e1aco/ELACO_StepMotorTMC5160/README.md

电机型号：[57CME13步进电机*闭环步进电机*雷赛商城](https://www.leisaishop.com/product/productinfo_id=44.html)
驱动器参数：[CL1-507闭环步进驱动器_闭环步进驱动器_雷赛商城](https://www.leisaishop.com/product/productinfo_id=18.html)
# 当前状态：
## 目前存在的一些问题
1. freemodbus没有测试
2. 这版的PCB设计散热没做好
3. 增加NTC，避免mos管和芯片过热
4. 添加电机一直卡死在运行阶段的超时机制（时间可以根据速度计算一下或者怎么样的，这样更好）
5. 电机发热问题，不确定是正常的还是驱动有问题导致的
6. 驱动芯片发烫
7. 相对位置微步运动发现不转动。30微步。
## 已解决的问题
1. 修改BOM，修改采样电阻为0.05R / 1W电阻(✅bom已修改)
2. CE3电容的PCB封装有点问题，正负极反了(✅封装已修改)
3. Q2和Q4在不接芯片和门极电路的情况下自己导通然后烧掉了，大概率是我把mos的栅极悬空的原因。(✅焊接栅极电阻)
## 实时状态
### 2026.07.18
- [ ] 测试电机闭环旋转
- [ ] CAN接收到并且电机旋转，但没有CAN发送
### 2026.07.17
- [x] 尝试调小电机驱动电流测试电机和芯片是否发烫--电机电流已调小，待测试
### 2026.07.16
- [x] 根据协议测试相关内容
### 2026.07.15
- [x] 手写一个CAN协议，确定控制方法
### 2026.07.13
- [x] 测试芯片接收编码器信号是否正常
- [x] 测试电机使用位置模式转动多圈后保持的位置偏差是否在可接受范围内
- [x] 测试驱动器IC在其BM引脚到地没有出现低于-5V的峰值，避免烧芯片。（电机正反转下测试）如果超过了要添加对地的TVS二极管保护 -- 未发现有特别低或高的电压峰值
### 2026.07.10
- [x] 测试编码器数据是否正常
### 2026.07.09
- [x] 修改采样电阻为0.05R / 1W电阻，然后开启速度模式，测试电机转动 -- 上班时间最后一刻上电发现电机转动了。
### 2026.07.08
- [x] 修改CE3电容的PCB封装
- [x] 查看example内的文件内容(关于tmc5160的)
- [x] 对TMC5160的SPI进行配置和通讯 -- 实现SPI的读写
- [x] 测试TMC_CLK脚的PWM输出是否是14Mhz的（芯片手册要求是10-16Mhz的方波）-- 84Mhz,psc=0,arr=5 14Mhz刚好
### 2026.07.07
- [x] 移植freemodbus
  配置一个串口（开启串口中断），配置一个定时器（开启定时器中断）
  移植freemodbus的文件入项目
  分别修改port.c，portserial.c和porttimer.c文件内容
- [x] 增加freemodbus移植内容以及测试函数。（测试函数也可以作为一个example来看）
- [x] 做了移植，但还未测试
- [x] 对CAN进行了测试
### 2026.07.06
- [x] 焊接硬件
## 设置CAN协议

### 1. 接收命令协议 (CAN ID: `0x1AA55F42`)

| 字节索引 | 含义 | 说明 |
|:---|:-----|:-----|
| [0-3] | 值 (int32) | 4字节小端（低字节在前），含义由命令码决定 |
| [4] | 命令码 | 见下方命令码表 |
| [5] | 电机选择 | 0x01=U1, 0x02=U2, 0x06=所有电机 |
| [6] | 参数/分组 | 0x01~0x04=运动参数组（命令0x01~0x05），0x01~0x06=PID参数类型（命令0x06） |
| [7] | 校验和 | 前7字节累加取低8位 |

#### 命令码定义

| 命令码 | 名称 | [0-3] 含义 | [6] 含义 |
|:---:|:-----|:---|:---|
| 0x01 | 绝对位置移动 | 目标位置（微步） | 运动参数组 (0x01~0x04) |
| 0x02 | 相对位置正转 | 移动步数 | 运动参数组 (0x01~0x04) |
| 0x03 | 相对位置反转 | 移动步数 | 运动参数组 (0x01~0x04) |
| 0x04 | 速度模式 | 目标速度（微步/秒） | 运动参数组 (0x01~0x04) |
| 0x05 | 停止/刹车 | 0（忽略） | 运动参数组 (0x01~0x04) |
| 0x06 | PID调参 | 参数值（Q16或整数） | PID参数类型 (0x01~0x06) |

#### 运动参数组定义 (命令 0x01~0x05 使用)

| 参数组 | 说明 | VMAX | AMAX | 典型场景 |
|:---:|:-----|-----:|-----:|:---|
| 0x01 | 低速精准 | 5,000 | 1,000 | 精准定位 |
| 0x02 | 中速普通 | 20,000 | 5,000 | 日常运动 |
| 0x03 | 快速 | 50,000 | 10,000 | 快速移动 |
| 0x04 | 高速 | 100,000 | 20,000 | 长距离搬运 |

#### PID参数类型定义 (命令 0x06 使用)

| 参数类型 | 含义 | 值格式 | 默认值 |
|:---:|:-----|:---|---:|
| 0x01 | Kp（比例系数） | Q16定点数 | 8192 (0.5) |
| 0x02 | Ki（积分系数） | Q16定点数 | 2048 (0.125) |
| 0x03 | Kd（微分系数） | Q16定点数 | 4096 (0.25) |
| 0x04 | out_max（最大输出速度） | 直接整数 | 50000 |
| 0x05 | out_min（最小输出速度） | 直接整数 | -50000 |
| 0x06 | integral_max（积分限幅） | 直接整数 | 32768 |

> **Q16定点数**：实际值 = Q16值 / 65536。例如 Kp=0.5 → Q16值 = 0.5 × 65536 = 8192。

### 2. 反馈响应协议 (CAN ID: `0x1AA55F43`)

| 字节索引 | 含义 | 说明 |
|:---|:-----|:-----|
| [0-3] | 值 (int32) | 4字节小端，含义由 byte[6] 决定 |
| [4] | 标志/参数类型 | 运动反馈=状态标志位，调参反馈=参数类型 |
| [5] | 电机选择 | 0x01=U1, 0x02=U2 |
| [6] | 反馈类型 | 0x01~0x05=运动反馈，0x06=调参反馈 |
| [7] | 校验和 | 前7字节累加取低8位 |

#### 运动反馈 (byte[6] = 0x01~0x05)

| 字节索引 | 含义 | 说明 |
|:---|:-----|:-----|
| [0-3] | 位置值 (int32) | 当前电机 XACTUAL 绝对位置 |
| [4] | 状态标志位 | bit0=到位, bit1=堵转, bit2=过温, bit3=驱动错误, bit4=SPI异常 |
| [5] | 电机选择 | |
| [6] | 运动阶段 | bit0=加速, bit1=匀速, bit2=减速, bit3=归零等待, bit4=静止锁轴 |
| [7] | 校验和 | |

**状态标志位 (byte[4]) 详解：**
```
bit0 → 0=运动中，1=已到位
bit1 → 0=正常，1=堵转/失步
bit2 → 0=正常，1=过温告警
bit3 → 0=正常，1=驱动错误
bit4 → 0=SPI正常，1=SPI通讯异常
bit5-7 → 保留
```

#### 调参反馈 (byte[6] = 0x06)

| 字节索引 | 含义 | 说明 |
|:---|:-----|:-----|
| [0-3] | 参数值 (int32) | 刚设置的参数值 |
| [4] | 参数类型 | 0x01=Kp, 0x02=Ki, 0x03=Kd, 0x04=out_max, 0x05=out_min, 0x06=integral_max |
| [5] | 电机选择 | |
| [6] | 固定 0x06 | 标识为调参反馈 |
| [7] | 校验和 | |

#### 反馈发送规则

| 命令码 | 发送时机 |
|:---:|:---|
| 0x01/0x02/0x03 | 立即发送启动反馈 + 到位后发送到位反馈 |
| 0x04/0x05 | 仅立即发送一次 |
| 0x06 | 立即发送调参确认反馈 |
| 异常 | 堵转/过温/驱动错误/SPI异常状态变化时，5ms定时器触发发送 |
## 软件流程图

# 理论部分
## 1.关于原理图设计
1. **一般我们会设计VSA与VS电源由一路供电,这样是最安全的**，但是如果VS的电源超过了24V就不建议一路供电了，这时VSA应该使用单独的开关电源转换过来的电压进行供电，并且要保证在电机运行期间VSA不会跌落，正常如果要断VSA的电前应该先关断电机驱动(DRV_ENN脚拉高)。
2. 如果电机的输入电压允许12V的话，或者电机运行电压非常大的话，建议**使用DCDC转换为12V给VSA和12VOUT供电**（这时12VOUT内部的LDO可以直接不工作，进而会减少功率的损耗以及发热问题）
3. MOS管的选型上
	1. 将MOSFET调整到所需的电机电压(在峰值电源电压上增加5-10V的余量)和所需的最大电流，使得电阻功耗对于所选MOSFET封装的热容量仍然很低。
	2. 管子Vth选择10V内的（主要因为芯片驱动电压在10V左右）
	3. 对于选型好mos以后栅极电阻的选择，根据米勒电荷对阻值进行选择（同时还要考虑软件上的驱动电流设置DRVSTRENGTH）
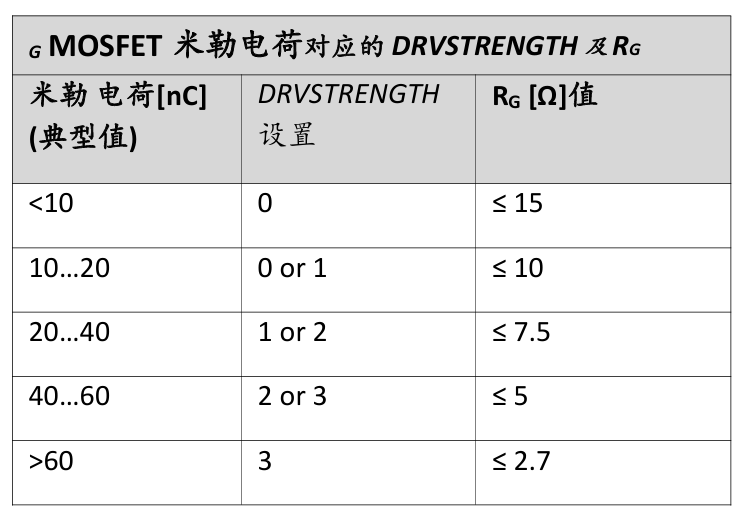
[picture p1: Picture/mos1.png]
MOS管选型参考
	
	
	MOS管驱动电路
	4. 对于驱动电阻，如果驱动电阻的电阻超过表中给出的值时可以增加一个反向二极管（负极对驱动芯片）以增加开关速度。
	那么根据以上条件，我的mos选择AOD4126的米勒电荷是10nC(VGS=10V, VDS=50V, ID=20A),那么我的栅极电阻选择就是10R左右，驱动电流设置就是0/1。（此外我还加入了4148，以求更快的开关速度）
4. 为避免驱动器IC在其BM引脚到地会出现低于-5V的峰值，建议添加一个TVS二极管保护。
## 2.关于PCB布线
1. 将采样电阻和所有滤波电容尽可能靠近功率MOSFET。TMC5160靠近MOSFET放置，短线互连，以最小化寄生电感。
2. 将所有的GND、GNDA、GNDD及采样电阻GND连成一个公共地。
3. 5VOUT滤波电容直接连到5VOUT和GNDA引脚。
4. 需要做好对于芯片TMC5160的散热处理，特别是在MOSFET栅极电荷高、斩波器频率高或系统时钟频率大于12MHz的情况下，内部的LDO功耗较大。
5. 做好芯片的散热，使用内部LDO，损耗功率蛮高的。
6. 调整电桥布局，使环路电感最小。布局最好紧凑。
7. MOSFET 栅极连接短而直，走线较宽。
8. 输出电容采用470PF至几个NF。（103 102）
## 3.软硬件已定配置
- 驱动芯片TMC5160
- 采样电阻使用0.05R
- 驱动芯片CLK脚配置14Mhz的方波
- Mos管使用AOD4126
- 步进电机型号57CME13
## 4.寄存器相关
除了有说明的寄存器外，其他的上电后都会重置为0

### SPI通信协议
- **数据帧**: 40位(5字节)，由CS片选信号定界
- **写命令**: Byte0 bit7=1 + 7位地址 + Byte1-4为32位数据
- **读命令**: Byte0 bit7=0 + 7位地址，需要两报通信
  - 第一报: 发送读命令，接收上一次通信数据(丢弃)
  - 第二报: 再次发送读命令，接收本次请求的寄存器数据
- **SPI模式**: CPOL=1, CPHA=1 (模式3)

### TMC5160芯片模式选择
| 模式  | SD_MODE | SPI_MODE | 运行状态 |
| :-- | :--- | :--- | :--- |
| 1 | 0 | 1 | 位置式步进(SPI完全控制) |
| 2 | 1 | 1 | S斜坡运动步进+方向控制 |
| 3 | 1 | 0 | 简单步进+方向控制 |

### 通用配置寄存器 (0x00-0x0C)

#### GCONF (0x00) - 全局配置寄存器
| 位 | 名称 | 说明 |
| :-- | :--- | :--- |
| 0 | recalibrate | 非需要(SPI模式不用,禁用驱动器时过零重新校准) |
| 1 | faststandstill | 非需要(SPI模式不用,静止检测超时设置) |
| 2 | en_pwm_mode | 0= StealthChop禁用, 1= StealthChop自动模式(需满足TPWMTHRS条件) **在静音，静步应用场景下使用** |
| 3 | multistep_filt | 非需要(SPI模式不用,STEP输入滤波器) |
| 4 | shaft | 0= 正向, 1= 反向(影响位置/速度方向) **电机运行方向（包括位置模式和速度模式）** |
| 5 | diag0_error | 0= DIAG0无动作, 1= DIAG0输出驱动错误信号(SD_MODE=1) |
| 6 | diag0_otpw | 非需要 0= DIAG0无动作, 1= DIAG0输出过温预警信号(SD_MODE=1) |
| 7 | diag0_stall/diag0_step | 0= DIAG0无动作, 1= DIAG0输出堵转信号(SD_MODE=1) |
| 8 | diag1_stall/diag1_dir  | 0= DIAG1无动作, 1= DIAG1输出堵转信号(SD_MODE=1) |
| 9 | diag1_index | 非需要(SPI模式不用,SD_MODE=1时索引位置输出) |
| 10  | diag1_onstate | 非需要(SPI模式不用,SD_MODE=1时斩波器导通指示) |
| 11  | diag1_steps_skipped | 非需要(SPI模式不用,SD_MODE=1时DcStep失步指示) |
| 12  | diag0_int_pushpull | 0= SWN_DIAG0集电极开路输出(低电平有效), 1= 推挽输出(高电平有效) |
| 13  | diag1_poscomp_pushpull | 0= SWP_DIAG1集电极开路输出(低电平有效), 1= 推挽输出(高电平有效) |
| 14  | small_hysteresis | 0= 步进频率比较磁滞是1/16, 1= 步进频率比较磁滞是1/32 |
| 15  | stop_enable | 非需要(SPI模式不用,紧急停止功能) |
| 16  | direct_mode | 0= 常规模式, 1= 直接模式(MOSFET可独立控制) |
| 17  | test_mode | 非需要(测试模式,正常操作设为0) |

#### GSTAT (0x01) - 全局状态寄存器
| 位 | 名称 | 说明 |
| :-- | :--- | :--- |
| 0 | reset | 0= 无复位, 1= 复位发生(写1清除) |
| 1 | drv_err | 0= 无驱动错误, 1= 驱动错误(写1清除)  |
| 2 | uv_cp | 0= 电荷泵正常, 1= 电荷泵欠压(写1清除) |

#### IFCNT (0x02) - SPI接口计数器
| 位 | 名称 | 说明 |
|:---|:-----|:-----|
| 7:0 | ifcnt | SPI通信次数计数器(8位), 每次成功SPI传输后递增 |

#### SLAVECONF (0x03) - 从机配置寄存器
| 位 | 名称 | 说明 |
|:---|:-----|:-----|
| 0 | slaveaddr | 从机地址位0(非需要,单机SPI不用) |
| 1 | slaveaddr | 从机地址位1(非需要,单机SPI不用) |
| 4:2 | reserved | 保留 |
| 7:5 | reserved | 保留 |

#### IOIN (0x04) - IO输入寄存器 (只读)
| 位 | 名称 | 说明 |
|:---|:-----|:-----|
| 0 | REFL_STEP | 读取REFL/STEP引脚输入状态 |
| 1 | REFR_DIR | 读取REFR/DIR引脚输入状态 |
| 2 | ENCB_DCEN_CFG4 | 读取ENCB_DCEN_CFG4引脚输入状态 |
| 3 | ENCA_DCIN_CFG5 | 读取ENCA_DCIN_CFG5引脚输入状态 |
| 4 | DRV_ENN | 读取DRV_ENN引脚输入状态 |
| 5 | ENC_N_DCO_CFG6 | 读取ENC_N_DCO_CFG6引脚输入状态 |
| 6 | SD_MODE | 读取SD_MODE引脚状态(1=外部STEP/DIR输入源) |
| 7 | SWCOMP_IN | 读取SWN和SWP的电压差(用于测试比较器) |
| 31:24 | VERSION | 芯片版本号(0x30=第一版IC,相同数字表示全数字兼容) |

#### X_COMPARE (0x05) - 位置比较寄存器
| 位 | 名称 | 说明 |
|:---|:-----|:-----|
| 31:0 | x_compare | 位置比较值(32位有符号), 当XACTUAL=X_COMPARE时触发脉冲 |

#### OTP_PROG (0x06) - OTP编程寄存器
| 位 | 名称 | 说明 |
| :-- | :--- | :--- |
| 1:0 | otpbit | 非需要(OTP编程专用,慎用) |
| 5:2 | otpbyte | 非需要(OTP编程专用,慎用) |
| 7:6 | optpgmcmd | 非需要(OTP编程专用,慎用) |

#### OTP_READ (0x07) - OTP读取寄存器 (只读)
| 位 | 名称 | 说明 |
|:---|:-----|:-----|
| 0 | otp_config_bit0 | 非需要(OTP配置位) |
| 1 | otp_config_bit1 | 非需要(OTP配置位) |
| 2 | otp_config_bit2 | 非需要(OTP配置位) |
| 3 | otp_config_bit3 | 非需要(OTP配置位) |
| 4 | otp_config_bit4 | 非需要(OTP配置位) |
| 5 | otp_config_bit5 | 非需要(OTP配置位) |
| 6 | otp_config_bit6 | 非需要(OTP配置位) |
| 7 | otp_config_bit7 | 非需要(OTP配置位) |

#### FACTORY_CONF (0x08) - 工厂配置寄存器
| 位 | 名称 | 说明 |
|:---|:-----|:-----|
| 2:0 | offset_rcomp | 非需要(工厂校准用) |
| 7:3 | reserved | 保留 |

#### SHORT_CONF (0x09) - 短路保护配置寄存器
| 位 | 名称 | 说明 |
| :---- | :--- | :--- |
| 3:0 | S2VS_LEVEL  | 低端MOSFET对VS的短路电平(4=最高灵敏度, 15=最低灵敏度, 复位缺省值=OTP 6或12)  |
| 7:4 | S2G_LEVEL | 高端MOSFET对GND的短路电平(2=最高灵敏度, 15=最低灵敏度, 复位缺省值=OTP 6或12) |
| 9:8 | SHORTFILTER | 短路检测尖峰滤波带宽(0=100ns, 1=1µs, 2=2µs, 3=3µs, 复位缺省值=%01)  |
| 10 | reserved | 保留 |
| 11 | shortdelay  | 短路检测延迟(0=750ns正常, 1=1500ns高, 复位缺省值=0) |
| 17:12 | reserved | 保留 |
| 23 | s2vs | 0= 短路到VS检测使能, 1= 短路到VS检测禁用 |
| 24 | s2gw | 非需要(硬件保护使能,一般不用修改) |
| 25 | s2vsw | 非需要(硬件保护使能,一般不用修改) |

#### DRV_CONF (0x0A) - 驱动配置寄存器
| 位 | 名称 | 说明 |
| :---- | :--- | :--- |
| 4:0 | BBMTIME | 导通前的关断延时(0=最短100ns, 16=200ns, 24=最长375ns, 复位缺省值=0) |
| 7:5 | reserved | 保留 |
| 11:8  | BBMCLKS | 数字BBM时间(以时钟周期为单位, 典型值83ns), 设定更长时间(BBMTIME vs BBMCLKS, 复位缺省值=OTP 4或2) |
| 13:12 | reserved | 保留 |
| 15:14 | OTSELECT | 过温级别选择(00=150°C, 01=143°C, 10=136°C, 11=120°C, 复位缺省值=%00) |
| 17:16 | reserved | 保留 |
| 19:18 | DRVSTRENGTH | 栅极驱动器电流选择(00=弱, 01=弱+TC, 10=中等, 11=强, 复位缺省值=%10) |
| 21:20 | FILT_ISENSE | 采样运放滤波时间常数(00=100ns, 01=200ns, 10=300ns, 11=400ns, 复位缺省值=%00) |

#### GLOBAL_SCALER (0x0B) - 全局缩放器寄存器
| 位 | 名称 | 说明 |
| :--- | :--- | :--- |
| 7:0  | global_scaler | 非需要(用于高级电流调节,一般不用) |
| 31:8 | reserved | 保留 |

#### OFFSET_READ (0x0C) - 偏移读取寄存器 (只读)
| 位 | 名称 | 说明 |
|:---|:-----|:-----|
| 31:0 | offset_read | 非需要(工厂校准用) |

### 速度控制寄存器 (0x10-0x15)

#### IHOLD_IRUN (0x10) - 保持电流/运行电流寄存器
| 位 | 名称 | 说明 |
| :---- | :--- | :--- |
| 4:0 | ihold | 保持电流(0-31), ihold/irun为保持电流比例 |
| 7:5 | reserved | 保留 |
| 12:8  | irun | 运行电流(0-31), 决定电机满载电流 |
| 15:13 | reserved | 保留 |
| 19:16 | iholddelay | 保持电流延迟(0-15), 停止后降为保持电流的延迟时间  |
| 31:20 | reserved | 保留 |

**说明**: 保持电流 = ihold × 电流比例, 运行电流 = irun × 电流比例
-  I_full = 0.325V / (32 × 0.05Ω) ≈ 203mA （本次项目反馈电阻值是0.05R）
- 保持电流 = 6/31 × 203mA ≈ 35mA
- 运行电流 = 16/31 × 203mA ≈ 104.7mA
#### TPOWERDOWN (0x11) - 功率下降时间寄存器
| 位 | 名称 | 说明 |
| :--- | :--- | :--- |
| 7:0  | tpowerdown | 功率下降延迟时间(0-255), 单位: 256个tclk周期 |
| 31:8 | reserved | 保留 |

**说明**: 电机停止后，经过tpowerdown时间后自动降低电流到保持电流

#### TSTEP (0x12) - 步进时间寄存器 (只读)
| 位 | 名称 | 说明 |
|:---|:-----|:-----|
| 19:0 | tstep | 当前步进时间(20位), 单位: tclk周期 |
| 31:20 | reserved | 保留 |

**说明**: 反映当前实际步进间隔时间，可用于速度计算

#### TPWMTHRS (0x13) - PWM阈值寄存器
| 位 | 名称 | 说明 |
|:---|:-----|:-----|
| 19:0 | tpwmthrs | 非需要(SPI模式下StealthChop自动切换不用此值) |
| 31:20 | reserved | 保留 |

#### TCOOLTHRS (0x14) - 散热阈值寄存器
| 位 | 名称 | 说明 |
| :---- | :--- | :--- |
| 19:0  | tcoolthrs | 非需要(StallGuard2专用,回零时需设置) |
| 31:20 | reserved  | 保留 |

#### THIGH (0x15) - 高速阈值寄存器
| 位 | 名称 | 说明 |
|:---|:-----|:-----|
| 19:0 | thigh | 非需要(SPI模式下不使用高速模式切换) |
| 31:20 | reserved | 保留 |

### 运动控制核心寄存器 (0x20-0x2D)

#### RAMPMODE (0x20) - 斜坡模式寄存器
| 位 | 名称 | 说明 |
| :--- | :--- | :--- |
| 1:0  | rampmode | 斜坡模式选择 |
| | | 0= 定位模式(使用XTARGET作为目标位置) |
| | | 1= 速度正转模式(VMAX为目标速度, 正向旋转) |
| | | 2= 速度反转模式(VMAX为目标速度, 反向旋转) |
| 31:2 | reserved | 保留 |

#### XACTUAL (0x21) - 实际位置寄存器
| 位 | 名称 | 说明 |
|:---|:-----|:-----|
| 31:0 | xactual | 当前实际位置(32位有符号), 单位: 微步 |

#### VACTUAL (0x22) - 实际速度寄存器 (只读)
| 位 | 名称 | 说明 |
|:---|:-----|:-----|
| 22:0 | vactual | 当前实际速度(23位), 单位: 微步/秒 |
| 31:23 | reserved | 保留 |

#### VSTART (0x23) - 启动速度寄存器
| 位 | 名称 | 说明 |
|:---|:-----|:-----|
| 17:0 | vstart | 启动速度(18位), 单位: 微步/秒, 建议设置为0或较小值 |
| 31:18 | reserved | 保留 |

#### A1 (0x24) - 第一段加速度寄存器
| 位 | 名称 | 说明 |
|:---|:-----|:-----|
| 15:0 | a1 | 第一段加速度(16位), 单位: 微步/秒², 用于VSTART→V1阶段 |
| 31:16 | reserved | 保留 |

#### V1 (0x25) - 第一段速度寄存器
| 位 | 名称 | 说明 |
|:---|:-----|:-----|
| 19:0 | v1 | 第一段目标速度(20位), 单位: 微步/秒, 设为0则跳过A1/D1段 |
| 31:20 | reserved | 保留 |

#### AMAX (0x26) - 第二段加速度寄存器
| 位 | 名称 | 说明 |
|:---|:-----|:-----|
| 15:0 | amax | 第二段加速度(16位), 单位: 微步/秒², 用于V1→VMAX阶段 |
| 31:16 | reserved | 保留 |

#### VMAX (0x27) - 最大速度寄存器
| 位 | 名称 | 说明 |
|:---|:-----|:-----|
| 22:0 | vmax | 最大速度(23位), 单位: 微步/秒 |
| 31:23 | reserved | 保留 |

**说明**: 
- 定位模式: VMAX是速度上限, 实际速度不超过此值
- 速度模式: VMAX就是目标速度, 电机持续以该速度旋转

#### DMAX (0x28) - 第二段减速度寄存器
| 位 | 名称 | 说明 |
|:---|:-----|:-----|
| 15:0 | dmax | 第二段减速度(16位), 单位: 微步/秒², 用于VMAX→V1阶段 |
| 31:16 | reserved | 保留 |

#### D1 (0x2A) - 第一段减速度寄存器
| 位 | 名称 | 说明 |
|:---|:-----|:-----|
| 15:0 | d1 | 第一段减速度(16位), 单位: 微步/秒², 用于V1→VSTOP阶段 |
| 31:16 | reserved | 保留 |

#### VSTOP (0x2B) - 停止速度寄存器
| 位 | 名称 | 说明 |
|:---|:-----|:-----|
| 17:0 | vstop | 停止速度(18位), 单位: 微步/秒, 建议≤VSTART |
| 31:18 | reserved | 保留 |

#### TZEROWAIT (0x2C) - 零位等待时间寄存器
| 位 | 名称 | 说明 |
|:---|:-----|:-----|
| 15:0 | tzerowait | 零位等待时间(16位), 单位: 256个tclk周期 |
| 31:16 | reserved | 保留 |

**说明**: 电机到达目标位置后，等待tzerowait时间再执行下一步动作

#### XTARGET (0x2D) - 目标位置寄存器
| 位 | 名称 | 说明 |
| :--- | :--- | :--- |
| 31:0 | xtarget | 目标位置(32位有符号), 单位: 微步 |

### 斜坡/参考开关/DcStep配置 (0x33-0x36)

#### VDCMIN (0x33) - 最小速度寄存器
| 位 | 名称 | 说明 |
| :---- | :--- | :--- |
| 22:0  | vdcmin | 非需要(DcStep模式专用) |
| 31:23 | reserved | 保留 |

#### SW_MODE (0x34) - 开关模式寄存器
| 位 | 名称 | 说明 |
| :-- | :--- | :--- |
| 0 | en_swcomp | 非需要(软件比较器,限位开关用) |
| 1 | swcomp_polarity | 非需要(软件比较器极性,限位开关用) |
| 3:2 | reserved | 保留 |
| 4 | stop_r_en | 非需要(SPI模式不用右限位停止) |
| 5 | stop_l_en | 非需要(SPI模式不用左限位停止) |
| 6 | softstop_en | 非需要(SPI模式不用软停止) |
| 7 | status_stop_r | 0= 无右限位, 1= 右限位触发(只读) |
| 8 | status_stop_l | 0= 无左限位, 1= 左限位触发(只读) |
| 9 | status_stop | 0= 无停止, 1= 停止触发(只读) |
| 10  | status_latch | 0= 无锁存, 1= 位置锁存触发(只读) |

#### RAMP_STAT (0x35) - 斜坡状态寄存器
| 位 | 名称 | 说明 |
| :-- | :--- | :--- |
| 0 | status_stop | 0= 无停止, 1= 停止状态 |
| 1 | status_stop_r | 非需要(右限位状态,限位开关用) |
| 2 | status_stop_l | 非需要(左限位状态,限位开关用) |
| 3 | status_latch | 非需要(锁存状态,限位开关用) |
| 4 | status_latch_r | 非需要(右锁存,限位开关用) |
| 5 | status_latch_l | 非需要(左锁存,限位开关用) |
| 6 | event_stop_r | 非需要(右限位事件,限位开关用) |
| 7 | event_stop_l | 非需要(左限位事件,限位开关用) |
| 8 | event_stop_sg | 0= 无事件, 1= 堵转停止事件  |
| 9 | position_reached  | 0= 运动中, 1= 已到达目标位置 |
| 10  | velocity_reached  | 0= 未达到, 1= 已达到目标速度 |
| 11  | t_zerowait_active | 0= 非活动, 1= 零位等待中 |
| 12  | second_move | 0= 无动作, 1= 第二次移动 |
| 13  | status_sg | 0= 无堵转, 1= 堵转检测触发  |

#### XLATCH (0x36) - 位置锁存寄存器
| 位 | 名称 | 说明 |
| :--- | :----- | :--- |
| 31:0 | xlatch | 非需要(限位开关触发时锁存XACTUAL) |

### 编码器接口寄存器 (0x38-0x3D)

#### ENCMODE (0x38) - 编码器模式寄存器
| 位 | 名称 | 说明 |
| :-- | :--- | :--- |
| 0 | pol_A | N通道事件所需的A极性(0=负, 1=正) |
| 1 | pol_B | N通道事件所需的B极性(0=负, 1=正) |
| 2 | pol_N | N通道的有效极性(0=低有效, 1=高有效) |
| 3 | ignore_AB | 0=仅当极性匹配时N事件发生, 1=忽略N通道的A和B极性 |
| 4 | clr_cont | 1=N事件时始终锁存或锁存并清除X_ENC(每转一圈一次) |
| 5 | clr_once | 1=写访问后的下一个N事件中锁存或锁存并清除X_ENC |
| 6 | pos_edge | N通道事件触发边沿选择位0 |
| 7 | neg_edge | N通道事件触发边沿选择位1 |
| 8 | clr_enc_x | 0=N事件时仅锁存X_ENC到ENC_LATCH, 1=N事件时锁存并清除X_ENC |
| 9 | latch_x_act | 1=与X_ENC一起锁定XACTUAL |
| 10  | enc_sel_decimal | 0=编码器预分频器二进制模式, 1=十进制模式 |

**N通道事件触发边沿选择:**
| pos_edge | neg_edge | 说明 |
|:---:|:---:|:-----|
| 0 | 0 | 向有效电平的跳变触发N事件 |
| 0 | 1 | 向非有效电平的跳变触发N事件 |
| 1 | 0 | 有效电平触发N事件 |
| 1 | 1 | 向有效电平及非有效电平的跳变触发N事件 |

#### X_ENC (0x39) - 编码器位置寄存器
| 位 | 名称 | 说明 |
| :--- | :---- | :--- |
| 31:0 | x_enc | 编码器当前位置(32位有符号) |

#### ENC_CONST (0x3A) - 编码器常数寄存器
| 位 | 名称 | 说明 |
|:---|:-----|:-----|
| 31:0 | enc_const | 编码器转换常数(32位有符号), 定义编码器脉冲与微步的转换关系 |

#### ENC_STATUS (0x3B) - 编码器状态寄存器
| 位 | 名称 | 说明 |
|:---|:-----|:-----|
| 0 | n_alarm | 0= 编码器报警, 1= 编码器正常 |
| 31:1 | reserved | 保留 |

#### ENC_LATCH (0x3C) - 编码器锁存寄存器
| 位 | 名称 | 说明 |
| :--- | :--- | :--- |
| 31:0 | enc_latch | 编码器锁存位置(32位有符号) |

#### ENC_DEVIATION (0x3D) - 编码器偏差寄存器
| 位 | 名称 | 说明 |
| :--- | :--- | :--- |
| 31:0 | enc_deviation | 编码器偏差值(32位有符号), 实际位置与编码器位置的差值 |

### 微步表寄存器 (0x60-0x6B)

#### MSLUT0-7 (0x60-0x67) - 微步查找表
| 位 | 名称 | 说明 |
| :--- | :--- | :--- |
| 31:0 | mslut0-7 | 非需要(微步查找表,自定义波形用) |

#### MSLUTSEL (0x68) - 微步表选择寄存器
| 位 | 名称 | 说明 |
| :--- | :--- | :--- |
| 1:0  | mslutsel | 非需要(微步表选择,自定义波形用) |
| 31:2 | reserved | 保留 |

#### MSLUTSTART (0x69) - 微步表起始寄存器
| 位 | 名称 | 说明 |
| :--- | :--- | :--- |
| 8:0  | mslutstart | 非需要(微步表起始值,自定义波形用) |
| 31:9 | reserved | 保留 |

#### MSCNT (0x6A) - 微步计数器寄存器 (只读)
| 位 | 名称 | 说明 |
| :---- | :--- | :--- |
| 9:0 | mscnt | 非需要(微步计数器,调试用) |
| 31:10 | reserved | 保留 |

#### MSCURACT (0x6B) - 微步电流寄存器 (只读)
| 位 | 名称 | 说明 |
| :---- | :--- | :--- |
| 8:0 | cur_a | 非需要(微步电流,调试用) |
| 15:9  | reserved | 保留 |
| 24:16 | cur_b | 非需要(微步电流,调试用) |
| 31:25 | reserved | 保留 |

### 驱动配置寄存器 (0x6C-0x73)

#### CHOPCONF (0x6C) - 斩波器配置寄存器
| 位 | 名称 | 说明 |
| :---- | :--- | :--- |
| 3:0 | toff | 关断时间和驱动器使能, NCLK=24+32 x TOFF, %0000=驱动输出关闭, %0001=1(仅TBL≥2时用), %0010…%1111=2…15 |
| 6:4 | hstrt | 磁滞起始值累加到HEND, %000…%111=增加1,2,…,8到HEND, 有效HEND+HSTRT≤16 |
| 10:7  | hend | 磁滞低值/正弦波偏移量, chm=0时%0000…%1111=磁滞-3,-2,-1,0,1,…,12; chm=1时%0000…%1111=偏移量-3,-2,-1,0,1,…,12 |
| 11 | disfdcc  | 快速衰减模式(chm=1时): 0=使用电流比较器终止快衰减, 1=不使用电流比较器终止快衰减 |
| 12 | reserved | 保留 |
| 13 | reserved | 保留 |
| 14 | chm | 0= 标准模式(spreadCycle), 1= 具有快衰减时间的恒定关闭时间 |
| 16:15 | tbl | 消影时间选择, %00…%11=16,24,36,54个时钟(推荐%01或%10) |
| 17 | reserved | 保留 |
| 18 | vhighfs  | 高速全步选择: 0=正常, 1=超过VHIGH时切换到全步模式 |
| 19 | vhighchm | 高速斩波模式: 0=正常, 1=超过VHIGH时切换到chm=1和fd=0工作模式 |
| 23:20 | tpfd | 被动快速衰减时间, NCLK=128*TPFD, %0000=禁用, %0001…%1111=1…15, 降低电机中程共振 |
| 27:24 | mres | 微步分辨率, %0000=256微步, %0001…%1000=128,64,32,16,8,4,2,全步 |
| 28 | intpol | 0= 无插值, 1= 256微步插值(仅适用于STEP/DIR操作) |
| 29 | dedge | 0= 单边沿STEP脉冲, 1= 双边沿STEP脉冲(降低STEP信号频率要求) |
| 30 | diss2g | 0= 对GND短路保护使能, 1= 禁用对GND短路保护 |
| 31 | diss2vs  | 0= 对VS短路保护使能, 1= 禁用对VS短路保护 |
| 22 | dedge | 非需要(SPI模式不用外部脉冲) |
| 23 | diss2g | 0= 短路到GND检测使能, 1= 短路到GND检测禁用 |
| 24 | diss2vs  | 0= 短路到VS检测使能, 1= 短路到VS检测禁用 |
| 27:25 | reserved | 保留 |
| 31:28 | tpfd | 有源快速衰减(0-15), 控制快速衰减强度 |

#### COOLCONF (0x6D) - 散热配置寄存器
| 位 | 名称 | 说明 |
| :---- | :--- | :--- |
| 22:16 | sgt | StallGuard2阈值(-64~+63), 值越低灵敏度越高,0是大多数电机的起始值 |
| 23 | reserved | 保留 |
| 24 | sfilt | 0= 标准模式(高时间分辨率), 1= 滤波模式(StallGuard2信号每四个全步更新) |

#### DCCTRL (0x6E) - DC控制寄存器
| 位 | 名称 | 说明 |
| :---- | :--- | :--- |
| 8:0 | dc_time  | 非需要(DcStep模式专用) |
| 9 | reserved | 保留 |
| 14:10 | dc_sg2 | 非需要(DcStep模式专用) |
| 15 | reserved | 保留 |
| 24:16 | dc_sg1 | 非需要(DcStep模式专用) |

#### DRV_STATUS (0x6F) - 驱动状态寄存器 (只读)
| 位 | 名称 | 说明 |
| :---- | :--- | :--- |
| 0 | stst | 停止指示: 0=运动中, 1=电机静止(最后一个步进脉冲后2^20时钟) |
| 1 | ola | A相开路指示: 0=正常, 1=A相检测到开路(仅信息,驱动器不动作) |
| 2 | olb | B相开路指示: 0=正常, 1=B相检测到开路(仅信息,驱动器不动作) |
| 3 | s2ga | A相短路到GND指示: 0=正常, 1=A相检测到对地短路,驱动器被禁用 |
| 4 | s2gb | B相短路到GND指示: 0=正常, 1=B相检测到对地短路,驱动器被禁用 |
| 5 | otpw | 过温预警标志: 0=正常, 1=过温预警阈值,两桥臂共用 |
| 6 | ot | 过温标志: 0=正常, 1=过温,驱动器被禁用直到IC冷却 |
| 7 | s2vsa | A相短路到VS指示: 0=正常, 1=A相检测对电源短路,驱动器被禁用 |
| 8 | s2vsb | B相短路到VS指示: 0=正常, 1=B相检测对电源短路,驱动器被禁用 |
| 9 | stealth | StealthChop指示: 0=非StealthChop模式, 1=驱动器工作在StealthChop模式 |
| 10 | fsactive | 全步有效指示: 0=非全步, 1=驱动器按斩波模式和速度阈值切换到全步模式 |
| 22:16 | cs_actual | 实际电机电流/智能电流(7位), 实际缩放的电流值 |
| 25:16 | SG_RESULT | StallGuard2结果(10位, 0-1023), 0=负载最大(堵转), 1023=负载最小(空转) |

### PWM/StealthChop静音模式配置 (0x70-0x73)

#### PWMCONF (0x70) - PWM配置寄存器
| 位 | 名称 | 说明 |
| :---- | :--- | :--- |
| 7:0 | PWM_OFS | 用户定义的幅值(偏移量)(0-255), 与静止状态下的全电机电流相关(复位缺省值=30) |
| 15:8  | PWM_GRAD | 用户定义的梯度值, 用于调节PWM幅值的速度相关梯度 |
| 17:16 | pwm_freq | PWM频率, %00=2/1024*fCLK(复位缺省值), %01=2/683*fCLK, %10=2/512*fCLK, %11=2/410*fCLK |
| 18 | pwm_autoscale | 0=用户定义的前馈PWM幅度, 1=使能自动电流控制(复位缺省值) |
| 19 | pwm_autograd  | 0=PWM_GRAD固定值, 1=自调节(仅pwm_autoscale=1时, 复位缺省值) |
| 21:20 | freewheel | 允许不同的静止模式(IHOLD=0时): %00=正常操作, %01=空转, %10=LS驱动器线圈短路, %11=HS驱动器线圈短路 |
| 27:24 | PWM_REG | 调节回路梯度值(当pwm_autoscale=1时): 1=0.5增量(最慢), 2=1增量, 3=1.5增量, 4=2增量(复位缺省值)…15=7.5增量(最快) |
| 31:28 | PWM_LIM | 使能后PWM自动缩放的最大幅度, 限制PWM_SCALE_AUTO的上限(复位缺省值=12) |

#### PWMSCALE (0x71) - PWM缩放寄存器 (只读)
| 位 | 名称 | 说明 |
| :---- | :--- | :--- |
| 7:0 | PWM_SCALE_SUM  | 实际脉宽调制占空比(8位), 该值用于缩放从正弦波表中读取的值CUR_A和CUR_B |
| 15:8  | reserved | 保留 |
| 24:16 | PWM_SCALE_AUTO | 9位有符号偏移加到计算的PWM占空比上, 由内部自动幅值调节后的结果 |

#### PWM_AUTO (0x72) - PWM自动调节寄存器
| 位 | 名称 | 说明 |
|:---|:-----|:-----|
| 7:0 | pwm_ofs_auto | 非需要(StealthChop模式专用) |
| 15:8 | pwm_grad_auto | 非需要(StealthChop模式专用) |
| 31:16 | reserved | 保留 |

#### LOST_STEPS (0x73) - 丢步数寄存器 (只读)
| 位 | 名称 | 说明 |
|:---|:-----|:-----|
| 19:0 | lost_steps | 非需要(DcStep模式专用) |
| 31:20 | reserved | 保留 |
