e1aco/ELACO_StepMotorTMC5160/.ela/discussion/overheat-optimization/hardware.md

# 过温优化 — 阶段 3：硬件对齐

## 供电与电流路径

| 项目 | 值 | 来源 |
|---|-----|---|
| 电机电源 VS | 24V（TVS SMAJ28CA，28V 钳位） | 原理图 D3/D14 |
| 采样电阻 R_SENSE | **0.05Ω / 3W (R10/R22/R51/R64)** | BOM 50mR/3W，4 颗 = 2 轴各 2（A/B 相） |
| 输出 MOSFET | AOD4126 ×16（N-MOS，TO252） | BOM，每轴 8 颗全桥 |
| 线圈储能电感 | 68uH ×1 | BOM L1 |
| TMC5160 封装 | TQFP-48，暴露焊盘 | BOM U1/U2 |
| 电机 | 两轴步进，额定电流 ≥1.5A/相 | 用户确认 |

## 发热功率估算（双轴满载）

```
单相 I_RMS=1.56A（IRUN=10）→ 两相线圈热 ≈ 电机本身发热（铜损），
芯片热主要来自：MOSFET 栅驱动 + 高侧/低侧导通 + 斩波开关损耗 + 采样电阻 3W×4 上的
I²R = 1.56² × 0.05 ≈ 0.12W/颗（持续），单轴 0.25W 可接受。
```

## 引脚与外设（无新增占用）

本任务只改 **SPI 寄存器写入**，不新增任何引脚/外设：

- SPI：沿用现有驱动（SD_MODE=0, SPI 模式1），频率不变
- 定时器：不新增（TIM7 闭环周期不动）
- DMA/中断：不动
- CAN：仅读取 bit2 验证，不改协议

## 资源预算

| 资源 | 变化 |
|---|---|
| RAM | 0（无新全局变量，寄存器常量用 #define） |
| Flash | ~0（新增 ≤4 行 `write_reg` 调用） |
| 堆栈 | 0 |
| 运行时开销 | 0（初始化一次性写入；CoolStep 是芯片内部硬件自动机制） |

## 硬件风险确认

1. **散热路径**：TQFP-48 暴露焊盘若未接大面积铜皮/散热孔，热阻高 → 软件降流是主手段；建议验证时用红外测温对照
2. **采样电阻 3W**：IRUN=10 峰值 2.2A 瞬时流过，3W 余量充足
3. **过温来源**：143°C 报警来自芯片结温（TQFP 内部温度二极管），非 MOSFET——先软件降流，若仍 >120°C 再评估 PCB 散热（加散热片/加大铜皮/风扇）

## 结论

硬件无需改动，无资源冲突，纯软件配置即可进入头脑风暴。
