e1aco/ELACO_StepMotorTMC5160/AIFirmware/StepMotorDriver_Keil/.ela/project-spec.md

# Project Spec: StepMotorDriver_Keil

## Meta
- 项目名称: StepMotorDriver_Keil
- 类型: embedded
- 芯片: STM32F407ZET6
- 驱动IC: TMC5160A
- 电机: 57CME13 闭环步进电机

## 步骤表
| 步骤 | 描述 | 状态 |
|---|---|---|
| S1 | CAN驱动 + 主循环集成 + 电机测试 | ✅ 完成 |
| S2 | CAN协议命令码响应 | ✅ 完成 |
| S3 | TMC5160软件闭环 (PID+闭环控制) | ✅ 完成 |
| — | 闭环控制集成 | ✅ 完成 |
