e1aco/ELACO_StepMotorTMC5160/Firmware/TMC5160H7Cmake_StepMotor/.cl/datasheet/TMC5160A_Datasheet_Rev1.14_ch30_30_package_mechanical_data.md

# TMC5160A_Datasheet_Rev1.14 — 第30章 30 Package Mechanical Data

--- [PAGE 128] ---
TMC5160/TMC5160A DATASHEET (Rev. 1.14 / 2020-MAY-19)  128 

www.trinamic.com 
30 Package Mechanical Data 
30.1 Dimensional Drawings TQFP48-EP 
Drawings not to scale. 
 
Figure 30.1 Dimensional drawings TQFP48-EP 

--- [PAGE 129] ---
TMC5160/TMC5160A DATASHEET (Rev. 1.14 / 2020-MAY-19)  129 

www.trinamic.com 
Parameter Ref Min Nom Max 
total thickness A - - 1.2 
stand off A1 0.05 - 0.15 
mold thickness A2 0.95 1 1.05 
lead width (plating) b 0.17 0.22 0.27 
lead width b1 0.17 0.2 0.23 
lead frame thickness 
(plating) 
c 0.09 - 0.2 
lead frame thickness c1 0.09 - 0.16 
body size X (over pins) D  9.0  
body size Y (over pins) E  9.0  
body size X D1  7.0  
body size Y E1  7.0  
lead pitch e  0.5  
lead L 0.45 0.6 0.75 
footprint L1  1 REF  
  0° 3.5° 7° 
 1 0° - - 
 2 11° 12° 13° 
 3 11° 12° 13° 
 R1 0.08 - - 
 R2 0.08 - 0.2 
 S 0.2 - - 
exposed die pad size X M 4.9 5 5.1 
exposed die pad size Y N 4.9 5 5.1 
package edge tolerance aaa   0.2 
lead edge tolerance bbb   0.2 
coplanarity ccc   0.08 
lead offset ddd   0.08 
mold flatness eee   0.05 

--- [PAGE 130] ---
TMC5160/TMC5160A DATASHEET (Rev. 1.14 / 2020-MAY-19)  130 

www.trinamic.com 
30.2 Dimensional Drawings QFN-WA 

Figure 30.2 Dimensional drawings wettable QFN 

--- [PAGE 131] ---
TMC5160/TMC5160A DATASHEET (Rev. 1.14 / 2020-MAY-19)  131 

www.trinamic.com 
Parameter Ref Min Nom Max 
total thickness A 0.8 0.85 0.9 
stand off A1 0 0.035 0.05 
mold thickness A2  0.65  
lead frame thickness A3  0.203  
lead width b 0.2 0.25 0.3 
body size X  D  8.0  
body size Y E  8.0  
lead pitch e  0.5  
exposed die pad size X J 6.15 6.25 6.35 
exposed die pad size Y K 6.15 6.25 6.35 
lead length L 0.35 0.4 0.45 
lead length L1 0.3 0.4 0.45 
package edge tolerance aaa 0.1 
mold flatness bbb 0.1 
coplanarity ccc 0.08 
lead offset ddd 0.1 
exposed pad offset eee 0.1 
half-cut depth R 0.075   
half-cut depth S   0.075 
 
30.3 Package Codes 
Type Package Temperature range Code & marking 
TMC5160A-TA TQFP-EP48 (RoHS) -40°C ... +125°C TMC5160A-TA 
TMC5160A-WA QFN8x8 wettable -40°C ... +125°C TMC5160A-WA 
…-T -T denotes tape on reel packing (order option)
