e1aco/ELACO_StepMotorTMC5160/AIFirmware/StepMotorDriver_Keil/KNOWLEDGE/TMC5160A/hw-design.md

# 硬件设计

## 目录概览

本章节整理自 TMC5160A 中文数据手册的硬件设计相关章节，含操作原则（三种操作模式）、引脚分配与信号描述、示例电路、MOSFET 选型与 DRV_CONF 斜率参数、桥臂调整、高压应用、SPI 接口与时序、独立操作模式、外部复位、时钟、最大电气参数、电气特性、布线考虑、封装机械数据。

## 1. 操作原则

TMC5160 运动控制和驱动芯片是 CPU 和大功率步进电机之间的智能功率接口器件。所有步进电机逻辑完全在 TMC5160 内，不需要软件来控制电机——只需提供目标位置。TMC5160 提供了许多独特的增强功能，这些功能通过集成的控制驱动器得以实现。TMC5160 的 SixPoint 六点斜坡发生器结合 StealthChop、DcStep、CoolStep 和 StallGuard2 来优化每个电机的运动。TMC5160 扩展了 TMC2100、TMC2130 和 TMC5130 系列，支持更高的电压和更高的电机电流。

TMC5160 提供三种基本操作模式。

### 模式 1：全功能运动控制和驱动器

所有步进电机逻辑完全在 TMC5160 内，不需要软件来控制电机——只需提供目标位置。

SD_MODE 接地使能此模式。

### 模式 2：脉冲和方向驱动器

像 TMC4361 这样的外部高性能 S-ramp 运动控制器或 CPU 同步的脉冲和方向信号，则只控制电流和斩波模式。TMC5160 根据外部的脉冲和方向信号控制电机，反馈电机状态。MicroPlyer 优化运动，使得电机可以更平滑。

SD_MODE 接高电平使能此模式。

### 模式 3：简单的步进和方向驱动器

TMC5160 根据步进和方向引脚的信号控制电机。MicroPlyer 优化运动，使得电机可以更平滑。不需要 CPU，配置由硬件引脚完成。TMC5160 控制不同工作状态的电流设置，如静止状态下的保持电流。可选的反馈信号作为错误检测和同步标志的输出。SPI_MODE 接地、SD_MODE 接高电平使能此模式。

（图 1.1 TMC5160 基本应用框图（运动控制器），见原数据手册）

（图 1.2 TMC5160 步进/方向模式应用框图，见原数据手册）

（图 1.3 TMC5160 独立模式驱动器应用框图，见原数据手册）

### 1.1 关键概念

TMC5160 包含了 TRINAMIC 产品特有的高级功能。这些高级功能在许多步进电机应用有效的提高了精度、能效、可靠性、平滑性和能耗。

- **StealthChop2™**：无噪声、高精度斩波算法，用于电机的静止和运动状态下的静音控制。StealthChop2 在 StealthChop 的基础上，加快了电机运动加减速特性，降低了所需的电流最小值。
- **spreadCycle™**：高精度斩波算法，用于高动态电机运动和产生绝对干净的电流波。低噪音、低共振和低振动斩波器。
- **DcStep™**：与负载相关的速度控制。电机尽可能快地移动，不失步。
- **StallGuard2™**：无传感器的堵转检测和机械负载测量。
- **CoolStep™**：根据负载自适应电流，可将能耗降低 75%。
- **MicroPlyer™**：细分内插器，用于从全步开始，以较低细分输入获得 256 微步的平滑度。

除了这些性能增强之外，TRINAMIC 电机驱动器还提供了检测和防止短路输出、输出开路、过热和欠压情况的保障措施，以增强安全性及故障恢复处理。

### 1.2 控制接口

TMC5160 有 SPI 和带 CRC 校验的 UART 单线通讯接口。此外还支持无需寄存器配置的独立 STEP/DIR 模式。通过配置引脚 SPI_MODE 和 SD_MODE 的高低选择接口。

#### 1.2.1 SPI 接口

SPI 接口是与总线时钟同步的串行位接口。SPI 主机和 TMC5160 从机之间的通信包括一条 40 位发送命令字和一条 40 位返回字。每个完整电机运动过程通常是由多条命令构成。

#### 1.2.2 UART 接口

单线接口支持类似 RS485（SWP 和 SWN）或单线接口（SWN 开路）UART 驱动。不需要波特率配置。

### 1.3 软件

从软件的角度来看，TMC5160 是一个具有多个控制和状态寄存器的外围设备。其中大部分是只读或者只写的。一些寄存器允许读写访问。如果只写寄存器需要读-修改-写访问，可以在主软件中通过阴影寄存器实现。

### 1.4 运动和控制电机

#### 1.4.1 集成运动控制器

集成的 32 位运动控制器直接驱动电机到目标位置，或者加速到目标速度。所有的运动参数都可以动态改变，运动控制器立即重新计算。最小运动配置数据包含加速和减速值以及最大运动速度。支持设置启动和停止速度以及第二加速和减速度。集成运动控制器可对机械参考开关和无传感器 StallGuard2 及时做出响应。

优势：

- 灵活编程斜坡参数
- 有效地利用电动机转矩来加速和减速，允许更高的机器性能
- 即时响应停止和堵转条件

#### 1.4.2 STEP/DIR 接口

STEP/DIR（步进和方向）引脚输入可控制电机。在这种情况下，运动控制器关闭。STEP（步进）输入引脚上的有效边沿可以是上升沿，也可以是上升沿及下降沿的双边缘，由模式位（dedge）控制。使用两个边缘将步进信号的触发速率降低一半，对慢速通信接口（如光耦隔离接口）非常有用。在每个活动边上，DIR 输入电平值决定是向前还是向后运行。每个脉冲可以是全步或微步，其中每个全步有 2、4、8、16、32、64、128 或 256 个微步。DIR 引脚上电平为低则每个步进（STEP）脉冲增加了微步计数器数值，同理类推，电平为高则减少了微步计数器的数值。内部表格将指针值转换成正弦和余弦值，控制电机微步电流。

### 1.5 静止态自动降电流

在电机静止的时候自动减小电流大大降低了应用的功耗并满足了冷却需求，可通过寄存器设置修改静态电流、延迟时间和衰减。静止时可以选择静止模式为自动飞轮及被动制动。被动制动将电机的静止功耗降低到零，同时仍然提供有效的阻尼和制动。斜坡发生器和 STEP/DIR 两个操作模式都支持一种更快检测到静止的配置（faststandstill 功能）。

（图 1.4 电机自动降电流，见原数据手册）

### 1.6 StealthChop 2 与 SpreadCycle 驱动

StealthChop 是电压斩波器的原理。除了电机机械滚轮轴承产生的噪音，它特别保证了电机在静止和慢速运行时能绝对安静。不同于其他电压模式斩波器，StealthChop 2 不需要任何配置。通电后，它会在第一次运动中自动学习最佳设置，并进一步优化后续运动中的设置。初始的归零过程足以使系统完成 StealthChop 最佳配置。也可以配置初始参数加快自学习过程。StealthChop 2 通过对电机速度的变化立即做出反应，允许高的电机动态。

对于高动态的应用，spreadCycle 是除 StealthChop 2 之外的选项。它可以通过输入引脚（独立模式）或 SPI 或 UART 接口配置。StealthChop 2 和 spreadCycle 甚至可以结合使用，以达到两者的最佳效果：StealthChop 2 用于无噪音的静止状态，无声平滑的性能，spreadCycle 用于高动态，低振动和最高的峰值速度。

spreadCycle 是周期斩波模式。它在很宽的速度和负载范围内提供平稳的操作和良好的共振阻尼。spreadCycle 方案集成快衰减周期并自动调节，以保证平滑过零。

StealthChop 2 优势：

- 显著改善了低成本电机的性能
- 电机运行平稳安静
- 绝对没有待机噪音
- 降低机械共振，产生改善的扭矩

### 1.7 StallGuard2 机械负载传感

StallGuard2 提供了对电机负载的精确测量。它可以用于堵转检测，也可以用于低于使电机失步的负载下的其他用途，例如 CoolStep 负载自适应调节电流。这提供了更多关于驱动器的信息，允许诸如无传感器归零和驱动器机械诊断之类的功能。

### 1.8 CoolStep 负载自适应电流控制

CoolStep 控制驱动电机的最佳电流。它根据 StallGuard2 负载测量信息将电机电流调整到实际负载所需的最小量。节约了能源，降低了芯片的温度。

好处是：

- 能效：功耗降低高达 75%
- 电机产生较少热量，提高了机械精度
- 较少或没有散热，提高了可靠性
- 使用较小的电机减少所需的转矩 → 成本较低的电机完成这项工作

（图 1.5 CoolStep 下的能效（示例），见原数据手册。示例中 42mm 步进电机使用 CoolStep 时，与 50% 转矩的标准操作相比的效率，coolstep 在转速大于 60 转/分时使能。）

### 1.9 DcStep 负载相关速度控制

DcStep 能让电机在其负载极限和速度极限附近运行而不失步。如果电机上的机械负载增加到堵转负载点，电机会自动降低速度，这样它仍然可以驱动负载。有了这个功能，马达将不会堵转。除了在较低速度下增加扭矩之外，动态惯性将允许电机通过减速克服机械过载。DcStep 直接与斜坡发生器集成，因此即使电机速度因机械负载增加而需要降低，也能达到目标位置。DcStep 可以在没有任何失步的情况下达到 10 倍或更大的动态范围。通过优化高负载情况下的运动速度，该功能进一步提高了整体系统效率。

DcStep 优势：

- 电机在过载情况下不会失步
- 应用程序可以更快的运行
- 自动实现最高的加速度
- 在速度极限下实现最高的能效
- 全步驱动达到最高电机扭矩
- 便宜的马达便能满足应用

### 1.10 编码器接口

TMC5160 为外部增量编码器提供编码器接口。编码器不仅用于失步的判断，还可实现运动控制器的归零功能（替代参考开关）。可编程预分频器寄存器设置了编码器分辨率以适应电机分辨率。内部包含一个 32 位编码器计数器。

## 2. 引脚分配

### 2.1 封装外形

（图 2.1 TMC5160-TA 封装和 TQFP-EP 48 引脚（主体 7x7mm，9x9mm 带引脚），见原数据手册）

（图 2.2 TMC5160-WA 封装和 QFN-WA 引脚（8x8mm），见原数据手册）

### 2.2 信号描述

| 引脚 | TQFP | QFN | 类型 | 功能 |
|---|---|-----|---|---|
| HB1 | 1 | 2 | — | 高端栅极驱动器输出。 |
| CB1 | 2 | 3 | — | 自举电容器正极连接。 |
| 12VOUT | 3 | 4 | — | 内部电压调节器的 11.5V 电压输出，用于栅极驱动器下管的门级控制。为获得最佳性能，建议接 2.2μF 至 10μF 陶瓷电容器到引脚附近的地（地平面）。通常建议容值比自举电容的容值至少大 10 倍。如果功率器件的栅极电压由外部电压供应，将 VSA 和 12VOUT 接到外部电源。 |
| VSA | 4 | 5 | — | 11.5V 和 5V 稳压器的模拟电源电压。通常与 VS 相连，滤波电容 100nF。 |
| 5VOUT | 5 | 6 | — | 内部 5V 调节器的输出。为获得最佳性能，建议接 2.2μF 至 10μF 陶瓷电容器到引脚附近的地 GNDA。建议 5VOUT 给芯片的 VCC 引脚供电。 |
| GNDA | 6 | 7 | — | 模拟地。连接到引脚附近的地平面。 |
| SRAL | 7 | 8 | AI | A 相采样电阻的地。直接连到采样电阻的地，以补偿地互连上的电压降。 |
| SRAH | 8 | 9 | AI | A 相采样电阻。连到采样电阻的上侧。对于高电机电流，开尔文连接是优选的。可在 SRAL 和 SRAH 设计对称 RC 滤波，以消除来自其他驱动器或线圈 B 开关的高频开关尖峰。 |
| SRBH | 9 | 10 | AI | B 相采样电阻。连到采样电阻的上侧。对于高电机电流，开尔文连接是优选的。可在 SRBL 和 SRBH 设计对称 RC 滤波，以消除来自其他驱动器或线圈 A 开关的高频开关尖峰。 |
| SRBL | 10 | 11 | AI | B 相采样电阻的地。直接连到采样电阻的地，以补偿地之间互连上的电压降。 |
| TST_MODE | 11 | 12 | DI | 测试模式输入。尽量短的连接到地。 |
| CLK | 12 | 13 | DI | 时钟输入。如果用内部时钟，请尽量短的连接到地。或者连接外部时钟。内含时钟故障切换电路防止外部时钟信号丢失。 |
| CSN_CFG3 | 13 | 14 | DI | SPI_MODE=1：SPI 片选信号（低有效）。SPI_MODE=0：配置输入脚。 |
| SCK_CFG2 | 14 | 15 | DI | SPI_MODE=1：SPI 时钟信号。SPI_MODE=0：配置输入脚。 |
| SDI_CFG1 | 15 | 16 | DI | SPI_MODE=1：SPI 数据输入信号。SPI_MODE=0：配置输入脚或单线接口的下一个地址输入（NAI）。 |
| SDO_CFG0 | 16 | 17 | DIO | SPI_MODE=1：SPI 数据输出信号。SPI_MODE=0：配置输入或单线接口的下一个地址输出（NAO）。 |
| REFL_STEP | 17 | 18 | DI | SD_MODE=0：左参考输入（用于内部斜坡发生器）。SD_MODE=1：步进信号输入。 |
| REFR_DIR | 18 | 19 | DI | SD_MODE=0：右参考输入（用于内部斜坡发生器）。SD_MODE=1：方向信号输入。 |
| GNDD | 19, 30 | 25, Pad | — | 数字地。连接到引脚附近的地平面。 |
| VCC_IO | 20 | 20 | — | 所有数字口 IO 的供电电压，3.3V 到 5V。 |
| SD_MODE | 21 | 21 | DI | 模式选择输入。SD_MODE=0：内部斜坡发生器产生步进信号。SD_MODE=1：STEP/DIR 输入引脚控制驱动器。SD_MODE=0 和 SPI_MODE=0 使能 UART 操作。 |
| SPI_MODE | 22 | 22 | DI (pd) | 模式选择脚。SPI_MODE=0：芯片为独立模式，引脚为 CFG 功能脚。SPI_MODE=1：使能 SPI 接口。内部集成下拉电阻。 |
| ENCB_DCEN_CFG4 | 23 | 23 | DI (pd) | SD_MODE=0：内部斜坡发生器模式下的编码器 B 通道输入脚。SD_MODE=1、SPI_MODE=1：DcStep 使能输入脚。如果不需要使能 DcStep，将该引脚开路或者接到地，以确保正常工作。SPI_MODE=0：CFG 配置引脚。 |
| ENCA_DCIN_CFG5 | 24 | 24 | DI (pd) | SD_MODE=0：内部斜坡发生器模式下的编码器 A 通道输入脚。SD_MODE=1、SPI_MODE=1：DcStep 信号，用于同步控制。SPI_MODE=0：CFG 配置引脚。 |
| ENCN_DCO_CFG6 | 25 | 26 | DIO | SD_MODE=0：编码器 N 信号输入脚。SD_MODE=1：DcStep 就绪输出信号。SD_MODE=0，如果不接编码器，将该信号拉高或者接地。 |
| DIAG0_SWN | 26 | 27 | DIO (pu+pd) | 诊断输出信号 DIAG0。SD_MODE=0、SPI_MODE=1：内部斜坡发生器模式下的中断输出或步进输出。在漏极开路模式下，使用 47k 或更小的外部上拉电阻。SD_MODE=0、SPI_MODE=0：单线 I/O 通讯的负端信号。 |
| DIAG1_SWP | 27 | 28 | DIO (pd) | 诊断输出信号 DIAG1。SD_MODE=0、SPI_MODE=1：内部斜坡发生器模式下的位置比较输出或方向输出。在漏极开路模式下，使用 47k 或更小的外部上拉电阻。SD_MODE=0、SPI_MODE=0：单线 I/O 通讯的正端信号。 |
| DRV_ENN | 28 | 29 | DI | 使能输入。当该引脚被驱动到高电平时，功率 MOSFET 输出关闭（所有电机输出为悬浮（FLOATING）状态）。 |
| VCC | 29 | 30 | — | 芯片内 5V 数字电路的电源输入。建议接 100nF 或更大的电容到就近的地平面。应该由 5VOUT 作为 VCC 的输入，建议加 2.2 或 3.3 欧姆电阻作为与 5VOUT 的噪声去耦。如果使用外部电源供电，请确保 VCC 在 5VOUT 或 VCC_IO 之前或同时上电！ |
| CPO | 31 | 31 | — | 电荷泵电容输出。 |
| CPI | 32 | 32 | — | 电荷泵电容输入。22nF/100V 电容连接到 CPO。 |
| VS | 33 | 33 | — | 电机电源电压。引脚与地平面之间需要滤波电容。必须连到功率器件 MOSFET 的上桥臂供电电压。 |
| VCP | 34 | 34 | — | 电荷泵电压。100nF 电容与 VS 相连。 |
| CA2 | 35 | 35 | — | 自举电容器正端。 |
| HA2 | 36 | 36 | — | 高端栅极驱动器输出。 |
| BMA2 | 37 | 37 | — | 桥臂中间节点和自举电容器负端连接。 |
| LA2 | 38 | 38 | — | 低端栅极驱动器输出。 |
| LA1 | 39 | 39 | — | 低端栅极驱动器输出。 |
| BMA1 | 40 | 40 | — | 桥臂中间节点和自举电容器负端连接。 |
| HA1 | 41 | 41 | — | 高端栅极驱动器输出。 |
| CA1 | 42 | 42 | — | 自举电容器正端连接。 |
| CB2 | 43 | 43 | — | 自举电容器正端连接。 |
| HB2 | 44 | 44 | — | 高端栅极驱动器输出。 |
| BMB2 | 45 | 45 | — | 桥臂中间节点和自举电容器负端连接。 |
| LB2 | 46 | 46 | — | 低端栅极驱动器输出。 |
| LB1 | 47 | 47 | — | 低端栅极驱动器输出。 |
| BMB1 | 48 | 1 | — | 桥臂中间节点和自举电容器负端连接。 |
| Exposed die pad | — | — | — | 将裸露的管芯焊盘连接到地平面。提供尽可能多的通孔以将热传递到地平面。也用作低端栅极驱动器的地引脚。确保采样电阻地的环路电感尽量低。 |

- (PD) 代表有下拉电阻的引脚。
- 所有数字引脚 DI、DIO 和 DO 都使用 VCC_IO 电平，并内置接地和 VCC_IO 的保护二极管。
- 所有数字输入 DI 和 DIO 都内置施密特触发器。

## 3. 示例电路

以下示例电路为不同控制模式和供电模式下对应的外部电路。为了清楚起见，省略了总线接口和其它数字信号的连接。

### 3.1 标准应用电路

（图 3.1 标准电路，见原数据手册）

标准电路使用最少的外部器件。根据所需的电流、电压和封装类型选择八个 MOSFET。两个采样电阻确定驱动电机线圈的最大电流。请参阅第 8 章选择正确的采样电阻。电源滤波选用低 ESR 电容。为获得最佳性能，建议功率桥附近的电容根据线圈电流的大小选择至少为 100μF/安培。电容需要吸收斩波器操作产生的电流纹波。电源电容上的电流纹波也取决于电源内阻和电缆长度。VCC_IO 可以由 5VOUT 或外部电源（例如 3.3V 调节器）供电。在高 VM 的应用中为了降低内部 5V 和 11.5V 稳压器的线性稳压器功耗，VSA 应该使用不同（较低）的电源电压（参见第 3.2 章）。

#### 基本布线提示

将采样电阻和所有滤波电容尽可能靠近功率 MOSFET。TMC5160 靠近 MOSFET 放置，短线互连，以最小化寄生电感。将所有的 GND、GNDA、GNDD 及采样电阻 GND 连成一个公共地。5VOUT 滤波电容直接连到 5VOUT 和 GNDA 引脚。有关详细信息，请参阅布局提示。推荐使用低 ESR 电解电容对 VS 滤波。

#### 提示

在安全关键应用中，VS 和功率桥可以由单独的开关电源供电，以实现安全关闭。确保 VS 处的斜率不超过 1V/µs。

#### 注意

如果 VSA 由不同的电压源供电，请确保在电机运行期间 VSA 不会跌落。VSA 在 VS 之前关断，需要关断电机驱动。因为 VSA 上的切换边缘，可能导致桥臂导通。VSA 与 VS 电源由一路供电是最安全的。

### 3.2 外部栅极电压调节器

在 48V 这样的高电源电压下，内部栅极电压调节器和内部 5V 调节器具有相当大的功耗，特别是在 MOSFET 栅极电荷高、斩波器频率高或系统时钟频率大于 12MHz 的情况下。散热块与系统 PCB 地平面的良好热传导将有助于散热。自身功耗增加芯片温度，将显著降低温度保护的阈值。为降低功耗，建议外接 TMC5160 驱动器栅极电压。如图 3.2 所示。在图中，内部栅极电压调节器关闭。为获得最佳效果，建议使用 12V ± 1V 的电源。

（图 3.2 外部栅极电压源，见原数据手册）

提示：当 MOSFET 的总栅极电荷超过 50nC、斩波器频率大于 40kHz 或时钟频率大于 12MHz 时，建议 VSA 电源不高于 40V。

### 3.3 选择 MOSFET 和斜率

功率 MOSFET 的选择取决于许多因素，如封装尺寸、导通电阻、额定电压和供应商。越大、越低 RDSon 的 MOSFET 并不一定是越好，因为越大的器件也具有更高的电容，并且可能在栅极驱动电路中的走线电感增加更多的振铃及功耗。将 MOSFET 调整到所需的电机电压（在峰值电源电压上增加 5-10V 的余量）和所需的最大电流，使得电阻功耗对于所选 MOSFET 封装的热容量仍然很低。TMC5160 以大约 10V 驱动 MOSFET 栅极，因此正常的 10V 就足够了。FET 逻辑电平（4.5V 指定的 RDSon）也将工作，但由于 VGS(th) 较低，桥臂开通特性可能更为关键。

栅极驱动电流和 MOSFET 栅极电阻 RG（可选）决定开关行为，且应根据 MOSFET 栅极-漏极电荷（米勒电荷）调整。图 3.3 显示了米勒电荷对开关事件的影响。图 3.4 还显示了不同负载情况下的切换事件（负载将输出拉高或拉低）以及所需的死区时间。

下表是设置 MOSFET 驱动器电流（DRVSTRENGTH 设置）和选择栅极电阻的经验法则：

| 米勒电荷 [nC]（典型值） | DRVSTRENGTH 设置 | RG [Ω] 值 |
|---|---|---|
| <10 | 0 | ≤ 15 |
| 10…20 | 0 或 1 | ≤ 10 |
| 20…40 | 1 或 2 | ≤ 7.5 |
| 40…60 | 2 或 3 | ≤ 5 |
| >60 | 3 | ≤ 2.7 |

TMC5160 的栅极截止驱动电流，以避免高 dV/dt 引起的桥臂直通。栅极电阻超过表中给出的值时，保护的效率会降低。因此，对于较大的 RG 值，可能需要并联二极管来确保 MOSFET 在开关事件期间安全关断。

（图 3.3 米勒电荷决定开关斜率，见原数据手册）

提示：

- 选择快速、软恢复特性二极管和低反向恢复电荷的 MOSFET。
- 小型贴片 MOSFET 封装允许更紧凑的布线，并降低寄生电感效应。

（图 3.4 斜坡、米勒平台和消影时间，见原数据手册）

#### DRV_CONF 参数

驱动器需根据 MOSFET 参数配置以下 DRV_CONF 参数：

| 参数 | 描述 | 设置 | 备注 |
|---|---|---|---|
| BBMTIME | 死区时间，确保同一桥臂的高端和低端 MOSFET 不会直通。BBMTIME 是更高频率的调节死区时间设置，允许比时钟周期更快的调节时间。需要更长的时间，选择 BBMCLKS。 | 0…24 | 时间 [ns] ≈ 100ns*32/(32-BBMTIME)，确保 ~30% headroom。复位缺省：0 |
| BBMCLKS | 与 BBMTIME 类似功能，也是死区时间设置，以多个时钟周期为单位，设置较长的死区时间（BBMTIME 与 BBMCLKS 的区别）。 | 0…15 | 0：关闭。复位缺省：OTP 4 或 2 |
| DRV_STRENGTH | 栅极驱动电流的选择。根据外部 MOSFET 的栅极电荷设置栅极驱动电流。 | 0…3 | 复位缺省 = 2 |
| FILT_ISENSE | 采样电阻运放的滤波时间常数，以补偿另一个线圈操作的振铃和耦合。提示：如果两个线圈交叉耦合产生电机斩波器噪声，则增加设置。（重置默认值 = %00） | 0…3 | 00：~100ns（复位缺省）；01：~200ns；10：~300ns；11：~400ns |

在增加栅极串联电阻值之前，将 DRVSTRENGTH 栅极驱动强度设置最低会给出有利的开关斜率。40ns 到 80ns 的斜率时间是绝对足够的，通常最短的死区时间设置（BBMTIME=0、BBMCLKS=0）会大于这个时间。

如果大的 MOSFET 需要较慢的斜率，要确保死区时间（BBMTIME，200ns 以上时间可用 BBMCLKS）充分覆盖开关事件，以避免桥臂直通短路。最短的 BBM 时间大于安全切换，效果最佳。控制大约 30% 的余量，以弥补 MOSFET 和驱动器的生产批次造成的不一致性。

### 3.4 调整 MOSFET 桥臂

干净的切换事件有利于确保低功耗和良好的 EMC 性能。不合适的布局或器件会危及电路的稳定运行。因此，了解寄生电感和 MOSFET 反向恢复的影响非常重要。

在接通低端 MOSFET 或高端 MOSFET 之前，只要相对的 MOSFET 处于二极管导通状态，电源布线中的杂散电感就会引起振铃。当负载电流与接下来的导通桥极性相反时，二极管在死区时间段导通。MOSFET 体二极管具有一定的反向恢复时间和放电时间，这一时间通常在几十纳秒的范围内。在反向恢复期间，二极管将引起桥上的高电流流动，该电流来自电源滤波电容（参见图 3.5 粗线）。一旦二极管导通，寄生电感就试图保持电流流动。高、快速斜率导致寄生电感振铃（见图 3.6）。这可能导致桥电压低于 GND 电平。必须确保驱动器 IC 在其 BM 引脚到地没有出现低于 -5V 的峰值。直接测量驱动器引脚到驱动器地的电压。下冲的量取决于从低侧漏极到低侧源极并且经由采样电阻 RS 到地通路中寄生电感的存储能量。

当电路中是相对较小的 MOSFET 时，软斜率控制需要串联较高的栅极电阻，这危及安全的 MOSFET 关断。添加额外的二极管，以确保 MOSFET 在缓慢切换斜率下的安全关断（图 3.5 所示的 MOSFET 对管）。

（图 3.5 对电源布线电感的可选保护选项，见原数据手册）

#### 确保可靠操作

- 使用贴片 MOSFET 和短线连接。
- 桥臂和 VS 引脚附近提供足够的滤波电容。
- 调整 MOSFET 开关斜率（在 MOSFET 栅极上测量开关事件）比 MOSFET 体二极管反向恢复时间慢。这将减少交叉导通。
- 靠近 MOSFET 处增加栅极电阻和输出电容，通过最大限度地减少响铃，确保开关特性和可靠运行。图 3.5 显示了一些的选项。
- 部分 MOSFET 有集成的源级到漏级的快速二极管，可消除反向恢复放电。

（图 3.6 输出振铃（蓝色）和未加调整的栅极电压（黄色和紫色），见原数据手册）

（图 3.7 增加优化器件后的开关事件（没有体二极管/体二极管导通），见原数据手册。图 3.7 显示了调整开关斜率和增加 1nF 桥式输出电容器后的电路性能）

#### 桥臂优化示例

下图为 6A 电机电流步进驱动器的标准原理图，MOSFET 为 AOD4126。

该 MOSFET 具有低栅极电容，在最低驱动器强度设置下斜率时间大约为 50ns。在最低驱动强度设置下，切换质量最好（图 3.6），但显示大量振铃。增加低侧栅极电阻，可增加开关斜率时间，通过对栅极-漏极（米勒）电荷放电的影响，高侧体二极管传导后也稍微增加开关斜坡时间。为了对称，增加了高侧栅极电阻。测试表明，1nF 输出电容可显著降低体二极管导通后电桥的振铃（图 3.7）。图 3.8 显示了优化后的实际组件和值。

（图 3.8 带有调整器件的桥臂示例（请参见示波器截图），见原数据手册）

#### 桥臂布线考虑

- 调整电桥布局，使环路电感最小。布局最好紧凑。
- MOSFET 栅极连接短而直，避免 BM 和相应的 HS 驱动器引脚之间的环路电感。利用平行走线或相邻层上的相邻走线使回路电感最小化。较宽的走线也可以降低了电感（不使用最小线径）。
- 采样电阻到低侧 MOSFET 源极的长度最短，并将 TMC5160 放置在采样电阻的地附近，其地通过过孔直接连到同一平面。
- 调整栅极电流设置和栅极电阻优化开关行为。增加 MOSFET 电桥输出电容（470pF 至几个 nF）减少振铃。
- 通过使用示波器探针上 GND 尖端而不是 GND 电缆（如果可用）直接在桥臂或 TMC5160 的 BM 引脚处探测来测量桥臂的性能。

### 3.5 高压应用

有些应用电压比 TMC5160 耐压更高。对于 60V 以上的峰值电压，可以使用外部栅极驱动器 IC 提升 TMC5160 栅极驱动器输出。图 3.9 为示例电路，每个半桥使用一个外部栅极驱动器 IC，以提升 TMC5160 输出能力。BBM 控制仍由 TMC5160 完成。这些 IC 为 12V 电压，因此 TMC5160 输出信号可直接驱动。BM 引脚需要靠近地以产生与地相关的高端控制信号。通过将 BM 连接到相应的采样电阻，对 VS 电源短路保护仍然可以对过流情况做出反应。将短路检测电压降限制在 0.5V…0.8V，以避免高端输出达到过高水平。高端短路保护必须设置 CHOPCONF.diss2g 禁用，因为在此电路配置中不能工作。

保持布局和所有互连紧凑，以避免寄生效应的干扰。也可以参考所选栅极驱动器集成电路的应用笔记。

（图 3.9 外部门级驱动电路示例，见原数据手册）

## 4. SPI 接口

### 4.1 SPI 数据报结构

TMC5160 采用 40 位 SPI（串行外围接口）数据报与微控制器 MCU 通信。带硬件 SPI 的微控制器 MCU 通常用 8 比特位的整数倍进行通信。设备的 NCS 信号必须在数据报传输的整个持续时间内保持有效（低）。

发送到 TMC5160 的每个数据报由一个地址字节和四个数据字节组成。这方便对 TMC5160 的寄存器组直接进行 32 位数据字通信。每个寄存器有 32 位数据，即使少于 32 位。

为了简化，每个寄存器地址长度为一个字节：

- 读操作，地址字节的最高有效位是 0。
- 写操作，地址字节的最高有效位为 1。

大多数寄存器都是只写寄存器，有些可读，还有一些只读。

SPI 数据报结构（高位先传送，低位后传送）：

| 位 | 39…32 | 31…0 |
|----|---|---|
| 发送到 TMC5160 | 读写标志 + 7 位地址 | 32 位数据 |
| TMC5160 返回 | 8 位 SPI 状态 | 32 位数据 |

#### 4.1.1 写/读选择（WRITE_notREAD）

读和写选择由地址字节的最高位（SPI 数据报的第 39 位）控制。读为 0，写为 1。因此，标号为 W 的位是 WRITE_notREAD 控制位。有效高写入位是地址字节的最高位。因此，0x80 必须加到地址中才能进行写操作。SPI 接口总是将数据传送回主机，与 W 位无关。如果前一次访问是读访问，则传输回来的数据是前一个数据报一起传输的地址对应的读取值。如果前一次访问是写访问，则数据回读为以前接收的镜像写数据。因此，读访问和写访问之间的区别在于，读访问不将数据传输到寻址寄存器，仅传输地址，因此它的 32 个数据位是虚拟的，而且，随后的读访问或写访问将发回前一个读周期中传输的地址对应的数据。

读请求数据报需用空写数据。读取的数据值通过后续的读取或写入访问被传输回主设备。因此，可以以流水线方式读取多个寄存器。

每当从 TMC5160 读取数据或向 TMC5160 写入数据时，返回高位八位包含 SPI 状态（SPI_STATUS），对应八个选定的状态位。

示例：读地址 0x21 寄存器（XACTUAL）之前，地址字节必须设置为 0x21。写寄存器（VACTUAL），地址字节必须设置为 0x80+0x22 = 0xA2。读操作的数据位可能是任何值（-），因此，可以将它们设置为 0。

| 动作 | 发送给 TMC5160 的数据 | 返回的数据 |
|---|---|---|
| 读 XACTUAL | 0x2100000000 | 0xSS & 无用的数据 |
| 读 XACTUAL | 0x2100000000 | 0xSS & XACTUAL |
| 写 VMAX := 0x00ABCDEF | 0xA700ABCDEF | 0xSS & XACTUAL |
| 写 VMAX := 0x00123456 | 0xA700123456 | 0xSS00ABCDEF |

\*) S：表示代表状态位 SPI_STATUS。

#### 4.1.2 每次 SPI 数据报读回时传送的状态位

新的状态信息在每次访问结束时被锁存，并可用于下一次 SPI 传输。

| 位 | 名称 | 备注 |
|----|---|---|
| 7 | status_stop_r | RAMP_STAT[1] — 1：仅限运动控制器模式下，右参考开关停止标志。 |
| 6 | status_stop_l | RAMP_STAT[0] — 1：仅限运动控制器模式下，左参考开关停止标志。 |
| 5 | position_reached | RAMP_STAT[9] — 1：仅限运动控制器模式下，目标位置到达标志。 |
| 4 | velocity_reached | RAMP_STAT[8] — 1：仅限运动控制器模式下，目标速度到达标志。 |
| 3 | standstill | DRV_STATUS[31] — 1：电机静止标志。 |
| 2 | sg2 | DRV_STATUS[24] — 1：StallGuard 标志有效标志。 |
| 1 | driver_error | GSTAT[1] — 1：驱动器错误指示（通过读 GSTAT 清标志）。 |
| 0 | reset_flag | GSTAT[0] — 1：复位发生指示（通过读 GSTAT 清标志）。 |

#### 4.1.3 数据排列

所有数据都是右对齐。寄存器格式包含无符号（正）值、二进制补码的整数值（有符号）、单个位或位组分别代表单个位或整数组。

### 4.2 SPI 信号

TMC5160 上的 SPI 总线有四个信号：

- SCK — 总线时钟输入
- SDI — 串行数据输入
- SDO — 串行数据输出
- CSN — 芯片选择输入（低电平有效）

SPI 芯片选择输入 CSN 上的低电平使能 SPI。位传输与总线时钟 SCK 同步，从设备在 SCK 的上升沿锁存来自 SDI 的数据，并在下降沿之后驱动数据到 SDO。首先发送最高有效位。一个完整的与 TMC5160 进行总线传输至少需要 40 个 SCK 时钟周期。

如果驱动的时钟超过 40 个，则内部移位寄存器延迟 40 个时钟后，多余的 SDI 位在 SDO 上被移出。这可用于多个芯片的菊花链连接。

在整个 SPI 总线通讯期间，CSN 必须为低。当 CSN 变高时，内部移位寄存器的内容被锁存到内部控制寄存器中，并被识别为从主设备到从设备的命令。如果发送超过 40 位，则只有 CSN 上升沿之前接收的最后 40 位被识别为有效命令。

### 4.3 时序

SPI 接口单元与内部系统时钟同步，最高 SPI 时钟 SCK 为系统时钟频率的一半。如果系统时钟基于片上振荡器，则必须使用额外的 10% 安全裕度来确保可靠的数据传输。所有 SPI 输入以及 ENN 输入都经过内部滤波，以避免被短于 20ns 的脉冲触发。

（图 4.1 SPI 时序，见原数据手册）

提示：通常 TMC5160 SPI 时序指的是 SPI 模式 3。

| 参数 | 符号 | 条件 | 最小值 | 典型值 | 最大值 | 单位 |
|---|---|---|---|---|---|---|
| SCK 在 CSN 变化前或变化后有效时间 | tCC | | 10 | | | ns |
| CSN 高电平时间 | tCSH | \*) 最小时间仅用于同步 CLK，在 CSN 高电平前 SCK 至少保持一个 tCH 高电平时间 | tCLK \*) | >2tCLK+10 | | ns |
| SCK 低电平时间 | tCL | \*) 最小时间仅用于同步时钟 | tCLK \*) | >tCLK+10 | | ns |
| SCK 高电平时间 | tCH | \*) 最小时间仅用于同步时钟 | tCLK \*) | >tCLK+10 | | ns |
| 内部时钟的 SCK 频率 | fSCK | 假设最小振荡频率 | | | 4 | MHz |
| 外部 16M 时钟的 SCK 频率 | fSCK | 假设为同步时钟 | | | 8 | MHz |

## 22. 独立操作模式

独立操作模式下，TMC5160 无需通过 SPI 配置内部寄存器，所有尾缀为 CFG0 到 CFG6 的引脚有特殊定义，能被拉高或者接地。

（图 22.1 TMC5160（以独立模式名称显示的引脚）工作模式，见原数据手册）

SPI_MODE 引脚接地 GND，SD_MODE 引脚拉高使能独立模式。该模式下，驱动器是一个纯步进/方向驱动器，SPI 和单线通讯接口关闭，驱动器工作在 spreadCycle 模式或者 StealthChop 模式。

以下设置影响 CFG 引脚，以确保正确的配置：

#### CFG0/CFG1：STEP 输入的细分设置

| CFG1 | CFG0 | 细分设置 |
|---|---|---|
| GND | GND | 8 微步，MRES=5 |
| GND | VCC_IO | 16 微步，MRES=4 |
| VCC_IO | GND | 32 微步，MRES=3 |
| VCC_IO | VCC_IO | 64 微步，MRES=2 |

#### CFG4/CFG3/CFG2：运行电流配置

| CFG4 | CFG3 | CFG2 | IRUN 设置 |
|---|---|---|---|
| GND | GND | GND | IRUN=16 |
| GND | GND | VCC_IO | IRUN=18 |
| GND | VCC_IO | GND | IRUN=20 |
| GND | VCC_IO | VCC_IO | IRUN=22 |
| VCC_IO | GND | GND | IRUN=24 |
| VCC_IO | GND | VCC_IO | IRUN=26 |
| VCC_IO | VCC_IO | GND | IRUN=28 |
| VCC_IO | VCC_IO | VCC_IO | IRUN=31 |

#### CFG5：斩波模式选择

| CFG5 | 斩波器设置 |
|---|---|
| GND | SpreadCycle 操作（TOFF=3） |
| VCC_IO | StealthChop 操作（GCONF.en_PWM_mode=1） |

#### CFG6：保持电流配置

| CFG6\*) | 斩波器设置 |
|---|---|
| GND | 保持电流不减小，IHOLD=IRUN |
| VCC_IO | 50%，IHOLD=1/2 IRUN |

提示：StealthChop 使能前，请确保电机保持静止至少 100 毫秒复位（假设 fCLK 最小为 10MHz）。用于驱动器调节电流设置电机的初始电流。

\*) CFG6 注意：CFG6 引脚电平与 CFG5 不同时会产生电流（20mA），因为输出驱动器试图使 CFG6 电平等于 CFG5。因此，需要一个 10 欧姆电阻来拉高/拉低 CFG6。建议仅在外接 VCC_IO 电源为 3.3V 情况下 CFG6 与 CFG5 电平值不同。

注意：默认情况下，不会配置 DIAG 输出。在切换到独立模式之前，可以用接口使能它们。

## 23. 外部复位

芯片内部在上电时加载默认值。必须控制内部重置电压（VSA、+5VOUT、VCC_IO）的电压芯片重置默认值。注意芯片内部不监测 VCC，因此，在芯片运行期间，VCC 必须正常，不能掉电。由于 +5VOUT 是内部电压调节器的输出，因此它不能通过外部电源供电，除了 VSA。控制 VCC_IO 完成复位是最简单和最安全的方法。此外，VCC_IO 消耗的电流很低，驱动要求很简单。由于输入保护二极管不允许数字输入上升到 VCC_IO 电平以上，因此在此复位操作期间，所有输入必须被驱动为低电平。如果无法全低，可以使用输入保护电阻器来限流。

如果 VCC 由外部电源提供，确保 VCC 在复位结束时候高于操作下限并稳定。当用产生 3.3V VCC_IO 的 +5V 电源给 VCC 供电时，基本能满足上述条件，因为它会产生一定的延迟。

## 24. 时钟振荡器和输入

时钟是所有功能的定时基准：斩波器、速度、加速度控制等。许多参数随着时钟频率而缩放，因此准确的参考允许更确定的结果。在没有外部时钟情况下，出厂校正的片上时钟振荡器，可以作为时钟参考。

### 24.1 内部时钟

如果要使用内部时钟振荡器，直接将 CLK 输入连接到 IC 附近的地。对于速度精度大约为 ±4% 的应用来说，这就足够了。

### 24.2 外部时钟

建议外部时钟频率为 10MHz 到 16MHz 以获得最佳性能。只要满足引脚的最小高或低输入时间（参见电气特性），时钟信号的占空比就不重要。当时钟占空比为 50% 时，最多可使用 18MHz。确保时钟源在使用高时钟频率时提供干净的 CMOS 输出逻辑电平和陡峭的斜率。CLK 输入检测到第二次高电平则外部时钟输入有效。

提示：关闭外部时钟频率让驱动器正常异常。因此，外部时钟信号丢失超过大约 32 个内部时钟周期后，内部看门狗电路会将时钟切换到内部时钟。

#### 24.2.1 频率的考虑

越高的频率可以产生更快的步进速率、更快的 SPI 操作和更高的斩波频率。另一方面，也会在 TMC5160 数字核心和 5V 电压调节器中造成更多功耗。通常，10MHz 到 12MHz 的频率对于大多数应用来说应该足够了。在较高的时钟频率下，VSA 电源电压应连接到较低的电压，如用于工作在 24V 标称电源电压以上的应用。为了降低对电机动态特性的要求，可以考虑低至 8MHz（甚至更低）的时钟频率。

## 25. 最大电气参数

任何情况下都不得超过最高限制。系统设计应避免超过最大额定值或在接近最大额定值的情况下长时间运行电路。

| 参数 | 符号 | 最小值 | 最大值 | 单位 |
|---|---|---|---|---|
| 感性负载下最大供电电压 | VVS, VVSA | -0.5 | 60 | V |
| 电源和功率桥臂电压短时峰值（受电荷泵输出及 Cxx 引脚上的峰值电压限制\*)） | VVSMAX | | 64 | V |
| VSA（与 VS 不是一路供电） | VVSAMAX | -0.5 | 60 | V |
| Cxx 自举引脚及 VCP 引脚上的峰值电压 | VCxCP | | 76 | V |
| V12OUT 供电电压 | V12VOUT | -0.5 | 14 | V |
| BM 引脚上的峰值电压（由于杂散电感） | VBMx | -6 | VVS+6 | V |
| Cxx 自举引脚上相对于 BM 的峰值电压 | VCxBMx | -0.5 | 16 | V |
| VCC_IO 对应的 IO 口供电电压 | VVIO | -0.5 | 5.5 | V |
| 数字 VCC 供电电压（一般由 5VOUT 供电） | VVCC | -0.5 | 5.5 | V |
| 逻辑输入电压 | VI | -0.5 | VVIO+0.5 | V |
| 数字引脚的最大电流和模拟低电压 I/O（短时间峰值电流） | IIO | | ±500 | mA |
| 5V 调节器输出电流（内部加外部负载） | I5VOUT | | 30 | mA |
| 5V 调节器连续功率 (VVSA-5V) * I5VOUT | P5VOUT | | 1 | W |
| 12V 调节器输出电流（内部加外部负载） | I12VOUT | | 20 | mA |
| 12V 调节器连续功率 (VVM-12V) * I12VOUT | P12VOUT | | 0.5 | W |
| 结点温度 | TJ | -50 | 150 | °C |
| 存储温度 | TSTG | -55 | 150 | °C |
| 接口引脚上的 ESD 保护（人体模型，HBM） | VESDAP | | 4 | kV |
| 操作中的 ESD 保护（人体模型，HBM） | VESD | | 1 | kV |

## 26. 电气特性

### 26.1 操作范围

| 参数 | 符号 | 最小值 | 最大值 | 单位 |
|---|---|---|---|---|
| 节点温度 | TJ | -40 | 125 | °C |
| 电机及桥臂供电电压 | VVS | 10 | 55 | V |
| VSA 供电电压 | VVSA | 10 | 50 | V |
| VSA 与 12VOUT（供内部桥接内部栅极电压调节器）的电源电压 | V12VOUT, VVSA | 10 | 13 | V |
| 最低电源电压（规格降低，对 GND 短路保护不起作用），下限取决于 MOSFETs 栅极阈值电压和负载电流 | VVS | 8 | | V |
| VCC_IO 上的输入/输出电源电压 | VVIO | 3.00 | 5.25 | V |

### 26.2 直流特性和时序

除非另有规定，直流特性包含在指定电源电压范围内保证的范围值。典型值为 +25°C 下测量的平均值。温度变化也会导致偏离某些值。芯片的典型值在全温度范围内工作在最小/最大范围之间。

#### 供电电流（VVS = VVSA = 24.0V）

| 参数 | 符号 | 条件 | 最小值 | 典型值 | 最大值 | 单位 |
|---|---|---|---|---|---|---|
| 总电源电流，驱动器禁用（IVS + IVSA） | IS | fCLK=12MHz / 内部时钟 | | 18 | 24 | mA |
| VSA 电源电流（VS 与 VSA 分开） | IVSA | fCLK=12MHz / 内部时钟，驱动器禁用 | | 15 | | mA |
| 总电源电流，工作（MOSFETs AOD4126），IVS + IVSA | IS | fCLK=12MHz，23.4kHz 斩波器，无负载 | | 25 | | mA |
| VCC 引脚上的 5V 电源的内部电流消耗 | IVCC | fCLK=12MHz | | 10 | | mA |
| VCC 引脚上的 5V 电源的内部电流消耗 | IVCC | fCLK=16MHz | | 12.5 | | mA |
| VCC_IO 上的 IO 电源电流（典型值 5V） | IVIO | 无负载输出，VIO 与 GND 输入，不包括上/下拉电阻 | | 15 | 30 | µA |

#### 电机驱动器部分（VVS = 24.0V，Tj=50°C）

| 参数 | 符号 | 条件 | 最小值 | 典型值 | 最大值 | 单位 |
|---|---|---|---|---|---|---|
| RDS ON 低侧驱动器 | RONL | 栅极关断 | | 1.8 | 3 | Ω |
| RDS ON 高侧驱动器 | RONH | 栅极关断 | | 2.2 | 3.5 | Ω |
| 低侧 MOSFET 在 12V VGS 下导通栅极驱动电流 | ISLPON0 | DRVSTRENGTH=0 | | 200 | | mA |
| 低侧 MOSFET 在 12V VGS 下导通栅极驱动电流 | ISLPON2 | DRVSTRENGTH=2 | | 400 | | mA |
| 低侧 MOSFET 在 12V VGS 下导通栅极驱动电流 | ISLPON3 | DRVSTRENGTH=3 | | 600 | | mA |
| 高侧 MOSFET 在 12V VGS 下导通栅极驱动电流 | ISHPON0 | DRVSTRENGTH=0 | | 150 | | mA |
| 高侧 MOSFET 在 12V VGS 下导通栅极驱动电流 | ISHPON2 | DRVSTRENGTH=2 | | 300 | | mA |
| 高侧 MOSFET 在 12V VGS 下导通栅极驱动电流 | ISHPON3 | DRVSTRENGTH=3 | | 450 | | mA |
| 内部延迟（BBM 时间，从栅极关闭开始到栅极导通） | tBBM0 | BBMCLKS=0，BBMTIME=0 | 75 | 100 | | ns |
| 内部延迟（BBM 时间，从栅极关闭开始到栅极导通） | tBBM16 | BBMTIME=16 | | 200 | | ns |
| 内部延迟（BBM 时间，从栅极关闭开始到栅极导通） | tBBM24 | BBMTIME=24 | | 375 | 500 | ns |

#### 电荷泵

| 参数 | 符号 | 条件 | 最小值 | 典型值 | 最大值 | 单位 |
|---|---|---|---|---|---|---|
| 电荷泵输出电压 | VVCP - VVS | 工作 | V12VOUT-2 | V12VOUT-1 | | V |
| 用于欠压检测的电荷泵电压阈值 | VVCP - VVS | 上升，内部 5V 调节器电压 | 4.5 | 5 | 6.5 | V |
| 电荷泵频率 | fCP | | | 1/16 fCLKOSC | | |

#### 线性调节器（VVS = VVSA = 24.0V）

| 参数 | 符号 | 条件 | 最小值 | 典型值 | 最大值 | 单位 |
|---|---|---|---|---|---|---|
| 输出电压 | V5VOUT | TJ=25°C | 4.80 | 5.0 | 5.20 | V |
| 整个温度范围内的输出电压偏差 | V5VOUT(DEV) | 驱动器关闭，TJ=全温度范围 | | ±30 | ±100 | mV |
| 整个电源电压范围内的输出电压偏差 | V5VOUT(DEV) | 驱动器关闭，内部时钟，TA=25°C，VVSA=10V 至 30V | | | ±50 | mV/10V |
| 输出电压 | V12VOUT | 工作，内部时钟，TJ=25°C | 10.8 | 11.5 | 12.2 | V |

#### 时钟振荡器和输入（时序特征）

| 参数 | 符号 | 条件 | 最小值 | 典型值 | 最大值 | 单位 |
|---|---|---|---|---|---|---|
| 时钟振荡器频率（工厂校准） | fCLKOSC | TJ=-50°C | | 11.7 | | MHz |
| 时钟振荡器频率（工厂校准） | fCLKOSC | TJ=50°C | 11.5 | 12.0 | 12.5 | MHz |
| 时钟振荡器频率（工厂校准） | fCLKOSC | TJ=150°C | | 12.1 | | MHz |
| 外部时钟频率（工作） | fCLK | | 4 | 10-16 | 18 | MHz |
| 外部时钟高/低电平时间 | tCLKH / tCLKL | CLK 0.1VVIO / 0.9VVIO | 16 | | | ns |
| 触发切换到外部 CLK 的外部时钟第一个脉冲 | tCLKH / tCLKL | CLK 高，A 版本 | 16 | | | ns |
| 触发切换到外部 CLK 的外部时钟第一个脉冲 | tCLKH / tCLKL | CLK 高，非 A 版本 | 30 | 25 | | ns |
| 外部时钟超时检测，按内部 fCLKOSC 作为计算周期 | tCLKH1 | CLK 高电平 | 32 | | 48 | cycles fCLKOSC |

#### 短路检测

| 参数 | 符号 | 条件 | 最小值 | 典型值 | 最大值 | 单位 |
|---|---|---|---|---|---|---|
| 对 GND 短路/对 VS 检测器短路检测时间（从栅极开关开始到短路检测），包括 100ns 滤波时间 | tSD0 | FILT_ISENSE=0，S2xx_LEVEL=6，shortdelay=0 | 0.5 | 0.85 | 1.1 | µs |
| 对 GND 短路/对 VS 检测器短路检测时间（从栅极开关开始到短路检测），包括 100ns 滤波时间 | tSD1 | shortdelay=1 | 1.1 | 1.6 | 2.2 | µs |
| 短路检测电压 S2VS（测量包括采样电阻电压跌落） | VBM | S2VS_LEVEL=15 | 1.4 | 1.56 | 1.72 | V |
| 短路检测电压 S2VS（测量包括采样电阻电压跌落） | VBM | S2VS_LEVEL=6 | 0.55 | 0.625 | 0.70 | V |
| 短路检测电压 | VS - VBM | S2G_LEVEL=15，VS<52V | 1.2 | 1.56 | 1.9 | V |
| 短路检测电压 | VS - VBM | S2G_LEVEL=15，VS<55V | 0.85 | | | V |
| 短路检测电压 | VS - VBM | S2G_LEVEL=6，VS<50V | 0.46 | 0.625 | 0.80 | V |

#### 检测电压（欠压复位与过温）

| 参数 | 符号 | 条件 | 最小值 | 典型值 | 最大值 | 单位 |
|---|---|---|---|---|---|---|
| VVSA 复位欠压阈值 | VUV_VSA | VVSA 上升 | 3.6 | 4 | 4.6 | V |
| V5VOUT 复位欠压阈值 | VUV_5VOUT | V5VOUT 上升 | | 3.5 | | V |
| VVCC_IO 复位欠压阈值 | VUV_VIO | VVCC_IO 上升（delay typ. 10µs） | 2.0 | 2.5 | 3.0 | V |
| VVCC_IO 欠压检测器磁滞 | VUV_VIOHYST | | | 0.3 | | V |
| 过温预警 120°C | TOTPW | 温度上升 | 100 | 120 | 140 | °C |
| 过温关断 136°C | TOT136 | 温度上升 | | 136 | | °C |
| 过温关断 143°C | TOT143 | 温度上升 | | 143 | | °C |
| 过温关断 150°C | TOT150 | 温度上升 | 135 | 150 | 170 | °C |

#### 采样电阻电压电平（fCLK=16MHz）

| 参数 | 符号 | 条件 | 最小值 | 典型值 | 最大值 | 单位 |
|---|---|---|---|---|---|---|
| 采样电阻输入峰值阈值电压（低敏感度）(VSRxH - VSRxL) | VSRT | GLOBALSCALER=0，csactual=31，sin_x=248，Hyst.=0，IBRxy=0 | | 325 | | mV |
| 采样电阻输入公差/电机电流满量程公差 - 内部参数 | ICOIL | GLOBALSCALER=0 | -5 | | +5 | % |

#### 数字量（直流特性）

| 参数 | 符号 | 条件 | 最小值 | 典型值 | 最大值 | 单位 |
|---|---|---|---|---|---|---|
| 输入电压低电平 | VINLO | | -0.3 | | 0.3 VVIO | V |
| 输入电压高电平 | VINHI | | 0.7 VVIO | | VVIO+0.3 | V |
| 输入施密特触发器磁滞 | VINHYST | | | 0.12 VVIO | | V |
| 输出电压低电平 | VOUTLO | IOUTLO=2mA | | | 0.2 | V |
| 输出电压高电平 | VOUTHI | IOUTHI=-2mA | VVIO-0.2 | | | V |
| 输入漏电流 | IILEAK | | -10 | | 10 | µA |
| 上拉/下拉电阻 | RPU/RPD | | 132 | 166 | 200 | kΩ |
| 数字管脚电容 | C | | | 3.5 | | pF |

### 26.3 热特性

下表将给出热阻相关信息。四层板有助于系统热阻设计。实际的热特性将取决于 PCB 布局、PCB 类型和 PCB 尺寸。热阻将受益于较厚的 CU（内部）层，用于在 PCB 内水平散热。此外，气流将降低热阻。

| 参数 | 符号 | 条件 | 典型值 | 单位 |
|---|---|---|---|---|
| 典型功耗 | PD | StealthChop 或者 spreadCycle，40 或 20kHz 斩波器，24V，内部供电调节器 | 0.6 | W |
| 多层板上与环境的热阻 | RTHJA | 按 JEDEC EIA JESD51-5 与 JESD51-7 定义的两个信号层和两个电源层（2s2p）（FR4，35µm CU，70mm x 133mm，d=1.5mm） | 21 | K/W |
| 到板上的热阻 | RTHJB | 距离封装引脚 1 毫米范围内测量的 PCB 温度 | 8 | K/W |
| 到外壳的热阻 | RTHJC | J 封装的散热片对应的结温 | 3 | K/W |

#### TQFP48-EP 封装的热特性

实际布局中的热阻可以通过芯片待机功耗引起的发热来测试。不接电机时，在电源上看到的所有功率都是芯片产生的。

## 27. 布线考虑

### 27.1 芯片底部焊盘

TMC5160 使用其芯片焊盘将热量从栅极驱动器和线性调节器传输到电路板。为了获得最佳的电气和热性能，请在芯片底部连接焊盘和接地面之间使用适量的过孔。印刷电路板应该有一个地平面，将热量扩散到电路板中，并提供稳定的 GND 参考。

### 27.2 地的布线

TMC5160 的所有信号都参考它们各自的地。将器件下的所有地（GND、GNDP、GNDA 和芯片底部焊盘）相连。芯片连接焊盘正下方的地平面应视为虚拟起点。出于热原因，PCB 顶层应连接到一个大的 PCB 地平面，在 PCB 内散发热量。

注意：将 TMC5160 靠近 MOSFET 桥和采样电阻地，以避免振铃导致地 GND 差异和危险的感应峰值电压。

### 27.3 桥臂电压的布线

电源桥将会以极高的 dI/dt 脉冲形式抽取整个线圈电流。因此，VS 电源滤波器与 MOSFET 之间的任何电感都会导致严重的电压尖峰，这必须避免。避免滤波电容和 MOSFET 开关之间的供电线路出现任何弯曲，并保持尽可能小的距离。特别是对于大电流，建议单独的电源电压平面，并设计足够的电源滤波电容容量。芯片 VS 引脚需另加电容，因为额外的纹波电压会导致电荷泵电容上出现严重的电流尖峰。可以添加一个小串联电阻来避免这种情况。

注意：在 MOSFET 桥附近设置足够的滤波容量，保持电源电压纹波低。

### 27.4 供电滤波

5VOUT 输出电压陶瓷滤波电容（推荐 2.2 至 4.7µF）应尽可能靠近 5VOUT 引脚，其地回路直接通向 GNDA 引脚。此接地不应与其他负载或地平面的额外过孔共享。使用尽可能短和粗的连接。为了获得最佳的微步进性能和最低的斩波噪声，VCC 引脚与 GND 应增加滤波电容，以避免数字部分纹波影响电机电流调节。因此，陶瓷滤波电容（推荐 470nF）要尽可能靠近 VCC 引脚（1-2 毫米距离），GND 返回地平面。VCC 可以使用 2.2Ω 至 3.3Ω 电阻耦合到 5VOUT，以便从 5VOUT 提供数字逻辑，同时保持纹波远离该引脚。100nF 滤波电容器应尽可能靠近 VSA 引脚接地平面。确保 VS 不会因桥臂工作而出现过大的电压尖峰，并在 VS 引脚附近将 100nF 或更大的滤波电容置于 GND。

请仔细阅读第 3.3 章和第 3.4 章，了解关于外部 MOSFET 功率器件和其它器件选择、布线和条件。

### 27.5 布线示例

（图 27.1 布线示例（原理图 TMC5160+MOSFETs），见原数据手册）

布线示例各层：1 顶层（焊接面）；2 内层（地）；3 内层（VS 供电）；4 底层。

提示：在大于 30V 的设计中，如果使用 TQFP 封装，强烈考虑 PCB 涂层以满足足够的爬电距离。

## 28. 封装机械数据

### 28.1 TQFP48-EP 封装尺寸图

（图 28.1 TQFP48-EP 封装尺寸图，与实际比例不符，见原数据手册）

| 参数 | Ref | 最小值 | 正常 | 最大值 |
|---|-----|---|---|---|
| 总高度 | A | - | - | 1.2 |
| 间隙高度 | A1 | 0.05 | - | 0.15 |
| 模具高度 | A2 | 0.95 | 1 | 1.05 |
| 引脚宽度（含镀层） | b | 0.17 | 0.22 | 0.27 |
| 引脚宽度 | b1 | 0.17 | 0.2 | 0.23 |
| 引线框厚度（含镀层） | c | 0.09 | - | 0.2 |
| 引线框厚度 | c1 | 0.09 | - | 0.16 |
| 芯片主体尺寸 X（包含引脚） | D | | 9.0 | |
| 芯片主体尺寸 Y（包含引脚） | E | | 9.0 | |
| 芯片主体尺寸 X | D1 | | 7.0 | |
| 芯片主体尺寸 Y | E1 | | 7.0 | |
| 引脚间距 | e | | 0.5 | |
| 引脚 | L | 0.45 | 0.6 | 0.75 |
| 封装引脚 | L1 | | 1 REF | |
| | θ | 0° | 3.5° | 7° |
| | θ1 | 0° | - | - |
| | θ2 | 11° | 12° | 13° |
| | θ3 | 11° | 12° | 13° |
| | R1 | 0.08 | - | - |
| | R2 | 0.08 | - | 0.2 |
| | S | 0.2 | - | - |
| 芯片底部焊盘尺寸 X | M | 4.9 | 5 | 5.1 |
| 芯片底部焊盘尺寸 Y | N | 4.9 | 5 | 5.1 |
| 封装边缘公差 | aaa | | | 0.2 |
| 引脚边缘公差 | bbb | | | 0.2 |
| 同面性 | ccc | | | 0.08 |
| 引脚偏移 | ddd | | | 0.08 |
| 模具平整度 | eee | | | 0.05 |

### 28.2 QFN-WA 封装尺寸

（图 28.2 wettable QFN 封装尺寸，见原数据手册）

| 参数 | Ref | 最小值 | 正常 | 最大值 |
|---|-----|---|---|---|
| 总高度 | A | 0.8 | 0.85 | 0.9 |
| 间隙高度 | A1 | 0 | 0.035 | 0.05 |
| 模具高度 | A2 | | 0.65 | |
| 引线框高度 | A3 | | 0.203 | |
| 引脚宽度 | b | 0.2 | 0.25 | 0.3 |
| 芯片主体尺寸 X | D | | 8.0 | |
| 芯片主体尺寸 Y | E | | 8.0 | |
| 引脚间隔 | e | | 0.5 | |
| 芯片底部焊盘尺寸 X | J | 6.15 | 6.25 | 6.35 |
| 芯片底部焊盘尺寸 Y | K | 6.15 | 6.25 | 6.35 |
| 引脚长度 | L | 0.35 | 0.4 | 0.45 |
| 引脚长度 | L1 | 0.3 | 0.4 | 0.45 |
| 封装边缘公差 | aaa | | 0.1 | |
| 模具平整度 | bbb | | 0.1 | |
| 同面性 | ccc | | 0.08 | |
| 引脚偏移 | ddd | | 0.1 | |
| 芯片底部焊盘偏移 | eee | | 0.1 | |
| 半切割深度 | R | 0.075 | | |
| 半切割深度 | S | | | 0.075 |

### 28.3 封装代码

| 类型 | 封装 | 稳定范围 | 代码和标记 |
|---|---|---|---|
| TMC5160A-TA | TQFP-EP48 (RoHS) | -40°C … +125°C | TMC5160A-TA |
| TMC5160A-WA | QFN8x8 wettable | -40°C … +125°C | TMC5160A-WA |
| -T | -T 表示卷带包装（订购选项） | -T 表示卷带包装（订购选项） | -T 表示卷带包装（订购选项） |
