e1aco/ELACO_StepMotorTMC5160/AIFirmware/StepMotorDriver_Keil/KNOWLEDGE/TMC5160A/sw-design.md

# 软件设计

> 本文档由 TMC5160A 数据手册"软件 / 功能"章节整理重建：去除重复段落、合并打散的表格、修正断行。所有图、公式请参考原数据手册。

## 目录概览

- 5.5.5 DRV_STATUS – StallGuard2 值和驱动错误标志
- 6. StealthChop™
  - 6.1 参数自调整
  - 6.2 StealthChop 选项
  - 6.3 StealthChop 电流调节器（6.3.1 电流下限）
  - 6.4 基于速度的定标
  - 6.5 StealthChop 和 spreadCycle 两者组合
  - 6.6 StealthChop 的标志位（6.6.1 开路标志 / 6.6.2 PWM_SCALE_SUM 寄存器反应电机状态）
  - 6.7 空转和被动制动
- 7. SpreadCycle 和经典斩波方式
  - 7.1 SpreadCycle 斩波器
  - 7.2 经典恒定关断时间斩波器
- 8. 选择采样电阻
- 9. 基于速度的模式控制
- 10. 诊断和保护（10.1 温度传感器 / 10.2 短路保护 / 10.3 开路诊断）
- 11. 斜坡发生器
  - 11.1 实际单位换算
  - 11.2 运动轮廓（11.2.1~11.2.5）
  - 11.3 速度阈值
  - 11.4 参考开关
- 12. StallGuard2 负载检测
  - 12.1 调整 StallGuard2 阈值 SGT（12.1.1~12.1.4）
  - 12.2 更新速率和滤波器 / 12.3 检测电机堵转 / 12.4 StallGuard 实现归零 / 12.5 操作局限性
- 13. CoolStep 操作
  - 13.1 对用户的好处
  - 13.2 CoolStep 设置
  - 13.3 调节 CoolStep（13.3.1 响应时间 / 13.3.2 低速和静止操作）
- 14. 步进/方向接口
  - 14.1 时序 / 14.2 改变分辨率 / 14.3 MicroPlyer 和静止检测
- 15. DIAG 输出（15.1 脉冲/方向模式 / 15.2 运动控制模式）
- 16. DcStep
  - 16.1~16.6 及 16.6.1 LOST_STEPS / 16.6.2 DCO 接口
- 17. 紧急停止
- 18. 增量编码器 ABN 接口（18.1 编码器时序 / 18.2 设置编码器 / 18.3 闭环）
- 19. 直流电机或螺线管（19.1 螺线管操作）
- 20. 快速配置指南

---

## 5.5.5 DRV_STATUS – StallGuard2 值和驱动错误标志

表：0X6F DRV_STATUS - STALLGUARD2 值和驱动器错误标志

| 位 | 名称 | 功能 | 备注 |
|----|---|---|---|
| 31 | stst | 停止指示 | 此标志表示电机在每个操作模式下处于静止状态。这发生在最后一个步进脉冲之后的 2^20 时钟。 |
| 30 | olb | A 相开路指示 | 1: A 相或 B 相检测到开路。提示： |
| 29 | ola | B 相开路指示 | 这只是一信息。驱动器不做任何操作。电机快速运动和静止时可能会出现错误标志。仅在电机慢速运行时用于开路判断。 |
| 28 | s2gb | B 相短路指示 | 1: A 相或 B 相检测到对地短路。驱动器被禁用。标志保持活动状态，直到驱动器软件 (TOFF=0) 或 ENN 输入恢复。 |
| 27 | s2ga | A 相短路指示 | 1: A 相或 B 相检测到对地短路。驱动器被禁用。标志保持活动状态，直到驱动器软件 (TOFF=0) 或 ENN 输入恢复。 |
| 26 | otpw | 过温预警标志 | 1: 过温预警阈值。两桥臂共用一个过温预警标志。 |
| 25 | ot | 过温标志 | 1: 过温。驱动器会被禁用，直到 IC 冷却到 otpw 被清除。两桥臂共用一个过温标志。 |
| 24 | stallGuard | — | 1: 检测到电机堵转 (SG_RESULT=0) 或 DcStep 模式下的 DcStep 堵转。 |
| 23 | — | — | 忽略 |
| 22 | — | 保留 | — |
| 20:16 | CS | 实际电机电流 / 智能电流 | 实际缩放的电流，监控由寄存器 COOLCONF 设置的电流，或者用于监控电流自动缩放的功能。 |
| 15 | fsactive | 全步有效指示 | 1: 驱动器按设置的斩波模式和速度阈值切换到全步模式。 |
| 14 | stealth | StealthChop 指示 | 1: 驱动器工作在 StealthChop 模式 |
| 13 | s2vsb | B 相对供电电源的短路指示 | 1: A 相或 B 相检测对电源短路。驱动器被禁用。标志保持活动状态，直到驱动器软件 (TOFF=0) 或 ENN 输入恢复。测量中包括采样电阻上的电压跌落！ |
| 12 | s2vsa | A 相对供电电源的短路指示 | 1: A 相或 B 相检测对电源短路。驱动器被禁用。标志保持活动状态，直到驱动器软件 (TOFF=0) 或 ENN 输入恢复。测量中包括采样电阻上的电压跌落！ |
| 11 | — | 保留 | 忽略 |
| 10 | — | 保留 | 忽略 |
| 9:8 | stallguard 2 | 分别为静止状态下的线圈 A 产生 PWM 接通时间，用于电机温度检测 | 机械负载测量：StallGuard2 的结果提供了一种测量机械马达负载的方法。较高的值意味着较低的机械负载。值 0 表示最高负载。在最佳 SGT 设置下，这是电机堵转的指示。堵转检测将 SG_RESULT 与 0 进行比较，以便检测堵转。SG_RESULT 通过将其与可编程上限和下限进行比较，被用作 CoolStep 操作的基础。不适用于 StealthChop 模式。StallGuard2 在微步操作或 DcStep 中特性最好。温度测量：在静止状态下，无法获得 stallguard 2 结果。SG_RESULT 显示了电机线圈 A 的斩波器导通时间。在一定的电流设置下，将电机移动到确定的微步位置，通过按时读取斩波器…（原文此处截断） |

---

## 6. StealthChop™

（图 6.1 StealthChop 电机线圈正弦波电流，用电流探头测量，见原数据手册）

StealthChop 是一种步进电机非常安静工作的斩波模式，基于电压模式 PWM 脉宽调制技术，在静止和低速的情况下，电机绝对无噪音。采用 StealthChop 调制技术的步进电机非常适合于室内和家庭使用，电机在低速时绝对没有振动。StealthChop 采用电压 PWM 技术，通过将有效电压加到线圈中产生电机电流。

增强的 StealthChop 2，驱动器不需要更多配置，参数自调整过程可以自动适应应用以获得最佳性能。允许用户在特殊情况下配置寄存器参数调整设置，或将存储的参数作为参数自整定阶段的初始值。高速应用，最好将 spreadCycle 和 StealthChop 结合使用。

### 6.1 参数自调整

StealthChop 2 集成了参数自调整 (AT) 过程，可自动调整电机最重要的运行参数。通过这种方式，电机在 StealthChop 2 模式下能保持高的动态特性，并支持降低电机供电电压产生非常低的电流。为了获得最佳效果，运动控制器只需执行两个步骤：第一步，上电后，电机处于静止状态，电流设置成运行电流 (AT#1)。第二步，以中等速度运行电机，也可以作为归零的一部分 (AT#2)。图 6.2 显示了这个自调整流程。

#### 自调整和条件

| 步骤 | 参数 | 条件 | 所需长度 |
|---|---|---|---|
| AT#1 | PWM_OFS_AUTO | 电机在静止时候，实际电流 (CS) 与运行电流 (IRUN) 相同。如果使能了电机静止时候电流降低功能，需要初始步进脉冲将驱动器切换回运行电流，或者将 IHOLD 设置成 IRUN。VS 引脚供电在有效工作范围内。注意：驱动器在 AT#1 阶段有可能降低斩波频率，因此可使用减小的静止电流 IHOLD<IRUN，以防止在较低斩波频率下时间过长。 | ≤ 2^20+2*2^18 tCLK，≤ 130ms（内部时钟） |
| AT#2 | PWM_GRAD_AUTO | 以一定的速度运行电机，在该速度下产生一定的反电势，并且可以达到设定的运行电流。条件：1.5*PWM_OFS_AUTO < PWM_SCALE_SUM < 4*PWM_OFS_AUTO；PWM_SCALE_SUM < 255。提示：典型速度范围为 60-300 转/分。 | PWM_GRAD_AUTO 数值每改变 1 的需要 8 个全步时间。一般电机 PWM_GRAD_AUTO 最佳值为 50 或更低的，从 OTP 缺省值 0 开始时，需要 400 个全步 |

（图 6.2 StealthChop 2 自调节步骤，见原数据手册）

**提示：**

- 用评估板确定自动调整的最佳条件。
- 建议在固件中用应用相关的 PWM_GRAD 和 PWM_OFS 作为初始值。
- 监控 PWM_SCALE_AUTO 在 AT#2 参数自调整的恒速阶段下降到零。这表示参数自调整成功。

**注意：**

- 如果没有进行适当参数自调整的情况下操作 StealthChop，会导致减速期间电机产生高电流，尤其在低电阻电机和减速度比较大的情况下。推荐使用评估板完成参数自调整过程，并检查最佳整定条件。建议根据每个电机类型确定 PWM_OFS 和 PWM_GRAD 的初始值。
- 增加一些过电流保护来保护功率管和电源。

#### 已知限制（仅 TMC5160 非 A 版本）

- TMC5160 不能安全检测到自调整 AT#1 阶段的成功完成。它将需要多个电机启动/停止事件来安全地检测完成。
- AT#2 必须成功确定：当 AT#1 尚未完成时，PWM_GRAD 的自调节将不会开始。
- AT#1 和 AT#2 的成功完成只能通过在 AT#2 运动期间监控 PWM_SCALE_AUTO 接近 0 来判别。

**方案 a)：** 在 AT#1 过程中，通过执行一个低速操作完成参数自调整过程，低速需满足每两个脉冲信号之间能检测到静止。使用 8 (6hz) 或更低的速度，在 AT#1 阶段执行至少 10 步。

**方案 b)：** 存储实际应用中 PWM_GRAD_AUTO 的初始参数。因此，根据实际应用中的电机和操作条件，并执行完整的参数自调整过程（参见 a）。保存参数自调整产生的 PWM_GRAD_AUTO 值，并将其用于 PWM_GRAD_AUTO 的初始值。在这个过程中，AT#2 阶段的调整不是必须的，可以省略。参数自调整将进一步优化运行期间的设置。如果需要可结合 a)。

**注意：** 修改 GLOBALSCALER 或 VS 电压会使参数自调整过程的结果无效。下一个 AT#1 阶段开始之前，电机电流调节不能补偿电源的变化。参数自调整只要在以后的操作中完成 AT#1 和 AT#2，就适应变化的条件。

### 6.2 StealthChop 选项

电压 PWM 有效值要根据电机转速调节才能保证电机目标电流。几个因素会影响达到电机目标电流所需的电压值：电机电阻、反电动势（与速度成正比）以及实际供电电压。TMC5160 提供了两种 PWM 调节模式：带电流反馈调节的参数自调整 (AT)（pwm_autoscale=1，pwm_autograd=1）和速度前馈控制模式（pwm_autoscale=0）。速度前馈控制模式不会对电源电压的变化或电机堵转等事件作出反应，但它提供非常稳定的幅值。它不使用也不需要任何电流测量手段。当电机类型和电源电压是已知时，速度前馈控制是完美的。我们推荐自动模式，除非在给定的运行条件下电流调节不满足。

推荐根据实际应用的电机类型和供电设置初始调整参数，此外自动调整模式能对参数变化做出相应，如电机供电或者温度改变。

仅在已知电机和运行条件下考虑速度前馈模式。在这种情况下，需要通过接口进行编程。参数 PWM_GRAD 和 PWM_OFS 可以在参数自调整模式下确定。

根据外部时钟频率，设置分频器参数配置 StealthChop 2 的 PWM 频率。大多数应用的最佳 PWM 调制频率在 20-50KHz 范围内，该频率段平衡了电流纹波、高速与动态功耗的关系。

表 6.1 PWM 频率选择（绿色/浅绿色：推荐）

| 时钟频率 fCLK | %00（2/1024 fCLK） | %01（2/683 fCLK） | %10（2/512 fCLK） | %11（2/410 fCLK） |
|---|---|---|---|---|
| 18MHz | 35.2kHz | 52.7kHz | 70.3kHz | 87.8kHz |
| 16MHz | 31.3kHz | 46.9kHz | 62.5kHz | 78.0kHz |
| 12MHz (internal) | 23.4kHz | 35.1kHz | 46.9kHz | 58.5kHz |
| 10MHz | 19.5kHz | 29.3kHz | 39.1kHz | 48.8kHz |
| 8MHz | 15.6kHz | 23.4kHz | 31.2kHz | 39.0kHz |

### 6.3 StealthChop 电流调节器

在 StealthChop 电压 PWM 模式下，电流自定标功能（pwm_autoscale=1，pwm_auto_grad=1）能自动调节电机电流到所需的电流设置。电流自定标用作参数自调整 (AT) 的一部分，可以跟踪电机参数的变化。芯片在斩波器导通时间内测量电机电流，通过比例调节器调节 PWM_SCALE_AUTO，以使电机电流与目标电流匹配。PWM_REG 是该调节器的比例系数。通常，比例系数应当尽可能小以满足稳定和软调节性能高的要求，但是比例系数必须足够大能快速跟随电机目标电流的变化（例如 VREF 的变化）。在参数自调整的第二步 AT#2，PWM_REG 同时补偿电机速度的变化。因此，AT#2 期间的加速度越高，PWM_REG 设置需要随之增大。用户需要根据系统选择归零适合的速度和加速度，通常来说电流自定标比例调节寄存器的最小设置是足够的（PWM_REG=1）。

PWM_REG 设置应根据所需的最快加速度和减速度优化（比较图 6.3 和图 6.4）。监测加速阶段电机电流，如图 6.5 所示，可以判断 AT#2 阶段设置的 PWM_REG 以及参数自调整过程（或者非自定标过程 PWM_OFS 和 PWM_GRAD）参数是否适合。

- （图 6.3 示波器：PWM_REG 优化设置，见原数据手册）
- （图 6.4 示波器：在 AT#2 期间，PWM_REG 的设置太小，见原数据手册）
- （图 6.5 成功确定了 PWM_GRAD (_AUTO) 和 PWM_OFS (_AUTO)，见原数据手册）

**快速启动：** 有关快速启动的信息，请参阅第 20 章中的快速配置指南。

#### 6.3.1 电流下限

StealthChop 电流调节过程需要一个最小电流值保证电机电流调节。StealthChop 电流调节只能在斩波开通阶段通过采样电阻测量线圈电流，因此允许线圈电流调节的最小电流由 TBL 设置的消隐时间及斩波频率决定。在 StealthChop 电流自定标模式下，电机线圈的最小电流随电机供电电压和斩波频率增加而增加。较低的消隐时间允许较低的电流最小值。在 AT#1 中，PWM_OFS_AUTO 非常重要，能控制由采样电阻、GLOBALSCALER 和 IRUN 设置的运行电流很好地在调节范围内。更低的电流（例如静止态的自动降电流）是通过自动定标模式下的 PWM_OFS_AUTO 和 PWM_GRAD_AUTO 参数或者是非自动定标模式下的 PWM_OFS 和 PWM_GRAD 参数自动实现。空转选项允许电机电流为零。

StealthChop 2 参数自调整中的电机线圈电流下限：

（公式：ILowerLimit 下限计算，见原数据手册）

VM 电机供电电压，RCOIL 电机线圈电阻。

I Lower Limit 可以看成是 IRUN 最小运行电流（拇指值），如果电流最小值不足以达到所需设置，则芯片在 AT#1 中且仅在 AT#1 中切换成较低斩波频率重试。

fPWM 是 PWM_FREQ 设置的斩波频率。在参数自调整 AT#1 阶段，如果驱动器无法达到电流，驱动器会尝试更低的斩波频率（大致为一半频率）。电流比例 CS=IRUN 情况下，频率将在电机静止时保持有效。静止状态减小电流的过程很短。

**示例：** 电机线圈电阻 5 欧姆，供电电压 24V。设置 TBL=%01，PWM_FREQ=%00，tBLANK 为 24 个时钟周期，fPWM 是 2/(1024 时钟周期)：

（公式：见原数据手册）

这意味着，即在考虑相关因素情况下，参数自调整过程所需的电机目标电流必须是 225mA 及以上。GLOBALSCALER 修改电机电流的也要满足电流限制的条件。

**注意：** 参数自调整过程要满足较低的线圈电流限制条件。参数自调节 AT#1 过程中的电机电流必须超过此下限。可以使用电流探头测量或根据参数计算 ILOWER LIMIT。在成功的完成参数自调节之后，IRUN 或 IHOLD 设置可以低于电流下限。

最小电流同时也限制了驱动器对 GLOBALSCALER 变化的响应能力。

### 6.4 基于速度的定标

基于速度的调节输出电压模式检测相邻两步之间的时间（即以时钟周期为单位的 TSTEP）标定 StealthChop 的幅值。这个模式没有电流调节回路，因此不需要测量电流。通过串口编程设置 pwm_autoscale=0 使能该模式。基本思想是电机输入的电压和电机目标电流线性近似。步进电机具有一定的线圈电阻，根据基本公式 I=U/R，一定的电压幅值能产生对应的电流。R 为电机线圈电阻，U 为 PWM 调节输出的电压，I 为电机线圈上驱动电流。

PWM_OFS 值计算如下：

（公式：PWM_OFS 计算，见原数据手册）

VM 为电机供电电压，ICOIL 目标均值电流。

有效的 PWM 电压 UPWM（峰值的 1/SQRT(2)）是由 PWM 幅值寄存器 PWM_SCALE 的分辨率（8 位）和内部正弦波 LUT 表峰值（248）计算得出：

（公式：UPWM 计算，见原数据手册）

电机反电势电压随着电机速度增加，和转速成正比。反电势降低了线圈电阻上的有效 PWM 电压，电流减小。TMC5160 提供了第二个与速度相关寄存器 (PWM_GRAD) 对此进行补偿。此模式下的总有效 PWM 幅值 (PWM_SCALE_SUM) 根据微步频率计算公式为：

（公式：PWM_SCALE_SUM 计算，见原数据手册）

- fSTEP：等效的 256 微步频率
- fCLK：TMC5160 的外部时钟频率或芯片内部频率

电源电压中减去反电势电压，有效电流幅度减小。可以计算 PWM_GRAD 的近似值：

（公式：PWM_GRAD 近似值计算，见原数据手册）

- CBEMF：电机反电势系数，单位为伏特/弧度/秒。
- MSPR 是电机旋转一圈的微步数，例如 51200 = 256(微步)*200（1.8° 电机对应的全步数）。

（图 6.6 基于速度的 PWM 定标（pwm_autoscale=0），见原数据手册）

**提示：**

- 可通过示波器的电流探头测量电机电流进一步优化 PWM_OFS 和 PWM_GRAD。
- 也可以通过参数自调整从寄存器 PWM_OFS_AUTO 和 PWM_GRAD_AUTO 读出。

#### 了解电机的反电势系数

反电势系数是电机以一定速度转动时产生的电压。电机规格书通常不列出此值，可从电机转矩和线圈电流额定值中计算得到。在标准国际单位制 (SI) 中，反电势常数 CBEMF 的数值和转矩常数的数值是一致。转矩常数为 1 Nm/A 的电机将具有 1V/rad/s 的反电势系数，用 1 rps（1 rps=每秒 1 转=6.28 弧度/秒）转动，电机产生 6.28v 的反电势电压。因此，反电势系数可以计算为：

（公式：CBEMF 计算，见原数据手册）

- ICOILNOM：保持转矩下电机的额定相电流
- HoldingTorques：电机特定的保持转矩，即在两个线圈上电流为 ICOILNOM 达到的转矩。转矩单位为 [Nm]。1Nm = 100Ncm = 1000mNm。
- 电压是每个线圈的均值有效电压，因为电流在全步位置，两相都通电流，因此在该公式中，系数乘以 2。

### 6.5 StealthChop 和 spreadCycle 两者组合

spreadCycle 在高速运行更稳定，因此更适合高速运动的应用。为了将无噪音与最高的动态性能相结合，可以设置速度阈值将 spreadCycle 和 StealthChop 结合在一起（图 6.7）。StealthChop 只在低于这个速度阈值时有效。

（图 6.7 切换到 spreadCycle 的速度阈值 TPWMTHRS，见原数据手册）

第一步，两种斩波原理都应独自设置和优化。再确定切换速度。低速精密定位采用 StealthChop，高动态运动采用 SpreadCycle。TPWMTHRS 寄存器为切换速度。电机以所需速度移动时，用户读出 TSTEP，并将结果值编程为 TPWMTHRS。使用较低的切换速度以避免切换点处的跳动。

高速切换时会发生跳动，电机的反电动势电压（随速度升高）导致电机电压和电流之间的相移高达 90°。因此，当在电压 PWM 和电流 PWM 模式之间以较高速度切换时，跳动不断增加，高冲击可能产生瞬间过电流（取决于电机线圈电阻）。大多数电机，低速（例如 1rpm 至几十 rpm）时的冲击影响可以完全忽略。因此，在选择 TPWMTHRS 时应考虑这种跳变。如果您只想使用 StealthChop，请将 TPWMTHRS 设置为零。

第一次使能自动电流调节 StealthChop 模式时，电机必须处于静止状态，以便进行电流调节。当驱动器以较高速度切换到 StealthChop 时，StealthChop 逻辑存储之前的电流调节设置，直到电机再次返回到较低速度。这样电机返回到较低速度时 StealthChop 重新使能，调节器具有已知的起始点，调用之前参数。当斩波器切换到不同模式时，速度阈值和电源电压在模式切换期间都不要显著改变，否则电机可能失步或者导致瞬时电流过高或过低变化。

电机堵转或速度的突然变化可能导致驱动器检测到短路或自动电流调节状态，该状态不能自恢复。清除错误标志并从零速度重新启动电机，才可恢复。

**提示：** 第一次使能 StealthChop 需要电机处于静止状态，需要保持停止状态至少 128 个斩波周期以允许 StealthChop 完成静止电流控制初始控制。

### 6.6 StealthChop 的标志位

StealthChop 电压模式驱动，因此与电流测量相关的状态标志响应较慢，驱动器对反电势的突然变化的响应被延迟，例如电机堵转。

**注意：** StealthChop 操作期间，电机堵转或突然停止运动可导致过流。在几十毫秒的时间里，电机电流增大的幅值与之前电机运行速度和线圈电阻有关。低速度的反电动势仅是电源电压的一小部分，不存在触发短路报警的危险。

**提示：** 使用 StealthChop 时，需要调整低端驱动器过电流检测，以便在电机堵转时触发保护系统。避免从电源得到能量产生高电流。

#### 6.6.1 开路标志

StealthChop 模式中的状态信息不同于周期调节的 spreadCycle 模式。OLA 和 OLB 表明电流是否在对应的线圈上达到目标电流。

- OLA 或 OLB 标志的跳变可能是采样电阻或电机线圈的不对称引起。
- 电机线圈导线松掉会导致持续有效的开路标志。
- 如果电流调节在最后几个全步中未成功地按比例增加到目标电流（因为没有连接电机或超过 PWM 限制的高速），则一个或两个标志都处于活动状态。

如果需要，spreadCycle 斩波中进行可靠的开路测试。采用 StealthChop 斩波技术，可以检测 PWM_SCALE_SUM，对应正确的线圈电阻。

#### 6.6.2 PWM_SCALE_SUM 寄存器反应电机状态

PWM_SCALE_SUM 可反映有关电机状态的信息。由于此参数反映了驱动目标电流所需的实际电压，与几个因素相关：电机负载、线圈电阻、电源电压和电流设置。因此，PWM_SCALE_SUM 的幅值大小反应了电机的工作状态。当达到极限值 (255) 时，电流调节器不能完全维持电机电流，比如电源电压跌落。

### 6.7 空转和被动制动

StealthChop 提供了电机静止的不同选项。设置静止电流 IHOLD 为零和相应的 FREEWHEEL 参数使能不同的静止状态。所需选项在 TPOWERDOWN 和 IHOLDDELAY 设定的时间段有效。一旦电机目标电流为零电流，电流调节就会冻结，以确保快速启动。通过 freewheeling 选项，可以实现空转和被动制动。被动制动是电机的涡流制动，线圈中没有驱动电流，因此消耗的能量最小。然而，当施加连续扭矩时，电机可以缓慢运动。

**提示：** 应在您的应用中运行电机调试 StealthChop 性能。马达性能通常在带负载的情况下更好，因为可防止马达在没有负载的情况下可能发生的机械振荡而造成的堵转。

表：STEALTHCHOP 相关参数

| 参数 | 描述 | 设置 | 备注 |
|---|---|---|---|
| en_spread_cycle | 禁用 StealthChop（寄存器 GCONF） | 0: 使能 StealthChop；1: 禁止 StealthChop | — |
| TPWMTHRS | 指定 StealthChop 操作的最高速度。按照所需阈值速度运行时，读出 TSTEP 设置（两个微步之间的时间） | 0…1048575 | TSTEP 小于 TPWMTHRS 时 StealthChop 无效 |
| PWM_LIM | 用于限制从 spreadCycle 切换到 StealthChop 时引起的过冲。减小该值产生较低的电流冲击 | 0…15 | 8 位幅值限幅的高 4 位（缺省 12） |
| pwm_autoscale | 使能带电流测量的自定标模式，0 为速度前向控制模式 | 0: 速度前向控制模式；1: 带电流测量的自调节模式 | — |
| pwm_autograd | 使能 PWM_GRAD_AUTO 自调整 | 0: 禁用，调用寄存器的 PWM_GRAD 参数；1: 使能 | — |
| PWM_FREQ | PWM 频率选择。一般最低的设置结果最佳。在每个斩波器输出处测量的频率是有效斩波器频率 fPWM 的一半 | 0: fPWM=2/1024 fCLK；1: fPWM=2/683 fCLK；2: fPWM=2/512 fCLK；3: fPWM=2/410 fCLK | — |
| PWM_REG | 用户定义的 PWM 幅度调节比例系数，当 pwm_autoscale=1 时，比例系数越高代表调节速度越快 | 1…15 | 每全步 PWM_SCALE_AUTO 调节器调节 0.5 到 7.5 步 |
| PWM_OFS | 速度前向调节模式下用户定义的 PWM 幅度（偏移量），也是参数自调整阶段 PWM_OFFS_AUTO 初始值 | 0…255 | PWM_OFS=0 禁用电流线性调节 |
| PWM_GRAD | 速度前向调节模式下用户定义的 PWM 幅度（梯度），也是参数自调节阶段 PWM_GRAD_AUTO 的初始值 | 0…255 | — |
| FREEWHEEL | 当电机电流设置为零 (IHOLD=0) 时，静止选项。仅在使能 StealthChop 时有效。飞轮选项电机易于移动，两个线圈短路选项对应被动制动 | 0: 正常操作；1: 空转；2: 使能低端功率管；3: 使能高端功率管 | — |
| PWM_SCALE_AUTO | 电流调节器确定的实际 StealthChop 斩波电压 PWM 修正值。在参数自整整阶段调节应接近 0 | -255…255 | （只读）在 spreadCycle 中操作时，该值将冻结 |
| PWM_GRAD_AUTO / PWM_OFS_AUTO | 参数自调整阶段 PWM_OFS 和 PWM_GRAD 的返回值，或者是 PWM_OFS 和 PWM_GRAD 初始值的确定 | 0…255 | （只读） |
| TOFF | 电机驱动器使能，实际值不影响 StealthChop 性能 | 0: 驱动器输出禁止；1…15: 驱动器输出使能 | — |
| TBL | 比较器消隐时间。该时间应大于功率管开关事件和采样电阻上振铃的持续时间。典型应用一般设置 1 或 2。对于较高的电容性负载，可能需要 3。较低的设置允许 StealthChop 调节到较低的线圈电流值 | 0: 16 tCLK；1: 24 tCLK；2: 36 tCLK；3: 54 tCLK | — |

---

## 7. SpreadCycle 和经典斩波方式

相对于 StealthChop 的电压 PWM 斩波控制，spreadCycle 是周期电流控制模式。因此，可以对电机速度或电机负载的变化作出极快的反应。spreadCycle 对电机两相线圈的电流进行斩波控制，两相斩波控制彼此独立。图 7.1 显示了不同的斩波阶段：

（图 7.1 斩波器不同阶段，见原数据手册）

仅通过导通阶段和快衰减阶段可完成电流调节，但是插入慢衰减阶段对于减小电机中的电损耗和电流纹波是重要的。慢衰减阶段的持续时间由控制参数设定，同时设置了斩波频率的上限。电流比较器在电流流过采样电阻期间测量线圈电流，但是在慢衰减阶段不测量线圈电流，因此慢衰减阶段由定时器终止。当通过线圈的电流达到目标电流时，比较器终止导通阶段。快衰减阶段可由比较器或另一定时器终止。

当切换线圈电流时，由于寄生电容的充放电，在采样电阻上出现电流尖峰。在此期间，通常为 1 或 2 微秒，无法测量电流。消隐参数是对电流比较器的输入进行屏蔽以阻止这些尖峰。

有两种周期斩波模式可用：一种称为 spreadCycle 新的高性能斩波算法和一种经验验证过的恒定关断时间斩波模式。恒定关断时间模式循环有三个阶段：导通、快衰减和慢衰减。spreadCycle 模式循环有四个阶段：导通、慢衰减、快衰减和第二慢衰减。

斩波频率是电机驱动器斩波控制的重要参数。太低频率可能会产生可听噪声。较高的频率会降低电机中的电流纹波，但频率过高会导致磁损耗上升。此外，由于引起动态功耗的切换斜率的影响增加，驱动器中的功率随着频率的增加而增加。因此，需要找到折衷办法。大多数电机最佳工作的调制频率为 16 kHz 到 30 kHz。斩波频率受多个参数设置、电机电感和电源电压的影响。

**注意：** 对于大多数电机而言，spreadCycle 调制的最佳斩波频率为 16 kHz 至 30 kHz。较高的频率导致开关损耗增加。

（图：斩波时序示意，见原数据手册）
（图：见原数据手册）

三个参数用于控制两种斩波模式：

| 参数 | 描述 | 设置 | 备注 |
|---|---|---|---|
| TOFF | 设置慢衰减时间（关闭时间）。此设置还限制了最大斩波频率。此参数在 StealthChop 模式下无效，但需要它使能电机，因此该参数任何设置都可以。将此参数设置为零将完全禁用所有驱动晶体管，电机可以自由转动 | 0: 斩波器关断；1…15: 关断时间设置 NCLK=12+32*TOFF（最小消影时间 24 个时钟周期情况下设置 1 能满足应用） | — |
| TBL | 选择比较器消影时间。该时间需要安全地大于开关事件和采样电阻上振铃的持续时间。对于大多数应用，设置为 1 或 2。对于高电容负载，例如当使用滤波器网络时，需要设置 2 或 3 | 0: 16 tCLK；1: 24 tCLK；2: 36 tCLK；3: 54 tCLK | — |
| chm | 斩波器模式选择 | 0: spreadCycle；1: 传统固定关断时间 | — |
| TPFD | 在桥臂极性改变后增加被动快衰减时间。电机出现中速振荡时，从 0 开始增加该参数 | 0…15 | 快衰减时间，128 个时钟的倍数（128 个时钟大约为 10μs） |

### 7.1 SpreadCycle 斩波器

SpreadCycle（专利）斩波算法是一种精确且简单的斩波模式，可自动确定快衰减阶段的最佳长度。即使使用默认设置，spreadCycle 也将提供卓越的微步质量。有几个参数可用于优化斩波器的应用。

每个斩波周期由导通阶段、慢衰减阶段、快衰减阶段和第二慢衰减阶段组成（见图 7.3）。两个慢衰减相位和每个斩波周期的两个消隐时间为斩波频率设置了上限。慢衰减阶段通常占静止斩波周期的约 30%-70%，并且对于降低电机和驱动器功耗是重要的。

慢衰减时间 TOFF 的起始值计算：

**示例：** 斩波器目标频率 25kHz。假设：两个慢衰减周期占总斩波周期时间的 50%。

**TOFF 设置：**

- 12 MHz 时钟设置 TOFF=3.4，即 3 或 4。
- 16 MHz 时钟设置 TOFF=4.6，即 4 或 5。

磁滞起始值引入了驱动器电机线圈的最小电流纹波。电流纹波必须高于由电机中的电阻损耗引起的电流纹波，以便给出最佳的微步效果。斩波器能根据磁滞设置精确地调节电流的上升和下降以跟随目标电流。磁滞参数设置引入的电机线圈电流纹波所需的时间降低了斩波频率。因此，较高的磁滞宽度将导致较低的斩波频率。电机电感限制斩波器跟随电机电流变化的能力。此外，导通阶段和快衰减阶段的持续时间必须大于消隐时间，因为在消隐期间不使能电流比较器。

为找到最佳设置，通常从一个低的磁滞设置（例如 HSTRT=0，HEND=0）开始，逐渐增加 HSTRT，直到电机在低速设置下平稳运行。可通过测量电流探头或采样电阻上电压测量电机电流时来更好的检查这一点（参见图 7.2）。如果磁滞设置太小，正弦波的两个半波零点附近的之间有小的畸变。在中速（即每秒 100 至 400 步）时，滞环设置过小将导致电机嗡嗡声和振动增加。

（图 7.2 磁滞设置良好，电流波形中没有突出部分（紫红：电流 A，黄和蓝：采样电阻上电压 A 和 B），见原数据手册）

过高的滞环设置将导致斩波频率降低和斩波噪声增加，同时不会对波形产生任何益处。

**快速入门：** 请参阅第 20 章中的快速配置指南快速入门。

TOFF 计算公式：

（公式：TOFF = (tOFF·fCLK - 12)/32，见原数据手册）

详细调试步骤，请参阅应用笔记 AN001 spreadCycle 参数调整。

按照实验经验，该设置与电机基本无关，较高电流的电机通常也具有较低的线圈电阻，因此磁滞低到中的默认值（例如，有效滞环=4）通常适合大多数应用。可以通过实验对电机进行优化设置：设置过低则微步精度降低，而设置过高则斩波噪声和电机功耗增加。用示波器测量线圈在中等电流下电机静止时的采样电阻电压，过低的设置会显示快衰减阶段小于消隐时间。快衰减时间比消隐时间稍长是最佳设置。如果难以达到要求，则可以减少 TOFF 设置。

磁滞控制在某些情况下可能会让斩波频率变得过低，例如当线圈电阻在电源电压供电下相对比较高时。可将磁滞设置分为开始设置 (HSTRT+HEND) 和结束设置 (HEND) 来避免。自动滞环递减器 (HDEC) 在开始设置和结束设置之间进行插值，每 16 个系统时钟逐步递减磁滞值。在每个斩波周期开始时，滞环起始点是以开始值和结束值的总和 (HSTRT+HEND)，并递减，直到斩波周期结束或达到滞环结束值 (HEND)。这样，在高幅度和低电源电压的情况下，如果频率变得太低，可以通过以上设置稳定斩波频率。避免了产生人耳可听见的频率点。

（图 7.3 spreadCycle 斩波器的不同斩波阶段的线圈电流，见原数据手册）

两个参数控制 spreadCycle：

| 参数 | 描述 | 设置 | 备注 |
|---|---|---|---|
| HSTRT | 磁滞开始设置。此值是磁滞结束参数 HEND 的偏移量 | 0…7 | HSTRT=1…8 该值加到 HEND 上 |
| HEND | 磁滞结束参数。此值是经过多次递减后的磁滞结束参数。需满足 HSTRT+HEND≤16。电流设置 30（幅度减小到 240）以下，总和不限 | 0…2: -3…-1 负 HEND；3: 0 HEND；4…15: 1…12 正 HEND | — |

当 HSTRT=0 和 HEND=0 时，磁滞为 0，即关断。

**示例：** 选择滞环宽度为 4。您可能决定不使用滞环递减 (HDEC)。在这种情况下，请设置：

- HEND=6（设置有效磁滞结束值 6-3=3）
- HSTRT=0（设置最小有效磁滞值，即 1：3+1=4）

为了体现可变滞环的优势，我们可以将大部分值设置为 HSTRT，即 4，而剩余的 1 设置为磁滞结束值。对应的配置寄存器值如下：

- HEND=0（设置有效磁滞结束值 -3）
- HSTRT=6（设置有效滞环结束值 +7 对应的滞环起始值：7-3=4）

**提示：** 将 TOFF 设置为 2 或 3 及 TBL 设置为 2 或 1 可让电机运行速度更高。

### 7.2 经典恒定关断时间斩波器

经典的恒定关断时间斩波器是 spreadCycle 的替代方案。在参数调节后，同样也有良好的性能。在 DcStep 的全步操作中，系统会与经典恒定关断时间斩波器（自动）结合工作。

经典的恒定关断时间斩波器在每个导通阶段之后采用固定时间快衰减。导通阶段的持续时间由斩波比较器确定，但是快衰减时间需要足够长来让驱动器跟随正弦波的下降斜率，但太长增加电机电流纹波和功耗。可以使用示波器或评估不同速度下的电机平滑度来调节。起始设置建议将快衰减时间设置与慢衰减时间设置相同。

（图 7.4 带偏移量的经典固定关断时间每个阶段电流波形，见原数据手册）

调整快衰减时间之后，应该调整偏移参数以获得平滑的过零点。这是必要的，因为快衰减阶段使电机电流的绝对值低于目标电流（见图 7.5）。如果零点偏移太低，则电机在电流过零点期间静止片刻。如果设置得太高，则会产生较大的微步。通常，需要正偏移设置完成平滑操作。

（图 7.5 经典斩波模式的过零及正弦波偏移校正，见原数据手册）

三个参数控制恒定关断时间模式：

（图：见原数据手册）

| 参数 | 描述 | 设置 | 备注 |
|---|---|---|---|
| TFD (fd3 & HSTRT) | 快衰减设置。CHM=1，控制每个斩波周期的快衰减部分 | 0: 仅慢衰减；1…15: 快衰减阶段时间 | — |
| OFFSET (HEND) | 正弦波偏移量。CHM=1，控制正弦波的偏移量。正偏移设置可以校正过零误差 | 0…2: 负的偏移量 -3…-1；3: 没有偏移量 0；4…15: 正的偏移量 1…12 | — |
| disfdcc | 选择使用电流比较器来终止快衰减周期。如果使能电流比较器，则在电流达到比实际电流更高的负值的时候结束快衰减 | 0: 使能比较器结束快衰减阶段；1: 定时器结束快衰减阶段 | — |

---

## 8. 选择采样电阻

TMC5160 提供了几种设置电机电流的方法：采样电阻、GLOBALSCALER 和电流定标器 CS。

要驱动电机，请先选择采样电阻，该值应满足或略超过定标参数 CS 最大设置产生的最大电流。

8 位全局定标器 GLOBALSCALER 对电机电流细微调整。

电机驱动电流由 5 位定标器（实际定标参数可通过 CS 读取）设置，由 CoolStep、运行和保持电流 (IRUN、IHOLD) 调节控制。CS 设置与 TRINAMIC 其它芯片兼容。

采样电阻选择适当的值设置所需的最大电机电流。下表是标准电阻值对应的 RMS 均值电流。

表：R_SENSE 的阻值和 GLOBALSCALER=255 时对应的最大电机电流

| R_SENSE [Ω] | RMS 电流 [A]（CS=31） | 正弦波峰值电流 [A]（CS=31） |
|---|---|---|
| 0.22 | 1.1 | 1.5 |
| 0.15 | 1.6 | 2.2 |
| 0.12 | 2.0 | 2.8 |
| 0.10 | 2.3 | 3.3 |
| 0.075 | 3.1 | 4.4 |
| 0.066 | 3.5 | 5.0 |
| 0.050 | 4.7 | 6.6 |
| 0.033 | 7.1 | 10.0 |
| 0.022 | 10.6 | 15.0 |

因为电机电流全部流过采样电阻，所以应仔细选择采样电阻。斩波操作会导致采样电阻上有来自 MOSFET 桥的脉冲电流。低电感采样电阻，例如薄膜电阻或 CCR（碳晶实芯）电阻，能有效抑制电压尖峰引起的振铃，从而避免不稳定的测量结果。此外，低电感、低电阻 PCB 布局也是必不可少的。最好采用大面积的地平面。另请参阅第 27 章中的布局注意事项。

采样电阻阻值决定了上限电流，软件寄存器 IRUN、IHOLD 和 GLOBALSCALER 设置所需的电流值。一般在最大电流设置（GLOBALSCALER=0，IRUN=31）情况下按照所需的最大电流（或稍多一些）选择采样电阻值。

### RMS 电流的计算

（公式：电机电流瞬时值计算，见原数据手册）

- GLOBALSCALER：全局电流定标器，0 对应满量程 (256)。
- CS：IHOLD、IRUN 和 CoolStep 设置对应的当前电流定标值。
- VFS：满量程电压（请参考电气参数 VSRT）。
- CURA/B：内部正弦表中对应的电流值。
- 248：内部正弦表的幅值。

在电机静止状态下，线圈峰值电流可能全部流过采样电阻，除非降低待机功率。在正常情况下，采样电阻上的电流小于线圈 RMS 电流，因为在慢衰减阶段期间没有电流流过采样电阻。

### 采样电阻峰值功耗的计算

**提示：** 为了获得最佳的电流设置精度，建议在应用中测量电机电流并微调。根据所需的最大电机电流，选择下一档位的采样电阻。将 IRUN 设置为 31，对应于所需电机电流的 100%，再通过 GLOBALSCALER 微调电机电流。

**注意：**

- 采样电阻的布线需要对称，等长和紧凑。选择匹配适合的采样电阻可确保最佳性能。
- 大面积接地平面的紧凑布局能有效避免寄生电阻效应。

（公式：采样电阻峰值功耗计算，见原数据手册）

表：电流定标参数

| 参数 | 描述 | 设置 | 备注 |
|---|---|---|---|
| IRUN | 电机运行时的电流定标值。根据内部正弦波表调整线圈电流值。对于高精度电机操作，请使用 16 到 31 范围内的电流定标因子，因为缩小电流值会使查表微步长变粗，从而降低有效微步长分辨率。此设置也对应着 CoolStep 操作的最大电流值 | 0…31 | 定标因子 1/32, 2/32, … 32/32 |
| IHOLD | 与 IRUN 原理相同，代表电机静止情况下的电流 | 0…31 | 定标因子 1/32, 2/32, … 32/32 |
| IHOLDDELAY | 保证从运行电流减小到保持电流的整个过程的平稳性。IHOLDDELAY 控制了电机在 TZEROWAIT 之后电流减小对应的时间：0：立即降电流；1..15：电流每减小 1 步对应的时间延迟，单位为 2^18 时钟周期。示例：如果 IRUN=31、IHOLD=16，那么从 IRUN 到 IHOLD 过程需要 15 步电流减小的过程。IHOLDDELAY 设置为 4，则对应的总的电流减小时间为 4*15*2^18 时钟周期，在 16MHz 频率下，大约需要 1 秒 | 0: 立即 IHOLD；1…15: 每 1×2^18…15×2^18 时钟电流衰减 1 | — |
| GLOBALSCALER | 允许对电机电流进行精细控制 | 0…255 | 按 1/256 的步长定标，0=满量程 |

---

## 9. 基于速度的模式控制

TMC5160 支持不同的斩波模式和操作模式，以实现最佳电机控制。根据电机负载的不同，不同的模式可以优化为最低噪声 & 高精度、最高动态或最高速度下的最大扭矩。某些功能，如 CoolStep 或 Stallguard2，在一定的速度范围内是有用的。在需要宽速度范围的应用中可组合多个速度阈值实现不同的操作模式。

（图 9.1 速度控制模式的选择，见原数据手册）

图 9.1 显示所有可用阈值和顺序。VPWMTHRS、VHIGH 和 VCOOLTHRS 由寄存器参数 TPWMTHRS、THIGH 和 TCOOLTHRS 确定。每两个步进脉冲之间的时间间隔 TSTEP 表示速度。在外部脉冲输入时对应电机速度。TSTEP 单位统一按照 256 微步计算。这样，当微步分辨率改变时，不必调整阈值。阈值表示相同的电机速度，与微步设置无关。TSTEP 与这些阈值进行比较选择斩波模式或工作状态。磁滞宽度可以设置成 1/16 TSTEP 或者 1/32 TSTEP，以避免在 TSTEP 测量中外部干扰造成比较结果的不停切换。开关阈值速度因磁滞宽度的设置分别提高了 1/16 或者 1/32。StealthChop 阈值 TPWMTHRS 没有显示，它应满足 VPWMTHRS < VCOOLTHRS。根据静止标志位置 stst，电机电流为运行电流和静态保持电流。

使用自动速度阈值可以针对不同的速度范围调整应用程序。CoolStep 等功能在设置中完全透明。这样，一旦参数化，它们就不需要通过软件进行激活。

表：速度阈值参数

| 参数 | 描述 | 设置 | 备注 |
|---|---|---|---|
| stst | 电机静止标志。最后一个脉冲之后的 2^20 个时钟后有效 | 0/1 | 只读，状态位 |
| TPOWERDOWN | 电机停止 (stst) 到电流调整降电流的延迟时间。时间范围约为 0 至 4 秒 | 0…255 | 2^18 时钟周期的倍数对应的时间 |
| TSTEP | 脉冲输入引脚的两个 256 细分脉冲之间的实际测量时间，单位为 1/fCLK。测量最大值为 (2^20)-1 | 0…1048575 | 状态寄存器，只读。实际测量步长时间（以 tCLK 的倍数表示） |
| TPWMTHRS | TSTEP ≥ TPWMTHRS：如果配置 StealthChop，则 StealthChop PWM 使能；DcStep 关闭 | 0…1048575 | StealthChop 操作的上限速度阈值 |
| TCOOLTHRS | TCOOLTHRS ≥ TSTEP ≥ THIGH：如果配置 CoolStep，则 CoolStep 使能；StealthChop 电压 PWM 模式关闭。TCOOLTHRS ≥ TSTEP：如果已配置，堵转停止，stall 输出信号有效 | 0…1048575 | CoolStep 和 stallGuard 的最低速度阈值 |
| THIGH | TSTEP ≤ THIGH：CoolStep 不使能（电机按照正常电流定标器运行）；StealthChop 模式不使能；如果 vhighchm 设置，斩波器切换成 chm=1，TFD=0，对应只有慢衰减的固定关断时间的斩波模式；如果 vhighfs 设置，电机进入全步状态，停止检测切换到 DcStep 停止检测 | 0…1048575 | CoolStep 和 StallGuard 速度阈值及可选的高速全步操作的速度阈值 |
| small_hysteresis | 步进频率信号磁滞宽度 | 0: 1/16 磁滞宽度；1: 1/21 磁滞宽度 | (TSTEP*15/16)-1 为 TSTEP 的较低速度阈值，(TSTEP*31/32)-1 为 TSTEP 的较高速度阈值 |

表：高速 / 斩波模式切换标志

| 参数 | 描述 | 设置 | 备注 |
|---|---|---|---|
| vhighfs | 当速度超过 VHIGH 时，使能全步。切换仅发生在 45° 位置。全步目标电流使用 45° 位置的微步表中的电流值 | 0: 不切换到全步；1: 高速切换到全步 | — |
| vhighchm | 当速度超过 VHIGH 时，此位使能切换到 chm=1 和 fd=0。这样，可以获得更高的速度。可以与 vhighfs=1 相结合。如果设置，则 TOFF 设置在高速操作期间自动加倍，以避免斩波频率加倍 | 0: 斩波模式不变化；1: 高速运行经典的固定关断斩波模式 | — |
| en_pwm_mode | StealthChop 电压 PWM 使能标志（取决于速度阈值）。必须在电机静止时候使能 | 0: 不使能 StealthChop；1: VPWMTHRS 速度阈值下使能 StealthChop | — |

---

## 10. 诊断和保护

TMC5160 提供一整套诊断和保护功能，如短路保护和欠压检测。开路负载检测允许测试电机线圈连接是否断开。有关详细信息，请参阅 DRV_STATUS 表。

### 10.1 温度传感器

驱动器集成了四级温度传感器（120°C 预警和可选的 136°C/143°C/150°C 热关断），用于诊断和保护 IC、功率 MOSFETs 和相邻组件避免过热。选择过温级别以安全覆盖错误情况，如缺少热对流。热量主要由功率 MOSFETs 产生，并且在增加的电压下由内部电压调节器产生。对于许多应用，过温预警已经指示异常操作情况，并且可以用于启动用户预警或功率降低措施，例如电机电流降低。温度关断只是一种应急措施，应通过设计防止温度上升到关断水平。

触发过温传感器 (ot 标志) 后，驱动器保持关闭状态，直到系统温度低于预警水平 (otpw)，以避免连续温度上升到关机水平。

### 10.2 短路保护

TMC5160 通过监控高端 MOSFET、采样电阻和低端 MOSFET 中的电压降，保护 MOSFET 功率级免受短路或过载条件的影响（图 10.1）。可编程的短检测延迟 (shortdelay) 允许调节检测器以在非常慢的切换斜率下工作。另外，短路检测器可对信号滤波。这有助于防止由 PCB 布局或长的相邻电机电缆 (SHORTFILTER) 的影响引起的寄生触发。所有控制位由寄存器 SHORT_CONF 设置。此外，通过在连续关断电机输出之前会重复测量三次，避免短路保护受单个事件（例如由 ESD 放电引起）的影响。

（图 10.1 短路检测，见原数据手册）

| 参数 | 描述 | 设置 | 备注 |
|---|---|---|---|
| S2VS_LEVEL | 低侧场效应晶体的短路或过电流检测电平。检测低端 MOSFET 和采样电阻器中的电压降。提示：建议使用 6 到 8，低电流时可减小到 4 | 4…15 | 4（高敏感度）…15（低敏感度）（复位缺省：OTP 6 or 12） |
| S2G_LEVEL | 高侧场效应晶体的对地短路电平设置。检测高端 MOSFET 上的电压降。提示：推荐 6 至 14（电压高于 52V 时最小设置为 12） | 2…15 | 2（高敏感度）…15（低敏感度）（复位缺省：OTP 6 or 12） |
| SHORT_FILTER | 短路检测的尖峰滤波带宽。提示：好的 PCB 布局允许配置为 0。如果发生错误的短路检测，则需要增加该参数 | 0…3 | 0（最低，100ns），1（1μs）（复位缺省），2（2μs），3（3μs） |
| shortdelay | 短路检测延时。短路检测延迟应大于桥臂切换时间。0 将适用于大多数应用 | 0/1 | 0=750ns: 正常，1=1500ns: 高 |
| CHOPCONF.diss2vs | 关闭对 VS 电源短路保护 | 0/1 | 正常操作请使能 (0) |
| CHOPCONF.diss2g | 关闭对地短路保护 | 0/1 | 正常操作请使能 (0) |

低端短路检测包括采样电阻，因此可以将其设置为高灵敏度确保良好的电流检测精度。这样，它将安全地应对大多数过电流条件，即当电机停止时或在 Stealtchop 模式下突然停止时。

**提示：**

- 一旦检测到短路，立刻关断相应的驱动器桥（A 或 B），同时 s2ga 或 s2gb 标志有效。
- 要重新启动电机，请关闭并重新使能驱动器。

**注意：** 短路保护不能针对所有可能的短路事件保护系统和功率器件，因为短路事件相当不确定，并且可能涉及外部组件的复杂网络。尽可能的避免短路的发生。

**提示：** 请将低端短路保护 (S2VS) 设置为灵敏地检测过电流条件（额定峰值电流的 150% 至 200%）。低电阻电机在错误的设置或者 StealthChop 模式下停止电机，很容易产生过流。因此，对 VS 设置的敏感短路将保护功率端器件。

**注意：**

- 当电压高于 52V 时，高端短路检测 (S2G) 灵敏度可能会增加。如果电机电源电压可能超调至 55V，推荐设置 12 到 15。设置 S2VS 检测器阈值，更好调整过流检测。
- 如果电机电源电压超过 55V，高端短路检测可能会错误触发。

### 10.3 开路诊断

电缆断开是系统故障的常见一种原因，例如连接器未牢固插入时。TMC5160 通过检查是否能够达到期望的电机线圈电流来检测开路负载条件。欠压、电机高速度设置或短路和过热条件也可引起负载开路标志的触发，并通知用户电机转矩可能受到影响。在电机静止状态下，由于线圈最终可能没有电流，因此无法测量是否开路。

开路诊断可用于系统调试。

为了安全地检测线圈连接是否断开，仅在电机低速或者中速运行时读出负载开路标志。如果可能，使用 spreadCycle 进行测试，因为它提供了最准确的测试。ola 和 olb 标志仅提供信息，驱动器不会执行任何操作。

---

## 11. 斜坡发生器

斜坡发生器产生目标位置或目标速度的运动。它会考虑加速度和速度设置并自动计算最佳运动轮廓。TMC5160 集成了一种新型斜坡发生器，与经典的线性加速斜坡相比，机器运行更快。SixPoint 六点斜坡发生器的加速斜坡适应步进电机的转矩曲线，且加速阶段和减速段分别使用两种不同的设置。见图 11.2。

### 11.1 实际单位换算

TMC5160 所有内部操作的时间基准是其内部或外部时钟信号。因此，所有时间、速度和加速度设置都参考 fCLK。建议用外部石英振荡器或由微控制器提供时钟信号，获得最佳稳定性。

TMC5160 寄存器内容的单元被写入为寄存器[5160]。

表：参数和单位

| 参数 / 符号 | 单位 | 计算 / 描述 / 备注 |
|---|---|---|
| fCLK [Hz] | [Hz] | TMC5160 时钟 [Hz] |
| s | [s] | 秒 |
| US | µstep | 微步 |
| FS | fullstep | 全步 |
| µstep velocity v[Hz] | µsteps/s | v[Hz] = v[5160] * (fCLK[Hz]/2 / 2^23) |
| µstep acceleration a[Hz/s] | µsteps/s^2 | a[Hz/s] = a[5160] * fCLK[Hz]^2 / (512*256) / 2^24 |
| USC microstep count | counts | 微步分辨率（微步数）（即两个全步之间的微步数，通常为 256） |
| rotations per second v[rps] | rotations/s | v[rps] = v[µsteps/s] / USC / FSC；FSC: 电机每一圈的全步数，e.g. 200 |
| rps acceleration a[rps/s^2] | rotations/s^2 | a[rps/s^2] = a[µsteps/s^2] / USC / FSC |
| ramp steps[µsteps] = rs | µsteps | rs = (v[5160])^2 / a[5160] / 2^8，线性加速度阶段的微步（假设加速度从 0 到 v） |
| TSTEP, T…THRS | — | TSTEP = fCLK / fSTEP，速度阈值的时间基准是指时钟输入的实际微步频率，对应速度 v[Hz] |

极少数情况可根据应用设置加速度上限，例如当时钟频率较低或高齿轮传动和电动机上的低负载工作时。为了增加可能的有效加速度，可降低定序器输入的微步分辨率。设置 CHOPCONF 选项 intpol=1 和 MRES=%0001 将使相同速度设置的电机速度加倍，从而使有效加速和减速加倍。电机将具有相同的平滑度，但在此设置下位置分辨率减半。

**快速：** 请参阅第 20 章中的快速配置指南快速入门。

### 11.2 运动轮廓

斜坡发生器寄存器组请参见第 5.3 章。

#### 11.2.1 斜坡模式

斜坡发生器提供两相加速、两相减速斜坡及可编程启动和停止速度（见图 11.1）。

**注意：**

- 如果不用起始速度，可以设置为 0。
- 如果不用停止速度，可以设置为 10（或者 0）。
- 需要设置 VSTOP 与 VSTART 相同或者略高，能确保即使很短的距离也能成功运行。

两组不同的加减速可以自由组合。在加速和减速共用一个切换速度 V1 点。一般在较高速度下使用较低的加速和减速值，因为电动机扭矩在较高速度下会下降。考虑系统摩擦，很明显系统的减速通常比加速快。因此，许多应用的减速度值可以更高。这样，在时间有要求的应用中可以最大化控制电机的速度。

目标位置和斜坡参数在运动期间的任何时间可以改变，运动控制器将始终使用最佳（最快）方式到达目标，同时坚持用户设置的约束。该情况下，可能会发生运动自动停止、过零并再次往回驱动的情况。特殊标志 second_move 标记。

#### 11.2.2 启动和停止速度

当设置启动和停止速度时，很明显，随后向相反方向移动系统会有 VSTART + VSTOP 的跳动，而不仅仅是 VSTART。电机可能无法跟随这种情况，可设置 TZEROWAIT 来延迟后续运动。有效延迟时间由标志位 t_zerowait_active 标记。到达目标位置后，position_reached 标志有效。

（图 11.1 斜坡发生器速度迹线，其显示随后向反方向上移动，见原数据手册）
（图 11.2 TMC5160 斜坡发生器优化电机转矩说明，见原数据手册）

#### 11.2.3 速度模式

为便于操作，速度模式的加速和减速设置一样。因此在速度模式下，只需设置 VMAX 和 AMAX。斜坡生成器始终调用 AMAX 加速或减速到 VMAX。

VMAX 设置为零，则电机减速到静止。vzero 标志有效表示电机停止。velocity_reached 标志位有效，表示已经达到目标速度。

#### 11.2.4 斜坡提前终止

在用户可以与系统交互的情况下，一些应用需要通过在到达目标位置之前将速度下降到零终止运动。

设置加速度参数终止运动的选项：

- a) 切换到速度模式，设置 VMAX=0、AMAX 为所需的减速值。通过线性斜坡停止电机。
- b) 位置模式下，设置 VSTART=0 和 VMAX=0。在这种情况下不使用 VSTOP。驱动器根据 AMAX 和 A1（由 V1 确定）设置减速到零。
- c) 系统如果配置 D1、DMAX 和 VSTOP 的位置模式停止，可将 XACTUAL 复制到 XTARGET 来触发减速阶段。保证设置 TZEROWAIT 足够大满足 CPU 在此期间与芯片交互。驱动器将减速并最终停下来。按选项 a) 或 b) 轮询实际速度，以在 TZEROWAIT 时间内终止运动。
- d) 使能停止开关。可通过硬件输入脚实现，例如使用到停止开关输入的线'或'。如果不使用硬件输入，并且已将 REFL 和 REFR 链接到固定电平，使能停止功能（stop_l_enable、stop_r_enable），并使用反相功能（pol_stop_l、pol_stop_r）模拟开关激活。

#### 11.2.5 应用示例：操纵手柄控制

运动控制器可以优化某些应用如监控摄像机：发生器确保有效的运动范围不会偏离。

实现操作手柄控制：

1. 使用位置模式控制运动方向并设置运动限幅。
2. 在 VSTART 及最大限幅值之间可随时修改 VMAX。VSTART=0 时还可以设置 VMAX=0 停止运动。运动控制器将根据 V1 调用 A1 和 AMAX 来调整用于速度的上升和下降。
3. 如果不修改加速设置，则无需重写 XTARGET，只需重置 VMAX 即可。
4. DMAX、D1 和 VSTOP 仅在斜坡控制器由于到达目标位置而减速时或在目标位置已被修改为指向另一方向时才有用。

### 11.3 速度阈值

斜坡发生器包括与 VACTUAL 相关的多个速度阈值。允许电机在不同的速度范围实现最佳步进模式、线圈电流和加速度设置。大多数应用不需要所有阈值，但原则上所有模式都可以组合，如图 11.1 所示。VHIGH 和 VCOOLTHRS 由 THIGH 和 TCOOLTHRS 确定，以便在使用外部步进输入时确定速度。将 TSTEP 与这些阈值进行比较。磁滞分别为 1/16 或 1/32 TSTEP，用于避免在 TSTEP 测量中发生信号抖动造成比较结果的连续翻转。速度的阈值上限分别提高了 1/16 或 1/32。未示出 StealthChop 阈值 TPWMTHRS。它可以包含在 VPWMTHRS < VCOOLTHRS 中。

（图 11.3 斜坡发生器速度相关模式控制，见原数据手册）

与不同斩波模式和无传感器关联的功能对应的速度阈值总是和每两个微步之间的时间 TSTEP 相关。

### 11.4 参考开关

驱动器参考开关必须在工作之前设置。参考位置可通过检测停止的机械开关或者参考开关确定。

如果是线性驱动，需要限定机械运动范围。对于异常情况，也可以通过使能左和右参考开关的停止开关功能来确保这一点。因此，斜坡发生器响应 SW_MODE 寄存器中配置的多个停止事件。有两种方法可以停止电机：

- 开关被按下，它可以突然停止。常有效用于紧急情况和基于 stallGuard 的归零的过程。
- 或者可以使用减速设置 (DMAX、V1、D1) 将电动机柔和地减速到零。

提示：在开关事件时将斜坡位置 XACTUAL 锁存到保持寄存器 XLATCH 给出精确参考开关位置。

（图 11.4 参考开关（示例），见原数据手册）

可通过配置开关极性或选择上拉或下拉电阻使用常开或常闭开关。常闭开关相对于开关连接的中断是故障安全的。可以使用的开关有：

- 机械开关
- 光电管，或者
- 霍尔传感器

**注意选择符合开关要求的参考开关电阻！**

在长电缆的情况下，可能需要在 TMC5160 参考输入附近进行额外的 RC 滤波。增加一个 RC 滤波器也将减少布线故障破坏逻辑电平输入的危险，但它将增加一定的延迟，应结合应用设计。

实现归零：

1. 确保未按下零位开关，可控制电机远离参考开关。
2. 使能开关信号有效时锁存位置并让电机（软）停止。基于 stallGuard 的归零需要设置硬停止 (en_softstop=0)。
3. 向开关方向运动电机（向左开关移到更负的位置，向右开关移到更正的位置）。您可以使用位置斜坡命令修正此动作。
4. 开关一按下，位置就锁定，电机停止。通过轮询实际速度 VACTUAL 或检查 vzero 或停止标志，直到电机再次停止。
5. 将斜坡发生器切换到保持模式，并计算锁定位置与实际位置之间的差值。对于基于 stallGuard 的归零或使用硬停止时，XACTUAL 完全停止在初始位置，因此没有差异 (0)。
6. 将计算出的差值写入实际位置寄存器结束归零过程。移动到位置 0 将使电机精确回到切换点。如果 stallGuard 用于归零，则读并并写回 RAMP_STAT 以清除 stallGuard 停止事件 event_stop_sg，并将电机从停止状态释放。确保未按下零位开关，例如零位开关移开。

用第三个开关实现归零：

一些应用使用单独的零位开关，其独立于机械限位开关操作。TMC5160 的编码器功能提供了用于位置锁定的附加功能。当 N 通道上升沿跳变、下降沿跳变或两者之一跳变时捕获 XACTUAL，同时可中断输出。

1. 激活锁存功能（ENCMODE：设置 ignoreAB、clr_cont、neg_edge 或 pos_edge 和 latch_x_act）。锁存功能可以触发中断输出（DIAG0 引脚输出中断，中断有效时读 ENC_STATUS 中的 n_event 进行确认）。
2. 控制电机运动到 N 通道开关所在的方向。如果在检测到主开关之前电机碰到停止开关（REFL 或 REFR），则反向控制电机运动方向。
3. 开关有效后，读取 XLATCH。它给出了开关事件的位置。
4. 检测到开关事件后，停止电机，并从实际位置减去 XLATCH。读回并写 ENC_STAT 以清除状态标志。（有关所需步骤的详细说明，请参阅上面的归零过程。）

---

## 12. StallGuard2 负载检测

StallGuard2 反应电机负载。它可用于堵转检测以及在低于让电机堵转的负载下的其它用途，例如负载相关电流调节。StallGuard2 的测量值在很宽的负载、速度和电流设置范围内线性变化，如图 12.1 所示。在最大电机负载时，该值为零或接近零。这对应于线圈的磁场与转子中的磁铁之间的 90° 负载角。这也是电机最节能的点。

（图 12.1 StallGuard2 功能原理，见原数据手册）

| 参数 | 描述 | 设置 | 备注 |
|---|---|---|---|
| SGT | 该有符号参数控制 StallGuard2 的阈值用于堵转检测，并设置用于读出的最佳测量范围。值越低，灵敏度越高。零是大多数电机的启动值。值越高，StallGuard2 的灵敏度越低，指示到电机 Stall 堵转所需的扭矩越大 | 0: 中间值；+1…+63: 低敏感度；-1…-64: 高敏感度 | — |
| sfilt | StallGuard2 滤波器以获得更高的测量精度。如果设置，将测量频率降低到每电机电气周期一次测量（4 个全步） | 0: 标准模式；1: 滤波模式 | — |
| SG_RESULT（状态字） | StallGuard2 值。读数越高表示机械负载越小。较低的读数表示较高的负载，从而表示较大的负载角。调整 SGT 设置，使在电机堵转前的最大负载下的 SG_RESULT 读数大约 0 到 100 | 0…1023 | 0: 最高负载；低值: 高负载；高值: 低负载 |

**提示：** 使能 StallGuard2 和 CoolStep 之前请设置 SGT 调节 StallGuard2 的敏感度。

### 12.1 调整 StallGuard2 阈值 SGT

StallGuard2 值 SG_RESULT 受电机特性及特定应用的负载和速度影响。因此，针对特定电机类型和运行条件调整 stallguard 2 阈值 SGT 的最简单方法是在实际应用中进行交互式调整。

调整 STALLGUARD 的 SGT 的初始步骤：

1. 以适用的正常运行速度运行电机，并监控 SG_RESULT。
2. 缓慢增加电机的机械负载。如果电机在 SG_RESULT 达到零之前停止，则减小 SGT。如果 SG_RESULT 在电机停止之前达到零，则增大 SGT。0 是 SGT 初始值。SGT 是有符号的，可正可负。
3. 将 TCOOLTHRS 设置为高于 TSTEP 的值，并启用 sg_stop 使能堵转停止功能。确保电机在停机时安全停止。如果电机在堵转发生前停止，增加 SGT。通过禁用 sg_stop 或读并写入 RAMP_STAT 寄存器（写+清除功能）重新启动电机。
4. 在电机增加负载堵转前，SG_RESULT 最佳范围大约在 0 和 100 之间，且在没有负载的情况下 SG_RESULT 增加 100 或更多时。在大多数情况下，SGT 应在某个运动速度或速度范围调整。确保设置在一定范围内（例如所需速度的 80% 至 120%）以及极端电机条件下（最低和最高适用温度）工作可靠。

允许自动调整 SGT 的可选步骤：

SGT 设置背后的基本思想是补偿电机内部电阻损耗的对 StallGuard 影响。在静止和非常低的速度下，由于机械功率为零或接近零，电阻损耗是电机能量平衡的主要因素。这样，可以将 SGT 设置为接近零速度的最佳值。该算法特别适用于在应用中调整 SGT，以获得与环境条件、电机杂散等无关的最佳结果。

1. 以小于 10 RPM（即每秒几至几个全步的低速运行电机），并获得目标运行电流和电源电压。在此速度范围内，SG_RESULT 对电机负载的依赖性不大，因为电机不会产生显著的反电势。因此，机械负载对结果影响不大。
2. 打开 sfilt 滤波器。将 SGT 从 0 逐渐增加到 SG_RESULT 开始增加。当 SGT 值较高时，SG_RESULT 将上升到最大值，继续增大 SGT 则 SG_RESULT 会溢出到 0。现在，SGT 值被设置成最大敏感。当您看到 SG_RESULT 以较高的速度增加时，则检测到堵转。

该参数设置下堵转检测的上限速度由速度确定，在该速度下，电机反电势接近电源电压，速度继续增大电机电流开始下降。

当电机堵转时，SG_RESULT 变为 0，可配置斜坡发生器 SW_MODE 中的 sg_stop 使能在堵转事件时停止电机。将 TCOOLTHRS 设置为与较低的速度阈值相匹配，在该阈值下，StallGuard 结果最佳，完成有效的 sg_stop。

电源电压也会影响 SG_RESULT，因此电压调节越严格，数值越精确。StallGuard 测量具有高分辨率，有几种方法可以提高其精度，如以下部分所述。

**快速启动：** 请参阅第 20 章中的快速配置指南快速入门。

有关详细步骤，请参见应用说明 AN002 - stallguard 2 和 CoolStep 的参数化。

#### 12.1.1 速度阈值 TCOOLTHRS 和 THIGH

作为先前描述的 SGT 调整结果而选择的 SGT 设置可以用于某个速度范围。超出此范围时，可能无法安全检测到堵转，CoolStep 可能无法给出最佳结果。

（图 12.2 示例：最佳 SGT 设置和 StallGuard2 读数（带示例电机），见原数据手册）

在许多应用中，大部分时间只在单个操作点或附近运行，因此单个 SGT 设置就足够了。驱动器提供较低和较高的速度阈值以匹配这一点。在所确定的操作点之外堵转检测被禁用，例如在将 TCOOLTHRS 设置为匹配值时，在无传感器归零过程之前的加速阶段期间堵转检测无效。上限可由 THIGH 指定。

在一些应用中，可根据速度使用少量的点和线性内插来调整 SGT 参数。

#### 12.1.2 具有高转矩脉动和共振的小电机

具有高制动转矩的电动机显示出随着变化的电机电流，特别是在低电流时，StallGuard2 测量值 SG 的变化增加。对于这些电机，应检测电流相关性以获得最佳结果。

#### 12.1.3 电机线圈电阻的温度依赖性

在较宽温度范围内工作的电机可能需要温度校正，因为电机线圈电阻随温度升高而增加。在温度升高的应用中，电机效率降低，可以通过降低 SGT 的线性度下矫正。

#### 12.1.4 StallGuard2 测量准确度和重复性

在量产环境中，可能希望在一种电机类型的应用中使用固定的 SGT 值。大部分 StallGuard2 测量结果的差异是由电机结构中的制造公差引起的。如果所有其他参数保持稳定，StallGuard2 的测量误差可以低至：

（公式：StallGuard2 测量误差公式，原文此处转换失败，见原数据手册）

### 12.2 StallGuard2 更新速率和滤波器

StallGuard2 测量值 SG_RESULT 在电机的每一个全步位置都会更新。这足以安全地检测堵转，因为堵转总是损失四个全步。在实际应用中，尤其是在使用 CoolStep 时，更精确的测量可能比每一个全步的更新更重要，因为机械负载从不在两个全步之间瞬间改变。对于这些应用，使能 sfilt 位对四次全步测量值进行滤波。当需要高精度测量时，应始终使能滤波器。它补偿了电机结构的变化，例如由于 A 相和 B 相的不对称。当需要对增加的负载作出快速响应时，应该禁用滤波器，尤其是用 stallGuard 做无传感器的归零的应用。

### 12.3 检测电机堵转

要获得最佳堵转检测，请不要设置 stallGuard 滤波（sfilt=0）。安全检测电机堵转，必须设置特定的 SGT 参数来确定堵转阈值。因此，需要确定电机在不堵转的情况下的最大负载。同时，检测此负载下的 SG_RESULT 值，例如 0 到 100 范围内的某个值。堵转阈值应该是安全地在操作极限内的值，以允许参数偏离。在 SGT 设置为 0 或接近 0 时的响应给出了对信号质量的一些想法：在没有负载和最大负载的情况下检查 SG 值。它们之间应该至少相差 100 或几个 100，比偏移大。如果将 SGT 值设置为最大电机负载时 SG 读数为 0，则运动控制器可以自动检测堵转，以发出电机停止。在步进脉冲导致失步的瞬间可读出最低值。失步产生后，电机将振动，同时 SG_RESULT 读数较高。

### 12.4 StallGuard 实现归零

线性驱动器的归零过程需要将马达移动到硬停的方向。由于 stallGuard 需要一定的速度才能工作（如 TCOOLTHRS 设定的），请确保起始点离硬停止点足够远，以提供加速阶段所需的距离。设置 SGT 和斜坡发生器寄存器后，开始向硬停止方向运动，并激活堵转时停止功能（SW_MODE 中设置 sg_stop）。一旦检测到堵转，斜坡发生器停止运动并设定 VACTUAL 为零，从而停止电机。DRV_STATUS 的标志 StallGuard 指示停止。设置新的运动参数以防止电机立即重启后，可以禁用 StallGuard，或者通过读和写回 RAMP_STAT 重启电机运动。运动参数未被修改的情况下，在 TZEROWAIT 时间之后写入和清除 RAMP_STAT 中的 event_stop_sg 标志重新启动电机。在电流大小为电机额定电流的 30% 至 70%，运动速度为 1 至 5 RPS（小于 NEMA17 的电机可能需要更高的速度）的情况下，StallGuard 归零效果最佳。

### 12.5 StallGuard2 操作局限性

stallguard 2 在极端电机速度下运行不可靠：非常低的电机速度（对于许多电机，每秒不到一圈）会产生低反电动势，使测量不稳定，同时还要考虑环境条件（温度等）。上述自动调整过程将对此进行补偿。其他条件也将导致 SGT 的极端设置和测量值 SG_RESULT 对电机负载的不正确响应。

非常高的电机速度，因电机反电动势达到电源电压电机线圈无法输出正弦电流驱动，效果也较差。

---

## 13. CoolStep 操作

CoolStep 是一种基于电机机械负载的步进电机智能调节能耗，使其'绿色'的功能。

### 13.1 对用户的好处

（图：见原数据手册）

- 能效：减少最多 75% 的能耗。
- 电机发热减少：提高机械精度。
- 减少冷却机构：电机和驱动器。
- 更便宜的电机：完成工作！

CoolStep 实现节能，特别是对于负载变化或工作在高占空比的电机应用。即使是恒负载应用也需要节能，因为步进电机应用需要保留 30% 至 50% 的扭矩工作。CoolStep 在工作是根据负载需要自动保留扭矩。降低功耗使系统保持较冷，延长电机寿命，并降低电源和冷却部件的成本。

将电机电流减小一半则功率减小 4 倍。

### 13.2 CoolStep 设置

CoolStep 由几个参数控制，但两个参数对于理解它的工作方式至关重要：

| 参数 | 描述 | 范围 | 备注 |
|---|---|---|---|
| SEMIN | 阈值下限。4 位无符号整数。如果 SG 低于此阈值，CoolStep 会增加两个线圈的电流。4 位 SEMIN 乘以 32，对应 10 位 SG 值范围的下半部分。（此参数的名称来自 smarterEnergy，它是 CoolStep 的早期名称） | 0: 禁用 CoolStep；1…15: 阈值为 SEMIN*32 | — |
| SEMAX | 阈值上限，4 位无符号整数。如果 SG 采样值等于或高于该阈值，CoolStep 将降低到两个线圈的电流。上限为 (SEMIN+SEMAX+1)*32 | 0…15 | 阈值为 (SEMIN+SEMAX+1)*32 |

图 13.1 显示了 CoolStep 的操作区域：

- 黑线代表 SG 测量值。
- 蓝线表示电机上的机械负载。
- 红线表示电机线圈的电流。

当负载增加时，SG_RESULT 下降到 SEMIN 以下，CoolStep 增加电流。当负载减小时，SG_RESULT 上升到 (SEMIN+SEMAX+1)*32 以上，电流减小。

（图 13.1 CoolStep 根据负载调节电机电流，见原数据手册）

CoolStep 的五个控制参数和一个状态返回参数：

| 参数 | 描述 | 范围 | 备注 |
|---|---|---|---|
| SEUP | 设置电流增加步长。测量到的 stallguard 2 值低于下阈值，电流增加 | 0…3 | 步长宽度为 1, 2, 4, 8 |
| SEDN | 每次线圈电流减少时，StallGuard2 值必须等于或高于上限阈值对应的数值 | 0…3 | StallGuard 递减数: 32, 8, 2, 1 |
| SEIMIN | 通过调整 IRUN 电流设置，设置 CoolStep 操作的电机电流下限 | 0: IRUN 的 1/2；1: IRUN 的 1/4 | — |
| TCOOLTHRS | 打开 CoolStep 和堵转停止功能的较低速度阈值。低于此速度，CoolStep 将被禁用（不用于 STEP/DIR 模式）。满足速度下限条件的 StallGuard2 能给出稳定的结果。提示：可设置和 VMAX 一样，则在加速和减速阶段禁用 CoolStep | 1…2^20-1 | 指定与 TSTEP 速度比较的 CoolStep 阈值下限 |
| THIGH | CoolStep 和堵转停的速度阈值上限。在此速度之上，CoolStep 变为禁用状态。根据 StallGuard2 结果的稳定性给出速度范围 | 1…2^20-1 | 同时也控制其它功能，如切换成全步 |
| CSACTUAL（状态字） | 该状态值提供由 CoolStep 控制的实际电机电流标度。该值范围为 IRUN 值到 SEIMIN 设定 IRUN 比例（1/2, 1/4） | 0…31 | 1/32, 2/32, … 32/32 |

### 13.3 调节 CoolStep

在调整 CoolStep 之前，首先调整 StallGuard2 阈值水平 SGT，这会影响负载测量值 SG_RESULT 的范围。CoolStep 根据 SG_RESULT 在 +90° 的最佳负载角附近运行电机。

电流增量速度在 SEUP 中设定，电流减量速度在 SEDN 中指定。它们可以单独调整，因为它们有可能根据不同事件触发的做出不同响应需要。这些参数的设置允许线圈电流的增加比减少快得多，因为可能需要更快响应更严重的事件，如果响应太慢，电机可能堵转。相比之下，超过上限的反应缓慢并没有太多风险，只是电机延时减少能量。

CoolStep 在当前标度参数 IRUN 和 seimin 位控制的电流范围之间运行，输出相应的电流。

#### 13.3.1 响应时间

为了快速响应增加的电机负载，使用大的电流增量步长 SEUP。如果电机负载变化缓慢，可以使用较低的电流增量步长来避免电机振荡。如果使能 sfilt 控制的滤波器，测量速率和调节速度将降低 4 倍。

**提示：** 最常见和最有益的用途是使 CoolStep 适应系统在目标速度的运行，并根据此设置速度阈值。由于加速和减速通常应该是快速的，该过程中需要全电机电流，但因持续时间短，所以对总功耗的影响很小。

#### 13.3.2 低速和静止操作

由于 CoolStep 无法测量静止和非常低速下的电机负载，斜坡发生器中要设置 CoolStep 的速度阈值。应根据应用设置。低于此阈值时，电流设置由 IRUN 和 IHOLD 确定。VHIGH 设置提供了阈值上限。可以设置两个阈值作为 Stallguard 2 调整过程。

---

## 14. 步进/方向接口

步进和方向输入提供了与许多现有运动控制器兼容的简单标准接口。步进脉冲内插器（MicroPlyer）将提供高分辨率细分控制，让一些最开始用低细分设计的电机运行更平滑。如果选择外部步进信号输入，则芯片内部集成的运动控制器关闭。在这种情况下，唯一保持活动状态的运动控制器寄存器是寄存器 IHOLD_IRUN。

### 14.1 时序

图 14.1 所示 STEP 和 DIR 信号的时序参数，下表给出了它们对应的规格。设置 CHOPCONF 寄存器的 dedge 模式位，则 STEP 的双边沿都有效。如果 dedge 模式位清零，只有上升沿处于活动状态。STEP 和 DIR 引脚与系统时钟同步。内部模拟滤波器消除信号上的毛刺，例如由 PCB 过长引起的毛刺。如果信号源远离芯片，特别是信号通过电缆传输，信号应该增加滤波处理或通过差分传输。

（图 14.1 步进和方向时序，输入滤波，见原数据手册）

表：STEP 和 DIR 接口时序（AC-特性，时钟周期 tCLK）

| 参数 | 符号 | 条件 | 最小值 | 典型值 | 最大值 | 单位 |
|---|---|---|---|---|---|---|
| step 频率（最大细分） | fSTEP | dedge=0 | — | — | ½ fCLK | — |
| step 频率（最大细分） | fSTEP | dedge=1 | — | — | ¼ fCLK | — |
| 全步频率 | fFS | — | — | — | fCLK/512 | — |
| 步进输入低电平时间*) | tSL | — | max(tFILTSD, tCLK+20) | 100 | — | ns |
| 步进输入高电平时间*) | tSH | — | max(tFILTSD, tCLK+20) | 100 | — | ns |
| 方向引脚到步进引脚建立时间 | tDSU | — | 20 | — | — | ns |
| 步进引脚后方向引脚保持时间 | tDSH | — | 20 | — | — | ns |
| 步进引脚和方向引脚尖峰滤波时间*) | tFILTSD | 上升沿和下降沿 | 13 | 20 | 30 | ns |
| 步进和方向引脚和时钟输入上升沿 | tSDCLKHI | 在 CLK 输入信号上升沿之前 | — | tFILTSD | — | ns |

### 14.2 改变分辨率

TMC5160 内部有一个 1024 个数据的正弦波微步表，用于产生电机线圈的正弦电流。这 1024 个条目对应于一个电周期或四个全步。微步分辨率设置决定了查表的步长。根据 DIR 输入，微步计数器增加 (DIR=0) 或减少 (DIR=1)。微步分辨率分别决定增量和减量。在最大分辨率下，每个 STEP 步进脉冲定序器前进一步。在一半分辨率下，它前进了两步。整步最高包含 256 步。定序器具有特殊的处理，允许在任何时候在不同细分设置之间无缝切换。当切换到较低的细分分辨率时，它会计算目标分辨率内最近的步长，并读取该位置的当前向量。这种行为对于像全步和半步这样的低分辨率尤其重要，因为当比较电机顺时针和逆时针运行时，步进序列中的任何故障都会导致不对称运行。

**示例：**

- 全步：表格位置 128, 384, 640 和 896 循环（45°, 135°, 225° 和 315° 电气位置，两个线圈电流相同）。每个位置的线圈电流对应于均方根值 (0.71×振幅)。步长为 256（电气角度 90 度）。
- 半步：表格的第一个位置为 64（22.5° 电气角度），步长为 128（45° steps）。
- 1/4 步：表格的第一个位置为 90°/8=11.25°（电气角度），步长为 64（22.5° steps）。

这样方法产生相同的步长，在两个旋转方向上是相同的。一些较老的驱动器在查找表中使用零电流（表条目 0，0）和全电流（90）。这种步进方式应尽量被避免，因为它提供的转矩较小，功耗更高。

表：全步 / 半步在正弦波表中的位置及线圈电流

| Step 位置 | 表格位置 | 线圈电流 A | 线圈电流 B |
|---|---|---|---|
| Half step 0 | 64 | 38.3% | 92.4% |
| Full step 0 | 128 | 70.7% | 70.7% |
| Half step 1 | 192 | 92.4% | 38.3% |
| Half step 2 | 320 | 92.4% | -38.3% |
| Full step 1 | 384 | 70.7% | -70.7% |
| Half step 3 | 448 | 38.3% | -92.4% |
| Half step 4 | 576 | -38.3% | -92.4% |
| Full step 2 | 640 | -70.7% | -70.7% |
| Half step 5 | 704 | -92.4% | -38.3% |
| Half step 6 | 832 | -92.4% | 38.3% |
| Full step 3 | 896 | -70.7% | 70.7% |
| Half step 7 | 960 | -38.3% | 92.4% |

### 14.3 MicroPlyer 和静止检测

如图 14.2 所示，STEP 上的每个有效沿，MicroPlyer 都会产生 256 微步。它根据上一个步长间隔在脉冲输入处插值。这样，在 STEP 信号中插入 2 个微步（128 微步输入产生 256 微步输出）到 256 微步（全步的输入产生 256 微分输出）。

设置 CHOPCONF 中的 intpol 位使能 MicroPlyer。

CONF.faststandstill 缩短了静止检测时间为 2^18 clocks（约 20 毫秒）。

内插的 2 至 256 微步的步进速率是通过测量前一步周期的时间间隔并将其分成多达 256 个相等的部分来确定的。对于 256 个微步，每两个微步之间的最大时间对应于 2^20（大约一百万个系统时钟周期）。在 12 MHz 的系统时钟下，微步操作的最小步进输入频率为 12 Hz（50 Hz，faststandstill=1）。较低的步进率会导致 STST 位被置位，对应停止事件。在该频率下，微步频率范围为（系统时钟频率）/2^16 到 256 Hz。芯片检测到静止时驱动器自动将电机电流切换到保持电流 IHOLD。

**提示：** MicroPlyer 只有在稳定的步进输入频率下才能完美工作。如果步进信号不是 50% 的占空比，则不要使用 dedge 选项。

（图 14.2 步进输入信号频率上升情况下的 MicroPlyer 微步插值功能（示例：16-256），见原数据手册）

图 14.2，第一个步进脉冲太长，系统设置静止标志位 stst。下一个步进 STEP 信号的有效边沿被清除该标志。然后外部步进 STEP 输入频率增加。在以较高速率进行一个周期之后，MicroPlyer 将内插微步速率调高以适应较高的频率。在速度较慢的一个周期中，MicroPlyer 没有产生全部 16 个微步，因此在速度较高的第一和第二个周期之间，马达有一个小的跳动。使能 GCONF.faststandstill 后，停止有效标志将在 2^18 个时钟（而不是 2^20 个时钟）之后进行。驱动器可以更快减低电流以实现节能。

---

## 15. DIAG 输出

### 15.1 脉冲/方向模式

外部运动控制器通常要对步进电机驱动器的某些状态做出快速反应。脉冲/方向模式下的可配置 DIAG 输出实时内部信息。

DIAG0 和 DIAG1 可设置输出内容以及输出类型（缺省设置为低有效，开路输出-或高有效推挽输出）。为了确定驱动器的复位，在复位状态期间，DIAG0 总是通过拉低来显示通电复位状态。图 16.1 为可用的信号和控制位。

（图 15.1 STEP/DIR 模式下 DIAG 输出，见原数据手册）

堵转输出信号通知外部运动控制器，可以像停止开关一样处理 StallGuard2。索引输出微步计数器的零位，便于驱动器切换不同的电流模式。斩波器 on-state 输出两个线圈斩波器（交替）在 spreadCycle 模式下或恒定断开时间模式中的导通阶段，以确定占空比。DcStep 跳过信息表明 DcStep 以低于脉冲输入速度的速度运行的另一种方法，定序器每丢一步，信号翻转一次。

**注意：** 索引脉冲的对应于微步的持续时间。当芯片在低于 256 微步且没使能内插功能时，索引时间会下降到两个 CLK 时钟周期。

### 15.2 运动控制模式

运动控制器模式下，DIAG 输出位置比较信号以准确触发外部逻辑，中断信号在运动斜坡中触发某些软件功能。支持漏极开路（低电平有效）输出信号（默认）或高电平有效推挽输出信号。漏极开路输出时，需外部上拉 4.7kΩ 至 33kΩ 的外部电阻。复位状态下，DIAG0 为低电平。在这种配置中，无法通过监控 DIAG0 来确定复位状态的结束，因为 event_pos_reached 标志在复位时也是有效状态，因此引脚在复位状态后保持有效低电平。为了安全地判断是否复位，通过 SPI 监控 reset 标志或读出任何寄存器以确认芯片已通电。

（图 15.2 SD_MODE=0 模式下的 DIAG 输出，见原数据手册）

---

## 16. DcStep

DcStep 是步进电机的自动换向模式。它允许步进机按照斜坡发生器的指令以其目标速度运行，只要它能应付负载。万一马达过载，它会减速到一个速度，在这个速度下，马达仍然可以驱动负载。这样，步进电机就不会堵转，可以尽可能快地驱动重载。其较高的扭矩可在较低的速度下获得，加上飞轮质量的动态扭矩可补偿机械负载峰值。如果电机完全被抱死，堵转标志将被设置。

### 16.1 用户好处

| 电机 | 从不丢步 |
|---|---|
| 应用 | 尽可能快 |
| 加速 | 尽可能高 |
| 能效 | 能达到最高速度 |
| 廉价电机 | 胜任工作 |

（图：见原数据手册）

### 16.2 设计 DcStep

在经典应用中，操作区域受到最大应用速度下所需的最大扭矩的限制。需要高达 50% 扭矩的安全裕度，以补偿不可预见的负载峰值、机械部件共振和老化造成的扭矩损失。DcStep 允许使用最大可用电机扭矩。使用电机和应用飞轮质量可以克服更高的短时间动态负载，而没有电机失速的危险。使用 DcStep，标称应用负载可以扩展到更高的扭矩，仅受保持扭矩区域附近的安全裕度限制（这是电机可以提供的最高的扭矩）。此外，最大应用速度可以增加到实际可达到的电机速度。

（图 16.1 DcStep 扩大了应用操作范围，见原数据手册）

**快速启动：** 请参见第 20 章中的快速配置指南快速入门。

有关详细配置过程，请参见应用注释 AN003 - DcStep。

### 16.3 运动控制模式下的 DcStep

DcStep 只需要几个设置。它直接将电机运动反馈给斜坡发生器，从而即使电机相对于目标速度过载，它也能无缝集成到运动斜坡中。DcStep 在斜坡发生器目标速度 VACTUAL 下以全步模式运行电机，如果电机过载，则以降低的速度运行电机。它需要设置最小操作速度 VDCMIN。VDCMIN 应为 DcStep 可对电机运行进行可靠检测的最低运行速度。除非制动到低于 VDCMIN 的速度，否则电机不会堵转。如果速度低于这个值，一旦负载被释放，电机将重新启动，除非堵转检测被启用（设置 sg_stop）。stallguard2 实现堵转检测功能。

（图 16.2 过载影响下的速度图，见原数据手册）

**提示：** DcStep 要求正弦波的相位极性在 MSCNT 范围 768~255 内为正，在 256~767 内为负。余弦极性必须从 0 到 511 为正，从 512 到 1023 为负。相移偏差 1 将干扰 DcStep 操作。因此，建议使用默认波形。请参考第 18.2 章，了解默认表的初始化。

### 16.4 DcStep 模式下的堵转检测

尽管 DcStep 能够在过载时使电机减速，但它不能避免在每种运行情况下出现堵转。一旦电机被堵转，或者它减速到低于电机相关的最小速度，在该速度下，电机的运行不再能够被安全地检测到，电机可能会堵转和失步。为了安全地检测失步并避免重新启动电机，可以使能堵转停止（设置 sg_stop）。在这种情况下，一旦电机停止运转，VACTUAL 就会被设置为零。除非读取 RAMP_STAT 状态标志。标志位 event_stop_sg 显示停止。在 DcStep 操作期间，StallGuard2 负载值也可用，范围限于 0 到 255，在某些情况下会读出较高到 511 的值。使能 stallGuard，还应设置 TCOOLTHRS，对应的速度略高于 VDCMIN 或低于 VMAX。

当飞轮负载较松的施加到电机轴时，这种模式下的堵转检测可能由于共振而错误地触发。

（图：见原数据手册）

| 参数 | 描述 | 范围 | 备注 |
|---|---|---|---|
| vhighfs & vhighchm | DcStep 操作中所需的 CHOPCONF 斩波器配置标志。一旦超过 VDCMIN，斩波器就切换到全步模式 | 0/1 | DcStep 模式需要置 1 |
| TOFF | CHOPCONF 关闭时间越高越有助于 DcStep。首选设置应大于 2 | 2…15 | 设置 8…15 与 DcStep 操作的设置 8 效果一样 |
| VDCMIN | 当使用内部斜坡发生器时，这是 DcStep 操作的下限速度。低于该阈值，电机以正常微步模式运行。在 DcStep 操作中，电机以最小 VDCMIN 运行，即使电机完全锁住也是如此。与 DC_TIME 设置一起调整。使能 StealthChop 也会禁用 DcStep | 0…2^22 | 0: 禁用 DcStep；DcStep 操作的最低速度设置 |
| DC_TIME | DcStep 负载测量对应的参考脉冲宽度。必须根据电机最大扭矩的鲁棒性优化。该参数越高则扭矩和速度越高，越低，则可以运行 VDCMIN 设定的更低的速度。在标称运行条件下的检测最佳设置，并在极端运行条件下重新检测（例如，最低运行电源电压、最高电机温度、最高电源电压、最低电机温度） | 0…1023 | 设置的下限是：tBLANK（由 TBL 定义）时钟周期中 + n，n 范围 1 到 100（对于典型的电机） |
| DC_SG | 此设置控制 DcStep 模式下的堵转检测。越高灵敏度也高。通过配置电机硬停，堵转可用作错误状态。使能 sg_stop 标志，用于在发生堵转事件时停止电机。这样，一旦堵转，电机停止运转 | 0…255 | 设置略高于 DC_TIME/16 |

### 16.5 DcStep 操作中的测量电机实际速度

在电机由于机械负载变的比目标速度慢的情况下，DcStep 能够降低电机速度。VACTUAL 显示了斜坡发生器的目标速度。它不受 DcStep 的影响。可借助位置计数器 XACTUAL，测量 DcStep 速度是可能的。

因此，用已知时间差对应的捕获的位置计数器计算：

（公式：DcStep 实际速度计算，见原数据手册）

示例：

在 16.0 MHz 时钟频率下，0.954 秒的时差将直接产生速度值，9.54 ms 的延迟将产生 1/100 实际 DcStep 速度。

为了尽可能精确地掌握时间间隔，每次从 IC 开始或结束传输 XACTUAL 时，都要捕获一个计时器。SPI 传输的 NCS 上升沿提供了最精确的时间参考。

### 16.6 步进/方向模式下的 DcStep

当连接到外部运动控制器时，TMC5160 提供了两种使用 DcStep 的方法。第一种方式将 DcStep step 执行的直接控制交给外部运动控制器，该控制器必须对电机过载做出反应，并处理电机被锁住情况。第二种方式假设外部运动控制器不能直接对 DcStep 信号做出反应。TMC5160 自动降低电机速度或在过载时停止电机。为了允许运动控制器在这种模式下对降低的实际电机速度做出反应，计数器 LOST_STEPS 给出了电机控制器已经发出命令但没有执行的步数。运动控制器可后续读出 LOST_STEPS 并驱动没有执行的步数。如果电机被抱住，它会尝试以设置的最小速度 VDCMIN 控制电机运行。

使能 DcStep 会自动将斩波器设置为恒定 TOFF 模式，仅含慢衰减。这样，当从微步模式和 DcStep 切换，不需要重新配置。DcStep 操作由 STEP 和 DIR 模式下的三个引脚控制：

- DCEN：高电平有效则驱动芯片执行 DcStep 操作。当低速使能 StealthChop 操作时，芯片根据 TPWMTHRS 对应的速度决定 DcStep 是否有效。此时，工作在 StealthChop 斩波模式时 DcStep 被禁用，即速度低于 StealthChop 斩波切换速度 TPWMTHRS 时，DcStep 无效。
- DCO：通知运动控制器电机未准备好接受脉冲输入（低电平），外部运动控制器应该不发送脉冲信号给 TMC5160 直到 DCO 变高。定序器可缓存每个全步中产生的有效微步数，以允许运动控制器响应 DCO 上的信号。如果电机被抱住，这种等待可以通过两种方法终止，一种方法是提供一大于 1024 个时钟周期的脉冲 STEP 输入，另一种通过内部 VDCMIN 设置。
- DCIN：命令驱动芯片等待脉冲输入并禁用 DCO（DCO 输出低电平）。此输入可用于同步多个使能 DcStep 的驱动芯片。

#### 16.6.1 DcStep 操作中 LOST_STEPS

DcStep 与外部运动控制器集成操作：外部运动控制器通过 DCEN 引脚或内部速度阈值使能 DcStep。TMC5160 跟随运动。如果需要减慢电机速度，它会计算步进 STEP 信号上的输入信号和电机上的步数之间的差异。运动控制器可以在运动之后或读出差异并补偿差异。原理（简化）见图 16.3。

（图 16.3 轻过载，电机移动速度比步进输入慢。LOSTSTEPS 增加，见原数据手册）

如果电机驱动器检测到 DcStep 中的机械过载而需要推迟步进运动，但是运动控制器没有通过暂停产生步进信号来对此做出反应，则 LOST_STEPS 会随着未执行的每个步进输入而增加或减少（取决于 DIR 设置的方向）。这样，失步的个数可以被读出并在稍后执行或者附加到运动中。当过载情况持续存在时，驱动器降低电机运行速度，应用程序受益于高微步分辨率，因为在 DcStep 操作中可实现更无缝的加速减速。如果应用被完全抱住，VDCMIN 是执行步进信号的速度下限。然而，如果电机速度比这个最低速还低，则失去未知的步数，也就不再确切知道电机位置了。DCIN 支持两个驱动器的同步：低电平停止步进执行，并将 DCO 设置为低电平。

#### 16.6.2 运动控制器的 DCO 接口

步进/方向模式下，DCEN 使能 DcStep。外部运动控制器使能 DcStep，一旦在运动斜坡超过最小步进速度，或者使用自动阈值 VDCMIN 来使能 DcStep。

STEP/DIR 接口以微步分辨率工作，即使内部全步运行。这样，在运动控制器内不需要切换到不同的操作模式。如果电机根据 DcStep 结果准备好了下一步操作，则 DcStep 输出 DCO 信号。如果电机还没执行上一步，则不执行，在执行下一个全步之前，驱动器会自动停止。DCO 发出的信号指示上述情况的发生。DCOUT 为低电平时，外部运动控制器应停止发送步进并等待，直到再次变为高电平。图 17.5 显示了这个原理。驱动程序在等待期间缓冲步骤，直到微步数设置减 1。如果 DCOUT 在较低的步长限制时间内没有变高，例如由于严重的电机过载，则可以执行一个步长至少 1024 个时钟周期的步长脉冲取代停止状态。内部时钟情况下建议最小脉冲长度为 125μs。

（图 16.4 DcStep 信号互连，见原数据手册）
（图 16.5 DCO 与运动控制器的接口--当 DCO 有效时，步进发生器停止，见原数据手册）

---

## 17. 紧急停止

驱动器低有效 ENN 使能引脚以安全关闭所有功率 MOSFET，并可设置电机为空转状态。该 ENN 引脚实现非软件所需的紧急停止功能。一些应用可能要求驱动器静止情况下有保持电流或处于被动制动模式的状态。可配置引脚 ENCA_DCIN 禁用步进输入信号。设置 GCONF 标志 stop_enable 使能此选项。每当 ENCA_DCIN 被拉高，电机将根据设置的静止 IHOLD、IHOLDDELAY 和 StealthChop 进入电流降低状态。ENN 禁用驱动器将需要三个时钟周期来安全地关闭驱动器。

---

## 18. 增量编码器 ABN 接口

TMC5160 带 ABN 编码器的增量编码器接口。编码器输入与其他信号多路复用。外围设备配置的基本选择由寄存器 GCONF 设置。N 通道可选，因为一些应用可能使用参考开关或堵转检测替代编码器 N 通道来进行位置参考。编码器通过数字增量正交信号（通常命名为 A 和 B）和清零信号（通常命名为 N 表示空或 Z 表示零）指示位置。

### N 信号

N 信号清除或捕获位置计数器。clr_cont 标志置 1，则检测到 N 通道事件时清除或锁存编码器位置寄存器。或者，仅对下一个编码器 N 通道事件做出响应，并在第一个 N 信号事件（clr_once 标志）之后自动禁用编码器位置的清除或锁定。这可能有用，因为编码器每转一圈就给出一次这个信号。

一些编码器 N 信号需要匹配 A 和 B 极性。配置 ENCMODE 寄存器中的 pol_A 和 pol_B 所需的极性。例如，当设置了 pol_A 和 pol_B 两者为高时，仅在 A 和 B 通道都是高电平是的 N 事件有效。

如果要实现下一个活动的 N 事件清除编码器位置 ENC_POS，需设置 clr_enc_x=1 且 clr_once=1 或 clr_cont=1。

（图 18.1 增量编码器的 ABN 信号，见原数据手册）

#### 编码器常数 ENC_CONST

当增量编码器的正交信号 AB 的极性每次发送变化时，编码器计数器增加或者减少编码器常数 ENC_CONST。编码器常数 ENC_CONST 数据格式是有符号的定点 (16.16)，用于匹配电机和编码器。在十进制模式下，高 16 位代表 0 到 9999 之间的数字。对于配备增量编码器的步进电机，固定的整数更容易归一系统参数。此外，机械传动装置可以很容易地被考虑在内。ENC_CONST 的符号为负代表反向计数以匹配电机和编码器方向。

**示例：**

- 编码器因子为 1.0: ENC_CONST = 0x0001.0x0000 = FACTOR.FRACTION
- 编码器因子为 -1.0: ENC_CONST = 0xFFFF.0x0000，这是 0x00010000 的二进制补码，等于 (2^16-(FACTOR+1)).(2^16-FRACTION)
- 十进制模式编码器因子 25.6: 00025.6000 = 0x0019.0x1770 = FACTOR.DECIMALS
- 十进制模式编码器因子 -25.6: 0xFFE6.4000 = 0xFFE6.0x0FA0，等于 (2^16-(FACTOR+1)).(10000-DECIMALS)

#### X_ENC 编码器计数器

编码器计数器 X_ENC 为当前编码器位置。根据不同类型的编码器，可以配置信号 A、B 和 N 有效电平信号。有关详细信息，请参考第 5.4 节中的寄存器映射。

#### ENC_STATUS 寄存器

寄存器 ENC_STATUS 包含编码器 N 通道清零事件相关的状态。寄存器 ENC_LATCH 锁存了 N 事件发生时的实际编码器位置。

### 18.1 编码器时序

编码器包含模拟和数字滤波，以保证在电缆长度增加下可靠运行。最大连续计数频率率受输入滤波限制为 fCLK 的 2/3。

表：编码器接口时序（AC-特性，时钟周期 t）

| 参数 | 符号 | 条件 | 最小值 | 典型值 | 最大值 | 单位 |
|---|---|---|---|---|---|---|
| Encoder 计数频率 | fCNT | — | — | <2/3 fCLK | fCLK | — |
| A/B/N 输入低电平时间 | tABNL | — | 3 tCLK +20 | — | — | ns |
| A/B/N 输入高电平时间 | tABNH | — | 3 tCLK +20 | — | — | ns |
| A/B/N 尖峰滤波时间 | tFILTABN | 上升沿和下降沿 | — | 3 tCLK | — | — |

### 18.2 设置编码器以匹配电机分辨率

电机参数为 USC=256 微步、200 全步电机的条件下对应的编码器因子设置：因子 = FSC*USC / 编码器分辨率。

表：200 全步电机，256 微步情况下的编码因子设置例

| Encoder 分辨率 | 所需的编码器因子 | 备注 |
|---|---|---|
| 200 | 256 | — |
| 360 | 142.2222 = 9320675.5555/2^16 = 1422222.2222/10000 | 无法准确匹配 |
| 500 | 102.4 = 6710886.4/2^16 = 1024000/10000 | 十进制能准确匹配 |
| 1000 | 51.2 | 十进制能准确匹配 |
| 1024 | 50 | — |
| 4000 | 12.8 | 十进制能准确匹配 |
| 4096 | 12.5 | — |
| 16384 | 3.125 | — |

**示例：** 编码器常数寄存器十进制 51.2，因此设置：

（公式：ENC_CONST 设定（51.2 = 51*2^16 + 0.2*10000），见原数据手册）

### 18.3 闭环

根据应用，编码器可以用于不同的目的。医疗应用通常需要增加监控来检测硬故障或软故障。出现故障时，机器可以手动停止和重启。设置 ENC_DEVIATION 和中断来安全地检测电机和编码器之间的失步/失配。

不太重要的应用可能会使用编码器来检测故障，在失步时停止电机并重启。编码器通过直接定位来提高定位精度。该应用程序可以基于偏差修改目标位置，或者用编码器位置更新实际位置。

TRINAMIC 的 S 斜坡闭环运动控制器 TMC4361 可实现闭环换相操作。

---

## 19. 直流电机或螺线管

TMC5160 可以驱动一个或两个直流电机。可控制转矩，或者在转矩限幅的同时控制电压控制速度。

### 配置和控制

在 GCONF 寄存器中设置 direct_mode。在直接模式下，线圈电流极性和线圈电流分别由寄存器 XTARGET (0x2D) 控制 PWM 占空比。第 0 到 8 位对应电机 A 相和第 24 到 16 位对应电机 B 相 PWM。除此之外设置，电流限制由 IHOLD 缩放。在此模式下 STEP/DIR 输入和运动控制器无效。

### PWM 占空比速度控制

为了以不同速度运行电机，用以下 StealthChop 斩波电压 PWM 模式配置：

en_pwm_mode = 1，pwm_autoscale = 0，PWM_AMPL = 255，PWM_GRAD = 4，IHOLD = 31

设置 TOFF > 0 使能驱动器。

在此模式下，驱动器的行为类似于四象限电源。XTARGET 对 PWMA 和 PWMB 直接控制实现控制电机电压，从而控制电机速度。PWM 设置在 -255 和 +255 之间（带符号，二进制补码）对应电机电压从 -100% 变化到 100%。当 pwm_autoscale=0 时，不使用电流采样电阻，并且应避免小于 150 毫欧的采样电阻，以避免在电机负载达到 2.5A 时出现过大的电压跌降。特别是对于电流较大的电机，确保缓慢加减速，以避免过流或触发驱动器过流保护。

设置 IHOLD=0，FREEWHEEL=%01。

### 转矩限幅

自动电流缩放（PWM_autoscale=1）功能可实现 StealthChop 斩波模式下的电机电流限制（即转矩控制操作）。实际电流极限由 IHOLD 给出，并由相应的电机 PWM 幅度来定标，例如，PWM=128 产生 50% 的电机速度和 50% 的 IHOLD 设定的电流极限。如果两台直流电机以电压 PWM 模式驱动，请注意，自动电流调节仅适用于绝对 PWM 设置较高的电机。如果具有较高 PWM 设置的电机达到其电流限制，第二电机的 PWM 也将缩小。

### 纯转矩限幅操作

对于一个或两个电机的纯转矩限幅操作，SpreadCycle 斩波器分别调节两个全桥电机输出的电机电流。使用 SpreadCycle 时，电机速度上限仅受电源电压限制（或由电机上的负载决定）。

### 19.1 螺线管操作

同样，一个或两个螺线管（即电磁线圈）可以使用 SpreadCycle 斩波器操作。对于螺线管来说，通常希望在接通后短时间内增加电流，并且一旦磁性元件接通就减少电流。这是通过利用自动电流缩放（IRUN、IHOLD、IHOLDDELAY 和 TPOWERDOWN）自动实现的。direct_mode 中的电流缩放仍然有效，但是如果没有提供步进 STEP 脉冲，则不会触发。因此，每当其中一个线圈被接通时，必须给步进 STEP 输入信号一个阶跃脉冲。这将同时增加两个线圈的电流。

使能电机飞轮停止模式。

---

## 20. 快速配置指南

本指南旨在作为一种实用工具，实现初始配置，完成一套最小的测量和决策来调整驱动芯片。它没有涵盖所有高级功能，而是专注于使电机平稳运行的基本功能集。一旦电机运行，你可能会决定更详细地探索其他功能，例如飞轮和其他功能。电流探头测量电机线圈电流有助于找到最佳设置，但这不是必须的。

### 电流设置和 STEALTHCHOP 初始步骤

（图 20.1 电流设置和 STEALTHCHOP 初始步骤，见原数据手册）

### 调整 STEALTHCHOP 及 SPREADCYCLE

（图 20.2 调整 StealthChop 及 spreadCycle，见原数据手册）

### 运动控制器控制电机

（图 20.3 运动控制器控制电机，见原数据手册）

### 使能 COOLSTEP（只在 SPREADCYCLE 下有效）

（图 20.4 使能 CoolStep（只在 spreadCycle 下有效），见原数据手册）

### 设置 DCSTEP

（图：设置 DcStep，见原数据手册）
