e1aco/ELACO_StepMotorTMC5160/Hardhare/StepMotor_2Routes_TMC5160/BOM/StepMotor_TMC5160.xlsx

Comment | Description | Designator | Footprint | LibRef | Quantity | 物料代码 | 链接
2.2uF/16V | 贴片电容 | C1, C8, C17, C18, C46, C53 | C 0603_L | C | 6 | A00600123 | A03400001
104/50V | 贴片电容 | C2, C3, C4, C15, C37, C47, C48, C49, C56, C59, C10, C12, C39, C40, C42, C44C10, C12, C39, C40, C42, C44,C19, C20, C21, C22, C23, C24, C25, C26, C27, C29, C30, C31, C32, C33,C58 | C 0805_L | C | 31 | A03400669
470nF/50V | 贴片电容 | C5, C6, C7, C13, C14, C50, C51, C52, C54, C55 | C 0603_L | C | 10 | A00600157 | https://item.szlcsc.com/87156.html?c=SO&qhclickid=5d7fd4ccac5a9837&alichlgref=https%3A%2F%2Fso.szlcsc.com%2F
106/50V | 贴片电容 | C9, C11, C38, C41, C43, C45 | C 0805_M | C | 6 | A03400304
22nF/50V | 贴片电容 | C16, C57 | C 0603_L | C | 2 | A00600158 | https://item.szlcsc.com/21834.html?fromZone=s_s__%252222nf%2522&c=SO&qhclickid=5d7fd4ccac5a9837
22P/16V | 贴片电容 | C34, C35 | C 0603_M | C | 2 | A00600114
220uF/50V | 直插电解电容 | CE1, CE2, CE4, CE5 | CAP 5.0*10*12.5 - BK | CE | 4 | A00600159 | https://item.szlcsc.com/356226.html?c=SO&qhclickid=5d7fd4ccac5a9837
470uF/50V | 直插电解电容 | CE3 | CAP 5.0*10*20 | CE | 1 | A01400137 | 无库存 | https://item.szlcsc.com/54596843.html?fromZone=s_s__%2522470uF%252F50V%2522
1N4148W |  | D1, D2, D4, D5, D6, D7, D8, D9, D12, D13, D15, D16, D17, D18, D19, D20 | SOD-123 | 1N4148W_C7420318 | 16 | A01000027 | https://item.szlcsc.com/8397140.html?fromZone=s_s__%25221n4148%2522&c=SO&qhclickid=5d7fd4ccac5a9837
SMAJ28CA | TVS保护 | D3, D14 | DIODE-SMB | TVS | 2 | A01000028 | https://item.szlcsc.com/159561.html?fromZone=s_s__%2522smaj28ca%2522&c=SO&qhclickid=5d7fd4ccac5a9837
SS310 | 肖特基二极管 | D11 | SMA | SS34 | 1 | A01000029 | https://item.szlcsc.com/8397186.html?fromZone=s_s__%2522ss310%2522&c=SO&qhclickid=5d7fd4ccac5a9837
180uF/50V | 贴片电解电容 | E1 | CM E(8*10.2) | CE_SMD | 1 | A00600160 | https://item.szlcsc.com/505695.html?fromZone=s_s__%2522180uf%252050v%2522&c=SO&qhclickid=5d7fd4ccac5a9837
HDR-1X2 | 2P接插件 | JP1, JP4 | VH3.96-LI-2P | Header 2 | 2 | A01300061
HDR-1X4 | 4P接插件 | JP2, JP5 | KF350-4P | Header 4 | 2 | A00700015 | https://item.szlcsc.com/376627.html?c=SO&qhclickid=5d7fd4ccac5a9837
HDR-1X4 | 4P接插件 | JP3 | HDR2.54-LI-4P | Header 4 | 1 | A03400323
HDR-1X6 | 6P接插件 | JP6-7 | XH2.54-LI-6P | Header 6 | 1 | A03400322
68uH | 功率屏蔽电感 | L1 | IND-SMD_L5.7-W5.2_GSM0530 | L-CDRH | 1 | A01300125 | https://item.szlcsc.com/56628172.html?fromZone=s_s__%25226.8uh%2522&c=SO&qhclickid=5d7fd4ccac5a9837
红色 | 贴片LED | LED1 | LED 0805G | LED-SMD | 1 | A03400295
AOD4126 | N沟场效应管 | Q1, Q2, Q3, Q4, Q5, Q6, Q7, Q8, Q9, Q10, Q11, Q12, Q13, Q14, Q15, Q16 | TO252 | 2SK3615 | 16 | A01400174 | https://item.szlcsc.com/461587.html?fromZone=s_s__%2522aod4126%2522&c=SO&qhclickid=5d7fd4ccac5a9837
10R 1% | 贴片电阻 | R1, R2, R4, R5, R12, R13, R15, R16, R42, R43, R45, R46, R53, R54, R56, R57 | R 0603_L | R | 16 | A03400177
2R2 1% | 贴片电阻 | R3, R6, R44, R47 | R 0603_L | R | 4 | A00500176 | https://item.szlcsc.com/2177928.html?fromZone=s_s__%25222.2r%25200603%2522&c=SO&qhclickid=5d7fd4ccac5a9837
47R 1% | 贴片电阻 | R7, R11, R18, R25, R48, R52, R59, R67 | R 0603_L | R | 8 | A00500177 | https://item.szlcsc.com/3180687.html?fromZone=s_s__%252247r%2522&c=SO&qhclickid=5d7fd4ccac5a9837
0R | 贴片电阻 | R8, R9 | R 2512_L | R | 2
50mR/3W | 贴片电阻 | R10, R22, R51, R64 | R 2512_L | R | 4 | A00500178 | https://item.szlcsc.com/3159229.html?fromZone=s_s__%252250mr%25203w%2522&c=SO&qhclickid=5d7fd4ccac5a9837
0R/NC | 贴片电阻 | R14, R55 | R 0603_L | R | 2
100R | 贴片电阻 | R17, R58 | R 0603_L | R | 2 | A03400179
4.7K | 贴片电阻 | R19, R23, R24, R26, R28, R32, R33, R60, R61, R65, R66 | R 0603_L | R | 11 | A00500056
3K | 贴片电阻 | R27 | R 0603_L | R | 1 | A03400147
1K | 贴片电阻 | R34, R36, R37, R39, R68, R69, R72, R73 | R 0603_L | R | 8 | A03400181
120R | 贴片电阻 | R35, R38, R70, R71, R75, R76 | R 0603_L | R | 6 | A03400167 | 无库存 | https://item.szlcsc.com/3180501.html?fromZone=s_s__%2522120r%25200603%2522&c=SO&qhclickid=5d7fd4ccac5a9837
0R/NC | 贴片电阻 | R40, R41 | R 0805_L | R | 2
10K | 贴片电阻 | R74 | R 0603_L | R | 1 | A03400318
SW-PB | 微动开关 | S1 | SW_PB2_A1 | SW-PB | 1
TMC5160A-TA-T |  | U1, U2 | TQFP-48_L7.0-W7.0-P0.50-LS9.0-BL-EP | TMC5160A-TA-T | 2 | A01800052 | https://item.szlcsc.com/532372.html?fromZone=s_s__%2522TMC5160%2522&c=SO&qhclickid=5d7fd4ccac5a9837
STM32F407ZET6 | STM32F407ZET6 | U3 | LQFP-144_20x20x05P | STM32F407ZET6 | 1 | A03400014
XDDB-1518-0932 |  | U4, U8 | DDSUB-TH_HYC06-HDR15B-060 | XDDB-1518-0932 | 2 | A01300126 | https://item.szlcsc.com/8568600.html?fromZone=s_s__%2522XDDB-1518%2522&c=SO&qhclickid=5d7fd4ccac5a9837
XL1509-5.0E1 | 功能类型:降压型;工作电压:4.5V~40V;输出电压:5V;输出电流:2A;输出类型:固定; | U5 | SOIC-8_L5.0-W4.0-P1.27-LS6.0-BL | XL1509-5.0E1 | 1 | A01800053 | https://item.szlcsc.com/44273613.html?fromZone=s_s__%2522XL1509%2522&c=SO&qhclickid=5d7fd4ccac5a9837
AM26LV32EIDR |  | U6 | SOIC-16_L9.9-W3.9-P1.27-LS6.0-BL | AM26LV32EIDR | 1 | A03400796 | https://item.szlcsc.com/545744.html?fromZone=s_s__%2522AM26LV32%2522&c=SO&qhclickid=5d7fd4ccac5a9837
SN65HVD230QDR | 类型:CAN收发器;数据速率:1Mbps; | U7 | SOIC-8_L5.0-W4.0-P1.27-LS6.0-BL | SN65HVD230QDR | 1 | A03400034
ISL8490IBZ-T |  | U9 | SOIC-8_L4.9-W3.9-P1.27-LS6.0-TL | ISL8490IBZ-T | 1 | A03400737
AMS1117-3V3 | 三端稳压芯片 | V1, V2 | SOT223_L | AMS1117 | 2 | A03400043
8MHz | 2脚无源脚晶振 | X1 | OSC 6035-2P | XTAL-2P | 1 | A01200078 | 无库存
AMS1085CM-3.3 |  |  |  |  |  |  | https://item.szlcsc.com/46911.html?fromZone=s_s__%2522AMS1085cm%2522&c=SO&qhclickid=5d7fd4ccac5a9837
AOT470 |  |  |  |  |  |  | https://item.szlcsc.com/43270.html?fromZone=s_s__%2522aot470%2522&c=SO&qhclickid=5d7fd4ccac5a9837
