e1aco/ELACO_StepMotorTMC5160/AIFirmware/StepMotorDriver_Keil/.ela/state.md

# State: StepMotorDriver_Keil

**当前步骤**: S3 完成 ✅ + 闭环控制集成 ✅
**下一步动作**: 待定

## 项目信息
- 名称: StepMotorDriver_Keil
- 类型: embedded
- 芯片: STM32F407ZET6
- 工具链: Keil MDK-ARM
- 驱动IC: TMC5160A
- 电机: 57CME13 闭环步进电机
- 状态目录: .em/

## S1 进度
- [x] brainstorm: 方案B (ela_can_drv + ela_can_usr)
- [x] milestones: 4 个子步骤 (S1-A / S1-B / S1-C / S1-D)
- [x] S1-A: ela_can_drv ✅
- [x] S1-B: ela_can_usr ✅
- [x] S1-C: elaco_main 集成 ✅
- [x] S1-D: Keil 工程配置 ✅

## S2 进度
- [x] brainstorm: 方案B (ela_motor_ctrl 中间层)
- [x] milestones: 4 个子步骤 (S2-A / S2-B / S2-C / S2-D)
- [x] S2-A: 电机控制中间层基础框架 ✅
- [x] S2-B: 绝对位置移动 + 相对位置正反转 ✅
- [x] S2-C: 速度模式 + 停止/刹车 ✅
- [x] S2-D: 集成测试 + 到位反馈 ✅

## S3 进度
- [x] brainstorm: TMC5160 软件闭环方案
- [x] milestones: 4 个子步骤 (S3-A / S3-B / S3-C / S3-D)
- [x] S3-A: PID 控制器模块 ✅
- [x] S3-B: 闭环控制模块 ✅
- [x] S3-C: 闭环模式切换 ✅
- [x] S3-D: 集成测试 ✅

## 测试记录
- [x] 电机2 (芯片2): ✅ 正转/反转正常 (2026-07-23)
- [x] CAN 命令响应: ✅ 绝对位置/相对正反转/速度模式/停止均正常
- [x] StealthChop 噪音问题: ✅ 已通过初始化延时 100ms 解决
- [x] 编码器方向: ✅ 取反 ENC_CONST 解决方向反转问题
- [x] 编码器偏差: ✅ 偏差值在 256 以内，符合预期
- [x] 温度问题: ✅ 降低 IHOLD=4, IRUN=10 减少发热
- [x] 闭环控制: ✅ 空载偏差 < 13 微步 (2026-07-24)
- [x] CAN 反馈: ✅ 改为 X_ENC 编码器实测值 (2026-07-24)
- [x] 上电可靠性: ✅ 增加 50ms 上电延时 + SPI 通信验证 (2026-07-24)
- [x] 编码器归零: ✅ 上电自动消除编码器初始偏移 (2026-07-24)
- [ ] 电机1 (芯片1): ⏭️ 硬件未焊接，待补测
