e1aco/ELACO_StepMotorTMC5160/AIFirmware/StepMotorDriver_Keil/.ela/decisions.md

# Decisions

| 日期 | 决策 | 原因 | 影响 |
|---|---|---|---|
| 2026-07-22 | S1 采用方案B: ela_can_drv + ela_can_usr 分层 | 解耦硬件驱动与协议解析 | S1 架构确定 |
| 2026-07-23 | S2 采用方案B: 新增 ela_motor_ctrl 中间层 | 解耦 CAN 协议与电机驱动，便于扩展 | S2 架构确定 |
| 2026-07-23 | 暂不实现 CMD_PID_ADJUST (0x06) | PID 模块尚未添加 | 后续补充 |
