e1aco/ELACO_StepMotorTMC5160/Firmware/TMC5160H7Cmake_StepMotor/.cl/datasheet/TMC5160A_Datasheet_Rev1.14_ch29_29_layout_considerations.md

# TMC5160A_Datasheet_Rev1.14 — 第29章 29 Layout Considerations

--- [PAGE 125] ---
TMC5160/TMC5160A DATASHEET (Rev. 1.14 / 2020-MAY-19)  125 

www.trinamic.com 
29 Layout Considerations 
29.1 Exposed Die Pad 
The TMC5160 uses its die attach pad to dissipate heat from the gate drivers and the linear regulator to 
the board. For best electrical and thermal performance, use a reasonable amount of solid, thermally 
conducting vias between the die attach pad and the ground plane . The printed circuit board should 
have a solid ground plane spreading heat into the board and providing for a stable GND reference.  
29.2 Wiring GND 
All signals of the TMC5160 are referenced to their respective GND. Directly connect all GND pins under 
the device to a common ground area (GND, GNDP, GNDA and die attach pad). The GND plane right 
below the die attach pad should be treated as a virtual star point. For thermal reasons, the PCB top 
layer shall be connected to a large PCB GND plane spreading heat within the PCB.  
 
Attention 
Place the TMC5160 near to the MOSFET bridge and sense resistor GND in o rder to avoid ringing 
leading to GND differences and to dangerous inductive peak voltages. 
 
29.3 Wiring Bridge Supply 
The power bridge will draw the full coil current in pulses with extremely high dI/dt . Thus, any 
inductivity between VS supply filtering and the MOSFETs can lead to severe voltage spikes. This has to 
be avoided. Avoid any bend in the supply traces between filtering capacitors and MOSFET switches, 
and keep distance as small as possible. Especially for high current, use a separate plane for the supp ly 
voltage, and a sufficient number and capacity  for supply filtering. Use an additional capacitor for the 
IC VS pin, as additional ripple voltage would cause severe current spikes on the charge pump 
capacitor. A tiny series resistor can be added to avoid this.  
 
Attention 
Keep supply voltage ripple low, by using sufficient filtering capacity close to the MOSFET bridge. 
 
29.4 Supply Filtering 
The 5VOUT output voltage ceramic filtering capacitor ( 2.2 to 4.7 µF recommended) should be placed as 
close as possible to the 5VOUT pin, with its GND return going direct ly to the GNDA pin . This ground 
connection shall not be shared with other loads or additional vias to the GND plan e. Use as short and 
as thick connecti ons as possible. For best microstepping performance and lowest chopper noise an 
additional filtering capa citor should be used for the VCC pin to GND, to avoid digital part ripple 
influencing motor current regulation. Therefore , place a ceramic filtering ca pacitor (470nF 
recommended) as close as possible (1 -2mm distance) to the VCC pin with GND return going to  the 
ground plane. VCC can be coupled to 5VOUT using a 2.2  Ω or 3.3 Ω resistor in order to supply the 
digital logic from 5VOUT while keeping ripple away from this pin.  A 100 nF filtering capacitor should 
be placed as close as possible to the VSA pin to gro und plane. Make sure, that VS does not see 
excessive voltage spikes caused by bridge operation and place a 100 nF or larger filter capacitor to 
GND close to the VS pin.  
 
Please carefully read  chapters 3.3 and 3.4 to underst and the special considerations with regard to 
layout and component selection for the external MOSFET power bridges. 

--- [PAGE 126] ---
TMC5160/TMC5160A DATASHEET (Rev. 1.14 / 2020-MAY-19)  126 

www.trinamic.com 
29.5 Layout Example 
 
Schematic (TMC5160+MOSFETs shown) 

1- Top Layer (assembly side) 

2- Inner Layer (GND) 

--- [PAGE 127] ---
TMC5160/TMC5160A DATASHEET (Rev. 1.14 / 2020-MAY-19)  127 

www.trinamic.com 
3- Inner Layer (supply VS) 
 
4- Bottom Layer 

Components 
 
Figure 29.1 Layout example 
 
Hint 
When using the TQFP package in designs for more than 30V consider PCB coating to satisfy sufficient 
creeping distances.
