e1aco/ELACO_StepMotorTMC5160/Firmware/TMC5160H7Cmake_StepMotor/.cl/datasheet/TMC5160A_Datasheet_Rev1.14_ch37_37_references.md

# TMC5160A_Datasheet_Rev1.14 — 第37章 37 References

--- [PAGE 134] ---
TMC5160/TMC5160A DATASHEET (Rev. 1.14 / 2020-MAY-19)  134 

www.trinamic.com 
FIGURE 22.3 MOVING THE MOTOR USING THE MOTION CONTROLLER ....................................................................................... 113 
FIGURE 22.4 ENABLING COOLSTEP (ONLY IN COMBINATION WITH SPREADCYCLE) ................................................................. 114 
FIGURE 22.5 SETTING UP DCSTEP .......................................................................................................................................... 115 
FIGURE 24.1 STANDALONE OPERATION WITH TMC5160 (PINS SHOWN WITH THEIR STANDALONE MODE NAMES).................. 117 
FIGURE 29.1 LAYOUT EXAMPLE ............................................................................................................................................... 127 
FIGURE 30.1 DIMENSIONAL DRAWINGS TQFP48-EP ............................................................................................................. 128 
FIGURE 30.2 DIMENSIONAL DRAWINGS WETTABLE QFN ........................................................................................................ 130 
 
36 Revision History 
Version Date Author 
BD= Bernhard Dwersteg  
Description 
V1.00 2017-NOV-18 BD Link corrected, OTP read table addr. corr. 
Reduced peak operation voltage limits 
Added some Attention boxes or converted to Hint 
V1.01 2017-NOV-29 BD S2G detector thresholds fixed for final product, Corrected TPFD time 
formula 
V1.02 2017-DEZ-14 BD SWIOP/N → SWP/N, CFG6 errata 
V1.04 2018-MAY-02 BD Exchanged Title graphics for -WA, minor fixes of text. 
V1.06 2018-JUN-06 BD Added errata / limitations for initial tuning of AT#1 / AT#2 phase 
V1.07 2018-OCT-18 BD Corrected 52V and 55V limits for S2GND detector, minor corrections 
V1.08 2018-NOV-19 BD  Added hints for tuning MOSFET bridge, added wiring bridge supply 
V1.10 2019-FEB-05 BD Corrected timing requirements for CLK input (30ns for first pulse) / 
some minor fixes 
V1.11 2019-JUN-07 BD Minor wording, hint on coating, added order codes 
V1.12 2019-AUG-05 BD Added changes for TMC5160A, Errata for DIAG output in standalone 
mode 
V1.13 2019-NOV-19 BD Minor changes, added high voltage example 
V1.14 2020-MAY-19 BD Updated Logo 
Table 36.1 Document Revisions 
37 References 
[TMC5160-EVAL] TMC5160-EVAL Evaluation Board 
[AN001] Trinamic Application Note 001 - Parameterization of SpreadCycle™, www.trinamic.com  
[AN002] Trinamic Application Note 002 - Parameterization of StallGuard2™ & CoolStep™, 
www.trinamic.com 
[AN003] Trinamic Application Note 003 - DcStep™, www.trinamic.com  
Calculation sheet TMC5160_Calculations.xlsx
