e1aco/ELACO_StepMotorTMC5160/Firmware/TMC5160_StepMotor/.cl/datasheet/C457934_场效应管(MOSFET)_AOD4126_规格书_WJ290500.md

# C457934_场效应管(MOSFET)_AOD4126_规格书_WJ290500 (提取自 PDF, 引擎=pymupdf_tables)

--- [PAGE 1] ---
AOD4126/AOI4126
100V N-Channel MOSFET
SDMOS TM
General Description
Product Summary
VDS
   ID  (at VGS=10V)
43A
   RDS(ON) (at VGS=10V)
< 24mΩ
   RDS(ON) (at VGS = 7V)
< 30mΩ
100% UIS Tested
100%  Rg Tested
Symbol
VDS
Drain-Source Voltage
100
The AOD4126&AOI4126 are fabricated with SDMOSTM
trench technology that combines excellent RDS(ON) with
low gate charge.The result is outstanding efficiency with
controlled switching behavior. This universal technology is
well suited for PWM, load switching and general purpose
applications.
V
Maximum
Units
Parameter
Absolute Maximum Ratings  TA=25°C unless otherwise noted
100V
G 
D 
S
TO252
DPAK
Top View
Bottom View
G  
S  
D   
G  
S  
D  
G
G
D
D
S
S
D
Top View
Bottom View
TO-251A
IPAK
DS
VGS
IDM
IAS, IAR
EAS, EAR
TJ, TSTG
Symbol
t  ≤ 10s
Steady-State
Steady-State
RθJC
100
Pulsed Drain Current C
Continuous Drain
Current B
Parameter
Typ
Max
TC=25°C
3
50
TC=100°C
Maximum Junction-to-Ambient A
°C/W
RθJA
8
35
10
V
±25
Gate-Source Voltage
g
Units
Junction and Storage Temperature Range
-55 to 175
°C
Thermal Characteristics
Avalanche energy L=0.1mH C
mJ
Avalanche Current C
6
Continuous Drain
Current A
39
7.5
A
28
A
TA=25°C
IDSM
A
TA=70°C
ID
43
30
TC=25°C
TC=100°C
Power Dissipation B
PD
W
Power Dissipation A
PDSM
W
TA=70°C
100
1.9
TA=25°C
Maximum Junction-to-Case
°C/W
°C/W
Maximum Junction-to-Ambient A D
1
42
1.5
Rev1 : May 2012 
www.aosmd.com
Page 1 of 7       

<!-- detected tables -->

| AOD4126/AOI4126 100V N-Channel MOSFET SDMOS TM |  |  |  |  |
|---|---|---|---|---|
|  |  |  |  |  |
|  |  |  |  |  |
| General Description The AOD4126&AOI4126 are fabricated with SDMOSTM trench technology that combines excellent R with DS(ON) low gate charge.The result is outstanding efficiency with controlled switching behavior. This universal technology is well suited for PWM, load switching and general purpose applications. |  |  | Product Summary V 100V DS I (at V =10V) 43A D GS R (at V =10V) < 24mΩ DS(ON) GS R (at V = 7V) < 30mΩ DS(ON) GS 100% UIS Tested 100% R Tested g |  |
| TO252 DPAK TO-251A D IPAK Top View Bottom View Top View Bottom View D D D G S G S G S D G S G D S |  |  |  |  |
| Absolute Maximum Ratings T =25°C unless otherwise noted A |  |  |  |  |
| Parameter |  | Symbol | Maximum | Units |
| Drain-Source Voltage |  | V DS | 100 | V |
| Gate-Source Voltage |  | V GS | ±25 | V |
| Continuous Drain Current B | T =25°C C | I D | 43 | A |
|  | T =100°C C |  | 30 |  |
| Pulsed Drain Current C |  | I DM | 100 |  |
| Continuous Drain Current A | T =25°C A | I DSM | 7.5 | A |
|  | T =70°C A |  | 6 |  |
| Avalanche Current C |  | I , I AS AR | 28 | A |
| Avalanche energy L=0.1mH C |  | E , E AS AR | 39 | mJ |
| Power Dissipation B | T =25°C C | P D | 100 | W |
|  | T =100°C C |  | 50 |  |
| Power Dissipation A | T =25°C A | P DSM | 3 | W |
|  | T =70°C A |  | 1.9 |  |
| Junction and Storage Temperature Range |  | T, T J STG | -55 to 175 | °C |

| Thermal Characteristics |  |  |  |  |  |
|---|---|---|---|---|---|
| Parameter |  | Symbol | Typ | Max | Units |
| Maximum Junction-to-Ambient A t ≤ | 10s | R θJA | 8 | 10 | °C/W |
| Maximum Junction-to-Ambient A D St | eady-State |  | 35 | 42 | °C/W |
| Maximum Junction-to-Case St | eady-State | R θJC | 1 | 1.5 | °C/W |
--- [PAGE 2] ---
           
AOD4126/AOI4126   
Symbol
Min
Typ
Max
Units
BVDSS
100
V
VDS=100V, VGS=0V
10
TJ=55°C
50
IGSS
100
nA
VGS(th)
Gate Threshold Voltage
2
3.3
4
V
ID(ON)
100
A
19
24
TJ=125°C
36
43
23.5
30
mΩ
gFS
34
S
VSD
0.66
1
V
IS
40
A
Ciss
1400
1770
2200
pF
Coss
115
165
214
pF
Crss
33
55
80
pF
Rg
0.3
0.65
1.0
Ω
Qg
14
28
42
nC
Qgs
4
9
14
nC
Qgd
6
10
14
nC
tD(on)
12
ns
tr
4
ns
Maximum Body-Diode Continuous Current
Input Capacitance
Output Capacitance
Turn-On DelayTime
DYNAMIC PARAMETERS
Turn-On Rise Time
VGS=10V, VDS=50V, RL=2.5Ω,
R
3
Gate resistance
VGS=0V, VDS=0V, f=1MHz
Total Gate Charge
VGS=10V, VDS=50V, ID=20A
Gate Source Charge
Gate Drain Charge
RDS(ON)
Static Drain-Source On-Resistance
mΩ
IS=1A,VGS=0V
VDS=5V, ID=20A
VGS=7V, ID=15A
VDS=VGS  ID=250µA
VDS=0V, VGS= ±25V
Zero Gate Voltage Drain Current
Gate-Body leakage current
Forward Transconductance
Diode Forward Voltage
Electrical Characteristics (TJ=25°C unless otherwise noted)
STATIC PARAMETERS
Parameter
Conditions
IDSS
µA
Drain-Source Breakdown Voltage
On state drain current
ID=250µA, VGS=0V
VGS=10V, VDS=5V
VGS=10V, ID=20A
Reverse Transfer Capacitance
VGS=0V, VDS=50V, f=1MHz
SWITCHING PARAMETERS
tD(off)
17
ns
tf
5
ns
trr
12
20
26
ns
Qrr
60
82
110
nC
COMPONENTS IN LIFE SUPPORT DEVICES OR SYSTEMS ARE NOT AUTHORIZED. AOS DOES NOT ASSUME ANY LIABILITY ARISING
OUT OF SUCH APPLICATIONS OR USES OF ITS PRODUCTS.  AOS RESERVES THE RIGHT TO IMPROVE PRODUCT DESIGN,
FUNCTIONS AND RELIABILITY WITHOUT NOTICE.
Body Diode Reverse Recovery Charge IF=20A, dI/dt=500A/µs
Turn-Off DelayTime
RGEN=3Ω
Turn-Off Fall Time
Body Diode Reverse Recovery Time
IF=20A, dI/dt=500A/µs
A. The value of RθJA is measured with the device mounted on 1in2 FR-4 board with 2oz. Copper, in a still air environment with TA =25°C. The 
Power dissipation PDSM is based on R θJA and the maximum allowed junction temperature of 150°C. The value in any given application depends 
on the user's specific board design, and the maximum temperature of 175°C may be used if the PCB allows it.
B. The power dissipation PD is based on TJ(MAX)=175°C, using junction-to-case thermal resistance, and is more useful in setting the upper 
dissipation limit for cases where additional heatsinking is used. 
C. Repetitive rating, pulse width limited by junction temperature TJ(MAX)=175°C. Ratings are based on low frequency and duty cycles to keep 
initial TJ =25°C.
D. The RθJA is the sum of the thermal impedence from junction to case RθJC and case to ambient.
E. The static characteristics in Figures 1 to 6 are obtained using <300µs pulses, duty cycle 0.5% max.
F. These curves are based on the junction-to-case thermal impedence which is measured with the device mounted to a large heatsink, assuming 
a maximum junction temperature of TJ(MAX)=175°C. The SOA curve provides a single pulse rating. 
G. These tests are performed with the device mounted on 1 in2 FR-4 board with 2oz. Copper, in a still air environment with TA=25°C. 
          Rev 1 : May  2012 
www.aosmd.com
Page 2 of 7       

<!-- detected tables -->

| Symbol | Parameter | Conditions |  | Min | Typ | Max | Units |
|---|---|---|---|---|---|---|---|
| STATIC PARAMETERS |  |  |  |  |  |  |  |
| BV DSS | Drain-Source Breakdown Voltage | I =250µA, V =0V D GS |  | 100 |  |  | V |
| I DSS | Zero Gate Voltage Drain Current | V =100V, V =0V DS GS T=55°C J |  |  |  | 10 | µA |
|  |  |  | T=55°C J |  |  | 50 |  |
| I GSS | Gate-Body leakage current | V =0V, V = ±25V DS GS |  |  |  | 100 | nA |
| V GS(th) | Gate Threshold Voltage | V =V I =250µA DS GS D |  | 2 | 3.3 | 4 | V |
| I D(ON) | On state drain current | V =10V, V =5V GS DS |  | 100 |  |  | A |
| R DS(ON) | Static Drain-Source On-Resistance | V =10V, I =20A GS D T=125°C J |  |  | 19 | 24 | mΩ |
|  |  |  | T=125°C J |  | 36 | 43 |  |
|  |  | V =7V, I =15A GS D |  |  | 23.5 | 30 | mΩ |
| g FS | Forward Transconductance | V =5V, I =20A DS D |  |  | 34 |  | S |
| V SD | Diode Forward Voltage | I =1A,V =0V S GS |  |  | 0.66 | 1 | V |
| I S | Maximum Body-Diode Continuous Current |  |  |  |  | 40 | A |
| DYNAMIC PARAMETERS |  |  |  |  |  |  |  |
| C I iss | nput Capacitance | V =0V, V =50V, f=1MHz GS DS |  | 1400 | 1770 | 2200 | pF |
| C oss | Output Capacitance |  |  | 115 | 165 | 214 | pF |
| C rss | Reverse Transfer Capacitance |  |  | 33 | 55 | 80 | pF |
| R g | Gate resistance | V =0V, V =0V, f=1MHz GS DS |  | 0.3 | 0.65 | 1.0 | Ω |
| SWITCHING PARAMETERS |  |  |  |  |  |  |  |
| Q g | Total Gate Charge | V =10V, V =50V, I =20A GS DS D |  | 14 | 28 | 42 | nC |
| Q gs | Gate Source Charge |  |  | 4 | 9 | 14 | nC |
| Q gd | Gate Drain Charge |  |  | 6 | 10 | 14 | nC |
| t D(on) | Turn-On DelayTime | V =10V, V =50V, R =2.5Ω, GS DS L R =3 Ω GEN |  |  | 12 |  | ns |
| t r | Turn-On Rise Time |  |  |  | 4 |  | ns |
| t D(off) | Turn-Off DelayTime |  |  |  | 17 |  | ns |
| t f | Turn-Off Fall Time |  |  |  | 5 |  | ns |
| t rr | Body Diode Reverse Recovery Time | I =20A, dI/dt=500A/µs F |  | 12 | 20 | 26 | ns |
| Q rr | Body Diode Reverse Recovery Charge | I =20A, dI/dt=500A/µs F |  | 60 | 82 | 110 | nC |
--- [PAGE 3] ---
           
AOD4126/AOI4126   
TYPICAL ELECTRICAL AND THERMAL CHARACTERISTICS
17
5
2
10
0
18
0
10
20
30
40
50
60
3
4
5
6
7
ID(A)
VGS(Volts)
Figure 2: Transfer Characteristics (Note E)
15
18
21
24
27
30
0
5
10
15
20
25
30
35
40
RDS(ON) (mΩ)
ID (A)
Figure 3: On-Resistance vs. Drain Current and Gate 
Voltage (Note E)
0.8
1
1.2
1.4
1.6
1.8
2
2.2
2.4
0
25
50
75
100
125
150
175
200
Normalized On-Resistance
Temperature (°C)
Figure 4: On-Resistance vs. Junction Temperature 
(Note E)
VGS=7V
ID=15A
VGS=10V
ID=20A
25°C
125°C
VDS=5V
VGS=7V
VGS=10V
0
20
40
60
0
1
2
3
4
5
ID (A)
VDS (Volts)
Fig 1: On-Region Characteristics (Note E)
VGS=6V
6.5V
8V
10V
7V
40
Voltage (Note E)
1.0E-05
1.0E-04
1.0E-03
1.0E-02
1.0E-01
1.0E+00
1.0E+01
1.0E+02
0.0
0.2
0.4
0.6
0.8
1.0
1.2
IS (A)
VSD (Volts)
Figure 6: Body-Diode Characteristics (Note E)
25°C
125°C
(Note E)
10
20
30
40
50
6
7
8
9
10
RDS(ON) (mΩ)
VGS (Volts)
Figure 5: On-Resistance vs. Gate-Source Voltage 
(Note E)
ID=20A
25°C
125°C
          Rev 1: May 2012 
www.aosmd.com
Page 3 of 7       

<!-- detected tables -->

|  | A |  |  |  |  |  |
|---|---|---|---|---|---|---|
|  |  |  |  |  |  |  |
|  |  |  |  |  |  |  |
|  | ECTRICAL AND THERMAL CHARACTERISTICS 60 10V 8V 7V V DS=5V 50 40 6.5V 30 (A) D I 20 125°C V GS=6V 10 0 |  |  |  |  |  |
|  |  |  | 6.5V |  |  |  |
|  |  |  |  |  |  |  |
|  |  |  | V =6V GS |  | 125°C |  |

| 0 Fi | 1 2 3 4 5 3 4 5 6 7 g 1: On-RegioV nD CS h(V ao ralt cs t) eristics (Note E) Figure 2: TransfeV rG CS( hV ao rl ats c) teristics (Note E) |  |
|---|---|---|
| 30 27 (mΩ) 24 DS(ON) 21 R 18 15 0 Fi | V =7V GS V =10V GS 5 10 15 20 25 30 35 40 I (A) D gure 3: On-Resistance vs. Drain Current and Gate Voltage (Note E) | 2.4 2.2 On-Resistance V =10V 2 IG =S 20A D 1.8 17 1.6 5 Normalized 1.4 2 V GS=7V 10 1.2 I =15A D 1 0.8 0 25 50 75 100 125 150 175 200 Temperature (°C) 0 Figure 4: On-Resistance vs. Junction1 8Temperature (Note E) |
|  |  | 1.0E+02 1.0E+01 1.0E4+000 125°C 1.0E-01 (A) 1.0E-02 I S 25°C 1.0E-03 1.0E-04 1.0E-05 0.0 0.2 0.4 0.6 0.8 1.0 1.2 V (Volts) SD Figure 6: Body-Diode Characteristics (Note E) |
| 50 I =20A D 40 125°C (mΩ) 30 DS(ON) R 20 25°C 10 6 7 8 9 10 V (Volts) GS Figure 5: On-Resistance vs. Gate-Source Voltage (Note E) |  |  |

|  |  |  |  |  |  |
|---|---|---|---|---|---|
|  | V |  |  |  |  |
|  |  | =7V GS |  |  |  |
|  |  |  |  |  |  |
|  |  |  |  |  |  |
|  |  | V |  |  |  |
|  |  |  | =10V GS |  |  |
|  |  |  |  |  |  |

|  |  | I D | =20A |
|---|---|---|---|
|  |  | 125°C |  |
|  |  |  |  |
|  | 25°C |  |  |

| I D | =20A |
|---|---|
--- [PAGE 4] ---
           
AOD4126/AOI4126   
TYPICAL ELECTRICAL AND THERMAL CHARACTERISTICS
17
5
2
10
0
18
0
2
4
6
8
10
0
5
10
15
20
25
30
VGS (Volts)
Qg (nC)
Figure 7: Gate-Charge Characteristics
0
500
1000
1500
2000
2500
0
20
40
60
80
100
Capacitance (pF)
VDS (Volts)
Figure 8: Capacitance Characteristics
Ciss
0
200
400
600
800
1000
0.0001
0.001
0.01
0.1
1
10
Power (W)
Pulse Width (s)
Figure 10: Single Pulse Power Rating Junction-to-
Coss
Crss
VDS=50V
ID=20A
TJ(Max)=175°C
TC=25°C
10µs
0.0
0.1
1.0
10.0
100.0
1000.0
0.01
0.1
1
10
100
1000
ID (Amps)
VDS (Volts)
Figure 9: Maximum Forward Biased Safe 
10µs
10ms
1ms
DC
RDS(ON) 
limited
TJ(Max)=175°C
TC=25°C
100µs
40
Case (Note F)
0.01
0.1
1
10
0.00001
0.0001
0.001
0.01
0.1
1
10
ZθJC Normalized Transient 
Thermal Resistance
Pulse Width (s)
Figure 11: Normalized Maximum Transient Thermal Impedance (Note F)
Single Pulse
D=Ton/T
TJ,PK=TC+PDM.ZθJC.RθJC
Ton
T
PD
In descending order
D=0.5, 0.3, 0.1, 0.05, 0.02, 0.01, single pulse
Operating Area (Note F)
RθJC=1.5°C/W
          Rev 1: May 2012
www.aosmd.com
Page 4 of 7       

<!-- detected tables -->

|  |  |  |  |
|---|---|---|---|
|  |  |  |  |
|  |  |  | C iss C rss 0 40 60 80 100 V (Volts) DS e 8: Capacitance Characteristics |
|  | 1000.0 100.0 10µs 10µs R DS(ON) 10.0 limited 100µs (Amps) 1ms 1.0 DC 10ms I D 0.1 T =175°C J(Max) T =25°C C 0.0 0.01 0.1 1 10 100 1000 V (Volts) DS Figure 9: Maximum Forward Biased Safe Operating Area (Note F) | 1000 T =175°C J(Max) T =25°C 800 C 600 17 (W) 5 Power 400 2 10 200 0 0.0001 0.001 0.01 0.1 1 10 0 Pulse Width (s) 18 Figure 10: Single Pulse Power Rating Junction-to- Case (Note F) |  |
|  | 10 D=T /T In descending order T o =n T +P .Z .R D=0.5, 0.3, 0.1, 0.05, 0.02, 0.01, single pulse Transient J,PK C DM θJC θJC Resistance R =1.5°C/W 40 θJC 1 Normalized Thermal 0.1 P θJC Single Pulse D Z T on T 0.01 0.00001 0.0001 0.001 0.01 0.1 1 10 Pulse Width (s) Figure 11: Normalized Maximum Transient Thermal Impedance (Note F) |  |  |
|  |  |  |  |
|  |  |  |  |
|  |  |  |  |

| V D I = D | =50V S 20A |  |  |  |
|---|---|---|---|---|
|  |  |  |  |  |
|  |  |  |  |  |
|  |  |  |  |  |
|  |  |  |  |  |

|  |  |
|---|---|
| C iss |  |
|  |  |
| C rss |  |
|  |  |

|  |  |  |  |  |
|---|---|---|---|---|
|  |  | 1 | 0µs |  |
| R |  |  | 1 | 0µs |
| DS(ON) limited |  |  | 1 | 00µs |
|  |  |  | 1 1 | ms 0ms |
|  | D | C |  |  |
| T =17 J(Max) | 5°C |  |  |  |
| T =25°C C |  |  |  |  |

| T =175° J(Max) T =25°C C | C |
|---|---|
| 1 | 7 |
|  | 5 2 |
| 1 | 0 |
|  |  |

| D=T /T on |  |  | In desce | nding | order |  |  |
|---|---|---|---|---|---|---|---|
|  |  |  | D=0.5, 0 | .3, 0. | 1, 0.05, 0.02, 0.01, sin | gle pulse |  |
| T =T +P J,PK C D | .Z .R M θJC θJC |  |  |  |  |  |  |
|  |  |  |  |  |  |  |  |
| R =1.5°C θJC | /W |  |  |  | 40 |  |  |
|  |  |  |  |  |  |  |  |
|  |  |  |  |  |  |  |  |
|  |  |  |  |  |  | P D |  |
|  | Single Pu | lse |  |  |  |  |  |
|  |  |  |  |  |  | T on T |  |
|  |  |  |  |  |  |  |  |
--- [PAGE 5] ---
           
AOD4126/AOI4126   
TYPICAL ELECTRICAL AND THERMAL CHARACTERISTICS
17
5
2
10
0
18
10
100
0.000001
0.00001
0.0001
0.001
IAR (A) Peak Avalanche Current 
Time in avalanche, tA (s)
Figure 12: Single Pulse Avalanche capability
(Note C) 
0
30
60
90
120
0
25
50
75
100
125
150
175
Power Dissipation (W)
TCASE (°C)
Figure 13: Power De-rating (Note F)
0
10
20
30
40
50
60
0
25
50
75
100
125
150
175
Current rating ID(A)
TCASE (°C)
Figure 14: Current De rating (Note F)
TA=25°C
1
10
100
1000
0.01
1
100
Power (W)
Pulse Width (s)
Figure 15: Single Pulse Power Rating Junction-to-
TA=25°C
TA=150°C
TA=100°C
TA=125°C
40
0.001
0.01
0.1
1
10
0.00001
0.0001
0.001
0.01
0.1
1
10
100
1000
ZθJA Normalized Transient 
Thermal Resistance
Pulse Width (s)
Figure 16: Normalized Maximum Transient Thermal Impedance (Note H)
Single Pulse
D=Ton/T
TJ,PK=TA+PDM.ZθJA.RθJA
Ton
T
PD
In descending order
D=0.5, 0.3, 0.1, 0.05, 0.02, 0.01, single pulse
Figure 14: Current De-rating (Note F)
Figure 15: Single Pulse Power Rating Junction-to-
Ambient (Note H)
RθJA=42°C/W
          Rev 1: May 2012 
www.aosmd.com
Page 5 of 7       

<!-- detected tables -->

| 100 Current T =25°C Avalanche A T =100°C A Peak (A) T A=150°C T A=125°C AR I 10 0.000001 0.00001 0.0001 0.001 Time in avalanche, t (s) A Figure 12: Single Pulse Avalanche capability (Note C) | 120 (W) 90 Dissipation 60 Power 30 0 0 25 50 75 100 125 150 175 T (°C) CASE Figure 13: Power De-rating (Note F) |  |
|---|---|---|
| 60 50 (A) 40 D I rating 30 Current 20 10 0 0 25 50 75 100 125 150 175 T (°C) CASE Figure 14: Current De -rating (Note F) | 1000 T =25°C A 100 17 (W) 5 Power 2 10 10 1 0.01 1 1000 Pulse Width (s) 18 Figure 15: Single Pulse Power Rating Junction-to- Ambient (Note H) |  |
|  |  |  |
| 10 D=T on/T In descending order T =T +P .Z .R D=0.5, 0.3, 0.1, 0.05, 0.02, 0.01, single pulse J,PK A DM θJA θJA Transient 1 R θJA=42°C/W 40 Resistance Normalized 0.1 Thermal P 0.01 D θJA Single Pulse Z T on T 0.001 0.00001 0.0001 0.001 0.01 0.1 1 10 100 1000 Pulse Width (s) Figure 16: Normalized Maximum Transient Thermal Impedance (Note H) |  |  |

|  |  |  |  |  |  |
|---|---|---|---|---|---|
|  |  |  |  |  |  |
|  |  |  |  |  |  |
|  |  |  |  |  |  |
|  |  |  |  |  |  |
|  | T | =25°C A |  |  |  |
|  |  | T = A |  | 100 | °C |
|  |  |  |  |  |  |
| T A | =150°C | T |  |  |  |
|  |  |  | T | =12 A | 5°C |
|  |  |  |  |  |  |

|  |  | T = A | 25°C |
|---|---|---|---|
|  |  |  | 17 5 2 10 |
|  |  |  |  |

| D=T /T on T =T + | P .Z .R |  |  |  | In des D=0.5 | cendin , 0.3, 0 | g order .1, 0.05, 0.02, 0.01, | single pulse |  |  |  |  |
|---|---|---|---|---|---|---|---|---|---|---|---|---|
| J,PK A | DM θJA θJA |  |  |  |  |  |  |  |  |  |  |  |
| R =42° θJA | C/W |  |  |  |  |  | 40 |  |  |  |  |  |
|  |  |  |  |  |  |  |  |  |  |  |  |  |
|  |  |  |  |  |  |  |  |  |  |  |  |  |
|  |  | Singl | e P | ulse |  |  |  | P D |  |  |  |  |
|  |  |  |  |  |  |  |  | T on |  |  |  |  |
|  |  |  |  |  |  |  |  | T |  |  |  |  |
--- [PAGE 6] ---
           
AOD4126/AOI4126   
TYPICAL ELECTRICAL AND THERMAL CHARACTERISTICS
0
3
6
9
12
15
50
100
150
200
250
300
0
5
10
15
20
25
30
Irm (A)
Qrr (nC)
IS (A)
Figure 17: Diode Reverse Recovery Charge and Peak 
Current vs. Conduction Current
di/dt=800A/µs
125ºC
125ºC
25ºC
25ºC
Qrr
Irm
-2
2
6
10
14
18
22
26
30
0
30
60
90
120
150
0
200
400
600
800
1000
Irm (A)
Qrr (nC)
di/dt (A/µs)
Figure 19: Diode Reverse Recovery Charge and Peak 
Current vs. di/dt
125ºC
125ºC
25ºC
25ºC
Is=20A
Qrr
Irm
0
0.2
0.4
0.6
0.8
1
1.2
1.4
1.6
1.8
2
0
4
8
12
16
20
24
0
5
10
15
20
25
30
S 
trr (ns)
IS (A)
Figure 18: Diode Reverse Recovery Time and 
Softness Factor vs. Conduction Current
di/dt=800A/µs
125ºC
125ºC
25ºC
25ºC
trr
S
0
0.5
1
1.5
2
2.5
3
0
6
12
18
24
30
0
200
400
600
800
1000
S 
trr (ns)
di/dt (A/µs)
Figure 20: Diode Reverse Recovery Time and 
Softness Factor vs. di/dt
125ºC
25ºC
25ºC
125ºC
Is=20A
trr
S
          Rev 1: May 2012 
www.aosmd.com
Page 6 of 7       

<!-- detected tables -->

| 300 15 di/dt=800A/µs 125ºC 250 12 200 9 25ºC (nC) (A) I rm rr rm 150 6 Q I 125ºC 100 3 Q rr 25ºC 50 0 0 5 10 15 20 25 30 I (A) S Figure 17: Diode Reverse Recovery Charge and Peak Current vs. Conduction Current |  | 24 2 125ºC 1.8 20 di/dt=800A/µs 1.6 1.4 16 t 25ºC rr 1.2 (ns) 12 1 S rr 0.8 t 8 0.6 S 125ºC 0.4 4 0.2 25ºC 0 0 0 5 10 15 20 25 30 I (A) S Figure 18: Diode Reverse Recovery Time and Softness Factor vs. Conduction Current |
|---|---|---|
|  |  |  |
| 150 30 I s=20A 125ºC 26 120 22 90 18 25ºC (nC) (A) 14 60 Q rr 125ºC 10 Q rr I rm 6 30 25ºC I rm 2 0 -2 0 200 400 600 800 1000 di/dt (A/µs) Figure 19: Diode Reverse Recovery Charge and Peak Current vs. di/dt |  |  |
|  |  |  |

| 125ºC |  |
|---|---|
|  |  |
| 25ºC |  |
| 125ºC |  |
| 25ºC |  |

| di/d |  |  | 1 /µs |  |  |  |
|---|---|---|---|---|---|---|
|  |  |  |  | 25ºC |  |  |
|  | di/d | t=800A |  |  |  |  |
|  |  |  |  |  |  |  |
| t rr |  |  |  |  | 25ºC |  |
|  |  |  |  |  |  |  |
|  |  |  |  |  |  |  |
| S |  |  | 1 | 25ºC |  |  |
|  |  |  |  | 25ºC |  |  |

| 125ºC |  |
|---|---|
|  |  |
| 25 125ºC | ºC |
|  |  |
| 25ºC |  |

|  | 1 | 25ºC | I=20A s |
|---|---|---|---|
|  |  |  |  |
|  | 25ºC |  | t rr |
|  |  |  |  |
|  |  |  |  |
| 1 | 25ºC |  | S |
|  | 25ºC |  |  |
--- [PAGE 7] ---
           
AOD4126/AOI4126    
-
+
VDC
Ig
Vds
DUT
-
+
VDC
Vgs
Vgs
10V
Qg
Qgs
Qgd
Charge
Gate Charge Test Circuit & Waveform
-
+
VDC
DUT
Vdd
Vgs
Vds
Vgs
RL
Rg
Vgs
Vds
10%
90%
Resistive Switching Test Circuit & Waveforms
t
tr
d(on)
ton
td(off)
tf
toff
Id
L
Vds
BV
Unclamped Inductive Switching (UIS) Test Circuit & Waveforms
Vds
DSS
2
E   = 1/2 LIAR
AR
Vdd
Vgs
Vgs
Rg
DUT
-
+
VDC
Vgs
Id
Vgs
I
Ig
Vgs
-
+
VDC
DUT
L
Vgs
Vds
Isd
Isd
Diode Recovery Test Circuit & Waveforms
Vds -
Vds +
I F
AR
dI/dt
I RM
rr
Vdd
Vdd
Q   = -   Idt
trr
          Rev 1: May 2012 
www.aosmd.com
Page 7 of 7       

<!-- detected tables -->

| + - Vgs Ig | + VDC DUT |
|---|---|

| Vds Id gs DUT | Vgs VDC |
|---|---|

| Q = - Idt rr Vgs |  |
|---|---|
| Vgs |  |
| t sd I rr F dI/dt |  |
| I RM ds |  |
