e1aco/ELACO_StepMotorTMC5160/Firmware/TMC5160_StepMotor/.cl/datasheet/TMC5160A_Datasheet_Rev1_13_CN_ch02_section.md

# TMC5160A_Datasheet_Rev1_13_CN — 第2章 引脚分配

--- [PAGE 14] ---
TMC5160 DATASHEET (Rev. 1.08 / 2018-NOV-19)
14
www.trinamic.com
2. 引脚分配
2.1
封装外形
图2.1 TMC 5160 – TA 封装和TQFP - EP 48 引脚(主体7x7mm，9x9mm 带引脚)

--- [PAGE 15] ---
TMC5160 DATASHEET (Rev. 1.08 / 2018-NOV-19)
15
www.trinamic.com
图2.2 TMC 5160 - WA 封装和QFN - WA 引脚( 8 x8mm )
2.2
信号描述
引脚
TQFP
QFN
类型
功能
HB1
1
2
高端栅极驱动器输出。
CB1
2
3
自举电容器正极连接。
12VOUT
3
4
内部电压调节器的11.5V 电压输出,用于栅极驱动器下管的门级
控制。为获得最佳性能，建议接2.2μF 至10μF 陶瓷电容器到引
脚附近的地（地平面）。通常建议容值比自举电容的容值至少
大10 倍。如果功率器件的栅极电压由外部电压供应，将VSA 和
12VOUT 接到外部电源。
VSA
4
5
11.5V和5V稳压器的模拟电源电压。通常与VS相连，滤波电容
100nf。
5VOUT
5
6
内部5V 调节器的输出。为获得最佳性能，建议接2.2μF 至10μF
陶瓷电容器到引脚附近的地GNDA。建议5VOUT 给芯片的VCC
引脚供电。
GNDA
6
7
模拟地。连接到引脚附近的地平面。

<!-- detected tables -->

| 引脚 | TQFP | QFN | 类型 | 功能 |
|---|---|---|---|---|
| HB1 | 1 | 2 |  | 高端栅极驱动器输出。 |
| CB1 | 2 | 3 |  | 自举电容器正极连接。 |
| 12VOUT | 3 | 4 |  | 内部电压调节器的11.5V 电压输出,用于栅极驱动器下管的门级 控制。为获得最佳性能，建议接2.2μF 至10μF 陶瓷电容器到引 脚附近的地（地平面）。通常建议容值比自举电容的容值至少 大10 倍。如果功率器件的栅极电压由外部电压供应，将VSA 和 12VOUT 接到外部电源。 |
| VSA | 4 | 5 |  | 11.5V和5V稳压器的模拟电源电压。通常与VS相连，滤波电容 100nf。 |
| 5VOUT | 5 | 6 |  | 内部5V 调节器的输出。为获得最佳性能，建议接2.2μF 至10μF 陶瓷电容器到引脚附近的地GNDA。建议 5VOUT 给芯片的 VCC 引脚供电。 |
| GNDA | 6 | 7 |  | 模拟地。连接到引脚附近的地平面。 |
--- [PAGE 16] ---
TMC5160 DATASHEET (Rev. 1.08 / 2018-NOV-19)
16
www.trinamic.com
引脚
TQFP
QFN
类型
功能
SRAL
7
8
AI
A 相采样电阻的地。直接连到采样电阻的地，以补偿地互连上
的电压降。
SRAH
8
9
AI
A 相采样电阻。连到采样电阻的上侧。对于高电机电流，开尔
文连接是优选的。可在SRAL 和SRAH 设计对称RC 滤波，以消
除来自其他驱动器或线圈B 开关的高频开关尖峰。
SRBH
9
10
AI
B 相采样电阻。连到采样电阻的上侧。对于高电机电流，开尔文
连接是优选的。可在SRBL 和SRBH 设计对称RC 滤波，以消除来
自其他驱动器或线圈A 开关的高频开关尖峰。
SRBL
10
11
AI
B 相采样电阻的地。直接连到采样电阻的地，以补偿地之间互连
上的电压降。
TST_MODE
11
12
DI
测试模式输入。尽量短的连接到地。
CLK
12
13
DI
时钟输入。如果用内部时钟，请尽量短的连接到地。或者连接
外部时钟。内含时钟故障切换电路防止外部时钟信号丢失。
CSN_CFG3
13
14
DI
SPI_MODE=1：SPI 片选信号(低有效)。
SPI_MODE=0：配置输入脚。
SCK_CFG2
14
15
DI
SPI_MODE=1：SPI 时钟信号。
SPI_MODE=0：配置输入脚。
SDI_CFG1
15
16
DI
SPI_MODE=1：SPI 数据输入信号。
SPI_MODE=0：配置输入脚或
单线接口的下一个地址输入( NAI )。
SDO_CFG0
16
17
DIO
SPI_MODE=1：SPI 数据输出信号。
SPI_MODE=0：配置输入或
单线接口的下一个地址输出( NAO )。
REFL_STEP
17
18
DI
SD_MODE = 0 : 左参考输入(用于内部斜坡发生器)。
SD_MODE = 1 : 步进信号输入。
REFR_DIR
18
19
DI
SD_MODE = 0 : 右参考输入(用于内部斜坡发生器)。
SD_MODE = 1 : 方向信号输入。
GNDD
19,
30
25,
Pad
数字地。连接到引脚附近的地平面。
VCC_IO
20
20
所有数字口IO 的供电电压，3.3V 到5V。

<!-- detected tables -->

| 引脚 | TQFP | QFN | 类型 | 功能 |
|---|---|---|---|---|
| SRAL | 7 | 8 | AI | A 相采样电阻的地。直接连到采样电阻的地，以补偿地互连上 的电压降。 |
| SRAH | 8 | 9 | AI | A 相采样电阻。连到采样电阻的上侧。对于高电机电流，开尔 文连接是优选的。可在 SRAL 和 SRAH 设计对称RC 滤波，以消 除来自其他驱动器或线圈B 开关的高频开关尖峰。 |
| SRBH | 9 | 10 | AI | B 相采样电阻。连到采样电阻的上侧。对于高电机电流，开尔文 连接是优选的。可在SRBL 和SRBH 设计对称RC 滤波，以消除来 自其他驱动器或线圈A 开关的高频开关尖峰。 |
| SRBL | 10 | 11 | AI | B 相采样电阻的地。直接连到采样电阻的地，以补偿地之间互连 上的电压降。 |
| TST MODE _ | 11 | 12 | DI | 测试模式输入。尽量短的连接到地。 |
| CLK | 12 | 13 | DI | 时钟输入。如果用内部时钟，请尽量短的连接到地。或者连接 外部时钟。内含时钟故障切换电路防止外部时钟信号丢失。 |
| CSN CFG3 _ | 13 | 14 | DI | SPI MODE=1：SPI 片选信号(低有效)。 _ SPI MODE=0：配置输入脚。 _ |
| SCK CFG2 _ | 14 | 15 | DI | SPI MODE=1：SPI 时钟信号。 _ SPI MODE=0：配置输入脚。 _ |
| SDI CFG1 _ | 15 | 16 | DI | SPI MODE=1：SPI 数据输入信号。 _ SPI MODE=0：配置输入脚或 _ 单线接口的下一个地址输入( NAI )。 |
| SDO CFG0 _ | 16 | 17 | DIO | SPI MODE=1：SPI 数据输出信号。 _ SPI MODE=0：配置输入或 _ 单线接口的下一个地址输出( NAO )。 |
| REFL STEP _ | 17 | 18 | DI | SD MODE = 0 : 左参考输入(用于内部斜坡发生器)。 _ SD MODE = 1 : 步进信号输入。 _ |
| REFR DIR _ | 18 | 19 | DI | SD MODE = 0 : 右参考输入(用于内部斜坡发生器)。 _ SD MODE = 1 : 方向信号输入。 _ |
| GNDD | 19, 30 | 25, Pad |  | 数字地。连接到引脚附近的地平面。 |
| VCC IO _ | 20 | 20 |  | 所有数字口IO 的供电电压，3.3V 到5V。 |
--- [PAGE 17] ---
TMC5160 DATASHEET (Rev. 1.08 / 2018-NOV-19)
17
www.trinamic.com
引脚
TQFP
QFN
类型
功能
SD_MODE
21
21
DI
模式选择输入。
SD_MODE =0 : 内部斜坡发生器产生步进信号。
SD_MODE = 1 : STEP / DIR 输入引脚控制驱动器
SD _ MODE = 0 和SPI _ MODE = 0 使能UART 操作。
SPI_MODE
22
22
DI
(pd)
模式选择脚。
SPI_MODE =0 : 芯片为独立模式，引脚为CFG 功能脚。
SPI_MODE = 1 :使能SPI 接口。
内部集成下拉电阻。
ENCB_DCEN_
CFG4
23
23
DI
(pd)
SD_MOD=0：内部斜坡发生器模式下的编码器B 通道输入脚。
SD _ MODE = 1，SPI_MODE = 1 : DcStep 使能输入脚。如果不需
要使能DcStep，将该引脚开路或者接到地, 以确保正常工作。
SPI_MODE=0：CFG 配置引脚。
ENCA_DCIN_
CFG5
24
24
DI
(pd)
SD_MODE=0：内部斜坡发生器模式下的编码器A 通道输入脚。
SD _MODE =1，SPI_MODE = 1 : DcStep 信号，用于同步控制。
SPI_MODE=0：CFG 配置引脚。
ENCN_DCO_
CFG6
25
26
DIO
SD_MODE =0 : 编码器N 信号输入脚。
SD_MOD = 1：DcStep 就绪输出信号。
SD_MODE=0，如果不接编码器，将该信号拉高或者接地。
DIAG0_SWN
26
27
DIO
(pu+
pd)
诊断输出信号DIAG0。
SD_MODE=0, SPI_MODE=1：内部斜坡发生器模式下的中断输出
或步进输出。在漏极开路模式下，使用47k 或更小的外部上拉
电阻。
SD_MODE=0 , SPI_MODE=0：单线I / O 通讯的负端信号
DIAG1_SWP
27
28
DIO
(pd)
诊断输出信号DIAG1。
SD_MODE=0, SPI_MODE=1：内部斜坡发生器模式下的位置比较
输出或方向输出。在漏极开路模式下，使用47k 或更小的外部
上拉电阻
SD_MODE=0 , SPI_MODE=0：单线I / O 通讯的正端信号
DRV_ENN
28
29
DI
使能输入。当该引脚被驱动到高电平时，功率MOSFET 输出关
闭(所有电机输出为悬浮（FLOATING）状态)。

<!-- detected tables -->

| 引脚 | TQFP | QFN | 类型 | 功能 |
|---|---|---|---|---|
| SD MODE _ | 21 | 21 | DI | 模式选择输入。 SD MODE =0 : 内部斜坡发生器产生步进信号。 _ SD MODE = 1 : STEP / DIR 输入引脚控制驱动器 _ SD MODE = 0 和SPI MODE = 0 使能UART 操作。 _ _ |
| SPI MODE _ | 22 | 22 | DI (pd) | 模式选择脚。 SPI MODE =0 : 芯片为独立模式，引脚为CFG 功能脚。 _ SPI MODE = 1 :使能SPI 接口。 _ 内部集成下拉电阻。 |
| ENCB DCEN _ _ CFG4 | 23 | 23 | DI (pd) | SD MOD=0：内部斜坡发生器模式下的编码器B 通道输入脚。 _ SD MODE = 1，SPI MODE = 1 : DcStep 使能输入脚 。如果不需 _ _ 要使能DcStep，将该引脚开路或者接到地, 以确保正常工作。 SPI MODE=0：CFG 配置引脚。 _ |
| ENCA DCIN _ _ CFG5 | 24 | 24 | DI (pd) | SD MODE=0：内部斜坡发生器模式下的编码器A 通道输入脚。 _ SD MODE =1，SPI MODE = 1 : DcStep 信号，用于同步控制。 _ _ SPI MODE=0：CFG 配置引脚。 _ |
| ENCN DCO _ _ CFG6 | 25 | 26 | DIO | SD MODE =0 : 编码器N 信号输入脚。 _ SD MOD = 1：DcStep 就绪输出信号。 _ SD MODE=0，如果不接编码器，将该信号拉高或者接地。 _ |
| DIAG0 SWN _ | 26 | 27 | DIO (pu+ pd) | 诊断输出信号DIAG0。 SD MODE=0, SPI MODE=1：内部斜坡发生器模式下的中断输出 _ _ 或步进输出。在漏极开路模式下，使用47k 或更小的外部上拉 电阻。 SD MODE=0 , SPI MODE=0：单线I / O 通讯的负端信号 _ _ |
| DIAG1 SWP _ | 27 | 28 | DIO (pd) | 诊断输出信号DIAG1。 SD MODE=0, SPI MODE=1：内部斜坡发生器模式下的位置比较 _ _ 输出或方向输出。在漏极开路模式下，使用47k 或更小的外部 上拉电阻 SD MODE=0 , SPI MODE=0：单线I / O 通讯的正端信号 _ _ |
| DRV ENN _ | 28 | 29 | DI | 使能输入。当该引脚被驱动到高电平时，功率MOSFET 输出关 闭(所有电机输出为悬浮（FLOATING）状态)。 |
--- [PAGE 18] ---
TMC5160 DATASHEET (Rev. 1.08 / 2018-NOV-19)
18
www.trinamic.com
引脚
TQFP
QFN
类型
功能
VCC
29
30
芯片内5V 数字电路的电源输入。建议接100nf 或更大的电容到
就近的地平面。应该由5VOUT 作为VCC 的输入，建议加2.2 或
3.3 欧姆电阻作为与5VOUT 的噪声去耦。如果使用外部电源供
电，请确保VCC 在5VOUT 或VCC _ IO 之前或同时上电！
CPO
31
31
电荷泵电容输出
CPI
32
32
电荷泵电容输入。22nF /100V 电容连接到CPO。
VS
33
33
电机电源电压。引脚与地平面之间需要滤波电容。必须连到功
率器件MOSFET 的上桥臂供电电压。
VCP
34
34
电荷泵电压。100nf 电容与VS 相连。
CA2
35
35
自举电容器正端
HA2
36
36
高端栅极驱动器输出。
BMA2
37
37
桥臂中间节点和自举电容器负端连接
LA2
38
38
低端栅极驱动器输出。
LA1
39
39
低端栅极驱动器输出。
BMA1
40
40
桥臂中间节点和自举电容器负端连接
HA1
41
41
高端栅极驱动器输出。
CA1
42
42
自举电容器正端连接
CB2
43
43
自举电容器正端连接
HB2
44
44
高端栅极驱动器输出。
BMB2
45
45
桥臂中间节点和自举电容器负端连接
LB2
46
46
低端栅极驱动器输出。
LB1
47
47
低端栅极驱动器输出。
BMB1
48
1
桥臂中间节点和自举电容器负端连接
Exposed die
pad
-
-
将裸露的管芯焊盘连接到地平面。提供尽可能多的通孔以将热
传递到地平面。也用作低端栅极驱动器的地引脚。确保采样电
阻地的环路电感尽量低。
* ( PD )代表有下拉电阻的引脚。
*所有数字引脚DI、DIO 和DO 都使用VCC _ IO 电平，并内置接地和VCC _ IO 的保护二极管。
*所有数字输入DI 和DIO 都内置施密特触发器。

<!-- detected tables -->

| 引脚 | TQFP | QFN | 类型 | 功能 |
|---|---|---|---|---|
| VCC | 29 | 30 |  | 芯片内5V 数字电路的电源输入。建议接100nf 或更大的电容到 就近的地平面。应该由5VOUT 作为VCC 的输入，建议加2.2 或 3.3 欧姆电阻作为与 5VOUT 的噪声去耦。如果使用外部电源供 电，请确保VCC 在5VOUT 或VCC IO 之前或同时上电！ _ |
| CPO | 31 | 31 |  | 电荷泵电容输出 |
| CPI | 32 | 32 |  | 电荷泵电容输入。22nF /100V 电容连接到CPO。 |
| VS | 33 | 33 |  | 电机电源电压。引脚与地平面之间需要滤波电容。必须连到功 率器件MOSFET 的上桥臂供电电压。 |
| VCP | 34 | 34 |  | 电荷泵电压。100nf 电容与VS 相连。 |
| CA2 | 35 | 35 |  | 自举电容器正端 |
| HA2 | 36 | 36 |  | 高端栅极驱动器输出。 |
| BMA2 | 37 | 37 |  | 桥臂中间节点和自举电容器负端连接 |
| LA2 | 38 | 38 |  | 低端栅极驱动器输出。 |
| LA1 | 39 | 39 |  | 低端栅极驱动器输出。 |
| BMA1 | 40 | 40 |  | 桥臂中间节点和自举电容器负端连接 |
| HA1 | 41 | 41 |  | 高端栅极驱动器输出。 |
| CA1 | 42 | 42 |  | 自举电容器正端连接 |
| CB2 | 43 | 43 |  | 自举电容器正端连接 |
| HB2 | 44 | 44 |  | 高端栅极驱动器输出。 |
| BMB2 | 45 | 45 |  | 桥臂中间节点和自举电容器负端连接 |
| LB2 | 46 | 46 |  | 低端栅极驱动器输出。 |
| LB1 | 47 | 47 |  | 低端栅极驱动器输出。 |
| BMB1 | 48 | 1 |  | 桥臂中间节点和自举电容器负端连接 |
| Exposed die pad | - | - |  | 将裸露的管芯焊盘连接到地平面。提供尽可能多的通孔以将热 传递到地平面。也用作低端栅极驱动器的地引脚。确保采样电 阻地的环路电感尽量低。 |
--- [PAGE 19] ---
TMC5160 DATASHEET (Rev. 1.08 / 2018-NOV-19)
19
www.trinamic.com
