e1aco/ELACO_StepMotorTMC5160/Firmware/TMC5160_StepMotor/.cl/datasheet/TMC5160A_Datasheet_Rev1_13_CN_ch03_section.md

# TMC5160A_Datasheet_Rev1_13_CN — 第3章 示例电路

--- [PAGE 20] ---
TMC5160 DATASHEET (Rev. 1.08 / 2018-NOV-19)
20
www.trinamic.com
3. 示例电路
以下示例电路为不同控制模式和供电模式下对应的外部电路。为了清楚起见，省略了总线接口和其
它数字信号的连接

--- [PAGE 21] ---
TMC5160 DATASHEET (Rev. 1.08 / 2018-NOV-19)
21
www.trinamic.com
3.1
标准应用电路
图3.1 标准电路
标准路使用最少的外部器件。根据所需的电流、电压和封装类型选择八个MOSFET。两个采样电阻
确定驱动电机线圈的最大电流。请参阅第8 章选择正确的采样电阻。电源滤波选用低ESR 电容。为获得
最佳性能，建议功率桥附近的电容根据线圈电流的大小选择至少为100μF /安培。电容需要吸收斩波器
操作产生的电流纹波。电源电容上的电流纹波也取决于电源内阻和电缆长度。VCC_IO 可以由5VOUT 或
外部电源(例如3.3V 调节器)供电。在高VM 的应用中为了降低内部5V 和11.5V 稳压器的线性稳压器功耗，
VSA 应该使用不同(较低)的电源电压(参见第0 章)。
基本布线提示
将采样电阻和所有滤波电容尽可能靠近功率MOSFET。TMC5160 靠近MOSFET 放置，短线互连，以
最小化寄生电感。将所有的GND、GNDA、GNDD 及采样电阻GND 连成一个公共地。5VOUT 滤波电容直
接连到5VOUT 和GNDA 引脚。有关详细信息，请参阅布局提示。推荐使用低ESR 电解电容对VS 滤波。
提示：
在安全关键应用中，VS 和功率桥可以由单独的开关电源供电，以实现安全关闭。确保VS 处的斜率不超
过1V/ µs。

<!-- detected tables -->

| 基本布线提示 |  |  |  |  |
|---|---|---|---|---|
|  |  | 将采样电阻和所有滤波电容尽可能靠近功率MOSFET。TMC5160 靠近MOSFET 放置，短线互连，以 |  |  |
|  | 最小化寄生电感。 |  | 将所有的GND、GNDA、GNDD 及采样电阻GND 连成一个公共地。5VOUT 滤波电容直 |  |
| 接连到5VOUT 和GNDA 引脚。有关详细信息，请参阅布局提示。推荐使用低ESR 电解电容对VS 滤波。 |  |  |  |  |
--- [PAGE 22] ---
TMC5160 DATASHEET (Rev. 1.08 / 2018-NOV-19)
22
www.trinamic.com
注意：
如果VSA 由不同的电压源供电，请确保在电机运行期间VSA 不会跌落。VSA 在VS 之前关断，需要
关断电机驱动。因为VSA 上的切换边缘，可能导致桥臂导通。VSA 与VS 电源由一路供电是最安全的
3.2
外部栅极电压调节器
在48V 这样的高电源电压下，内部栅极电压调节器和内部5V 调节器具有相当大的功耗，特别是在
MOSFET 栅极电荷高、斩波器频率高或系统时钟频率大于12 MHz 的情况下。散热块与系统PCB 地平面
的良好热传导将有助于散热。自身功耗增加芯片温度，将显著降低温度保护的阈值。为降低功耗，建议
外接TMC5160 驱动器栅极电压。如图3.2 所示。在图中，内部栅极电压调节器关闭。为获得最佳效果，
建议使用12V + / - 1V 的电源。
图3.2 外部栅极电压源
提示
当MOSFET 的总栅极电荷超过50nC、斩波器频率大于40kHz 或时钟频率大于12 MHz 时，建议VSA 电
源不高于40V 的。

--- [PAGE 23] ---
TMC5160 DATASHEET (Rev. 1.08 / 2018-NOV-19)
23
www.trinamic.com
3.3
选择MOSFET 和斜率
功率MOSFETs 的选择取决于许多因素，如封装尺寸、导通电阻、额定电压和供应商。越大、越低
RDSon 的MOSFETs 并不一定是越好，因为越大的器件也具有更高的电容，并且可能在栅极驱动电路中的
走线电感增加更多的振铃及功耗。将MOSFET 调整到所需的电机电压(在峰值电源电压上增加5 - 10V 的
余量)和所需的最大电流，使得电阻功耗对于所选MOSFET 封装的热容量仍然很低。TMC5160 以大约10V
驱动MOSFET 栅极，因此正常的10V 就足够了。FETs 逻辑电平( 4.5V 指定的RDSon )也将工作，但由于VGS
( th )较低，桥臂开通特性可能更为关键。
栅极驱动电流和MOSFET 栅极电阻RG (可选)决定开关行为，且应根据MOSFET 栅极-漏极电荷(米勒
电荷)调整。图3.3 显示了米勒电荷对开关事件的影响。图3.4 还显示了不同负载情况下的切换事件(负载
将输出拉高或拉低)以及所需的死区时间。
下表是设置MOSFET 驱动器电流( DRVSTRENGTH 设置)和选择栅极电阻的经验法则:
G MOSFET 米勒电荷对应的DRVSTRENGTH 及RG
米勒电荷[nC]
(典型值)
DRVSTRENGTH
设置
RG [Ω]值
<10
0
≤15
10…20
0 or 1
≤10
20…40
1 or 2
≤7.5
40…60
2 or 3
≤5
>60
3
≤2.7
TMC5160 的栅极截止驱动电流，以避免高dV / dt 引起的桥臂直通。栅极电阻超过表中给出的值时，
保护的效率会降低。因此，对于较大的RG 值，可能需要并联二极管来确保MOSFET 在开关事件期间安全
关断。

<!-- detected tables -->

| MOSFET 米勒电荷对应的DRVSTRENGTH 及R G G |  |  |
|---|---|---|
| 米勒电荷[nC] (典型值) | DRVSTRENGTH 设置 | R [Ω]值 G |
| <10 | 0 | ≤15 |
| 10…20 | 0 or 1 | ≤10 |
| 20…40 | 1 or 2 | ≤7.5 |
| 40…60 | 2 or 3 | ≤5 |
| >60 | 3 | ≤2.7 |
--- [PAGE 24] ---
TMC5160 DATASHEET (Rev. 1.08 / 2018-NOV-19)
24
www.trinamic.com
图3.3 米勒电荷决定开关斜率
提示：
-选择快速、软恢复特性二极管和低反向恢复电荷的MOSFET。
-小型贴片MOSFET 封装允许更紧凑的布线，并降低寄生电感效应。
图3.4 斜坡，米勒平台和消影时间

--- [PAGE 25] ---
TMC5160 DATASHEET (Rev. 1.08 / 2018-NOV-19)
25
www.trinamic.com
驱动器需根据MOSFET 参数配置以下DRV _ CONF 参数:
参数
描述
设置
备注
BBMTIME
死区时间，确保同一桥臂的高端和低端MOSFET 不
会直通。BBMTIME 是更高频率的调节死区时间设
置，允许比时钟周期更快的调节时间。
需要更长的时间，选择BBMCLKS。
0…24
时间[ns]
100ns*32/(32-BBMTIME)
确保~30% headroom
复位缺省: 0
BBMCLKS
BBMTIME 类似功能，也是死区时间设置，以多个时
钟周期为单位。
设置较长的死区时间( BBMTIME 与BBMCLKS 的区
别)。
0…15
0: 关闭
复位缺省: OTP 4 or 2
DRV_
STRENGTH
栅极驱动电流的选择。根据外部MOSFET 的栅极电
荷设置栅极驱动电流。
0…3
复位缺省= 2
FILT_ISENSE
采样电阻运放的滤波时间常数，以补偿另一个线圈
操作的振铃和耦合
提示:如果两个线圈交叉耦合产生电机斩波器噪声，
则增加设置。(重置默认值= % 00 )
0…3
00: ~100ns (复位缺省)
01: ~200ns
10: ~300ns
11: ~400ns
DRV_CONF 参数
在增加栅极串联电阻值之前，将DRVSTRENGTH 栅极驱动强度设置最低会给出有利的开关斜率。
40ns 到80ns 的斜率时间是绝对足够的，通常最短的死区时间设置( BBMTIME = 0，BBMCLKS = 0 )会大于
这个时间。
如果大的MOSFET 需要较慢的斜率，要确保死区时间( BBMTIME，200ns 以上时间可用BBMCLKS)
充分覆盖开关事件，以避免桥臂直通短路。最短的BBM 时间大于安全切换，效果最佳。控制大约30 %
的余量，以弥补MOSFET 和驱动器的生产批次造成的不一致性。

<!-- detected tables -->

| 参数 | 描述 | 设置 | 备注 |
|---|---|---|---|
| BBMTIME | 死区时间，确保同一桥臂的高端和低端MOSFET 不 会直通 。BBMTIME 是更高频率的调节死区时间设 置，允许比时钟周期更快的调节时间。 需要更长的时间，选择BBMCLKS。 | 0…24 | 时间[ns] 100ns*32/(32-BBMTIME) 确保~30% headroom 复位缺省: 0 |
| BBMCLKS | BBMTIME 类似功能，也是死区时间设置，以多个时 钟周期为单位。 设置较长的死区时间( BBMTIME 与 BBMCLKS 的区 别)。 | 0…15 | 0: 关闭 复位缺省: OTP 4 or 2 |
| DRV _ STRENGTH | 栅极驱动电流的选择。根据外部MOSFET 的栅极电 荷设置栅极驱动电流。 | 0…3 | 复位缺省= 2 |
| FILT ISENSE _ | 采样电阻运放的滤波时间常数，以补偿另一个线圈 操作的振铃和耦合 提示:如果两个线圈交叉耦合产生电机斩波器噪声， 则增加设置。(重置默认值= % 00 ) | 0…3 | 00: ~100ns (复位缺省) 01: ~200ns 10: ~300ns 11: ~400ns |

| DRV CONF 参数 _ |  |  |  |  |
|---|---|---|---|---|
| 在增加栅极串联电阻值之前，将DRVSTRENGTH 栅极驱动强度设置最低会给出有利的开关斜率。 |  |  |  |  |
| 40ns 到80ns 的斜率时间是绝对足够的， | 通常最短的死区时间设置( BBMTIME = 0，BBMCLKS = 0 )会大于 |  |  |  |
| 这个时间。 |  |  |  |  |
| 如果大的MOSFET 需要较慢的斜率，要确保死区时间( BBMTIME，200ns 以上时间可用BBMCLKS) |  |  |  |  |
| 充分覆盖开关事件，以避免桥臂直通短路。 |  | 最短的BBM 时间大于安全切换， | 效果最佳。控制大约30 % |  |
| 的余量，以弥补MOSFET 和驱动器的生产批次造成的不一致性。 |  |  |  |  |
|  |  |  |  |  |
--- [PAGE 26] ---
TMC5160 DATASHEET (Rev. 1.08 / 2018-NOV-19)
26
www.trinamic.com
3.4
调整MOSFET 桥臂
干净的切换事件有利于确保低功耗和良好的EMC 性能。不合适的布局或器件会危及电路的稳定运
行。因此，了解寄生电感和MOSFET 反向恢复的影响非常重要。
在接通低端MOSFET 或高端MOSFET 之前，只要相对的MOSFET 处于二极管导通状态，电源布线中
的杂散电感就会引起振铃。当负载电流与接下来的导通桥极性相反时，二极管在死区时间段导通。
MOSFET 体二极管具有一定的反向恢复时间和放电时间。这一时间通常在几十纳秒的范围内。在反向恢
复期间，二极管将引起桥上的高电流流动。该电流来自电源滤波电容(参见图3.5 粗线)。一旦二极管导
通，寄生电感就试图保持电流流动。高、快速斜率导致寄生电感振铃(见图3.6 )。这可能导致桥电压低于
GND 电平。必须确保驱动器IC 在其BM 引脚到地没有出现低于-5V 的峰值。直接测量驱动器引脚到驱动
器地的电压。下冲的量取决于从低侧漏极到低侧源极并且经由采样电阻RS 到地通路中寄生电感的存储
能量。
当电路中是相对较小的MOSFET 时, 软斜率控制需要串联较高的栅极电阻。这危及安全的MOSFET 关
断。添加额外的二极管, 以确保MOSFET 在缓慢切换斜率下的安全关断(图3.5 所示的MOSFET 对管)。
·图3.7 显示了调整开关斜率和增加1nF 桥式输出电容器后的电路性能

--- [PAGE 27] ---
TMC5160 DATASHEET (Rev. 1.08 / 2018-NOV-19)
27
www.trinamic.com
图3. 5 对电源布线电感的可选保护选项

--- [PAGE 28] ---
TMC5160 DATASHEET (Rev. 1.08 / 2018-NOV-19)
28
www.trinamic.com
确保可靠操作
-
使用贴片MOSFET 和短线连接。
-
桥臂和VS 引脚附近提供足够的滤波电容。
-
调整MOSFET 开关斜率(在MOSFET 栅极上测量开关事件) 比MOSFET 体二极管反向恢复时间慢。这
将减少交叉导通。
-
靠近MOSFET 处增加栅极电阻和输出电容, 通过最大限度地减少响铃, 确保开关特性和可靠运行，图
3.5 显示了一些的选项。
-
部分MOSFET 有集成的源级到漏级的快速二极管，可消除反向恢复放电。
图3.6 输出振铃(蓝色) 和未加调整的栅极电压（黄色和紫色）

--- [PAGE 29] ---
TMC5160 DATASHEET (Rev. 1.08 / 2018-NOV-19)
29
www.trinamic.com
图3.7 增加优化器件后的开关事件(没有体二极管/体二极管导通)
桥臂优化示例
下图为6A 电机电流步进驱动器的标准原理图，MOSFET 为AOD4126。
该MOSFET 具有低栅极电容，在最低驱动器强度设置下斜率时间大约为50ns。在最低驱动强度设置
下，切换质量最好(图3.6 )，但显示大量振铃。增加低侧栅极电阻，可增加开关斜率时间，通过对栅极-
漏极(米勒)电荷放电的影响，高侧体二极管传导后也稍微增加开关斜坡时间。为了对称，增加了高侧栅
极电阻。测试表明，1nF 输出电容可显著降低体二极管导通后电桥的振铃(图3.7 )。图3.8 显示了优化后
的实际组件和值。

--- [PAGE 30] ---
TMC5160 DATASHEET (Rev. 1.08 / 2018-NOV-19)
30
www.trinamic.com
图3.8 带有调整器件的桥臂示例(请参见示波器截图)
桥臂布线考虑
­
调整电桥布局，使环路电感最小。布局最好紧凑。
­
MOSFET 栅极连接短而直，避免BM 和相应的HS 驱动器引脚之间的环路电感。利用平行走线或相邻
层上的相邻走线使回路电感最小化。较宽的走线也可以降低了电感(不使用最小线径)。
­
采样电阻到低侧MOSFET 源极的长度最短，并将TMC5160 放置在采样电阻的地附近，其地通过过
孔直接连到同一平面。
­
调整栅极电流设置和栅极电阻优化开关行为。增加MOSFET 电桥输出电容( 470PF 至几个NF )减少振
铃。
­
通过使用示波器探针上GND 尖端而不是GND 电缆(如果可用)直接在桥臂或TMC5160 的BM 引脚处
探测来测量桥臂的性能

--- [PAGE 31] ---
TMC5160 DATASHEET (Rev. 1.08 / 2018-NOV-19)
31
www.trinamic.com
3.5
高压应用
有些应用电压比TMC5160 耐压更高。对于60V 以上的峰值电压，可以使用外部栅极驱动器IC 提
升TMC5160 栅极驱动器输出。图3.9 为示例电路，每个半桥使用一个外部栅极驱动器IC，以提升
TMC5160 输出能力。BBM 控制仍由TMC5160 完成。这些IC 为12V 电压，因此TMC5160 输出信号可直
接直接驱动。BM 引脚需要靠近地以产生与地相关的高端控制信号。通过将BM 连接到相应的采样电阻，
对VS 电源短路保护仍然可以对过流情况做出反应。将短检测电压降限制在0.5V…0.8V，以避免高端输出
达到过高水平。高端短路保护必须设置CHOPCONF.diss2g 禁用，因为在此电路配置中不能工作，。
保持布局和所有互连紧凑，以避免寄生效应的干扰。也可以参考所选栅极驱动器集成电路的应
用笔记。
图3.9 外部门级驱动电路示例
