e1aco/ELACO_StepMotorTMC5160/Firmware/TMC5160_StepMotor/.cl/datasheet/TMC5160A_Datasheet_Rev1_13_CN_ch04_spi.md

# TMC5160A_Datasheet_Rev1_13_CN — 第4章 SPI 接口

--- [PAGE 32] ---
TMC5160 DATASHEET (Rev. 1.08 / 2018-NOV-19)
32
www.trinamic.com
4. SPI 接口
4.1
SPI 数据报结构
TMC5160 采用40 位SPI (串行外围接口，SPI 是摩托罗拉的商标)数据报与微控制器MCU 通信。带
硬件SPI 的微控制器MCU 通常用8 比特位的整数倍进行通信。设备的NCS 信号必须在数据报传输的整
个持续时间内保持有效(低)。
发送到TMC5160 的每个数据报由一个地址字节和四个数据字节组成。这方便对TMC5160 的寄存
器组直接进行32 位数据字通信。每个寄存器有32 位数据，即使少于32 位。
为了简化，每个寄存器地址长度为一个字节：
­
读操作，地址字节的最高有效位是0。
­
写操作，地址字节的最高有效位为1。
大多数寄存器都是只写寄存器，有些可读，还有一些只读。
SPI 数据结构
高位(先传送)
40 位
低位(后传送)
39 ...
... 0
8 位地址
8 位SPI 状态
32 位数据
39 ... 32
31 ... 0
发送到TMC5160
读写标志+ 7 位地址
8 位数据
8 位数据
8 位数据
8 位数据

<!-- detected tables -->

| SPI 数据结构 |  |  |  |  |  |  |
|---|---|---|---|---|---|---|
| 高位(先传送) |  | 40 位 |  |  | 低位(后传送) |  |
| 39 ... ... 0 |  |  |  |  |  |  |
| 8 位地址 8 位SPI 状态 | 32 位数据 |  |  |  |  |  |
| 39 ... 32 | 31 ... 0 |  |  |  |  |  |
| 发送到TMC5160 读写标志+ 7 位地址 | 8 位数据 |  | 8 位数据 | 8 位数据 |  | 8 位数据 |
--- [PAGE 33] ---
TMC5160 DATASHEET (Rev. 1.08 / 2018-NOV-19)
33
www.trinamic.com
4.1.1 写/读选择(WRITE_notREAD)
读和写选择由地址字节的最高位( SPI 数据报的第39 位)控制。读为0，写为1。因此，标号为W
的位是WRITE_notREAD 控制位。有效高写入位是地址字节的最高位。因此，0x 80 必须加到地址中才能
进行写操作。SPI 接口总是将数据传送回主机，与W 位无关。如果前一次访问是读访问，则传输回来的
数据是前一个数据报一起传输的地址对应的读取值。如果前一次访问是写访问，则数据回读为以前接收
的镜像写数据。因此，读访问和写访问之间的区别在于，读访问不将数据传输到寻址寄存器，仅传输地
址，因此它的32 个数据位是虚拟的，而且，随后的读访问或写访问将发回前一个读周期中传输的地址
对应的数据。
读请求数据报需用空写数据。读取的数据值通过后续的读取或写入访问被传输回主设备。因此，可以以
流水线方式读取多个寄存器。
每当从TMC 5160 读取数据或向TMC 5160 写入数据时，返回高位八位包含SPI 状态，SPI_STATUS，
对应八个选定的状态位。
示例:
读地址0x21 寄存器( XACTUAL )之前，地址字节必须设置为0x21。写寄存器( VACTUAL )，地址
字节必须设置为0x80+0x22 = 0xA2。读操作的数据位可能是任何值( - )。因此，可以将它们设置
为0。
动作
发送给TMC5160 的数据TMC5160 返回的数据
读XACTUAL
0x2100000000
0xSS & 无用的数据
读XACTUAL
0x2100000000
0xSS & XACTUAL
写VMAX:= 0x00ABCDEF
0xA700ABCDEF
0xSS & XACTUAL
写VMAX:= 0x00123456
0xA700123456
0xSS00ABCDEF
*)S: 表示代表状态位SPI_STATUS
TMC5160 返回
8 位SPI 状态
39 / 38 ... 32
31 ... 24
23 ... 16
15 ... 8
7 ... 0
W
38...32
31...28
27...24
23...20
19...16
15...12
11...8
7...4
3...0
3
9
3
8
3
7
3
6
3
5
3
4
3
3
3
2
3
1
3
0
2
9
2
8
2
7
2
6
2
5
2
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

<!-- detected tables -->

| TMC5160 返回 8 位SPI 状态 |  |  |  |  |  |  |  |  |  |  |  |  |  |  |  |  |  |  |  |  |  |  |  |  |  |  |  |  |  |  |  |  |  |  |  |  |  |  |  |
|---|---|---|---|---|---|---|---|---|---|---|---|---|---|---|---|---|---|---|---|---|---|---|---|---|---|---|---|---|---|---|---|---|---|---|---|---|---|---|---|
| 39 / 38 ... 32 |  |  |  |  |  |  |  | 31 ... 24 |  |  |  |  |  |  |  | 23 ... 16 |  |  |  |  |  |  |  | 15 ... 8 |  |  |  |  |  |  |  | 7 ... 0 |  |  |  |  |  |  |  |
| W | 38...32 |  |  |  |  |  |  | 31...28 |  |  |  | 27...24 |  |  |  | 23...20 |  |  |  | 19...16 |  |  |  | 15...12 |  |  |  | 11...8 |  |  |  | 7...4 |  |  |  | 3...0 |  |  |  |
| 3 9 | 3 8 | 3 7 | 3 6 | 3 5 | 3 4 | 3 3 | 3 2 | 3 1 | 3 0 | 2 9 | 2 8 | 2 7 | 2 6 | 2 5 | 2 4 | 2 3 | 2 2 | 2 1 | 2 0 | 1 9 | 1 8 | 1 7 | 1 6 | 1 5 | 1 4 | 1 3 | 1 2 | 1 1 | 1 0 | 9 | 8 | 7 | 6 | 5 | 4 | 3 | 2 | 1 | 0 |
--- [PAGE 34] ---
TMC5160 DATASHEET (Rev. 1.08 / 2018-NOV-19)
34
www.trinamic.com
4.1.2 每次SPI 数据报读回时传送的状态位
新的状态信息在每次访问结束时被锁存，并可用于下一次SPI 传输。
SPI_STATUS –每个SPI 访问时39 到32 位之间的状态标志
位
名称
备注
7
status_stop_r
RAMP_STAT[1] – 1:仅限运动控制器模式下，右参考开关停止标志。
6
status_stop_l
RAMP_STAT[0] – 1:仅限运动控制器模式下，左参考开关停止标志。
5
position_reached
RAMP_STAT[9] – 1: 仅限运动控制器模式下，目标位置到达标志。
4
velocity_reached
RAMP_STAT[8] – 1: 仅限运动控制器模式下，目标速度到达标志。
3
standstill
DRV_STATUS[31] – 1:电机静止标志。
2
sg2
DRV_STATUS[24] – 1: StallGuard 标志有效标志。
1
driver_error
GSTAT[1] – 1: 驱动器错误指示(通过读GSTAT 清标志)。
0
reset_flag
GSTAT[0] – 1: 复位发生指示(通过读GSTAT 清标志)。
4.1.3 数据排列
所有数据都是右对齐。寄存器格式包含无符号(正)值，二进制补码的整数值(有符号)，单个位或位
组分别代表单个位或整数组。
4.2
SPI 信号
TMC 5160 上的SPI 总线有四个信号:
­
SCK
-总线时钟输入
­
SDI
-串行数据输入
­
SDO
-串行数据输出
­
CSN
-芯片选择输入(低电平有效)
SPI 芯片选择输入CSN 上的低电平使能SPI。位传输与总线时钟SCK 同步，从设备在SCK 的上升沿锁
存来自SDI 的数据，并在下降沿之后驱动数据到SDO。首先发送最高有效位。一个完整的与TMC5160 进
行总线传输至少需要40 个SCK 时钟周期。
如果驱动的时钟超过40 个，则内部移位寄存器延迟40 个时钟后，多余的SDI 位在SDO 上被移出。
这可用于多个芯片的菊花链连接。
在整个SPI 总线通讯期间，CSN 必须为低。当CSN 变高时，内部移位寄存器的内容被锁存到内部控
制寄存器中，并被识别为从主设备到从设备的命令。如果发送超过40 位，则只有CSN 上升沿之前接收

<!-- detected tables -->

| SPI STATUS –每个SPI 访问时39 到32 位之间的状态标志 _ |  |  |
|---|---|---|
| 位 | 名称 | 备注 |
| 7 | status stop r _ _ | RAMP STAT[1] – 1:仅限运动控制器模式下，右参考开关停止标志。 _ |
| 6 | status stop l _ _ | RAMP STAT[0] – 1:仅限运动控制器模式下，左参考开关停止标志。 _ |
| 5 | position reached _ | RAMP STAT[9] – 1: 仅限运动控制器模式下，目标位置到达标志。 _ |
| 4 | velocity reached _ | RAMP STAT[8] – 1: 仅限运动控制器模式下，目标速度到达标志。 _ |
| 3 | standstill | DRV STATUS[31] – 1:电机静止标志。 _ |
| 2 | sg2 | DRV STATUS[24] – 1: StallGuard 标志有效标志。 _ |
| 1 | driver error _ | GSTAT[1] – 1: 驱动器错误指示(通过读GSTAT 清标志)。 |
| 0 | reset flag _ | GSTAT[0] – 1: 复位发生指示(通过读GSTAT 清标志)。 |
--- [PAGE 35] ---
TMC5160 DATASHEET (Rev. 1.08 / 2018-NOV-19)
35
www.trinamic.com
的最后40 位被识别为有效命令。

--- [PAGE 36] ---
TMC5160 DATASHEET (Rev. 1.08 / 2018-NOV-19)
36
www.trinamic.com
4.3
时序
SPI 接口单元与内部系统时钟同步，最高SPI 时钟SCK 为系统时钟频率的一半。如果系统时钟基于片
上振荡器，则必须使用额外的10 %安全裕度来确保可靠的数据传输。所有SPI 输入以及ENN 输入都经过
内部滤波，以避免被短于20ns 的脉冲触发。图4.1 显示了SPI 总线传送的时序参数，下表为对应的电气
参数。
图4.1 SPI 时序
提示
通常TMC5160 SPI 时序指的是SPI 模式3
SPI 接口时序
交流特性
时钟周期: tCLK
参数
符号
条件
最小值
典型值
最大值
单位
SCK 在CSN 变化前或变化后有效
时间
tCC
10
ns
CSN 高电平时间
tCSH
* )最小时间仅用于
同步CLK，在CSN
高电平前SCK 至少
保持一个tCH 高电平
时间
tCLK*)
>2tCLK+10
ns
SCK 低电平时间
tCL
* ) 最小时间仅用于
同步时钟
tCLK*)
>tCLK+10
ns
SCK 高电平时间
tCH
* ) 最小时间仅用于
同步时钟
tCLK*)
>tCLK+10
ns
内部时钟的SCK 频率
fSCK
假设最小振荡频率
4
MHz
外部16M 时钟的SCK 频率
fSCK
假设为同步时钟
8
MHz

<!-- detected tables -->

| SPI 接口时序 | 交流特性 时钟周期: t CLK |  |  |  |  |  |
|---|---|---|---|---|---|---|
| 参数 | 符号 | 条件 | 最小值 | 典型值 | 最大值 | 单位 |
| SCK 在CSN 变化前或变化后有效 时间 | t CC |  | 10 |  |  | ns |
| CSN 高电平时间 | t CSH | * )最小时间仅用于 同步CLK，在CSN 高电平前SCK 至少 保持一个t 高电平 CH 时间 | t *) CLK | >2t +10 CLK |  | ns |
| SCK 低电平时间 | t CL | * ) 最小时间仅用于 同步时钟 | t *) CLK | >t +10 CLK |  | ns |
| SCK 高电平时间 | t CH | * ) 最小时间仅用于 同步时钟 | t *) CLK | >t +10 CLK |  | ns |
| 内部时钟的SCK 频率 | f SCK | 假设最小振荡频率 |  |  | 4 | MHz |
| 外部16M 时钟的SCK 频率 | f SCK | 假设为同步时钟 |  |  | 8 | MHz |
