e1aco/ELACO_StepMotorTMC5160/Firmware/TMC5160_StepMotor/.cl/datasheet/TMC5160A_Datasheet_Rev1_13_CN_ch12_stallguard2.md

# TMC5160A_Datasheet_Rev1_13_CN — 第12章 STALLGUARD2 负载检测

--- [PAGE 122] ---
TMC5160 DATASHEET (Rev. 1.08 / 2018-NOV-19)
122
www.trinamic.com
12. StallGuard2 负载检测
StallGuard2 反应电机负载。它可用于堵转检测以及在低于让电机堵转的负载下的其它用途，例如负
载相关电流调节。StallGuard2 的测量值在很宽的负载、速度和电流设置范围内线性变化，如图12.1 所示。
在最大电机负载时，该值为零或接近零。这对应于线圈的磁场与转子中的磁铁之间的90°负载角。这也
是电机最节能的点。
图12.1 StallGuard2 功能原理
参数
描述
设置
备注
SGT
该有符号参数控制StallGuard2 的阈值用于堵转检测，并
设置用于读出的最佳测量范围。值越低，灵敏度越高。
零是大多数电机的启动值。值越高，StallGuard2 的灵敏
度越低，指示到电机Stall 堵转所需的扭矩越大。
0
中间值
+1… +63
低敏感度
-1… -64
高敏感度
sfilt
StallGuard2 滤波器以获得更高的测量精度。如果设置，
将测量频率降低到每电机电气周期一次测量( 4 个全
步)。
0
标准模式
1
滤波模式
状态字
描述
范围
备注
SG_RESULT
StallGuard2 值。读数越高表示机械负载越小。较低的读
数表示较高的负载，从而表示较大的负载角。调整SGT
设置，使在电机堵转前的最大负载下的SG_RESULT 读
数大约0 到100。
0… 1023
0:
最高负载
低值: 高负载
高值: 低负载
提示：

<!-- detected tables -->

| 参数 | 描述 | 设置 | 备注 |
|---|---|---|---|
| SGT | 该有符号参数控制StallGuard2 的阈值用于堵转检测，并 设置用于读出的最佳测量范围。值越低，灵敏度越高。 零是大多数电机的启动值。值越高，StallGuard2 的灵敏 度越低，指示到电机Stall 堵转所需的扭矩越大。 | 0 | 中间值 |
|  |  | +1… +63 | 低敏感度 |
|  |  | -1… -64 | 高敏感度 |
| sfilt | StallGuard2 滤波器以获得更高的测量精度。如果设置， 将测量频率降低到每电机电气周期一次测量( 4 个全 步)。 | 0 | 标准模式 |
|  |  | 1 | 滤波模式 |
| 状态字 | 描述 | 范围 | 备注 |
| SG RESULT _ | StallGuard2 值。读数越高表示机械负载越小。较低的读 数表示较高的负载，从而表示较大的负载角。调整SGT 设置，使在电机堵转前的最大负载下的SG RESULT 读 _ 数大约0 到100。 | 0… 1023 | 0: 最高负载 低值: 高负载 高值: 低负载 |
--- [PAGE 123] ---
TMC5160 DATASHEET (Rev. 1.08 / 2018-NOV-19)
123
www.trinamic.com
使能StallGuard2 和CoolStep 之前请设置SGT 调节StallGuard2 的敏感度。

--- [PAGE 124] ---
TMC5160 DATASHEET (Rev. 1.08 / 2018-NOV-19)
124
www.trinamic.com
12.1 调整StallGuard2 阈值SGT
StallGuard2 值SG_RESULT 受电机特性及特定应用的负载和速度影响。因此，针对特定电机
类型和运行条件调整stallguard 2 阈值SGT 的最简单方法是在实际应用中进行交互式调整。
调整STALLGUARD 的SGT 的初始步骤
1.
以适用的正常运行速度运行电机，并监控SG_RESULT 。
2.
缓慢增加电机的机械负载。如果电机在SG_RESULT 达到零之前停止，则减小SGT。如果SG_RESULT
在电机停止之前达到零，则增大SGT。0 是SGT 初始值。SGT 是有符号的，可正可负。
3.
将TCOOLTHRS 设置为高于TSTEP 的值，并启用sg_stop 使能堵转停止功能。确保电机在停机时安全
停止。如果电机在堵转发生前停止，增加SGT。通过禁用sg_stop 或读并写入RAMP_STAT 寄存器(写
+清除功能)重新启动电机。
4.
在电机增加负载堵转前，SG_RESULT 最佳范围大约在0 和100 之间，且在没有负载的情况下
SG_RESULT 增加100 或更多时。在大多数情况下，SGT 应在某个运动速度或速度范围调整。确保设
置在一定范围内(例如所需速度的80 %至120 % )以及极端电机条件下(最低和最高适用温度)工作可靠。
允许自动调整SGT 的可选步骤
SGT 设置背后的基本思想是补偿电机内部电阻损耗的对StallGuard 影响。在静止和非常低的速度下，
由于机械功率为零或接近零，电阻损耗是电机能量平衡的主要因素。这样，可以将SGT 设置为接近零速
度的最佳值。该算法特别适用于在应用中调整SGT，以获得与环境条件、电机杂散等无关的最佳结果。
1.
以小于10 RPM (即每秒几至几个全步的低速运行电机，并获得目标运行电流和电源电压。在此速度
范围内，SG_RESUL 对电机负载的依赖性不大，因为电机不会产生显著的反电势。因此，机械负载对
结果影响不大。
2.
打开sfilt 滤波器。将SGT 从0 逐渐增加到SG_RESULT 开始增加。当SGT 值较高时，SG_RESUL 将上
升到最大值，继续增大SGT 则SG_RESULT 会溢出到0。现在，SGT 值被设置成最大敏感。当您看到
SG_RESULT 以较高的速度增加时，则检测到堵转。
该参数设置下堵转检测的上限速度由速度确定，在该速度下，电机反电势接近电源电压，速度继续
增大电机电流开始下降。
当电机堵转时，SG_RESULT 变为0，可配置斜坡发生器SW_MODE 中的sg_stop 使能在堵转事件时停
止电机。将TCOOLTHRS 设置为与较低的速度阈值相匹配，在该阈值下，StallGuard 结果最佳，完成有效
的sg_stop。
电源电压也会影响SG_RESULT，因此电压调节越严格，数值越精确。StallGuard 测量具有高分辨
率，有几种方法可以提高其精度，如以下部分所述

--- [PAGE 125] ---
TMC5160 DATASHEET (Rev. 1.08 / 2018-NOV-19)
125
www.trinamic.com
快速启动
请参阅第20 章中的快速配置指南快速入门。
有关详细步骤，请参见应用说明AN002 - stallguard 2 和CoolStep 的参数化
12.1.1 速度阈值TCOOLTHRS 和THIGH
作为先前描述的SGT 调整结果而选择的SGT 设置可以用于某个速度范围。超出此范围时，可能无法
安全检测到堵转，CoolStep 可能无法给出最佳结果。
图12.2 示例:最佳SGT 设置和StallGuard2 读数(带示例电机)
在许多应用中，大部分时间只在单个操作点或附近运行，因此单个SGT 设置就足够了。驱动器提供
较低和较高的速度阈值以匹配这一点。在所确定的操作点之外堵转检测被禁用，例如在将TCOOLTHRS 设
置为匹配值时，在无传感器归零过程之前的加速阶段期间堵转检测无效。上限可由THIGH 指定。
在一些应用中，可根据速度使用少量的点和线性内插来调整SGT 参数。
12.1.2 具有高转矩脉动和共振的小电机
具有高制动转矩的电动机显示出随着变化的电机电流，特别是在低电流时，StallGuard2 测量值SG
的变化增加。对于这些电机，应检测电流相关性以获得最佳结果。

--- [PAGE 126] ---
TMC5160 DATASHEET (Rev. 1.08 / 2018-NOV-19)
126
www.trinamic.com
12.1.3 电机线圈电阻的温度依赖性
在较宽温度范围内工作的电机可能需要温度校正，因为电机线圈电阻随温度升高而增加。在温度升
高的应用中，电机效率降低，可以通过降低SGT 的线性度下矫正。
12.1.4 StallGuard2 测量准确度和重复性
在量产环境中，可能希望在一种电机类型的应用中使用固定的SGT 值。大部分StallGuard2 测量结
果的差异是由电机结构中的制造公差引起的。如果所有其他参数保持稳定，StallGuard2 的测量误差可以
低至:
ݏݐliiܩᥭlݎ˗݉
SlݏᥭݎS݉
S넨ݐSݎݎ�ݎ=±݉
lh(1, hܩܶ
)
12.2 StallGuard2 更新速率和滤波器
StallGuard2 测量值SG_RESULT 在电机的每一个全步位置都会更新。这足以安全地检测堵转，因为堵
转总是损失四个全步。在实际应用中，尤其是在使用CoolStep 时，更精确的测量可能比每一个全步的更
新更重要，因为机械负载从不在两个全步之间瞬间改变。对于这些应用，使能sfilt 位对四次全步测量值
进行滤波。当需要高精度测量时，应始终使能滤波器。它补偿了电机结构的变化，例如由于A 相和B 相
的不对称。当需要对增加的负载作出快速响应时，应该禁用滤波器，尤其是用stallGuard 做无传感器的
归零的应用。
12.3 检测电机堵转
要获得最佳堵转检测，请不要设置stallGuard 滤波(sfilt =0 )。安全检测电机堵转，必须设置特定的
SGT 参数来确定堵转阈值。因此，需要确定电机在不堵转的情况下的最大负载。同时，检测此负载下的
SG_RESULT 值，例如0 到100 范围内的某个值。堵转阈值应该是安全地在操作极限内的值，以允许参数
偏离。在SGT 设置为0 或接近0 时的响应给出了对信号质量的一些想法:在没有负载和最大负载的情况
下检查SG 值。它们之间应该至少相差100 或几个100，比偏移大。如果将SGT 值设置为最大电机负载
时SG 读数为0，则运动控制器可以自动检测堵转，以发出电机停止。在步进脉冲导致失步的瞬间可读出
最低值。失步产生后，电机将振动，同时SG _ RESULT 读数较高。
12.4 StallGuard 实现归零
线性驱动器的归零过程需要将马达移动到硬停的方向。由于stallGuard 需要一定的速度才能工作(如
TCOOLTHRS 设定的)，请确保起始点离硬停止点足够远，以提供加速阶段所需的距离。设置SGT 和斜坡
发生器寄存器后，开始向硬停止方向运动，并激活堵转时停止功能(SW_MODE 中设置sg_stop )。一旦检
测到堵转，斜坡发生器停止运动并设定VACTUAL 为零，从而停止电机。DRV_STATUS 的标志StallGuard
指示停止。设置新的运动参数以防止电机立即重启后，可以禁用StallGuard，或者通过读和写回
RAMP_STAT 重启电机运动。运动参数未被修改的情况下，在TZEROWAIT 时间之后写入和清除
RAMP_STAT 中的event_stop_sg 标志重新启动电机。在电流大小为电机额定电流的30 %至70 %，运动速
度为1 至5 RPS (小于NEMA17 的电机可能需要更高的速度)的情况下，StallGuard 归零效果最佳。

--- [PAGE 127] ---
TMC5160 DATASHEET (Rev. 1.08 / 2018-NOV-19)
127
www.trinamic.com
12.5 StallGuard2 操作局限性
stallguard 2 在极端电机速度下运行不可靠: 非常低的电机速度(对于许多电机，每秒不到一圈)会产生
低反电动势，使测量不稳定，同时还要考虑环境条件(温度等)。上述自动调整过程将对此进行补偿。其
他条件也将导致SGT 的极端设置和测量值SG _ RESULT 对电机负载的不正确响应。
非常高的电机速度，因电机反电动势达到电源电压电机线圈无法输出正弦电流驱动，效果也较差。
