e1aco/ELACO_StepMotorTMC5160/Firmware/TMC5160_StepMotor/.cl/datasheet/TMC5160A_Datasheet_Rev1_13_CN_ch19_section.md

# TMC5160A_Datasheet_Rev1_13_CN — 第19章 直流电机或螺线管

--- [PAGE 151] ---
TMC5160 DATASHEET (Rev. 1.08 / 2018-NOV-19)
151
www.trinamic.com
19. 直流电机或螺线管
TMC 5160 可以驱动一个或两个直流电机。可控制转矩，或者在转矩限幅的同时控制电压控制速度。
配置和控制

--- [PAGE 152] ---
TMC5160 DATASHEET (Rev. 1.08 / 2018-NOV-19)
152
www.trinamic.com
在GCONF 寄存器中设置direct_mode。在直接模式下，线圈电流极性和线圈电流分别由寄存器
XTARGET ( 0x2D )控制PWM 占空比。第0 到8 位对应电机A 相和第24 到16 位对应电机B 相PWM。除
此设置之外，电流限制由IHOLD 缩放。在此模式下STEP / DIR 输入和运动控制器无效。
PWM 占空比速度控制
为了以不同速度运行电机，用以下StealthChop 斩波电压PWM 模式配置:
en_pwm_mode = 1, pwm_autoscale = 0, PWM_AMPL = 255, PWM_GRAD = 4, IHOLD = 31
设置TOFF > 0 使能驱动器。
在此模式下，驱动器的行为类似于四象限电源。XTARGET 对PWM A 和PWM B 直接控制实现控制电
机电压，从而控制电机速度。PWM 设置在- 255 和+ 255 之间(带符号，二进制补码)对应电机电压从- 100
%变化到100 %。当pwm_autoscale = 0 时，不使用电流采样电阻，并且应避免小于150 毫欧的采样电
阻，以避免在电机负载达到2.5A 时出现过大的电压跌降。特别是对于电流较大的电机，确保缓慢加减
速，以避免过流或触发驱动器过流保护。
设置IHOLD = 0，FREEWHEEL = %01 使能电机飞轮停止模式。
转矩限幅
自动电流缩放( PWM _ autoscale = 1 )功能可实现StealthChop 斩波模式下的电机电流限制(即转矩控
制操作)。实际电流极限由IHOLD 给出，并由相应的电机PWM 幅度来定标，例如，PWM = 128 产生50 %
的电机速度和50 %的IHOLD 设定的电流极限。如果两台直流电机以电压PWM 模式驱动，请注意，自动
电流调节仅适用于绝对PWM 设置较高的电机。如果具有较高PWM 设置的电机达到其电流限制，第二
电机的PWM 也将缩小。
纯转矩限幅操作
对于一个或两个电机的纯转矩限幅操作，SpreadCycle 斩波器分别调节两个全桥电机输出的电机电
流。使用SpreadCycle 时，电机速度上限仅受电源电压限制(或由电机上的负载决定)。
19.1 螺线管操作
同样，一个或两个螺线管(即电磁线圈)可以使用SpreadCycle 斩波器操作。对于螺线管来说，通常希
望在接通后短时间内增加电流，并且一旦磁性元件接通就减少电流。这是通过利用自动电流缩放
(IRUN、IHOLD、IHOLDDELAY 和TPOWERDOWN )自动实现的。direct_mode 中的电流缩放仍然有效，但是
如果没有提供步进STEP 脉冲，则不会触发。因此，每当其中一个线圈被接通时，必须给步进STEP 输入
信号一个阶跃脉冲。这将同时增加两个线圈的电流。
