e1aco/ELACO_StepMotorTMC5160/Firmware/TMC5160_StepMotor/.cl/datasheet/TMC5160A_Datasheet_Rev1_13_CN_ch27_section.md

# TMC5160A_Datasheet_Rev1_13_CN — 第27章 布线考虑

--- [PAGE 174] ---
TMC5160 DATASHEET (Rev. 1.08 / 2018-NOV-19)
174
www.trinamic.com
27. 布线考虑
27.1 芯片底部焊盘
TMC5160 使用其芯片焊盘将热量从栅极驱动器和线性调节器传输到电路板。为了获得最佳的电气和
热性能，请在芯片底部连接焊盘和接地面之间使用适量的过孔。印刷电路板应该有一个地平面，将热量
扩散到电路板中，并提供稳定的GND 参考。
27.2 地的布线
TMC5160 的所有信号都参考它们各自的地。将器件下的所有地( GND、GNDP、GNDA 和芯片底部焊
盘)。芯片连接焊盘正下方的地平面应视为虚拟起点。出于热原因，PCB 顶层应连接到一个大的PCB 地平
面，在PCB 内散发热量。
注意
将TMC5160 靠近MOSFET 桥和采样电阻地，以避免振铃导致地GND 差异和危险的感应峰值电压
27.3 桥臂电压的布线
电源桥将会以极高的dI/dt 脉冲形式抽取整个线圈电流。因此，VS 电源滤波和MOSFETs 之间的任何
电感都会导致严重的电压尖峰。这必须避免。避免滤波电容和MOSFET 开关之间的供电线路出现任何弯
曲，并保持尽可能小的距离。特别是对于大电流，建议单独的电源电压平面，并设计足够的电源滤波数
量和容量。芯片VS 引脚需另加电容，因为额外的纹波电压会导致电荷泵电容上出现严重的电流尖峰。
可以添加一个小串联电阻来避免这种情况。

--- [PAGE 175] ---
TMC5160 DATASHEET (Rev. 1.08 / 2018-NOV-19)
175
www.trinamic.com
注意
在MOSFET 桥附近设置足够的滤波容量，保持电源电压纹波低。
27.4 供电滤波
5VOUT 输出电压陶瓷滤波电容器(推荐2.2 至4.7F )应尽可能靠近5VOUT 引脚，其地回路直接通向
GNDA 引脚。此接地不应与其他负载或地平面的额外过孔共享。使用尽可能短和粗的连接。为了获得最
佳的微步进性能和最低的斩波噪声，VCC 引脚至GND 应增加滤波电容，以避免数字部分纹波影响电机电
流调节。因此，陶瓷滤波电容(推荐470nF )要尽可能靠近VCC 引脚( 1 – 2 毫米距离)，GND 返回接地平
面。VCC 可以使用2.2Ώ或3.3Ώ电阻耦合到5VOUT，以便从5VOUT 提供数字逻辑，同时保持纹波远离该
引脚。100 nF 滤波电容器应尽可能靠近VSA 引脚接地平面。确保VS 不会因桥臂工作而出现过大的电压
尖峰，并在VS 引脚附近将100 nF 或更大的滤波电容置于GND。
请仔细阅读第3.3 章和第3.4 章，了解关于外部MOSFET 功率器件和其它器件选择、布线和条件

--- [PAGE 176] ---
TMC5160 DATASHEET (Rev. 1.08 / 2018-NOV-19)
176
www.trinamic.com
27.5 布线示例
原理图(TMC5160+MOSFETs)
1- 顶层(焊接侧)
2- 内层(地)

--- [PAGE 177] ---
TMC5160 DATASHEET (Rev. 1.08 / 2018-NOV-19)
177
www.trinamic.com
3- 内层(VS 供电)
4- 底层
元器件
图27.1 布线示例

--- [PAGE 178] ---
TMC5160 DATASHEET (Rev. 1.08 / 2018-NOV-19)
178
www.trinamic.com
提示：
当大于30V 的设计中，如果使用TQFP 封装，强考虑PCB 涂层以满足足够的爬电距离。
