e1aco/ELACO_StepMotorTMC5160/AIFirmware/StepMotorDriver_Keil/KNOWLEDGE/MOSFET/AOD4126.md

# AOD4126/AOI4126 — 100V N-Channel MOSFET

阿尔法（Alpha & Omega）SDMOS 沟槽工艺 N 沟道 MOSFET，用于 TMC5160A 外部栅极驱动桥臂（驱动器用 MOS）。

> 来源：`DATASHEET/AOD4126`（AOD4126 数据手册，Rev1，May 2012）

## 产品概要

| 参数 | 值 |
|---|-----|
| VDS | 100 V |
| ID @ VGS=10V (TC=25°C) | 43 A |
| RDS(ON) @ VGS=10V | < 24 mΩ |
| RDS(ON) @ VGS=7V | < 30 mΩ |
| 封装 | TO-252/DPAK、TO-251A/IPAK |
| 特性 | 100% UIS Tested、100% Rg Tested |

## 绝对最大额定值 (TA=25°C 除非注明)

| 符号 | 参数 | 额定值 | 单位 |
|---|---|---|---|
| VDS | 漏-源电压 | 100 | V |
| VGS | 栅-源电压 | ±25 | V |
| ID | 连续漏电流 (TC=25°C) | 43 | A |
| ID | 连续漏电流 (TC=100°C) | 30 | A |
| IDSM | 连续漏电流 (TA=25°C) | 7.5 | A |
| IDSM | 连续漏电流 (TA=70°C) | 6 | A |
| IDM | 脉冲漏电流 | 100 | A |
| IAS/IAR | 雪崩电流 | 39 | A |
| EAS/EAR | 雪崩能量 (L=0.1mH) | 10 | mJ |
| PD | 功耗 (TC=25°C) | 100 | W |
| PDSM | 功耗 (TA=25°C) | 3 | W |
| TJ/TSTG | 结温/存储温度 | -55 ~ 175 | °C |

## 热特性

| 符号 | 参数 | 典型值 | 最大值 | 单位 |
|---|---|---|---|---|
| RθJC | 结-壳热阻 | — | 1.5 | °C/W |
| RθJA | 结-环境热阻 | — | 42 | °C/W |

注：
- RθJA 基于器件安装在 1in² FR-4 板 2oz 铜箔、静止空气 TA=25°C 条件。
- PD 基于 TJ(MAX)=175°C 与结-壳热阻。

## 电气特性 (TJ=25°C 除非注明)

### 静态参数

| 符号 | 参数 | 条件 | 最小 | 典型 | 最大 | 单位 |
|---|---|---|---|---|---|---|
| BVDS | 漏-源击穿电压 | ID=250µA, VGS=0V | 100 | | | V |
| IDSS | 零栅压漏电流 | VDS=100V, VGS=0V | | | 10 | µA |
| | 零栅压漏电流 (TJ=55°C) | VDS=100V, VGS=0V | | | 50 | µA |
| IGSS | 栅-体漏电流 | VDS=0V, VGS=±25V | | | 100 | nA |
| VGS(th) | 栅极阈值电压 | VDS=VGS, ID=250µA | 2 | 3.3 | 4 | V |
| ID(ON) | 导通态漏电流 | VGS=10V, VDS=5V | 100 | | | A |
| RDS(ON) | 静态漏-源导通电阻 | VGS=10V, ID=20A | | 19 | 24 | mΩ |
| | | VGS=7V, ID=15A | | 23.5 | 30 | mΩ |
| | | TJ=125°C (VGS=10V) | | 36 | 43 | mΩ |
| gFS | 正向跨导 | VDS=5V, ID=20A | | 34 | | S |
| VSD | 二极管正向压降 | IS=1A, VGS=0V | | 0.66 | 1 | V |
| IS | 最大体二极管连续电流 | | | 40 | | A |

### 动态参数 (VGS=0V, VDS=50V, f=1MHz)

| 符号 | 参数 | 最小 | 典型 | 最大 | 单位 |
|---|---|---|---|---|---|
| Ciss | 输入电容 | 1400 | 1770 | 2200 | pF |
| Coss | 输出电容 | 115 | 165 | 214 | pF |
| Crss | 反向传输电容 | 33 | 55 | 80 | pF |
| Rg | 栅极电阻 | 0.3 | 0.65 | 1.0 | Ω |

### 栅极电荷 (VGS=10V, VDS=50V, ID=20A)

| 符号 | 参数 | 最小 | 典型 | 最大 | 单位 |
|---|---|---|---|---|---|
| Qg | 总栅极电荷 | 14 | 28 | 42 | nC |
| Qgs | 栅-源电荷 | 4 | 9 | 14 | nC |
| Qgd | 栅-漏电荷 | 6 | 10 | 14 | nC |

### 开关参数 (VGS=10V, VDS=50V, RL=2.5Ω, RGEN=3Ω)

| 符号 | 参数 | 最小 | 典型 | 最大 | 单位 |
|---|---|---|---|---|---|
| tD(on) | 开通延时 | | 12 | | ns |
| tr | 上升时间 | | 4 | | ns |
| tD(off) | 关断延时 | | 17 | | ns |
| tf | 下降时间 | | 5 | | ns |

### 体二极管反向恢复 (IF=20A, dI/dt=500A/µs)

| 符号 | 参数 | 最小 | 典型 | 最大 | 单位 |
|---|---|---|---|---|---|
| trr | 反向恢复时间 | 12 | 20 | 26 | ns |
| Qrr | 反向恢复电荷 | 60 | 82 | 110 | nC |

## 设计参考（TMC5160 栅极驱动相关）

- 100V/43A 额定值满足 TMC5160 外部桥臂 8~60V 供电设计。
- RDS(ON) 24mΩ 结合 TMC5160 `DRV_CONF` 斜率配置，决定开关损耗与 EMI。
- 米勒电荷 Qgd=10nC 决定栅极驱动斜率（详见硬件设计.md「选择 MOSFET 和斜率」）。
