e1aco/ELACO_StepMotorTMC5160/AIFirmware/StepMotorDriver_Keil/KNOWLEDGE/TMC5160A/registers.md

# 寄存器表

> **提示：** 通常 TMC5160 SPI 时序指的是 SPI 模式 3。最高 SPI 时钟 SCK 为系统时钟频率的一半；若系统时钟基于片上振荡器，需额外 10% 安全裕度确保可靠传输。所有 SPI 输入以及 ENN 输入经过内部滤波，避免被短于 20ns 的脉冲触发。（外部 16MHz 时钟下 f_SCK ≤ 8MHz；内部振荡器下 f_SCK ≤ 4MHz。）

## 寄存器地址总览

| 寄存器 | 地址 | 功能 |
|---|---|---|
| GCONF | 0x00 | 全局配置 |
| GSTAT | 0x01 | 全局状态标志 |
| IFCNT | 0x02 | 接口传输计数器 |
| SLAVECONF | 0x03 | 从机配置（UART 地址与发送延时） |
| IOIN | 0x04 | 输入/输出引脚状态读取 |
| OUTPUT | 0x04 | 输出引脚极性设置（UART 模式） |
| X_COMPARE | 0x05 | 位置比较寄存器 |
| OTP_PROG | 0x06 | OTP 编程 |
| OTP_READ | 0x07 | OTP 读取（OTP 配置存储器） |
| FACTORY_CONF | 0x08 | 出厂配置（时钟微调 FCLKTRIM） |
| SHORT_CONF | 0x09 | 短路检测配置 |
| DRV_CONF | 0x0A | 驱动器配置（BBM/过温/驱动强度） |
| GLOBAL_SCALER | 0x0B | 电机电流全局缩放 |
| OFFSET_READ | 0x0C | 偏移校准结果读取 |
| IHOLD_IRUN | 0x10 | 驱动电流控制（保持/运行电流） |
| TPOWERDOWN | 0x11 | 静止后电流下降延时 |
| TSTEP | 0x12 | 实际微步时间测量值 |
| TPWMTHRS | 0x13 | StealthChop 电压 PWM 模式上限速度 |
| TCOOLTHRS | 0x14 | CoolStep 和 stallGuard 功能下限速度 |
| THIGH | 0x15 | 高速斩波/全步切换速度阈值 |
| RAMPMODE | 0x20 | 斜坡模式 |
| XACTUAL | 0x21 | 实际电机位置 |
| VACTUAL | 0x22 | 实际电机速度 |
| VSTART | 0x23 | 电机起动速度 |
| A1 | 0x24 | VSTART 与 V1 之间加速度 |
| V1 | 0x25 | 第一加速/减速阶段阈值速度 |
| AMAX | 0x26 | V1 与 VMAX 之间加速度 |
| VMAX | 0x27 | 运动斜坡目标速度 |
| DMAX | 0x28 | VMAX 与 V1 之间减速度 |
| D1 | 0x2A | V1 与 VSTOP 之间减速度 |
| VSTOP | 0x2B | 电机停止速度 |
| TZEROWAIT | 0x2C | 速度为零的等待时间 |
| XTARGET | 0x2D | 斜坡模式目标位置 |
| VDCMIN | 0x33 | DcStep 自动切换最小速度 |
| SW_MODE | 0x34 | 参考开关和 StallGuard2 事件配置 |
| RAMP_STAT | 0x35 | 斜坡和参考开关状态 |
| XLATCH | 0x36 | 斜坡发生器锁存位置 |
| ENCMODE | 0x38 | 编码器和 N 通道配置 |
| X_ENC | 0x39 | 实际编码器位置 |
| ENC_CONST | 0x3A | 编码器累加常数 |
| ENC_STATUS | 0x3B | 编码器状态信息 |
| ENC_LATCH | 0x3C | N 事件锁存的编码器位置 |
| ENC_DEVIATION | 0x3D | 编码器偏差报警阈值 |
| MSLUT[0] | 0x60 | 微步表入口 0…31 |
| MSLUT[1...7] | 0x61…0x67 | 微步表入口 32…255 |
| MSLUTSEL | 0x68 | 微步表查找表段定义 |
| MSLUTSTART | 0x69 | 微步表起始值 START_SIN / START_SIN90 |
| MSCNT | 0x6A | 微步计数器 |
| MSCURACT | 0x6B | 实际微步电流 CUR_A / CUR_B |
| CHOPCONF | 0x6C | 斩波器和驱动配置 |
| COOLCONF | 0x6D | CoolStep 智能电流控制和 StallGuard2 配置 |
| DCCTRL | 0x6E | DcStep 自动换向配置 |
| DRV_STATUS | 0x6F | StallGuard2 值和驱动错误标志 |
| PWMCONF | 0x70 | 电压 PWM 模式斩波器配置 |
| PWM_SCALE | 0x71 | 斩波调幅器结果 |
| PWM_AUTO | 0x72 | 自动标定的 PWM 偏移/梯度值 |
| LOST_STEPS | 0x73 | DcStep 模式丢失步数 |

> **注意：**
> - 除非另有说明，否则所有寄存器在加电后都会重置为 0。
> - 将 0x80 与地址 Addr 相加以进行写访问！
> - 符号说明：0x = 十六进制数前缀，例如 0x04；% = 多个二进制位前的前缀，例如 %100。
> - 读写字符号：R = 只读；W = 只写；R/W = 可读可写；R+WC = 读清零（写 '1' 以清除相应标志）。

## 寄存器组概述

- **通用配置寄存器**（0x00…0x0F）：全局配置、全局状态标志、接口配置、输入/输出信号配置。
- **与速度相关的驱动特性控制寄存器**（0x10…0x1F）：驱动器电流控制、CoolStep 操作阈值、不同斩波模式阈值、DcStep 操作阈值。
- **斜坡发生器运动控制寄存器集**（0x20…0x2D）：选择斜坡模式、选择速度、归零、加速和减速、目标定位。
- **斜坡发生器驱动特性控制寄存器组**（0x30…0x36）：参考开关和 StallGuard2 事件配置、斜坡和参考开关状态。
- **编码器寄存器集**（0x38…0x3D）：ABN 编码器对应的所有寄存器。
- **电机驱动寄存器集**（0x60…0x7F）：设置/读出微步表和计数器、斩波器和驱动器配置、CoolStep 和 StallGuard2 配置、DcStep 配置、读 StallGuard2 参数值及驱动器错误标志。

---

## 通用配置寄存器 (0x00…0x0F)

### GCONF (0x00)

读写：R/W · 位数：17 位

| 位 | 名称 | 值 | 描述 |
|----|---|----|---|
| 0 | recalibrate | — | 1: 不使能驱动器期间的过零重新校准（通过 ENN/TOFF 设置） |
| 1 | faststandstill | — | 超过该时间没有步进信号输入则产生静止标志：1: 短时间长度 2^18 时钟；0: 正常时间长度 2^20 时钟 |
| 2 | en_pwm_mode | — | 1: 使能 StealthChop 电压 PWM 模式（取决于速度阈值）。仅在静止状态下及 IHOLD = 标称 IRUN 进行从断开到导通的切换 |
| 3 | multistep_filt | — | 1: 使用外部步进 STEP 输入源时，使能步进输入滤波器优化性能（缺省 = 1） |
| 4 | shaft | — | 1: 电机反向 |
| 5 | diag0_error（仅 SD_MODE=1） | — | 1: 使能 DIAG0 在驱动器遇到以下故障时输出故障指示：过温（ot）、对地短路（s2g）、电荷泵欠压（uv_cp）。DIAG0 总是显示复位状态，即在复位状态期间为有效低电平 |
| 6 | diag0_otpw（仅 SD_MODE=1） | — | 1: 使能 DIAG0 输出驱动器过热预警（otpw）指示信号 |
| 7 | diag0_stall（SD_MODE=1）<br>diag0_step（SD_MODE=0） | — | diag0_stall: 1: 使能 DIAG0 输出电机堵转有效信号（使用此功能前设置 TCOOLTHRS）。diag0_step: 1: 使能 DIAG0 输出步进脉冲，可控制外部 STEP/DIR 驱动器；0: DIAG0 输出中断信号 |
| 8 | diag1_stall（SD_MODE=1）<br>diag1_dir（SD_MODE=0） | — | diag1_stall: 1: 使能 DIAG1 输出电机堵转信号（使用此功能前设置 TCOOLTHRS）。diag1_dir: 0: DIAG1 输出位置比较信号 |
| 9 | diag1_index（仅在 SD_MODE=1） | — | 1: 使能 DIAG1 输出索引位置信号（微步查找表 0 位置） |
| 10 | diag1_onstate（仅在 SD_MODE=1） | — | 1: 使能 DIAG1 输出斩波器导通阶段指示信号（步的第二部分） |
| 11 | diag1_steps_skipped（仅在 SD_MODE=1） | — | 1: 使能 DIAG1 在 DcStep 模式下失步时翻转输出信号（LOST_STEPS 增加）。不要与其他 DIAG1 选项一起使能 |
| 12 | diag0_int_pushpull | — | 0: SWN_DIAG0 集电极开路输出（低电平有效）；1: SWN_DIAG0 推挽输出（高电平有效） |
| 13 | diag1_poscomp_pushpull | — | 0: SWP_DIAG1 集电极开路输出（低电平有效）；1: SWP_DIAG1 推挽输出（高电平有效） |
| 14 | small_hysteresis | — | 0: 步进 step 频率的比较磁滞是 1/16；1: 步进 step 频率的比较磁滞是 1/32 |
| 15 | stop_enable | — | 0: 正常操作；1: 紧急停止：ENCA_DCIN 在高电平时停止定序器 |
| 16 | direct_mode | — | 0: 正常操作；1: 直接模式，使能引脚 ENCN_DCO 上的模拟测试输出。IHOLD[1..0] 选择 ENCN_DCO 的功能：0…2: T120、DAC、VDDH |
| 17 | test_mode | — | 0: 正常操作；1: 使能测试模式。提示：不对用户开放，正常操作时设置为 0 |

### GSTAT (0x01)

读写：R+WC（写 '1' 以清除相应标志） · 位数：3 位

| 位 | 名称 | 值 | 描述 |
|----|---|----|---|
| 0 | reset | 1 | 表示芯片已复位。所有寄存器都清零并重置复位值 |
| 1 | drv_err | 1 | 驱动器错误 |
| 2 | uv_cp | 1 | 电荷泵欠压（uv_cp） |

### IFCNT (0x02)

读写：R · 位数：8 位

| 位 | 名称 | 值 | 描述 |
|----|---|----|---|
| 全 8 位 | IFCNT | — | 接口传输计数器。每成功写入 UART 接口，该寄存器会增加。可以读出它来检查串行传输中是否有丢失的数据。读取访问不会更改内容。在 SPI 操作中禁用。计数器循环计数，到 255 后从 0 开始 |

### SLAVECONF (0x03)

读写：W · 位数：8 位（+ 4 位扩展位）

| 位 | 名称 | 值 | 描述 |
|----|---|----|---|
| 7..0 | SLAVEADDR | — | 这八位设置 UART 接口的单元地址。当外部地址引脚 NEXTADDR 激活时，地址加 1。范围：0 - 253（不能递增到 254），默认值 = 0 |
| 11..8 | SENDDELAY | — | 0, 1: 8 比特位对应的时间长度（多个从设置不能设置为该值）；2, 3: 3*8 比特位对应的时间长度；4, 5: 5*8 比特位对应的时间长度；6, 7: 7*8 比特位对应的时间长度；8, 9: 9*8 比特位对应的时间长度；10, 11: 11*8 比特位对应的时间长度；12, 13: 13*8 比特位对应的时间长度；14, 15: 15*8 比特位对应的时间长度 |

### IOIN (0x04)

读写：R · 位数：8 位（+ 版本号 31..24）

| 位 | 名称 | 值 | 描述 |
|----|---|----|---|
| 0 | OUTPUT | — | 在 UART 模式下，SDO_CFG0 是一个输出。此位设置该引脚的输出（在 UART 模式下设置输出引脚极性） |
| 1 | REFR_DIR | — | 读取所有可用输入引脚的状态 |
| 2 | ENCB_DCEN_CFG4 | — | 读取输入引脚状态 |
| 3 | ENCA_DCIN_CFG5 | — | 读取输入引脚状态 |
| 4 | DRV_ENN | — | 读取输入引脚状态 |
| 5 | ENC_N_DCO_CFG6 | — | 读取输入引脚状态 |
| 6 | SD_MODE | — | 1 = 外部步进和方向输入源 |
| 7 | SWCOMP_IN | — | SWN 和 SWP 的电压差。将 DIAG 输出置于高电平，禁止推挽以测试比较器 |
| 31..24 | VERSION | 0x30 | 芯片版本号。相同的数字意味着数字全兼容性 |

### OUTPUT (0x04)

读写：W · 位数：1 位

| 位 | 名称 | 值 | 描述 |
|----|---|----|---|
| 0 | OUTPUT | — | 在 UART 模式下设置输出引脚极性 |

### X_COMPARE (0x05)

读写：W · 位数：32 位

| 位 | 名称 | 值 | 描述 |
|----|---|----|---|
| 全 32 位 | X_COMPARE | — | 位置比较寄存器，用于运动控制器位置探测，位置脉冲输出在引脚 SWP_DIAG1。XACTUAL = X_COMPARE 时输出信号 PP（位置脉冲）置高，如果和目标位置不等，则为低电平 |

### OTP_PROG (0x06)

读写：W · 位数：3 位

| 位 | 名称 | 值 | 描述 |
|----|---|----|---|
| 2..0 | OTPBIT | — | OTP_PROGRAM - OTP 编程。写操作是对 OTP 存储器设置（一次一位）。读操作是在写操作之后刷新 OTP 的读数据。OTPBIT 选择要编程到选定字节位置的 OTP 位（n = 0..7: 将位 n 编程到逻辑 1） |

### OTP_READ (0x07)

读写：R · 位数：8 位

| 位 | 名称 | 值 | 描述 |
|----|---|----|---|
| 全 8 位 | OTP_READ | — | 访问 OTP 内存结果和更新（通过读取 OTP_READ 进行检查）。请另见下表：OTP 存储器映射 |

#### OTP_READ - OTP 存储器映射

| 位 | 名称 | 功能 | 备注 |
|----|---|---|---|
| 7 | otp0.7 | otp_TBL | TBL 复位缺省值：0: TBL = %10 (~3µs)；1: TBL = %01 (~2µs) |
| 6 | otp0.6 | otp_BBM | DRVCONF.BBMCLKS 复位缺省值：0: BBMCLKS = 4；1: BBMCLKS = 2 |
| 5 | otp0.5 | otp_S2_LEVEL | 短路检测电平复位缺省值：0: S2G_LEVEL = S2VS_LEVEL = 6；1: S2G_LEVEL = S2VS_LEVEL = 12 |
| 4 | otp0.4 | OTP_FCLKTRIM | FCLKTRIM 复位缺省值：0: 最低频率设置；31: 最高频率设置 |
| 3 | otp0.3 | OTP_FCLKTRIM | 同上（FCLKTRIM 位） |
| 2 | otp0.2 | OTP_FCLKTRIM | 同上（FCLKTRIM 位） |
| 1 | otp0.1 | OTP_FCLKTRIM | 注意：该值是出厂设置，预编程为默认时钟频率 12MHz，并且在各个芯片之间有所不同！它不能被改变 |
| 0 | otp0.0 | OTP_FCLKTRIM | 注意：该值是出厂设置，预编程为默认时钟频率 12MHz，并且在各个芯片之间有所不同！它不能被改变 |

> OTP 存储器保存某些寄存器的加电默认值。默认情况下，所有 OTP 内存位都清零。只能编程这些位，不可清除。otp0.0 到 otp0.4 为时钟出厂频率调整值，因此这些位的状态在各个芯片之间可能会有所不同。

### FACTORY_CONF (0x08)

读写：RW · 位数：5 位

| 位 | 名称 | 值 | 描述 |
|----|---|----|---|
| 4..0 | FCLKTRIM | — | FCLKTRIM（复位缺省：OTP）。0…31: 最低到最高时钟频率，在电荷泵输出检测。频率跨度并不保证，但经过测试，调到 12MHz 内部时钟是可能的。通过 OTP 编程，芯片预设为 12MHz 时钟频率（复位缺省值：OTP） |

### SHORT_CONF (0x09)

读写：W · 位数：19 位

| 位 | 名称 | 值 | 描述 |
|----|---|----|---|
| 3..0 | S2VS_LEVEL | — | 低端场效应晶体管的对 VS 的短路电平。检测 LS MOSFET 和采样电阻上的电压跌落。4（最高灵敏度）…15（最低灵敏度）。提示：由于采样电阻上的电压跌落，在正常操作期间设置成 1 到 3 可能会触发（复位缺省值：OTP 6 或 12） |
| 11..8 | S2G_LEVEL | — | 高端场效应晶体管的对地短路电平，测量高端 MOSFET 上的电压跌落。2（最高灵敏度）…15（最低灵敏度）。注意：在 >52V 操作时不建议设置低于 6，可能会导致错误检测（复位缺省值：OTP 6 或 12） |
| 17..16 | SHORTFILTER | — | 短路检测的尖峰滤波带宽：0（最低，100ns）、1（1µs）、2（2µs）、3（3µs）。提示：好的 PCB 布局可配置 0。如果出现错误的短路检测输出，则增加值（复位缺省值 = %01） |
| 18 | shortdelay | — | 短路检测延迟：0 = 750ns 正常，1 = 1500ns 高。短路检测延迟应大于桥臂切换时间。0 将适用于大多数应用程序（复位缺省值 = 0） |

### DRV_CONF (0x0A)

读写：W · 位数：22 位

| 位 | 名称 | 值 | 描述 |
|----|---|----|---|
| 4..0 | BBMTIME | — | 导通前的关断延时：0=最短（100ns）…16（200ns）…24=最长（375ns），不推荐大于 24 的设置，建议 BBMCLKS 替代。提示：根据开关时间的最低设置是安全的，避免桥臂直通。保留大约 30% 的余量（复位缺省值 = 0） |
| 11..8 | BBMCLKS | — | 0..15: 以时钟周期为单位的 BBM 时间（典型值 83ns），设定更长时间（BBMTIME 对 BBMCLKS）（复位缺省值：OTP 4 或 2） |
| 17..16 | OTSELECT | — | 选择桥关断的过温级别，冷却至 120°C / OTPW 后恢复：00: 150°C；01: 143°C；10: 136°C（当 VSA > 24V 时不推荐）；11: 120°C（不推荐，没有滞环）。提示：根据需要调整过热阈值以保护 MOSFET 或 PCB 上的其他组件（复位缺省值 = %00） |
| 19..18 | DRVSTRENGTH | — | 栅极驱动器电流的选择，根据外部 MOSFET 的栅极电荷 |

### GLOBAL_SCALER (0x0B)

读写：W · 位数：8 位

| 位 | 名称 | 值 | 描述 |
|----|---|----|---|
| 7..0 | GLOBAL_SCALER | — | 电机电流的全局缩放。该值乘以当前的比例，以便使驱动器适应某一电机类型。在调整其他设置之前，应该选择这个值，因为它也会影响斩波器磁滞。0: 满量程（或写 256）；1…31: 无效；32…255: 最大电流的 32/256…255/256。提示：建议 >128 以获得最佳结果（复位缺省值 = 0） |

### OFFSET_READ (0x0C)

读写：R · 位数：16 位

| 位 | 名称 | 值 | 描述 |
|----|---|----|---|
| 15..8 | OFFSET_READ | — | A 相偏移校准结果（有符号） |
| 7..0 | OFFSET_READ | — | B 相偏移校准结果（有符号） |

---

## 与速度相关的驱动特性控制寄存器 (0x10…0x1F)

### IHOLD_IRUN (0x10)

读写：W · 位数：10 位（5 + 5）

| 位 | 名称 | 值 | 描述 |
|----|---|----|---|
| 4..0 | IHOLD | — | 静止状态下电机电流（0=1/32…31=32/32）。StealthChop 模式下，设置 IHOLD = 0 可配置电机静止状态为飞轮模式或线圈短路模式 |
| 12..8 | IRUN | — | 电机运行电流（0=1/32…31=32/32）。提示：选择适合的采样电阻，建议 IRUN 设置范围是 16 到 31，以获得最佳的微步性能 |

### TPOWERDOWN (0x11)

读写：W · 位数：8 位

| 位 | 名称 | 值 | 描述 |
|----|---|----|---|
| 全 8 位 | TPOWERDOWN | — | 是电机静止标志（stst）有效到电机开始降电流之间的延时时间。时间范围约为 0 至 4 秒。注意：要求最小设置为 2，以允许自动校正 StealthChop PWM_OFFS_AUTO。复位缺省值 10 |

### TSTEP (0x12)

读写：R · 位数：20 位

| 位 | 名称 | 值 | 描述 |
|----|---|----|---|
| 全 20 位 | TSTEP | — | 两个步进输入信号之间的实际测量时间，以 1/fCLK 及 256 微步为单位。测量范围为 (2^20)-1，以防溢出或电机进入静止状态。所有与 TSTEP 相关的阈值使用比较值的 1/16 的滞环来补偿时钟或步进频率中的抖动。small_hysteresis 标志将滞环修改为较小的 1/32（(Txxx*15/16)-1 或 (Txxx*31/32)-1 作为第二个比较值，这意味着切换速度的低值等于计算的设置，但切换速度的高值高于定义的磁滞设置）。当运动控制器有效时，对于给定速度 V，测量的 TSTEP 在 (2^24/V) ≤ TSTEP ≤ 2^24/V-1 范围内。在 DcStep 模式下，TSTEP 不是电机的平均速度，而是每个微步的速度。微步速度可能不稳定，而且因为运行速度低于目标速度，所以不对应实际电机速度 |

### TPWMTHRS (0x13)

读写：W · 位数：20 位

| 位 | 名称 | 值 | 描述 |
|----|---|----|---|
| 全 20 位 | TPWMTHRS | — | StealthChop 电压 PWM 模式的上限速度。TSTEP ≥ TPWMTHRS：如果配置了 StealthChop，则 StealthChop PWM 使能；DcStep 禁用 |

### TCOOLTHRS (0x14)

读写：W · 位数：20 位

| 位 | 名称 | 值 | 描述 |
|----|---|----|---|
| 全 20 位 | TCOOLTHRS | — | 使能 CoolStep 和 stallGuard 功能的下限速度（无符号）。设置此参数则在低速时禁用 CoolStep，因为低速时不能可靠工作。在超过该速度时堵转停止功能（当内部运动控制器工作时，使能 sg_stop）和堵转输出信号有效。在非 DcStep 模式下，一旦速度降到这个阈值以下，它就会再次被禁用。TCOOLTHRS ≥ TSTEP ≥ THIGH：CoolStep 使能（如果已配置）；StealthChop 电压 PWM 模式禁用。TCOOLTHRS ≥ TSTEP：使能堵转停止，如果被配置 |

### THIGH (0x15)

读写：W · 位数：20 位

| 位 | 名称 | 值 | 描述 |
|----|---|----|---|
| 全 20 位 | THIGH | — | 该速度阈值允许系统切换到不同的斩波模式和全步来产生最大扭矩（无符号）。每当通过 THIGH 阈值时，堵转检测功能会关闭 2-3 个电周期，以补偿切换模式的影响。TSTEP ≤ THIGH：CoolStep 被禁用（电机按设定的正常电流运行）；StealthChop 电压 PWM 模式被禁用；如果设置了 vhighchm，斩波器将切换到 chm = 1、TFD = 0（只有慢衰减的恒定关闭时间）；如果设置了 vhighfs，电机以全步模式运行，堵转检测切换到 DcStep 堵转检测 |

> **时间基准：** 速度的时间基准 t = 2^24 / fCLK；加速度的时间基准 ta² = 2^41 / (fCLK)²；微步速度的时间基准 TSTEP = fCLK / fSTEP。

---

## 斜坡发生器运动寄存器集 (0x20…0x2D)

### RAMPMODE (0x20)

读写：RW · 位数：2 位 · 范围 0…3

| 位 | 名称 | 值 | 描述 |
|----|---|----|---|
| 全 2 位 | RAMPMODE | — | 0: 位置模式（使用所有 A、D 和 V 参数）；1: 速度模式到正 VMAX（使用 AMAX 加速度）；2: 速度模式至负 VMAX（使用 AMAX 加速度）；3: 保持模式（除非发生停止事件，否则速度保持不变） |

### XACTUAL (0x21)

读写：RW · 位数：32 位 · 范围 -2^31…+(2^31)-1

| 位 | 名称 | 值 | 描述 |
|----|---|----|---|
| 全 32 位 | XACTUAL | — | 实际电机位置（有符号）。提示：该值通常只应在归零时修改。在位置模式下，修改内容将启动一个运动 |

### VACTUAL (0x22)

读写：R · 位数：24 位 · 范围 +-(2^23)-1 [µsteps/t]

| 位 | 名称 | 值 | 描述 |
|----|---|----|---|
| 全 24 位 | VACTUAL | — | 斜坡发生器产生的实际电机速度（有符号）。符号标志与运动方向相匹配。负号表示运动会朝着 XACTUAL 变小的方向运动 |

### VSTART (0x23)

读写：W · 位数：18 位 · 范围 0…(2^18)-1 [µsteps/t]

| 位 | 名称 | 值 | 描述 |
|----|---|----|---|
| 全 18 位 | VSTART | — | 电机起动速度（无符号）。为了通用，设置 VSTOP≥VSTART。如果运动距离足以确保从 VSTART 到 VSTOP 的减速，则不是必须 |

### A1 (0x24)

读写：W · 位数：16 位 · 范围 0…(2^16)-1 [µsteps/ta²]

| 位 | 名称 | 值 | 描述 |
|----|---|----|---|
| 全 16 位 | A1 | — | VSTART 和 V1 之间的加速度（无符号） |

### V1 (0x25)

读写：W · 位数：20 位 · 范围 0…(2^20)-1 [µsteps/t]

| 位 | 名称 | 值 | 描述 |
|----|---|----|---|
| 全 20 位 | V1 | — | 第一加速/减速阶段阈值速度（无符号）。0: A1 和 D1 无效，仅使用 AMAX、DMAX |

### AMAX (0x26)

读写：W · 位数：16 位 · 范围 0…(2^16)-1 [µsteps/ta²]

| 位 | 名称 | 值 | 描述 |
|----|---|----|---|
| 全 16 位 | AMAX | — | V1 和 VMAX 之间的加速度（无符号）。这是速度模式的加速度和减速值 |

### VMAX (0x27)

读写：W · 位数：23 位 · 范围 0…(2^23)-512 [µsteps/t]

| 位 | 名称 | 值 | 描述 |
|----|---|----|---|
| 全 23 位 | VMAX | — | 运动斜坡目标速度（位置模式确保 VMAX≥VSTART）（无符号）。速度模式下的目标速度。它可以在运动过程中随时改变 |

### DMAX (0x28)

读写：W · 位数：16 位 · 范围 0…(2^16)-1 [µsteps/ta²]

| 位 | 名称 | 值 | 描述 |
|----|---|----|---|
| 全 16 位 | DMAX | — | VMAX 和 V1 之间的减速度（无符号） |

### D1 (0x2A)

读写：W · 位数：16 位 · 范围 1…(2^16)-1 [µsteps/ta²]

| 位 | 名称 | 值 | 描述 |
|----|---|----|---|
| 全 16 位 | D1 | — | V1 和 VSTOP 之间的减速度（无符号）。注意：不要在位置模式下设为 0，即使 V1 = 0！ |

### VSTOP (0x2B)

读写：W · 位数：18 位 · 范围 1…(2^18)-1 [µsteps/t]，上电缺省值 = 1

| 位 | 名称 | 值 | 描述 |
|----|---|----|---|
| 全 18 位 | VSTOP | — | 电机停止速度（无符号）。提示：设置 VSTOP≥VSTART 则允许短距离位置模式。注意：不要在位置模式下设为 0，推荐至少设为 10！ |

### TZEROWAIT (0x2C)

读写：W · 位数：16 位 · 范围 0…(2^16)-1 * 512 t_CLK

| 位 | 名称 | 值 | 描述 |
|----|---|----|---|
| 全 16 位 | TZEROWAIT | — | 下一次移动或方向反转开始前，速度为 0 的等待时间。时间范围约为 0 至 2 秒。此设置可避免过度加速，例如从 VSTOP 到 -VSTART |

### XTARGET (0x2D)

读写：RW · 位数：32 位 · 范围 -2^31…+(2^31)-1

| 位 | 名称 | 值 | 描述 |
|----|---|----|---|
| 全 32 位 | XTARGET | — | 斜坡模式的目标位置（有符号）。向该寄存器写入新的目标位置，激活 RAMPMODE=0 中的斜坡发生器。需要初始化所有速度、加速和减速参数。提示：该位置寄存器可以循环，因此 XTARGET 值可以被视为无符号数字。提示：最大可能位移为 +/-((2^31)-1)。提示：在运动中如果需要修改 V1、D1 或 DMAX，必须事后重写 XTARGET 使得第二加速阶段的参数有效 |

---

## 斜坡发生器驱动特性控制寄存器组 (0x30…0x36)

### VDCMIN (0x33)

读写：W · 位数：23 位

| 位 | 名称 | 值 | 描述 |
|----|---|----|---|
| 全 23 位 | VDCMIN | — | 大于 VDCMIN（无符号）自动切换到 DcStep（仅当使用内部斜坡发生器有效时，而非 STEP/DIR 模式时——STEP/DIR 模式下，DcStep 由外部信号 DCEN 启用）。在这种模式下，实际位置由无传感器的电机换向确定，并反馈给 XACTUAL。如果电机负载很大，VDCMIN 也用作最小速度。激活堵转停止（sg_stop）以检测失步。0: 禁用，关闭 DcStep。\|VACT\| ≥ VDCMIN ≥ 256：触发与大于 THIGH 相同的动作；切换到自动换向 DcStep 工作方式。提示：需设置 DCCTRL 参数来操作 DcStep（只有位 22…8 用于比较值） |

### SW_MODE (0x34)

读写：RW · 位数：12 位 · 参考开关和 StallGuard2 事件配置寄存器

| 位 | 名称 | 值 | 描述 |
|----|---|----|---|
| 11 | en_softstop | — | 0: 硬停；1: 软停。软停模式总是使用减速斜坡的参数 DMAX、V1、D1、VSTOP 和 TZEROWAIT 来停止电机。当速度符号匹配参考开关位置（REFL 表示负速度，REFR 表示正速度）并且相应的开关停止功能被使能时，停止发生。在马达被释放之前，硬停止也使用 TZEROWAIT。注意：不要将软停与 stallguard 2 结合使用。StealthChop 模式下高速运行使用软停。在这种情况下，必须避免硬停，因为这会导致严重的过电流 |
| 10 | sg_stop | — | 1: 使能 stallguard 2 停止（也可在 DcStep 模式下使用）。停止事件后需要禁用以释放电机。TCOOLTHRS 为对应的速度阈值。提示：在电机加速期间不要启用，等到电机速度超过某个值，此时 StallGuard2 会提供稳定的结果，对应的速度阈值为 TCOOLTHRS |
| 9 | en_latch_encoder | — | 1: 参考开关事件有效时将编码器位置锁定到 ENC_LATCH |
| 8 | latch_r_inactive | — | 1: 当右侧参考开关输入 REFR 向非有效电平跳变时，位置锁存至 XLATCH。有效电平由 pol_stop_r 定义 |
| 7 | latch_r_active | — | 1: 当右侧参考开关输入 REFR 向有效电平跳变时，位置锁存至 XLATCH。提示：激活 latch_r_active，通过读 status_latch_r 来检测任何虚假停止事件 |
| 6 | latch_l_inactive | — | 1: 当左侧参考开关输入 REFL 向非有效电平跳变时，位置锁存至 XLATCH。有效电平由 pol_stop_l 定义 |
| 5 | latch_l_active | — | 1: 当左侧参考开关输入 REFL 向有效电平跳变时，位置锁存至 XLATCH。提示：激活 latch_l_active，通过读 status_latch_l 来检测任何虚假的停止事件 |
| 4 | swap_lr | — | 1: 交换左右参考开关输入 REFL 和 REFR |
| 3 | pol_stop_r | — | 设置右参考开关输入的有效极性。0 = 非反转，高有效：REFR 上的高电平会停止电机；1 = 反转，低有效：REFR 上的低电平停止电机 |
| 2 | pol_stop_l | — | 设置左参考开关输入的有效极性。0 = 非反转，高有效：REFL 上的高电平停止电机；1 = 反转，低有效：REFL 上的低电平停止电机 |
| 1 | stop_r_enable | — | 1: 使能右参考开关有效时电机停止。提示：如果参考开关释放，电机将重新启动 |
| 0 | stop_l_enable | — | 1: 使能左参考开关有效时电机停止。提示：如果参考开关释放，电机将重新启动 |

### RAMP_STAT (0x35)

读写：R+WC · 位数：14 位 · 斜坡和参考开关状态寄存器

| 位 | 名称 | 值 | 描述 |
|----|---|----|---|
| 13 | status_sg | 1 | CoolStep 驱动器或 DcStep 单元（如果使能）产生的有效 StallGuard2 输入信号。提示：轮询此标志时，可能会错过堵转事件——激活 sg_stop 以确保不会错过失速事件 |
| 12 | second_move | 1 | 表明自动斜坡需要反向移动，例如由于运行中的参数变化（写 '1' 以清除） |
| 11 | t_zerowait_active | 1 | 电机停止后 TZEROWAIT 有效的时间段。在此期间，电机处于静止状态 |
| 10 | vzero | 1 | 实际速度为 0 |
| 9 | position_reached | 1 | 到达了目标位置。当 XACTUAL 和 XTARGET 匹配时，此标志会被设置 |
| 8 | velocity_reached | 1 | 达到了目标速度。当 VACTUAL 和 VMAX 匹配时，此标志会被设置 |
| 7 | event_pos_reached | 1 | 目标位置已经到达（position_reached 变为有效）事件。写入 '1' 以清除标志和中断条件。该位与中断输出信号进行或运算 |
| 6 | event_stop_sg | 1 | StallGuard 2 停止事件。复位寄存器将清除堵转状态，电机可能会重新启动运动，除非运动控制器已经停止。写入 '1' 以清除标志和中断条件。该位与中断输出信号进行或运算 |
| 5 | event_stop_r | 1 | 右停止（参考）开关有效产生的停止事件。可以通过将 RAMP_MODE 设置为保持模式或通过命令向相反方向移动来去除停止条件和中断条件。在 soft_stop 模式下，该条件将保持激活状态，直到电机停止向停止开关方向运动。禁用停止开关或停止功能也会清除标记，但电机将继续运动。该位与中断输出信号进行或运算 |
| 4 | event_stop_l | 1 | 左停止（参考）开关有效产生的停止事件。可以通过将 RAMP_MODE 设置为保持模式或通过命令向相反方向移动来去除停止条件和中断条件。在 soft_stop 模式下，该条件将保持激活状态，直到电机停止向停止开关方向运动。禁用停止开关或停止功能也会清除标记，但电机将继续运动。该位与中断输出信号进行或运算 |
| 3 | status_latch_r | 1 | 右锁存就绪（设置 SW_MODE 寄存器使能位置锁存 latch_r_active 或 latch_r_inactive）。写 '1' 清除 |
| 2 | status_latch_l | 1 | 左锁存就绪（设置 SW_MODE 寄存器使能位置锁存 latch_l_active 或 latch_l_inactive）。写 '1' 清除 |
| 1 | status_stop_r | 1 | 右参考开关状态（1 = 有效） |
| 0 | status_stop_l | 1 | 左参考开关状态（1 = 有效） |

### XLATCH (0x36)

读写：R · 位数：32 位

| 位 | 名称 | 值 | 描述 |
|----|---|----|---|
| 全 32 位 | XLATCH | — | 斜坡发生器锁存位置，当设置的开关事件条件满足时锁存 XACTUAL（参见 SW_MODE）。提示：可将编码器位置与 XLATCH 一起锁定到 ENC_LATCH，便于一致性检查 |

---

## 编码器寄存器 (0x38…0x3D)

> **注意：** 编码器接口在 STEP/DIR（步进/方向）模式下不可用，因为编码器引脚在该模式下有其它的功能。

### ENCMODE (0x38)

读写：RW · 位数：11 位 · 编码器和 N 通道配置

| 位 | 名称 | 值 | 描述 |
|----|---|----|---|
| 10 | enc_sel_decimal | — | 编码器预分频器二进制模式：ENC_CONST（小数部分）/ 65536 |
| 9 | latch_x_act | — | 1: 与 X_ENC 一起锁定 XACTUAL。根据 N 通道事件的 pos_edge 和 neg_edge 配置锁定斜坡发生器位置 |
| 8 | clr_enc_x | — | 0: 当发生 N 事件时，X_ENC 仅锁存到 ENC_LATCH；1: N 事件时锁存并清除编码器计数器 X_ENC |
| 7 | neg_edge | — | N 通道的敏感度 |
| 6 | pos_edge | — | N 通道的有效电平触发 N 通道事件：%00: 1 向有效电平的跳变触发 N 事件有效；%01: 0 向非有效电平的跳变触发 N 通道有效；%11: 向有效电平及非有效电平的跳变触发 N 通道有效 |
| 5 | clr_once | — | 1: 写访问后的下一个 N 事件中，锁存或锁存并清除 X_ENC |
| 4 | clr_cont | — | 1: N 事件时，始终锁存或锁存并清除 X_ENC（每转一圈一次，建议将此设置与 N 事件的边缘设置相结合） |
| 3 | ignore_AB | — | 0: 只有当极性与 pol_N、pol_A 和 pol_B 定义的极性匹配，N 事件发生；1: 忽略 N 通道事件的 A 和 B 极性 |
| 2 | pol_N | — | 定义 N 通道的有效极性（0 = 低有效，1 = 高有效） |
| 1 | pol_B | — | N 通道事件所需的 B 极性（0 = 负，1 = 正） |
| 0 | pol_A | — | N 通道事件所需的 A 极性（0 = 负，1 = 正） |

### X_ENC (0x39)

读写：RW · 位数：32 位 · 范围 -2^31…+(2^31)-1

| 位 | 名称 | 值 | 描述 |
|----|---|----|---|
| 全 32 位 | X_ENC | — | 实际编码器位置（有符号） |

### ENC_CONST (0x3A)

读写：W · 位数：32 位

| 位 | 名称 | 值 | 描述 |
|----|---|----|---|
| 全 32 位 | ENC_CONST | — | 编码器累加常数（有符号）。16 位整数部分，16 位小数部分。X_ENC 累加 +/- ENC_CONST / (2^16 * X_ENC)（二进制）或者 +/- ENC_CONST / (10^4 * X_ENC)（十进制）。ENCMODE 的 enc_sel_decimal 位选择十进制和二进制设置。范围：二进制 ±[µsteps/2^16] ±(0…32767.999847)；十进制 ±(0.0…32767.9999)；reset default = 1.0 (=65536) |

### ENC_STATUS (0x3B)

读写：R+WC · 位数：2 位

| 位 | 名称 | 值 | 描述 |
|----|---|----|---|
| 0 | n_event | 1 | 检测到事件。要清除状态位，请在相应位置写入 1 位。该位与中断输出信号进行或运算 |
| 1 | deviation_warn | 1 | 检测到事件。报警只要存在，则无法清除 Deviation_warn。ENC_DEVIATION 设置为零代表关闭该功能。该位与中断输出信号进行或运算 |

### ENC_LATCH (0x3C)

读写：R · 位数：32 位

| 位 | 名称 | 值 | 描述 |
|----|---|----|---|
| 全 32 位 | ENC_LATCH | — | N 事件时锁存编码器位置 X_ENC |

### ENC_DEVIATION (0x3D)

读写：W · 位数：20 位

| 位 | 名称 | 值 | 描述 |
|----|---|----|---|
| 全 20 位 | ENC_DEVIATION | — | 编码器计数器和 XACTUAL 之间的最大步长偏差，用于产生偏差报警，对应的标志 ENC_STATUS.deviation_warn 有效。0 = 功能关闭 |

---

## 电机驱动寄存器

#### 微步控制寄存器 (0x60…0x6B)

### MSLUT[0] (0x60)

读写：W · 位数：32 位 · 32x 0 or 1，复位缺省 = 正弦表

| 位 | 名称 | 值 | 描述 |
|----|---|----|---|
| 全 32 位 | MSLUT[0] | — | 微步表入口 0…31。根据 MSLUTSEL 的 W 设置，条目 x 和条目 x+1 之间的差值：W = %00: -1；%01: +0；%10: +1；%11: +2 |

### MSLUT[1...7] (0x61…0x67)

读写：W · 位数：7 x 32 位 · 7x 32x 0 or 1，复位缺省 = 正弦表

| 位 | 名称 | 值 | 描述 |
|----|---|----|---|
| 全 7 x 32 位 | MSLUT[1...7] | — | microstep table entries 32…255。W = %00: +0；%01: +1；%10: +2；%11: +3。这是第一个四分之一波的差分编码。CUR_A 和 CUR_B 的起始值存储在 START_SIN 和 START_SIN90 |

### MSLUTSEL (0x68)

读写：W · 位数：32 位 · 该寄存器定义了 MSLUT 正弦波 1/4 周期内的四个段。四个 2 位条目确定了 MSLUT 表中对应段的位宽。0 < X1 < X2 < X3，复位缺省值 = 正弦表

| 位 | 名称 | 值 | 描述 |
|----|---|----|---|
| 31..24 | X3 | — | 第三段查找表起始点。正弦波查找表可以分成四段，每段用单独的 Wx 段起始由 X1、X2 和 X3 选择。控制步长宽度。对于定义的响应，这些值应满足：0<X1<X2<X3 |
| 23..16 | X2 | — | 第二段查找表起始点。对于定义的响应，这些值应满足：0<X1<X2<X3 |
| 15..8 | X1 | — | 第一段查找表起始点 |
| 7..6 | W3 | — | ofs(X3) 到 ofs255 的查找表宽度选择。W0…W3 位宽控制编码：%00: MSLUT entry 0, 1 对应 -1, +0；%01: entry 0, 1 对应 +0, +1；%10: entry 0, 1 对应 +1, +2；%11: entry 0, 1 对应 +2, +3 |
| 5..4 | W2 | — | ofs(X2) 到 ofs(X3-1) 的查找表宽度选择。位宽控制编码同 W3 |
| 3..2 | W1 | — | ofs(X1) 到 ofs(X2-1) 的查找表宽度选择。位宽控制编码同 W3 |
| 1..0 | W0 | — | ofs00 到 ofs(X1-1) 的查找表宽度选择。位宽控制编码同 W3 |

### MSLUTSTART (0x69)

读写：W · 位数：16 位（8 + 8）

| 位 | 名称 | 值 | 描述 |
|----|---|----|---|
| 7..0 | START_SIN | — | 给出了微步表位置 0 的绝对电流。复位缺省值 = 0 |
| 23..16 | START_SIN90 | — | 给出了微步表位置 256 的绝对电流。复位缺省值 = 247 |

> 当参考位置 MSCNT = 0 时，起始值赋给微步寄存器 CUR_A 和 CUR_B。

### MSCNT (0x6A)

读写：R · 位数：10 位 · 范围 0…1023

| 位 | 名称 | 值 | 描述 |
|----|---|----|---|
| 全 10 位 | MSCNT | — | 微步计数器。指示 CUR_A 微步表中的实际位置。CUR_B 的偏移量为 256（两相电机）。提示：先将电机移动到 MSCNT 为零的位置，再重新初始化 MSLUTSTART 或 MSLUT 和 MSLUTSEL |

### MSCURACT (0x6B)

读写：R · 位数：18 位（9 + 9） · 范围 +/-0...255

| 位 | 名称 | 值 | 描述 |
|----|---|----|---|
| 8..0 | CUR_A | — | MSLUT 中电机 A 相的实际微步电流（有符号，未按电流缩放） |
| 24..16 | CUR_B | — | MSLUT 中电机 B 相的实际微步电流（有符号，未按电流缩放） |

#### 驱动寄存器组 (0x6C…0x7F)

### CHOPCONF (0x6C)

读写：RW · 位数：32 位 · 斩波器和驱动配置 · 复位缺省值 = 0x10410150

| 位 | 名称 | 值 | 描述 |
|----|---|----|---|
| 31 | diss2vs | — | 对电源短路保护：0: 对 VS 短路保护使能；1: 禁用对 VS 短路保护 |
| 30 | diss2g | — | 对接地短路保护：0: 对 GND 短路保护使能；1: 禁用对 GND 短路保护 |
| 29 | dedge | — | 双边沿步进 STEP 脉冲：1: 使能每个 STEP 脉冲边缘采样，以降低步进 STEP 信号的频率要求 |
| 28 | intpol | — | 256 微步插值：1: 实际微步分辨率（MRES）被插值至 256 微步，用于最平滑的电机操作（仅适用于步进/DIR 操作） |
| 27..24 | mres[3:0] | — | MRES 细分：%0000: 256 微步，通常将此设置与内部运动控制器一起使用；%0001…%1000: 128, 64, 32, 16, 8, 4, 2, 全步微步分辨率，用于步进/方向模式。分辨率给出了每正弦波四分之一周期的微步条目数。当选择较低的微步分辨率时，驱动器会自动使用产生对称波形的微步位置。步长宽度 = 2^MRES [微步] |
| 23..20 | tpfd[3:0] | — | TPFD 被动快速衰减时间：降低电机的中程共振。被动快速衰减时间设置控制电桥极性变化后插入的快速衰减阶段的持续时间。NCLK = 128 * TPFD |
| 19 | vhighchm | — | 高速斩波模式：当速度大于 VHIGH 时，该位使能芯片切换到 chm = 1 和 fd = 0 工作模式。这样可以获得更高的速度。可以与 vhighfs = 1 相结合。如果设置，则 TOFF 参数在高速操作期间自动加倍，以避免斩波频率加倍 |
| 18 | vhighfs | — | 高速全步选择：当超过 VHIGH 时，该位使能芯片切换到全步。切换仅发生在 45° 位置。全步目标电流使用微步表 45° 位置对应的电流值 |
| 17 | - | — | 保留，0 |
| 16..15 | tbl[1:0] | — | TBL 消影时间选择：%00…%11: 将比较器消影时间设置为 16、24、36 或 54 个时钟。提示：%01 或 %10 建议用于大多数应用 |
| 14 | chm | — | 斩波方式：0: 标准模式（spreadCycle），具有快衰减时间的恒定关闭时间。当达到相反向标称电流时，快速衰减时间也终止。快衰减阶段是在导通阶段之后；1: 恒定关闭时间模式（配合 TFD、disfdcc 位使用） |
| 13 | - | — | 保留，设置 0 |
| 12 | disfdcc | — | 快速衰减模式：chm = 1: disfdcc = 1 代表不采用当前比较器终止快衰减阶段 |
| 11 | fd3 | — | TFD[3]：chm = 1: 快衰减时间 TFD 设置的最高位 |
| 10..7 | hend[3:0] | — | HEND 磁滞低值：chm = 0: %0000…%1111: 磁滞是 -3, -2, -1, 0, 1, …, 12（该设置的 1/512 叠加到当前电流）。磁滞值用于磁滞斩波控制。chm = 1: %0000…%1111: 偏移量为 -3, -2, -1, 0, 1, …, 12。这是正弦波偏移，该值的 1/512 加到每个正弦波条目对应的绝对值上 |
| 6..4 | hstrt[2:0] | — | HSTRT 磁滞起始值：chm = 0: %000…%111: 增加 1, 2, …, 8 到磁滞低值 HEND（该设置的 1/512 叠加到当前电流）。注意：有效 HEND+HSTRT ≤ 16。提示：每 16 个时钟周期磁滞值减少 1。chm = 1: TFD[2..0]: 快衰减时间设置（最高位: fd3） |
| 3..0 | toff[3:0] | — | TOFF 关断时间（慢衰减阶段的持续时间）：NCLK = 24 + 32 * TOFF。%0000: 驱动输出关闭，所有桥臂关断；%0001: 1 - 仅在 TBL≥2 时使用；%0010…%1111: 2…15 |

### COOLCONF (0x6D)

读写：W · 位数：25 位 · CoolStep 智能电流控制寄存器和 StallGuard2 配置

| 位 | 名称 | 值 | 描述 |
|----|---|----|---|
| 24 | sfilt | — | StallGuard2 滤波器使能：0: 标准模式，StallGuard2 的高时间分辨率；1: 滤波模式，StallGuard2 信号每四个全步更新一次（三相电机的六个全步），仅用于补偿电机级与级之间不一致 |
| 23 | - | — | 保留，设置 0 |
| 22..16 | sgt[6:0] | — | StallGuard2 阈值：该值控制堵转输出的 StallGuard2 电平，并设置读出的最佳测量范围。值越低，灵敏度越高。零是大多数电机的启动值。-64 to +63: 较高的值会降低 StallGuard2 的敏感度，并需要更多扭矩来指示堵转 |
| 15 | seimin | — | 智能电流控制的最小电流：0: 1/2 电流设置（IRUN）；1: 1/4 电流设置（IRUN） |
| 14..13 | sedn[1:0] | — | 电流下降速率：%00: StallGuard2 值每增加 32，电流减少 1；%01: StallGuard2 值每增加 8，电流减少 1；%10: StallGuard2 值增加 2，电流减少 1 |
| 12 | - | — | 保留，设置 0 |
| 11..8 | semax[3:0] | — | 智能电流控制的 StallGuard2 磁滞值：如果 StallGuard2 结果等于或高于 (SEMIN + SEMAX + 1) * 32，则电机电流变小以节省能量。%0000…%1111: 0…15 |
| 7 | - | — | 保留，设置 0 |
| 6..5 | seup[1:0] | — | 电流上升步长：每测得的 stallguard 2 参数对应的电流增量步长 %00…%11: 1, 2, 4, 8 |
| 4 | - | — | 保留，设置 0 |
| 3..0 | semin[3:0] | — | 智能电流控制的最小 stallguard 2 值及智能电流使能：如果 stallguard 2 的结果低于 SEMIN * 32，则电机电流会增加以减小电机负载角。%0000: 智能电流控制 CoolStep 关闭；%0001…%1111: 1…15 |

### DCCTRL (0x6E)

读写：W · 位数：24 位 · DcStep (DC) 自动换向配置寄存器（通过引脚 DCEN 或 VDCMIN 使能）

| 位 | 名称 | 值 | 描述 |
|----|---|----|---|
| 9..0 | DC_TIME | — | 换相中 PWM 导通时间的上限（DC_TIME * 1/fCLK）。应略高于有效消影时间 TBL |
| 23..16 | DC_SG | — | DcStep 模式下，DcStep StallGuard2 失步检测的最大 PWM 导通时间（DC_SG * 16/fCLK）。应略高于 DC_TIME/16。0 = 禁用 |

> 提示：高细分或插值运算，DcStep 可产生更好的 stallGuard 信号。如果使能 vhighchm，则 DC_SG 在速度高于 VHIGH 以上也可用。

### DRV_STATUS (0x6F)

读写：R · 位数：32 位 · StallGuard2 值和驱动错误标志

| 位 | 名称 | 值 | 描述 |
|----|---|----|---|
| 全 32 位 | DRV_STATUS | — | StallGuard2 值和驱动错误标志。请参阅数据手册驱动状态寄存器详情 |

### PWMCONF (0x70)

读写：W · 位数：22 位 · 电压 PWM 模式斩波器配置 · 复位缺省值 = 0xC40C001E

| 位 | 名称 | 值 | 描述 |
|----|---|----|---|
| 31..28 | PWM_LIM | — | 当从 spreadCycle 切换回 StealthChop 时，PWM_SCALE_AUTO 的最大限幅。该值定义了切换回时自动电流控制的第 7 位至第 4 位的上限。设置该参数为在模式转换回 StealthChop 时降低电流的过冲。它不限制 PWM_GRAD 或 PWM_GRAD 偏移量（默认值 = 12） |
| 27..24 | PWM_REG | — | 调节回路梯度值：当 pwm_autoscale = 1 时，用户定义的每半波对应的最大 PWM 调节幅度（1…15）：1: 0.5 增量（最慢调节）；2: 1 增量；3: 1.5 增量；4: 2 增量（复位缺省值）…… |
| 23..22 | - | — | 保留，设置 0 |
| 21..20 | freewheel[1:0] | — | 静止选项：当电机电流设置为零（IHOLD = 0）时，静止选项。%00: 正常操作；%01: 空转；%10: LS 驱动器线圈短路；%11: HS 驱动器线圈短路 |
| 19 | pwm_autograd | — | PWM_GRAD 自动调节：0: PWM_GRAD 的固定值（PWM_GRAD_AUTO = PWM_GRAD）；1: 自调节（仅 pwm_autoscale = 1）（复位缺省值）。当 pwm_autograd = 0，PWM_GRAD 初始化 PWM_GRAD_AUTO，并在运动过程中自动优化。前提条件：1. PWM_OFS_AUTO 自动初始化。这需要电机以 IRUN 电流至少 >130 毫秒，以便 a) 检测停止 b) 按照 IRUN 电流等待时间大于 128 个斩波周期 c) 调节 PWM_OFS_AUTO，满足 -1 < PWM_SCALE_AUTO < 1。2. 电机运行和 1.5 * PWM_OFS_AUTO < PWM_SCALE_SUM < 4 * PWM_OFS_AUTO 和 PWM_SCALE_SUM < 255。调节 PWM_GRAD_AUTO 所需的时间每次变化 +/-1 需要 8 个全步时间。支持降低的斩波频率来调节 PWM_OFS_AUTO |
| 18 | pwm_autoscale | — | PWM 自动电流调节：0: 用户定义的前馈 PWM 幅度。当前 IRUN 和 IHOLD 设置对此没有影响！产生的 PWM 振幅（0…255 之间）为：PWM_OFS * ((CS_ACTUAL+1) / 32) + PWM_GRAD * 256 / TSTEP；1: 使能自动电流控制（复位缺省值） |
| 17..16 | pwm_freq[1:0] | — | PWM 频率：%00: f_PWM = 2/1024 f_CLK（复位缺省值）；%10: f_PWM = 2/512 f_CLK；%11: f_PWM = 2/410 f_CLK |
| 15..8 | PWM_GRAD | — | 用户定义的梯度值：用于调节 PWM 幅值的速度相关梯度；PWM_GRAD * 256 / TSTEP 这个值被加到 PWM_AMPL 中，以补偿速度相关的电机反电动势。设置 PWM_GRAD 作为自动缩放的初始值，可加快自调节过程 |
| 7..0 | PWM_OFS | — | 用户定义的幅值（偏移量）：用户定义的 PWM 振幅偏移（0 - 255），与静止状态下的全电机电流（CS_ACTUAL = 31）相关（复位缺省值 = 30）。设置 PWM_OFS 作为自动缩放的初始值，可加快自调节过程。先设置 pwm_autoscale = 0，根据特定应用设置 |

### PWM_SCALE (0x71)

读写：R · 位数：17 位（9 + 8） · 斩波调幅器的结果。这些值可用于监控自动 PWM 幅度调节（255 = 最大值电压）

| 位 | 名称 | 值 | 描述 |
|----|---|----|---|
| 7..0 | PWM_SCALE_SUM | — | 0…255 |
| 24..16 | PWM_SCALE_AUTO | — | 9 位有符号偏移加到计算的 PWM 占空比上。该值是在电流测量的基础上内部自动幅值调节后的结果 |

### PWM_AUTO (0x72)

读写：R · 位数：16 位（8 + 8） · 芯片自动产生，可读回作为 PWM_GRAD 和 PWM_OFS 的默认/上电设置

| 位 | 名称 | 值 | 描述 |
|----|---|----|---|
| 7..0 | PWM_OFS_AUTO | — | 自动标定的偏移值。0…255 |
| 23..16 | PWM_GRAD_AUTO | — | 自动标定梯度值。0…255 |

### LOST_STEPS (0x73)

读写：R · 位数：20 位

| 位 | 名称 | 值 | 描述 |
|----|---|----|---|
| 全 20 位 | LOST_STEPS | — | 当 DC_OUT 为低电平时，步进信号输入没有停止情况下，由于较高的负载导致 DcStep 操作中没有接收到的输入步进数。经过 2^20 步后，这个计数器会自动从 0 开始。根据方向向上或向下计数。仅在 SDMODE = 1 时该寄存器有效 |

## 上电缺省的内部正弦波微步表计算

- i: [0…255]: 表格索引。
- 波形幅值 248，范围为 247 到 -248。
- round 函数取值采用四舍五入，即 0.5 到 1.4999 之间为 1。

（原文中的计算公式未能解码，仅保留此说明性描述。）
