e1aco/ELACO_StepMotorTMC5160/AIFirmware/StepMotorDriver_Keil/learn/pid-control/course-state.md

# PID 控制学习进度

## 课程信息
- 主题: PID 控制入门
- 学习者: ELACO
- 开始时间: 2026-07-23

## 章节进度

| 章节 | 状态 | 掌握度 |
|---|---|---|
| 1. 什么是闭环控制 | ✅ 已完成 | 高 |
| 2. PID 三兄弟 | ✅ 已完成 | 高 |
| 3. PID 输入输出详解 | ✅ 已完成 | 高 |
| 4. TMC5160 应用 | ✅ 已完成 | 高 |

## 概念掌握表

| 概念 | 状态 | 证据 |
|---|---|---|
| 闭环控制 | mastered | 能解释开环/闭环区别 |
| 设定值 SP | mastered | 知道是 XTARGET |
| 过程变量 PV | mastered | 知道是 X_ENC |
| 误差 e | mastered | 知道是 SP - PV |
| P（比例） | mastered | 能解释作用和公式 |
| I（积分） | mastered | 能解释消除稳态误差 |
| D（微分） | mastered | 能解释预测趋势 |

## 笔记文件
- `E:\Desktop\elacoNote\2 笔记内容\PID控制入门.md`
