e1aco/ELACO_StepMotorTMC5160/Firmware/TMC5160H7Cmake_StepMotor/.cl/datasheet/pages/TMC5160A_Datasheet_Rev1.14.ch03.p124.md

# TMC5160A_Datasheet_Rev1.14 — 第3章 · p124

TMC5160/TMC5160A DATASHEET (Rev. 1.14 / 2020-MAY-19)  124 

www.trinamic.com 
Parameter Symbol Conditions Typ Unit 
Typical power dissipation PD StealthChop or SpreadCycle, 40 or 
20kHz chopper, 24V, internal supply 
regulators 
0.6 W 
Thermal resistance junction to 
ambient on a multilayer board 
RTMJA Dual signal and two internal power 
plane board (2s2p) as defined in 
JEDEC EIA JESD51-5 and JESD51-7  
(FR4, 35µm CU, 70mm x 133mm, 
d=1.5mm) 
21 K/W 
Thermal resistance junction to 
board 
RTJB PCB temperature measured within 
1mm distance to the package leads 
8 K/W 
Thermal resistance junction to 
case 
RTJC Junction temperature to heat slug of 
package 
3 K/W 
Table 28.1 Thermal characteristics TQFP48-EP 
The thermal resistance in an actual layout can be tested by checking for the heat up caused by the 
standby power consumption of the chip. When no motor is attached, all power seen on the power 
supply is dissipated within the chip.
