e1aco/ELACO_StepMotorTMC5160/Firmware/TMC5160H7Cmake_StepMotor/.cl/datasheet/pages/TMC5160A_Datasheet_Rev1.14.ch07.p061.md

# TMC5160A_Datasheet_Rev1.14 — 第7章 · p61

TMC5160/TMC5160A DATASHEET (Rev. 1.14 / 2020-MAY-19)  61 

www.trinamic.com 
 
Figure 7.3 Scope shot: good setting for PWM_REG 
 
Figure 7.4 Scope shot: too small setting for PWM_REG during AT#2 
Motor Velocity
Time
Stand still 
PWM scale
PWM reaches max. amplitude
255
0
Motor Current
Nominal Current
(sine wave RMS)
RMS current constant 
(IRUN)
0
PWM scale
Current may drop due 
to high velocity
PWM_GRAD(_AUTO) ok PWM_GRAD(_AUTO) ok
PWM_OFS_(AUTO) ok
(PWM_REG during AT#2 ok)
IHOLD
PWM_OFS_(AUTO) ok
 
Figure 7.5 Successfully determined PWM_GRAD(_AUTO) and PWM_OFS(_AUTO)
