e1aco/ELACO_StepMotorTMC5160/Firmware/TMC5160H7Cmake_StepMotor/.cl/datasheet/pages/TMC5160A_Datasheet_Rev1.14.ch17.p104.md

# TMC5160A_Datasheet_Rev1.14 — 第17章 · p104

TMC5160/TMC5160A DATASHEET (Rev. 1.14 / 2020-MAY-19)  104 

www.trinamic.com 
+IMAX
-IMAX
0
Phase
Current
(one phase 
shown)
STEP
DCEN
DCO
STEP_FILT_INTERN ∆2
INTCOM
∆2 ∆2 ∆2 ∆2 ∆2 ∆2
DC_OUT TIMEOUT
(in controller)
Long pulse = override motor block 
situation
TIMOUT 
counter in 
controller
Theoretical sine 
wave 
corresponding to 
fullstep pattern
Increasing mechanical load forces slower motion
∆2 = MRES (number of microsteps per fullstep)
 
Figure 17.5 DCO Interface to motion controller – step generator stops when DCO is asserted
