e1aco/ELACO_StepMotorTMC5160/Firmware/TMC5160H7Cmake_StepMotor/.cl/datasheet/pages/TMC5160A_Datasheet_Rev1_13_CN.ch00.p001.md

# TMC5160A_Datasheet_Rev1_13_CN — 第0章 · p1

POWER DRIVER FOR STEPPER MOTORS INTEGRATED CIRCUITS
TRINAMIC Motion Control GmbH & Co. KG
Hamburg, Germany
TMC5160 数据手册
特点和优势
驱动高达 20A 线圈电流的两相步进电机(外部 MOSFETs )
支持 SixPoint™的运动控制器
支持 MicroPlyer™微步插值功能的的步进/方向接口
电压范围 8…60V 直流
SPI 和单线 UART
编码器接口和 2 个参考开关输入
256 微步
StealthChop2™斩波模式，安静平滑的运行
电机中速运行的共振衰减
SpreadCycle™ 高动态电机控制斩波器
DcStep™ 负载相关关速度控制
StallGuard2™ 高精度的无传感器负载检测
应用
机器人与工业驱动
纺织、缝纫机
包装
工厂和实验室自动化
高速 3D 打印机
液体处理
医疗
描述
TMC5160 是带串行通信接口的高功率步进
电机控制驱动芯片，将实现自动目标定位
的灵活斜坡发生器和业界最先进的步进电
机驱动器结合在一起。配合外置的功率晶
体管，实现高动态、高扭矩电机驱动。
TRINAMICs 先 进 的 SpreadCycle 和
StealthChop 斩波器，驱动器可绝对无噪音
的运行，并实现最大效率和最佳电机扭矩
控制。高集成度、高能效和小外形尺寸使
系统小型化和性能扩展可行，从而实现经
济高效的解决方案。完整的解决方案在实
现高性能基础上极大缩短学习时间。
两相双极性步进电机的高电压通用控制器/驱动器。stealthChop™控制电机安静运行。外加 MOSFET 实现高达 20A 的
电机线圈电流控制。带步进/方向接口和 SPI。
功能框图
