e1aco/ELACO_StepMotorTMC5160/Firmware/TMC5160H7Cmake_StepMotor/.cl/datasheet/pages/TMC5160A_Datasheet_Rev1_13_CN.ch00.p003.md

# TMC5160A_Datasheet_Rev1_13_CN — 第0章 · p3

TMC5160/ TMC5160A DATASHEET (Rev. 1.13 / 2019-NOV-19) 3
www.trinamic.com
TMC5160A-TA 00-0179 需外加 MOSFET 的步进控制器/驱动器; TQFP48 7 x 7 (主体)
TMC5160A-WA 00-0192 需外加 MOSFET 的步进控制器/驱动器; wett. QFN8x8 8 x 8 
TMC5160A-xx-T …-T -T 代表卷带包装(xx= TA or WA)
TMC5160A-EVAL 40-0138 TMC5160 （/A）评估板 85 x 55
LANDUNGSBRÜCKE 40-0167 TMC 5160 - EVAL 和其它评估板的主控板 85 x 55
ESELSBRÜCKE 40-0098 LANDUNGSBRÜCKE 的连接板. 61 x 38
提示:手册中提到的 TMC5160 为 TMC5160 和 TMC5160A 总称，除非特别标注“A 版本”或“非 A 版本”，A 版本兼
容非 A 版本。
目录
1. 操作原则.....................................................6
1.1 关键概念.................................................8
1.2 控制接口.................................................8
1.3 软件.........................................................9
1.4 运动和控制电机...................................10
1.5 静止态自动降电流...............................10
1.6 STEALTHCHOP 2 & SPREADCYCLE 驱动........ 10
1.7 STALLGUARD2 – 机械负载传感............... 11
1.8 COOLSTEP –负载自适应电流控制..........11
1.9 DCSTEP –负载相关速度控制................. 12
1.10 编码器接口...........................................12
2. 引脚分配...................................................14
2.1 封装外形...............................................14
2.2 信号描述...............................................15
3. 示例电路...................................................20
3.1 标准应用电路.......................................21
3.2 外部栅极电压调节器...........................22
3.3 选择 MOSFET 和斜率........................... 23
3.4 调整 MOSFET 桥臂................................26
3.5 高压应用...............................................31
4. SPI 接口.....................................................32
4.1 SPI 数据报结构.....................................32
4.2 SPI 信号................................................. 34
4.3 时序.......................................................36
5. 寄存器.......................................................37
5.1 通用配置寄存器...................................39
5.2 与速度相关的驱动特性控制寄存器...49
5.3 斜坡发生器寄存器...............................52
5.4 编码器寄存器.......................................62
5.5 电机驱动寄存器...................................65
6. STEALTHCHOP ™....................................... 81
6.1 参数自调整...........................................82
6.2 STEALTHCHOP 选项..................................86
6.3 STEALTHCHOP 电流调节器......................86
6.4 基于速度的定标...................................90
6.5 STEALTHCHOP 和 SPREADCYCLE 两者组合. 92
6.6 STEALTHCHOP 的标志位.......................... 93
6.7 空转和被动制动...................................94
7. SPREADCYCLE 和 经典斩波方式..............97
7.1 SPREADCYCLE 斩波器............................... 98
7.2 经典恒定关断时间斩波器.................102
8. 选择采样电阻.........................................104
