e1aco/ELACO_StepMotorTMC5160/Firmware/TMC5160H7Cmake_StepMotor/.cl/datasheet/pages/TMC5160A_Datasheet_Rev1_13_CN.ch00.p009.md

# TMC5160A_Datasheet_Rev1_13_CN — 第0章 · p9

TMC5160 DATASHEET (Rev. 1.08 / 2018-NOV-19) 9
www.trinamic.com
1.2.1 SPI 接口
SPI 接口是与总线时钟同步的串行位接口。当 SPI 主设备发送数据到从设备时，从设备会同时向
主设备返回数据。SPI 主机和 TMC5160 从之间的通信包括一条 40 位发送命令字和一条 40 位接收状态
字。
每个完整电机运动过程通常是由多条命令构成。
1.2.2 UART 接口
单线接口支持类似RS485 (SWP和SWN )或单线接口(SWN开路 )的差分操作。它可以由任何标准
UART驱动。不需要波特率配置。
1.3 软件
从软件的角度来看，TMC5160 是一个具有多个控制和状态寄存器的外围设备。其中大部分是只读
或者只写的。一些寄存器允许读写访问。如果只写寄存器需要读-修改-写访问，可以在主软件中通过阴
影寄存器实现。
