e1aco/ELACO_StepMotorTMC5160/Firmware/TMC5160H7Cmake_StepMotor/.cl/datasheet/pages/TMC5160A_Datasheet_Rev1_13_CN.ch00.p011.md

# TMC5160A_Datasheet_Rev1_13_CN — 第0章 · p11

TMC5160 DATASHEET (Rev. 1.08 / 2018-NOV-19) 11
www.trinamic.com
慢速运行时能绝对安静。不同于其他电压模式斩波器, StealthChop 2 不需要任何配置。通电后，它会在
第一次运动中自动学习最佳设置，并进一步优化后续运动中的设置。初始的归零过程足以使系统完成
StealthChop 最佳配置。也可以配置初始参数加快自学习过程。StealthChop 2 通过对电机速度的变化立即
做出反应，允许高的电机动态。
对于高动态的应用，spreadCycle是除StealthChop 2之外的选项。它可以通过输入引脚(独立模式)或
SPI或UART接口配置。StealthChop 2和spreadCycle甚至可以结合使用，以达到两者的最佳效果:
StealthChop 2用于无噪音的静止状态，无声平滑的性能，spreadCycle用于高动态，低振动和最高的峰值
速度。
spreadCycle是周期斩波模式。它在很宽的速度和负载范围内提供平稳的操作和良好的共振阻尼。
spreadCycle方案集成快衰减周期并自动调节，以保证平滑过零。
StealthChop 2 优势:
- 显著改善了低成本电机的性能
- 电机运行平稳安静
- 绝对没有待机噪音
- 降低机械共振产生改善的扭矩
1.7 StallGuard2 – 机械负载传感
stallguard 2提供了对电机负载的精确测量。它可以用于堵转检测，也可以用于低于使电机失步的负
载下的其他用途，例如CoolStep负载自适应调节电流。这提供了更多关于驱动器的信息，允许诸如无传
感器归零和驱动器机械诊断之类的功能。
1.8 CoolStep –负载自适应电流控制
CoolStep 控制驱动电机的最佳电流。它根据 StallGuard2 负载测量信息将电机电流调整到实际负载所
需的最小量。节约了能源，降低了芯片的温度。
好处是:
- 能效 能效功耗降低高达 75 %
- 电机产生较少热量 提高了机械精度
- 较少或没有散热 提高了可靠性
