e1aco/ELACO_StepMotorTMC5160/Firmware/TMC5160H7Cmake_StepMotor/.cl/datasheet/pages/TMC5160A_Datasheet_Rev1_13_CN.ch00.p015.md

# TMC5160A_Datasheet_Rev1_13_CN — 第0章 · p15

TMC5160 DATASHEET (Rev. 1.08 / 2018-NOV-19) 15
www.trinamic.com
图 2.2 TMC 5160 - WA 封装和 QFN - WA 引脚( 8 x8mm )
2.2 信号描述
引脚 TQFP QFN 类型 功能
HB1 1 2 高端栅极驱动器输出。
CB1 2 3 自举电容器正极连接。
12VOUT 3 4
内部电压调节器的 11.5V 电压输出,用于栅极驱动器下管的门级
控制。为获得最佳性能，建议接 2.2μF 至 10μF 陶瓷电容器到引
脚附近的地（地平面）。通常建议容值比自举电容的容值至少
大 10 倍。如果功率器件的栅极电压由外部电压供应，将 VSA 和
12VOUT 接到外部电源。
VSA 4 5 11.5V和5V稳压器的模拟电源电压。通常与VS相连，滤波电容
100nf。
5VOUT 5 6
内部 5V 调节器的输出。为获得最佳性能，建议接 2.2μF 至 10μF
陶瓷电容器到引脚附近的地 GNDA。建议 5VOUT 给芯片的 VCC
引脚供电。
GNDA 6 7 模拟地。连接到引脚附近的地平面。
