e1aco/ELACO_StepMotorTMC5160/Firmware/TMC5160H7Cmake_StepMotor/.cl/datasheet/pages/TMC5160A_Datasheet_Rev1_13_CN.ch00.p018.md

# TMC5160A_Datasheet_Rev1_13_CN — 第0章 · p18

TMC5160 DATASHEET (Rev. 1.08 / 2018-NOV-19) 18
www.trinamic.com
引脚 TQFP QFN 类型 功能
VCC 29 30
芯片内 5V 数字电路的电源输入。建议接 100nf 或更大的电容到
就近的地 平面。 应该由 5VOUT 作为 VCC 的输入，建议加 2.2 或
3.3 欧姆电阻作为与 5VOUT 的噪声去耦。如果使用外部电源供
电，请确保 VCC 在 5VOUT 或 VCC _ IO 之前或同时上电！
CPO 31 31 电荷泵电容输出
CPI 32 32 电荷泵电容输入。22nF /100V 电容连接到 CPO。
VS 33 33 电机电源电压。引脚与地平面之间需要滤波电容。必须连到功
率器件 MOSFET 的上桥臂供电电压。
VCP 34 34 电荷泵电压。100nf 电容与 VS 相连。
CA2 35 35 自举电容器正端
HA2 36 36 高端栅极驱动器输出。
BMA2 37 37 桥臂中间节点和自举电容器负端连接
LA2 38 38 低端栅极驱动器输出。
LA1 39 39 低端栅极驱动器输出。
BMA1 40 40 桥臂中间节点和自举电容器负端连接
HA1 41 41 高端栅极驱动器输出。
CA1 42 42 自举电容器正端连接
CB2 43 43 自举电容器正端连接
HB2 44 44 高端栅极驱动器输出。
BMB2 45 45 桥臂中间节点和自举电容器负端连接
LB2 46 46 低端栅极驱动器输出。
LB1 47 47 低端栅极驱动器输出。
BMB1 48 1 桥臂中间节点和自举电容器负端连接
Exposed die
pad - -
将裸露的管芯焊盘连接到地平面。提供尽可能多的通孔以将热
传递到地平面。也用作低端栅极驱动器的地引脚。确保采样电
阻地的环路电感尽量低。
* ( PD )代表有下拉电阻的引脚 。
*所有数字引脚 DI、DIO 和 DO 都使用 VCC _ IO 电平，并内置接地和 VCC _ IO 的保护二极管 。
*所有数字输入 DI 和 DIO 都内置施密特触发器。
