e1aco/ELACO_StepMotorTMC5160/Firmware/TMC5160H7Cmake_StepMotor/.cl/datasheet/pages/TMC5160A_Datasheet_Rev1_13_CN.ch00.p021.md

# TMC5160A_Datasheet_Rev1_13_CN — 第0章 · p21

TMC5160 DATASHEET (Rev. 1.08 / 2018-NOV-19) 21
www.trinamic.com
3.1 标准应用电路
图 3.1 标准电路
标准路使用最少的外部器件。根据所需的电流、电压和封装类型选择八个 MOSFET。两个采样电阻
确定驱动电机线圈的最大电流。请参阅第 8 章选择正确的采样电阻。电源滤波选用低 ESR 电容。为获得
最佳性能，建议功率桥附近的电容根据线圈电流的大小选择至少为 100μF /安培。电容需要吸收斩波器
操作产生的电流纹波。电源电容上的电流纹波也取决于电源内阻和电缆长度。VCC_IO 可以由 5VOUT 或
外部电源(例如 3.3V 调节器)供电。在高 VM 的应用中为了降低内部 5V 和 11.5V 稳压器的线性稳压器功耗，
VSA 应该使用不同(较低)的电源电压(参见第 0 章)。
基本布线提示
将采样电阻和所有滤波电容尽可能靠近功率 MOSFET。 TMC5160 靠近 MOSFET 放置，短线互连，以
最小化寄生电感。将所有的 GND、GNDA、 GNDD 及采样电阻 GND 连成一个公共地。5VOUT 滤波电容直
接连到 5VOUT 和 GNDA 引脚。有关详细信息，请参阅布局提示。推荐使用低 ESR 电解电容对 VS 滤波。
提示：
在安全关键应用中，VS 和功率桥可以由单独的开关电源供电，以实现安全关闭。确保 VS 处的斜率不超
过 1V/ µs。
