e1aco/ELACO_StepMotorTMC5160/Firmware/TMC5160H7Cmake_StepMotor/.cl/datasheet/pages/TMC5160A_Datasheet_Rev1_13_CN.ch00.p022.md

# TMC5160A_Datasheet_Rev1_13_CN — 第0章 · p22

TMC5160 DATASHEET (Rev. 1.08 / 2018-NOV-19) 22
www.trinamic.com
注意：
如果 VSA 由不同的电压源供电，请确保在电机运行期间 VSA 不会跌落。VSA 在 VS 之前关断，需要
关断电机驱动。因为 VSA 上的切换边缘，可能导致桥臂导通。VSA 与 VS 电源由一路供电是最安全的
3.2 外部栅极电压调节器
在 48V 这样的高电源电压下，内部栅极电压调节器和内部 5V 调节器具有相当大的功耗，特别是在
MOSFET 栅极电荷高、斩波器频率高或系统时钟频率大于 12 MHz 的情况下。散热块与系统 PCB 地平面
的良好热传导将有助于散热。自身功耗增加芯片温度，将显著降低温度保护的阈值。为降低功耗，建议
外接 TMC5160 驱动器栅极电压。如图 3.2 所示。在图中，内部栅极电压调节器关闭。为获得最佳效果，
建议使用 12V + / - 1V 的电源。
图 3.2 外部栅极电压源
提示
当 MOSFET 的总栅极电荷超过 50nC、斩波器频率大于 40kHz 或时钟频率大于 12 MHz 时，建议 VSA 电
源不高于 40V 的。
