e1aco/ELACO_StepMotorTMC5160/Firmware/TMC5160H7Cmake_StepMotor/.cl/datasheet/pages/TMC5160A_Datasheet_Rev1_13_CN.ch00.p023.md

# TMC5160A_Datasheet_Rev1_13_CN — 第0章 · p23

TMC5160 DATASHEET (Rev. 1.08 / 2018-NOV-19) 23
www.trinamic.com
3.3 选择 MOSFET 和斜率
功率 MOSFETs 的选择取决于许多因素，如封装尺寸、导通电阻、额定电压和供应商。越大、越低
RDSon 的 MOSFETs 并不一定是越好，因为越大的器件也具有更高的电容，并且可能在栅极驱动电路中的
走线电感增加更多的振铃及功耗。将 MOSFET 调整到所需的电机电压(在峰值电源电压上增加 5 - 10V 的
余量)和所需的最大电流，使得电阻功耗对于所选 MOSFET 封装的热容量仍然很低。TMC5160 以大约 10V
驱动 MOSFET 栅极，因此正常的 10V 就足够了。FETs 逻辑电平( 4.5V 指定的 RDSon )也将工作，但由于 VGS
( th )较低，桥臂开通特性可能更为关键。
栅极驱动电流和 MOSFET 栅极电阻 RG (可选)决定开关行为，且应根据 MOSFET 栅极-漏极电荷(米勒
电荷)调整。图 3.3 显示了米勒电荷对开关事件的影响。图 3.4 还显示了不同负载情况下的切换事件(负载
将输出拉高或拉低)以及所需的死区时间。
下表是设置 MOSFET 驱动器电流( DRVSTRENGTH 设置)和选择栅极电阻的经验法则:
G MOSFET 米勒电荷对应的 DRVSTRENGTH 及 RG
米勒 电荷[nC]
(典型值)
DRVSTRENGTH
设置
RG [Ω]值
<10 0 ≤ 15
10…20 0 or 1 ≤ 10
20…40 1 or 2 ≤ 7.5
40…60 2 or 3 ≤ 5
>60 3 ≤ 2.7
TMC5160 的栅极截止驱动电流，以避免高 dV / dt 引起的桥臂直通。栅极电阻超过表中给出的值时，
保护的效率会降低。因此，对于较大的 RG 值，可能需要并联二极管来确保 MOSFET 在开关事件期间安全
关断。
