e1aco/ELACO_StepMotorTMC5160/Firmware/TMC5160H7Cmake_StepMotor/.cl/datasheet/pages/TMC5160A_Datasheet_Rev1_13_CN.ch00.p024.md

# TMC5160A_Datasheet_Rev1_13_CN — 第0章 · p24

TMC5160 DATASHEET (Rev. 1.08 / 2018-NOV-19) 24
www.trinamic.com
图 3.3 米勒电荷决定开关斜率
提示：
-选择快速、软恢复特性二极管和低反向恢复电荷的 MOSFET。
-小型贴片 MOSFET 封装允许更紧凑的布线，并降低寄生电感效应。
图 3.4 斜坡，米勒平台和消影时间
