e1aco/ELACO_StepMotorTMC5160/Firmware/TMC5160H7Cmake_StepMotor/.cl/datasheet/pages/TMC5160A_Datasheet_Rev1_13_CN.ch00.p026.md

# TMC5160A_Datasheet_Rev1_13_CN — 第0章 · p26

TMC5160 DATASHEET (Rev. 1.08 / 2018-NOV-19) 26
www.trinamic.com
3.4 调整 MOSFET 桥臂
干净的切换事件有利于确保低功耗和良好的 EMC 性能。不合适的布局或器件会危及电路的稳定运
行。因此，了解寄生电感和 MOSFET 反向恢复的影响非常重要。
在接通低端 MOSFET 或高端 MOSFET 之前，只要相对的 MOSFET 处于二极管导通状态，电源布线中
的杂散电感就会引起振铃。当负载电流与接下来的导通桥极性相反时，二极管在死区时间段导通。
MOSFET 体二极管具有一定的反向恢复时间和放电时间。这一时间通常在几十纳秒的范围内。在反向恢
复期间，二极管将引起桥上的高电流流动。该电流来自电源滤波电容(参见图 3.5 粗线 )。一旦二极管导
通，寄生电感就试图保持电流流动。高、快速斜率导致寄生电感振铃(见图 3.6 )。这可能导致桥电压低于
GND 电平。必须确保驱动器 IC 在其 BM 引脚到地没有出现低于-5V 的峰值。直接测量驱动器引脚到驱动
器地的电压。下冲的量取决于从低侧漏极到低侧源极并且经由采样电阻 RS 到地通路中寄生电感的存储
能量。
当电路中是相对较小的 MOSFET 时, 软斜率控制需要串联较高的栅极电阻。这危及安全的 MOSFET 关
断。添加额外的二极管, 以确保 MOSFET 在缓慢切换斜率下的安全关断 (图 3.5 所示的 MOSFET 对管)。
·图 3.7 显示了调整开关斜率和增加 1nF 桥式输出电容器后的电路性能
