e1aco/ELACO_StepMotorTMC5160/Firmware/TMC5160H7Cmake_StepMotor/.cl/datasheet/pages/TMC5160A_Datasheet_Rev1_13_CN.ch00.p028.md

# TMC5160A_Datasheet_Rev1_13_CN — 第0章 · p28

TMC5160 DATASHEET (Rev. 1.08 / 2018-NOV-19) 28
www.trinamic.com
确保可靠操作
- 使用贴片 MOSFET 和短线连接。
- 桥臂和 VS 引脚附近提供足够的滤波电容。
- 调整 MOSFET 开关斜率 (在 MOSFET 栅极上测量开关事件) 比 MOSFET 体二极管反向恢复时间慢。这
将减少交叉导通。
- 靠近 MOSFET 处增加栅极电阻和输出电容, 通过最大限度地减少响铃, 确保开关特性和可靠运行 ，图
3.5 显示了一些的选项。
- 部分 MOSFET 有集成的源级到漏级的快速二极管，可消除反向恢复放电。
图 3.6 输出振铃 (蓝色) 和未加调整的栅极电压（黄色和紫色）
