e1aco/ELACO_StepMotorTMC5160/Firmware/TMC5160H7Cmake_StepMotor/.cl/datasheet/pages/TMC5160A_Datasheet_Rev1_13_CN.ch00.p029.md

# TMC5160A_Datasheet_Rev1_13_CN — 第0章 · p29

TMC5160 DATASHEET (Rev. 1.08 / 2018-NOV-19) 29
www.trinamic.com
图 3.7 增加优化器件后的开关事件 (没有 体二极管/体二极管导通 )
桥臂优化示例
下图为 6A 电机电流步进驱动器的标准原理图， MOSFET 为 AOD4126。
该 MOSFET 具有低栅极电容，在最低驱动器强度设置下斜率时间大约为 50ns。在最低驱动强度设置
下，切换质量最好(图 3.6 )，但显示大量振铃。增加低侧栅极电阻，可增加开关斜率时间， 通过对栅极-
漏极(米勒)电荷放电的影响，高侧体二极管传导后也稍微增加开关斜坡时间。为了对称，增加了高侧栅
极电阻。测试表明，1nF 输出电容可显著降低体二极管导通后电桥的振铃(图 3.7 )。图 3.8 显示了优化后
的实际组件和值。
