e1aco/ELACO_StepMotorTMC5160/Firmware/TMC5160H7Cmake_StepMotor/.cl/datasheet/pages/TMC5160A_Datasheet_Rev1_13_CN.ch00.p030.md

# TMC5160A_Datasheet_Rev1_13_CN — 第0章 · p30

TMC5160 DATASHEET (Rev. 1.08 / 2018-NOV-19) 30
www.trinamic.com
图 3.8 带有调整器件的桥臂示例(请参见示波器截图)
桥臂布线考虑
­ 调整电桥布局，使环路电感最小。布局最好紧凑。
­ MOSFET 栅极连接短而直，避免 BM 和相应的 HS 驱动器引脚之间的环路电感。利用平行走线或相邻
层上的相邻走线使回路电感最小化。较宽的走线也可以降低了电感(不使用最小线径)。
­ 采样电阻到低侧 MOSFET 源极的长度最短，并将 TMC5160 放置在采样电阻的地附近，其地通过过
孔直接连到同一平面。
­ 调整栅极电流设置和栅极电阻优化开关行为。增加 MOSFET 电桥输出电容( 470PF 至几个 NF )减少振
铃。
­ 通过使用示波器探针上 GND 尖端而不是 GND 电缆(如果可用)直接在桥臂或 TMC5160 的 BM 引脚处
探测来测量桥臂的性能
