e1aco/ELACO_StepMotorTMC5160/Firmware/TMC5160H7Cmake_StepMotor/.cl/datasheet/pages/TMC5160A_Datasheet_Rev1_13_CN.ch00.p032.md

# TMC5160A_Datasheet_Rev1_13_CN — 第0章 · p32

TMC5160 DATASHEET (Rev. 1.08 / 2018-NOV-19) 32
www.trinamic.com
4. SPI 接口
4.1 SPI 数据报结构
TMC5160 采用 40 位 SPI (串行外围接口，SPI 是摩托罗拉的商标)数据报与微控制器 MCU 通信。带
硬件 SPI 的微控制器 MCU 通常用 8 比特位的整数倍进行通信。设备的 NCS 信号必须在数据报传输的整
个持续时间内保持有效(低)。
发送到 TMC5160 的每个数据报由一个地址字节和四个数据字节组成。这方便对 TMC5160 的寄存
器组直接进行 32 位数据字通信。每个寄存器有 32 位数据，即使少于 32 位。
为了简化，每个寄存器地址长度为一个字节：
­ 读操作，地址字节的最高有效位是 0。
­ 写操作，地址字节的最高有效位为 1。
大多数寄存器都是只写寄存器，有些可读，还有一些只读。
SPI 数据结构
高位(先传送) 40 位 低位 (后传送)
39 ... ... 0
 8 位地址
 8 位 SPI 状态
  32 位数据
39 ... 32 31 ... 0
 发送到 TMC5160
读写标志+ 7 位地址 8 位数据 8 位数据 8 位数据 8 位数据
