e1aco/ELACO_StepMotorTMC5160/Firmware/TMC5160H7Cmake_StepMotor/.cl/datasheet/pages/TMC5160A_Datasheet_Rev1_13_CN.ch00.p033.md

# TMC5160A_Datasheet_Rev1_13_CN — 第0章 · p33

TMC5160 DATASHEET (Rev. 1.08 / 2018-NOV-19) 33
www.trinamic.com
4.1.1 写/读选择(WRITE_notREAD)
读和写选择由地址字节的最高位( SPI 数据报的第 39 位 )控制。读为 0，写为 1。因此，标号为 W
的位是 WRITE_notREAD 控制位。有效高写入位是地址字节的最高位。因此，0x 80 必须加到地址中才能
进行写操作。SPI 接口总是将数据传送回主机，与 W 位无关。如果前一次访问是读访问，则传输回来的
数据是前一个数据报一起传输的地址对应的读取值。如果前一次访问是写访问，则数据回读为以前接收
的镜像写数据。因此，读访问和写访问之间的区别在于，读访问不将数据传输到寻址寄存器，仅传输地
址，因此它的 32 个数据位是虚拟的，而且，随后的读访问或写访问将发回前一个读周期中传输的地址
对应的数据。
读请求数据报需用空写数据。读取的数据值通过后续的读取或写入访问被传输回主设备。因此，可以以
流水线方式读取多个寄存器。
每当从 TMC 5160 读取数据或向 TMC 5160 写入数据时，返回高位八位包含 SPI 状态，SPI_STATUS，
对应八个选定的状态位。
示例:
读地址 0x21 寄存器( XACTUAL )之前，地址字节必须设置为 0x21。写寄存器( VACTUAL )，地址
字节必须设置为 0x80+0x22 = 0xA2。读操作的数据位可能是任何值( - )。因此，可以将它们设置
为 0。
动作 发送给 TMC5160 的数据 TMC5160 返回的数据
读 XACTUAL  0x2100000000  0xSS & 无用的数据
读 XACTUAL  0x2100000000  0xSS & XACTUAL
写 VMAX:= 0x00ABCDEF  0xA700ABCDEF  0xSS & XACTUAL
写 VMAX:= 0x00123456  0xA700123456  0xSS00ABCDEF
*)S: 表示代表状态位 SPI_STATUS
 TMC5160 返回
8 位 SPI 状态
39 / 38 ... 32 31 ... 24 23 ... 16 15 ... 8 7 ... 0
W 38...32 31...28 27...24 23...20 19...16 15...12 11...8 7...4 3...0
3
9
3
8
3
7
3
6
3
5
3
4
3
3
3
2
3
1
3
0
2
9
2
8
2
7
2
6
2
5
2
4
2
3
2
2
2
1
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
