e1aco/ELACO_StepMotorTMC5160/Firmware/TMC5160H7Cmake_StepMotor/.cl/datasheet/pages/TMC5160A_Datasheet_Rev1_13_CN.ch00.p038.md

# TMC5160A_Datasheet_Rev1_13_CN — 第0章 · p38

TMC5160 DATASHEET (Rev. 1.08 / 2018-NOV-19) 38
www.trinamic.com
R+C 读清零
寄存器概述
寄存器 描述
通用配置寄存器 该寄存器组包含以下寄存器
- 全局配置
- 全局状态标志
- 接口配置
- 输入/输出信号配置
斜坡发生器运动控制寄存器集 该寄存器组包含以下寄存器
- 选择斜坡模式
- 选择速度
- 归零
- 加速和减速
- 目标定位
- 参考开关和 StallGuard2 事件配置
- 斜坡和参考开关状态
与速度相关的驱动特性控制寄存器集 该寄存器组包含以下寄存器
- 驱动器电流控制
- 设置 CoolStep 操作的阈值
- 设置不同斩波模式的阈值
- -设置 dcsep 操作的阈值
编码器寄存器集 ABN 编码器对应的所有寄存器
电机驱动寄存器集 该寄存器组包含以下寄存器
- 设置/读出微步表和计数器
- 斩波器和驱动器配置
- CoolStep 和 StallGuard2 配置
- DcStep 配置
- 读 StallGuard2 参数值及驱动器错误标志
