e1aco/ELACO_StepMotorTMC5160/Firmware/TMC5160H7Cmake_StepMotor/.cl/datasheet/pages/TMC5160A_Datasheet_Rev1_13_CN.ch05.p042.md

# TMC5160A_Datasheet_Rev1_13_CN — 第5章 · p42

TMC5160 DATASHEET (Rev. 1.08 / 2018-NOV-19) 42
www.trinamic.com
通用配置寄存器(0X00…0X0F)
R/W 地址 n 寄存器 描述/ 位 名称
+
4
7..0 SLAVEADDR:
这八位设置 UART 接口的单元地址。当外部地址引脚
NEXTADDR 激活时，地址加 1。
范围: 0 - 253 (不能递增到 254)，默认值= 0
11..8 SENDDELAY:
0, 1: 8 比特位对应的时间长度(多个从设置不能设置
为该值)
2, 3: 3*8 比特位对应的时间长度
4, 5: 5*8 比特位对应的时间长度
6, 7: 7*8 比特位对应的时间长度
8, 9: 9*8 比特位对应的时间长度
10, 11: 11*8 比特位对应的时间长度
12, 13: 13*8 比特位对应的时间长度
14, 15: 15*8 比特位对应的时间长度
R 0x04
8
+
8
IOIN
Bit INPUT
读所有可用输入引脚的状态
0 REFL_STEP
1 REFR_DIR
2 ENCB_DCEN_CFG4
3 ENCA_DCIN_CFG5
4 DRV_ENN
5 ENC_N_DCO_CFG6
6 SD_MODE (1=外部步进和方向输入源)
7 SWCOMP_IN (SWN 和 SWP 的电压差。将 DIAG 输出置于
高电平，禁止推挽以测试比较器。)
31..
24
VERSION: 0x30=芯片版本号
相同的数字意味着数字全兼容性
W 0x04 1 OUTPUT
位 OUTPUT
在 UART 模式下设置输出引脚极性
0 在 UART 模式下，SDO_CFG0 是一个输出。此位设置该引
