e1aco/ELACO_StepMotorTMC5160/Firmware/TMC5160H7Cmake_StepMotor/.cl/datasheet/pages/TMC5160A_Datasheet_Rev1_13_CN.ch05.p044.md

# TMC5160A_Datasheet_Rev1_13_CN — 第5章 · p44

TMC5160 DATASHEET (Rev. 1.08 / 2018-NOV-19) 44
www.trinamic.com
通用配置寄存器(0X00…0X0F)
R/W 地址 n 寄存器 描述/ 位 名称
和采样电阻上的电压跌落。
4 (最高灵敏度)…15 (最低灵敏度)
提示:由于采样电阻上的电压跌落，在正常操作期间设置
成 1 到 3 可能会触发。
(复位缺省值: OTP 6 或 12 )
11..8 S2G_LEVEL:
高端场效应晶体管的对地短路电平，测量高端 MOSFET
上的电压跌落降
2 (最高灵敏度)…15 (最低灵敏度)。
注意:在>52V 操作时不建议设置低于 6 可能会导致错误
检测
(复位缺省值: OTP 6 或 12 )
17..16 SHORTFILTER:
短路检测的尖峰滤波带宽
0 (最低，100ns)、1 ( 1µs)、2 (2µs) 3 ( 3µs)
提示:好的 PCB 布局可配置 0。如果出现错误的短路检测
输出，则增加值。
(复位缺省值= % 01 )
18 shortdelay: 短路检测延迟
0 = 750ns:正常，1 = 1500ns，高。
短路检测延迟应大于桥臂切换时间。0 将适用于大多数
应用程序。
(复位缺省值= 0 )
W 0x0A 22 DRV_CONF Bit DRV_CONF
