e1aco/ELACO_StepMotorTMC5160/Firmware/TMC5160H7Cmake_StepMotor/.cl/datasheet/pages/TMC5160A_Datasheet_Rev1_13_CN.ch05.p056.md

# TMC5160A_Datasheet_Rev1_13_CN — 第5章 · p56

TMC5160 DATASHEET (Rev. 1.08 / 2018-NOV-19) 56
www.trinamic.com
5.3.2.1 SW_MODE –参考开关和 stallguard 2 事件配置寄存器
0X34: SW_MODE –参考开关和 STALLGUARD 2 事件配置寄存器
