e1aco/ELACO_StepMotorTMC5160/Firmware/TMC5160H7Cmake_StepMotor/.cl/datasheet/pages/TMC5160A_Datasheet_Rev1_13_CN.ch05.p067.md

# TMC5160A_Datasheet_Rev1_13_CN — 第5章 · p67

TMC5160 DATASHEET (Rev. 1.08 / 2018-NOV-19) 67
www.trinamic.com
驱动寄存器组(0X6C…0X7F)
R/W 地址 n 寄存器 描述/ 位名称 范围[单位]
RW 0x6C 32 CHOPCONF
斩波器和驱动配置
请另见表格
复位缺省值=
0x10410150
W 0x6D 25 COOLCONF
CoolStep 智能电流控制寄存器
和 stallGuard 2 配置
请另见表格
W 0x6E 24 DCCTRL
DcStep ( DC )自动换向配置寄存器
(通过引脚 DCEN 或 VDCMIN 使能) :
9… 0 位: DC_TIME: 换相中 PWM 导通时间的
上限 (DC_TIME * 1 / fCLK )。应略高
大于有效消影时间 TBL。
23… 16 位: DC_SG: DcStep 模 式 下 ， DcStep
StallGuard2 失步检测的最大 PWM
导通时间 (DC_SG * 16/fCLK)
应略高于 DC_TIME/16
0=禁用
提示:高细分或插值运算，DcStep 可产生更好
的 stallGuard 信号
如果使能 vhighchm，则 DC _ SG 在速度高于高
于 VHIGH 在 VHIGH 以上也可用。为了获得最
佳结果，需设置 vhighchm。
R 0x6F 32 DRV_
STATUS
StallGuard2 值和驱动错误标志
请另见表格！
W 0x70 22 PWMCONF
电压 PWM 模式斩波器配置
请另见表格！
复位缺省值=
0xC40C001E
R 0x71 9+8 PWM_SCALE
斩波调幅器的结果。这些值可用于监控自动
PWM 幅度调节( 255 =最大值电压)。
bit 7… 0 PWM_SCALE_SUM:
实际脉宽调制占空比。该值用于
缩 放 从 正 弦 波 表 中 读 取 的 值
CUR_A 和 CUR_B。
0…255
