e1aco/ELACO_StepMotorTMC5160/Firmware/TMC5160_StepMotor/.cl/datasheet/pages/TMC5160A_Datasheet_Rev1.14.ch03.p019.md

# TMC5160A_Datasheet_Rev1.14 — 第3章 · p19

TMC5160/TMC5160A DATASHEET (Rev. 1.14 / 2020-MAY-19)  
19 

www.trinamic.com 
3.4 Tuning the MOSFET Bridge 
A clean switching event is favorable to ensure low power dissipation and good EMC behavior. 
Unsuitable layout or components endanger stable operation of the circuit. Therefore, it is important to 
understand the effect of parasitic trace inductivity and MOSFET reverse recovery. 
 
Stray inductance in power routing will cause ringing whenever the opposite MOSFET is in diode
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
