e1aco/ELACO_StepMotorTMC5160/AIFirmware/StepMotorDriver_Keil/.ela/sessions/sess-20260723-motor-test.md

# 会话日志: 电机测试

**日期**: 2026-07-23
**会话类型**: 功能验证

---

## 主要内容

- 创建 `TEXT/` 测试目录
- 新增 `ela_tmc5160_test.c/h` 弱化测试文件
- 修改 `elaco_main.c` 集成测试调用
- 更新 Keil 工程配置

## 测试结果

| 项目 | 结果 | 备注 |
|---|---|---|
| 电机2 (芯片2) | ✅ 通过 | 正转/反转正常 |
| 电机1 (芯片1) | ⏭️ 跳过 | 硬件未焊接 |

## 关键修改

1. `ela_tmc5160_test_run()` 中添加 `ela_tmc5160_apply_profile()` 调用
   - 原因: 初始化未设置运动参数组，导致电机无法转动
2. 测试文件命名遵循 `ela_xxx_test.c` 规范

## 下一步

- 电机1 硬件焊接后补测
- 清理测试调用，恢复主循环
