e1aco/ELACO_StepMotorTMC5160/.ela/problem-log.md

# 问题日志

| # | 日期 | 问题 | 状态 |
|---|---|---|---|
| 1 | 2026-07 | FreeModbus 未测试 | 待办 |
| 2 | 2026-07 | PCB散热 / NTC过温保护 | 待办 |
| 3 | 2026-07 | 电机卡死超时机制 | 待办 |
| 4 | 2026-07 | 电机/芯片发热排查 | 已改（2026-07-31 软件降流 ADR-003，待上机验证） |
| 5 | 2026-07 | 相对位置微步运动不转(30微步) | 待办 |
