e1aco/ELACO_StepMotorTMC5160/AIFirmware/StepMotorDriver_Keil/.ela/sessions/sess-20260724-closed-loop-debug.md

# Session: 2026-07-24 闭环调试 + CAN反馈修正

## 主要内容
- 定位TIM7中断缺失导致CAN不回复（stm32f4xx_it.c 缺少 TIM7_IRQHandler）
- 闭环算法修正：目标跑飞问题 → 改为固定命令目标 + 斜坡完成后再纠偏
- CAN反馈从 XACTUAL 改为 X_ENC 编码器实测位置
- TMC5160上电初始化增加50ms延时 + SPI通信验证
- 编码器上电零位归零（软件偏移消除）
- em-skill 本身改动：新增 grill 盘问命令、路径修复、全局约束

## 关键决策
- 闭环只在斜坡完成后介入（XACTUAL == cmd_target），不干扰运行中的斜坡
- 纠偏后更新 s_cmd_target 为新基准
- CAN反馈 byte[0-3] 发 X_ENC 而非 XACTUAL
- SPI初始化失败自动重试一次

## 产出
- stm32f4xx_it.c: 添加 TIM7_IRQHandler
- ela_closed_loop.c: 闭环算法重写
- ela_can_usr.c: 反馈改为 X_ENC
- ela_tmc5160_usr.c: 上电延时 + SPI验证 + 编码器归零
- em-skill: grill命令 + 路径修复 + 全局约束

## 验证结果
- CAN回复正常 ✅
- 闭环空载偏差 < 13 微步 ✅
- 开环/闭环效果一致 ✅
- 编码器上电归零 ✅
