e1aco/ELACO_StepMotorTMC5160/AIFirmware/StepMotorDriver_Keil/.ela/problem-log.md

# Problem Log

| 日期 | 问题 | 状态 | 解决方案 |
|---|---|---|---|
