e1aco/ELACO_StepMotorTMC5160/(list of files, drawings)

Other design files:
Hardhare/StepMotor_2Routes_TMC5160/NBNZY_AD_LIB.PcbLib
Hardhare/StepMotor_2Routes_TMC5160/NBNZY_AD_LIB.SchLib
Hardhare/StepMotor_2Routes_TMC5160/StepMotor_TMC5160.PrjPcb
Hardhare/StepMotor_2Routes_TMC5160/StepTMC5160.PcbDoc
Hardhare/StepMotor_2Routes_TMC5160/StepTMC5160.SchDoc
