e1aco/ELACO_StepMotorTMC5160/Firmware/TMC5160H7Cmake_StepMotor/Core/Src/main.c

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
/* Includes ------------------------------------------------------------------*/
#include "main.h"
#include "fdcan.h"
#include "spi.h"
#include "tim.h"
#include "usart.h"
#include "gpio.h"

/* USER CODE BEGIN Includes */
#include "algo/queue.h"
#include "drv/can.h"
#include "drv/uart_dbg.h"
#include "drv/rtt_dbg.h"
#include "drv/tmc5160.h"
#include "app/motor_ctrl.h"
#include "app/closed_loop.h"
#include "app/comm_test.h"
#include "tim_test.h"
/* USER CODE END Includes */


/* USER CODE BEGIN PV */
/* 闭环节拍标志：预留（目标板无 TIM7，闭环 Tick 暂未启用，与源工程行为等价） */
volatile uint8_t g_cl_tick_flag = 0;
/* USER CODE END PV */

void SystemClock_Config(void);
void PeriphCommonClock_Config(void);
static void MPU_Config(void);
/**
  * @brief  The application entry point.
  * @retval int
  */
int main(void)
{

  /* MPU Configuration--------------------------------------------------------*/
  MPU_Config();

  /* MCU Configuration--------------------------------------------------------*/

  /* Reset of all peripherals, Initializes the Flash interface and the Systick. */
  HAL_Init();

  /* Configure the system clock */
  SystemClock_Config();

  /* Configure the peripherals common clocks */
  PeriphCommonClock_Config();

  /* Initialize all configured peripherals */
  MX_GPIO_Init();
  MX_FDCAN2_Init();
  MX_SPI3_Init();
  MX_TIM4_Init();
  MX_USART1_UART_Init();
  /* USER CODE BEGIN 2 */
  /* TMC5160 外部时钟: TIM4_CH3 PWM 输出 15MHz (TIM4CLK=240MHz/(PSC=0)/(ARR=15+1))
   * 必须在 USR_TMC5160_Init 前启动，否则芯片无 fCLK 不工作 */
  HAL_TIM_PWM_Start(&htim4, TIM_CHANNEL_3);

  QUEUE_Init(&g_queue_st);
  DRV_CAN_Init();
  USR_CAN_Init();
  USR_TMC5160_Init();
  USR_MOTOR_Init();
  USR_CLOSEDLOOP_Init();
  UART_DBG_Init();
  //RTT_DBG_Init(); // RTT初始化
  UART_DBG_Str("UART ready 115200\r\n");
  RTT_DBG_Str("RTT ready\r\n");
  UART_DBG_Str("[BOOT] TMC5160H7 StepMotor\r\n");
  RTT_DBG_Str("[BOOT] TMC5160H7 StepMotor\r\n");
#ifdef CL_TIMING_MEASURE
  TEST_TIM_Init();
  TEST_SPI_SaleaeTriggerInit();
  UART_DBG_Str("[SALEAE] 3-wire SCK PC10 MOSI PC12 MISO PC11 TRIG PA4\r\n");
#endif

  /* == 测试函数 == */
  /* 上电 SPI 自检：双芯 GSTAT/DRVSTATUS 回读，串口+RTT 双通道输出判据 */
  // COMM_Test_SPI();
#if SPI_SOAK
  /* SPI 位保真浸泡诊断（2026-09-10 电机排查轮，实现见 app/comm_test.c；
   * 含 U2 速度模式运转 10s，结束自动停并恢复 ENC_CONST；生产版置 0） */
  COMM_Test_SPI_Soak();
#endif

  /* USER CODE END 2 */

  /* Infinite loop */
  /* USER CODE BEGIN WHILE */
  while (1)
  {
#ifdef CL_TIMING_MEASURE
    /* 3-wire Saleae 连续触发: 每 10ms 一次 U2 GSTAT 读, PA4 窄脉冲作同步 */
    {
        static uint32_t s_saleae_last = 0;
        if ((HAL_GetTick() - s_saleae_last) >= 10)
        {
            s_saleae_last = HAL_GetTick();
            TEST_SPI_SaleaePulse();
            (void)DRV_TMC5160_ReadReg(TMC5160_CHIP_2, 0x01); /* GSTAT */
        }
    }
#endif
    USR_CAN_Process();
    COMM_Test_CAN_Heartbeat();
    /* 双通道心跳遥测：1Hz 打印双电机实际/编码器位置 (USART1 115200 + RTT) */
    {
      static uint32_t s_rtt_last_tick = 0;
      uint32_t now = HAL_GetTick();
      if ((now - s_rtt_last_tick) >= 1000)
      {
        s_rtt_last_tick = now;
        /* U2 追加运动诊断量: v=VACTUAL(0x22) rs=RAMP_STAT cs=CS_ACTUAL[9:0]
         * ds=DRV_STATUS(OL/OT/S2 位) gs=GSTAT —— 遥测先行定位抖动 (retrieval.md) */
        {
          TMC5160_CHIP_T *u2 = USR_MOTOR_GetChip(MOTOR_CTRL_U2);
          uint32_t ds = USR_TMC5160_GetDrvStatus(u2);
          UART_DBG_Printf("[t=%u] U1 act=%d enc=%d | U2 act=%d enc=%d "
                          "v=%d rs=%lX cs=%lu ds=%08lX gs=%02X\r\n",
                          (unsigned)now,
                          (int)USR_MOTOR_GetPosition(MOTOR_CTRL_U1),
                          (int)USR_MOTOR_GetEncoderPosition(MOTOR_CTRL_U1),
                          (int)USR_MOTOR_GetPosition(MOTOR_CTRL_U2),
                          (int)USR_MOTOR_GetEncoderPosition(MOTOR_CTRL_U2),
                          (int)USR_TMC5160_GetVelocity(u2),
                          (unsigned long)USR_TMC5160_GetRampStat(u2),
                          (unsigned long)(ds & 0x3FFUL),
                          (unsigned long)ds,
                          (unsigned int)USR_TMC5160_GetGStat(u2));
        }
        RTT_DBG_Printf("[t=%u] U1 act=%d enc=%d | U2 act=%d enc=%d\r\n",
                       (unsigned)now,
                       (int)USR_MOTOR_GetPosition(MOTOR_CTRL_U1),
                       (int)USR_MOTOR_GetEncoderPosition(MOTOR_CTRL_U1),
                       (int)USR_MOTOR_GetPosition(MOTOR_CTRL_U2),
                       (int)USR_MOTOR_GetEncoderPosition(MOTOR_CTRL_U2));
      }
    }

    /* 闭环控制：目标板无 TIM7 节拍定时器，保持注释态（与源工程行为等价） */
    // if (g_cl_tick_flag)
    // {
    //   g_cl_tick_flag = 0;
    //   USR_CLOSEDLOOP_Tick(MOTOR_CTRL_U1);
    //   USR_CLOSEDLOOP_Tick(MOTOR_CTRL_U2);
    // }

    /* 配置持久化（stub：H750 无可用持久化介质，仅清标志） */
    USR_TMC5160_SaveConfig();
    /* USER CODE END WHILE */

    /* USER CODE BEGIN 3 */
  }
  /* USER CODE END 3 */
}

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
 /* MPU Configuration */

void MPU_Config(void)
{
  MPU_Region_InitTypeDef MPU_InitStruct = {0};

  /* Disables the MPU */
  HAL_MPU_Disable();

  /** Initializes and configures the Region and the memory to be protected
  */
  MPU_InitStruct.Enable = MPU_REGION_ENABLE;
  MPU_InitStruct.Number = MPU_REGION_NUMBER0;
  MPU_InitStruct.BaseAddress = 0x0;
  MPU_InitStruct.Size = MPU_REGION_SIZE_4GB;
  MPU_InitStruct.SubRegionDisable = 0x87;
  MPU_InitStruct.TypeExtField = MPU_TEX_LEVEL0;
  MPU_InitStruct.AccessPermission = MPU_REGION_NO_ACCESS;
  MPU_InitStruct.DisableExec = MPU_INSTRUCTION_ACCESS_DISABLE;
  MPU_InitStruct.IsShareable = MPU_ACCESS_SHAREABLE;
  MPU_InitStruct.IsCacheable = MPU_ACCESS_NOT_CACHEABLE;
  MPU_InitStruct.IsBufferable = MPU_ACCESS_NOT_BUFFERABLE;

  HAL_MPU_ConfigRegion(&MPU_InitStruct);
  /* Enables the MPU */
  HAL_MPU_Enable(MPU_PRIVILEGED_DEFAULT);

}

/**
  * @brief  This function is executed in case of error occurrence.
  * @retval None
  */
void Error_Handler(void)
{
  /* USER CODE BEGIN Error_Handler_Debug */
  /* User can add his own implementation to report the HAL error return state */
  __disable_irq();
  while (1)
  {
  }
  /* USER CODE END Error_Handler_Debug */
}
#ifdef USE_FULL_ASSERT
/**
  * @brief  Reports the name of the source file and the source line number
  *         where the assert_param error has occurred.
  * @param  file: pointer to the source file name
  * @param  line: assert_param error line source number
  * @retval None
  */
void assert_failed(uint8_t *file, uint32_t line)
{
  /* USER CODE BEGIN 6 */
  /* User can add his own implementation to report the file name and line number,
     ex: printf("Wrong parameters value: file %s on line %d\r\n", file, line) */
  /* USER CODE END 6 */
}
#endif /* USE_FULL_ASSERT */
