e1aco/ELACO_StepMotorTMC5160/Firmware/TMC5160H7_StepMotor/TMC5160H7_StepMotor.ioc

Mcu.UserName=STM32H750VBTx
PA10.GPIO_Label=U1_DRV_ENN
PA10.Signal=GPIO_Output
PA11.GPIO_Label=U1_SPI_SCN
PA11.Signal=GPIO_Output
PA4.GPIO_Label=LED_MCU
PA4.Signal=GPIO_Output
PB12.Signal=FDCAN2_RX
PB13.Signal=FDCAN2_TX
PB14.Signal=USART1_TX
PB15.Signal=USART1_RX
PC10.Signal=SPI3_SCK
PC11.Signal=SPI3_MISO
PC12.Signal=SPI3_MOSI
PD14.GPIO_Label=TMC_CLK
PD14.Signal=S_TIM4_CH3
PD3.GPIO_Label=U2_SPI_SCN
PD3.Signal=GPIO_Output
