e1aco/ELACO_StepMotorTMC5160/Firmware/TMC5160_StepMotor/Core/Inc/main.h

#define MCU_LED_Pin GPIO_PIN_1
#define MCU_LED_GPIO_Port GPIOA
#define TEST_LED_Pin GPIO_PIN_2
#define TEST_LED_GPIO_Port GPIOA
#define U2_SPI1_SCN_Pin GPIO_PIN_0
#define U2_SPI1_SCN_GPIO_Port GPIOB
#define U2_DRV_ENN_Pin GPIO_PIN_1
#define U2_DRV_ENN_GPIO_Port GPIOB
#define U2_SWP_DIAG1_Pin GPIO_PIN_11
#define U2_SWP_DIAG1_GPIO_Port GPIOF
#define U2_SWN_DIAG0_Pin GPIO_PIN_12
#define U2_SWN_DIAG0_GPIO_Port GPIOF
#define U2_REFL_DIR_Pin GPIO_PIN_13
#define U2_REFL_DIR_GPIO_Port GPIOF
#define U2_SD_MODE_Pin GPIO_PIN_12
#define U2_SD_MODE_GPIO_Port GPIOB
#define U2_SPI_MODE_Pin GPIO_PIN_13
#define U2_SPI_MODE_GPIO_Port GPIOB
#define SW1_Pin GPIO_PIN_1
#define SW1_GPIO_Port GPIOD
#define U1_SPI_MODE_Pin GPIO_PIN_2
#define U1_SPI_MODE_GPIO_Port GPIOD
#define U1_SD_MODE_Pin GPIO_PIN_3
#define U1_SD_MODE_GPIO_Port GPIOD
#define U1_REFL_DIR_Pin GPIO_PIN_4
#define U1_REFL_DIR_GPIO_Port GPIOD
#define U1_SPI1_SCN_Pin GPIO_PIN_5
#define U1_SPI1_SCN_GPIO_Port GPIOD
#define U1_SWN_DIAG0_Pin GPIO_PIN_11
#define U1_SWN_DIAG0_GPIO_Port GPIOG
#define U1_SWP_DIAG1_Pin GPIO_PIN_12
#define U1_SWP_DIAG1_GPIO_Port GPIOG
#define U1_DRV_ENN_Pin GPIO_PIN_13
#define U1_DRV_ENN_GPIO_Port GPIOG
#define TMC_CLK_Pin GPIO_PIN_6
#define TMC_CLK_GPIO_Port GPIOB
