e1aco/ELACO_StepMotorTMC5160/Firmware/TMC5160_StepMotor/module/drv/eeprom.h

/*****************************************************************************
 * @文件: eeprom.h
 * @作者: cl
 * @日期: 2026-08-05
 * @版本: v2.0
 * @说明: STM32F4 内部 Flash EEPROM 模拟
 * @平台: STM32F407ZETx (512KB Flash)
 ****************************************************************************/
#ifndef EEPROM_H
#define EEPROM_H

#include <stdint.h>

/* STM32F407ZET6 Flash 扇区布局 (512KB):
 * Sector 0: 0x08000000, 16KB
 * Sector 1: 0x08004000, 16KB
 * Sector 2: 0x08008000, 16KB
 * Sector 3: 0x0800C000, 16KB
 * Sector 4: 0x08010000, 64KB
 * Sector 5: 0x08020000, 128KB
 * Sector 6: 0x08040000, 128KB
 * Sector 7: 0x08060000, 128KB
 *
 * 分配方案:
 *   Firmware:   Sectors 0-3   (0x08000000, 64KB)
 *   Config:     Sector 4      (0x08010000, 64KB)
 *   Data:       Sector 5      (0x08020000, 128KB)
 */

/* ==== 类型定义 ==== */
typedef struct {
    uint32_t begin_add;
    uint32_t area_size;
    uint32_t sector_num;
    uint32_t write_addr;
} EEPROM_BLOCK_T;

/* ==== 地址宏 ==== */
#define EEPROM_FIRMWARE_ADDR  (0x08000000)
#define EEPROM_FIRMWARE_SIZE  (0x00010000)
#define EEPROM_CALI_ADDR      (0x08010000)
#define EEPROM_CALI_SIZE      (0x00010000)
#define EEPROM_DATA_ADDR      (0x08020000)
#define EEPROM_DATA_SIZE      (0x00020000)

/* ==== 全局预定义存储块 ==== */
extern EEPROM_BLOCK_T g_eeprom_caliblock_st;
extern EEPROM_BLOCK_T g_eeprom_datablock_st;

/* ==== 接口 ==== */
void    USR_EEPROM_Read(EEPROM_BLOCK_T *block, uint32_t addr,
                        void *data, uint32_t size);
void    USR_EEPROM_Write(uint32_t addr, EEPROM_BLOCK_T *block,
                         void *data, uint32_t size);
uint8_t USR_EEPROM_Valid(EEPROM_BLOCK_T *block);
void    USR_EEPROM_Erase(EEPROM_BLOCK_T *block);

#endif /* EEPROM_H */
