e1aco/ELACO_StepMotorTMC5160/AIFirmware/StepMotorDriver_Keil/ELA_LIB/ela_timer_drv.h

/****
 * @ 文件: ela_timer_drv.h
 * @ 作者: ELACO
 * @ 日期: 2026-07-24
 * @ 版本: 1.0.0
 * @ 说明: 定时器硬件驱动层，HAL 原语
 ********/
#ifndef ELA_TIMER_DRV_H
#define ELA_TIMER_DRV_H

void ela_timer_drv_start_cl(void);
void ela_timer_drv_stop_cl(void);

#endif
