e1aco/ELACO_StepMotorTMC5160/AIFirmware/StepMotorDriver_Keil/TEXT/ela_eeprom_test.h

/****
 * @ 文件: ela_eeprom_test.h
 * @ 作者: ELACO
 * @ 日期: 2026-07-31
 * @ 版本: 1.0.0
 * @ 说明: EEPROM 自检函数头文件
 ********/
#ifndef ELA_EEPROM_TEST_H
#define ELA_EEPROM_TEST_H

void ela_eeprom_test_run(void);

#endif
