e1aco/ELACO_StepMotorTMC5160/AIFirmware/StepMotorDriver_Keil/TEXT/ela_tmc5160_test.h

/****
 * @ 文件: ela_tmc5160_test.h
 * @ 作者: ELACO
 * @ 日期: 2026-07-23
 * @ 版本: 1.0.0
 * @ 说明: 电机测试函数头文件
 ********/
#ifndef ELA_TMC5160_TEST_H
#define ELA_TMC5160_TEST_H

void ela_tmc5160_test_run(void);

#endif
