e1aco/ELACO_StepMotorTMC5160/(commit log)

2026-07-07 提交最新的项目内容，开始git
    [NBNZY_AD_LIB.PcbLib, NBNZY_AD_LIB.SchLib, StepMotor_TMC5160.PrjPcb, StepMotor_TMC5160.xlsx, StepTMC5160.SchDoc, TMC5160_Calculations.xlsx]
2026-07-08 查看tmc5160example相关内容，熟悉tmc5160的驱动流程
    [NBNZY_AD_LIB.PcbLib, NBNZY_AD_LIB.SchLib, StepMotor_TMC5160.PrjPcb, StepMotor_TMC5160.xlsx, StepTMC5160.SchDoc, TMC5160_Calculations.xlsx]
2026-07-09 电机可以运行了，但是好像还有点小问题
    [StepMotor_TMC5160.xlsx]
2026-07-10 增加对于步进电机电路设计的一些内容（readme）
2026-07-13 7.11-尝试添加编码器后进行闭环控制，但是电机实际旋转角度和编码器显示角度偏差较大
2026-07-13 7.13-添加步进电机闭环转动一圈测试代码
2026-07-15 添加can
2026-07-15 7.15-提交加入CAN协议前的代码，作为备份
2026-07-16 提交CAN协议
2026-07-16 调试实现步进电机绝对运动和相对运动
2026-07-18 提交对于电流的修改
2026-07-18 提交readme
2026-07-20 7.20-准备添加PID
2026-07-20 增加10kHZ的tim9作为PID调试使用
2026-07-23 使用AI重构项目
2026-07-23 实现开环转动，编码器值精度在256内
2026-07-24 闭环电机控制框架完成
2026-07-24 Cubemx生成错误导致上一版本的定时器7卡死，解决卡死问题，这个才是真正的闭环框架
2026-07-28 添加gitnexus
2026-07-31 芯片温升问题解决前
2026-08-11 固件代码入库: submodule 展开为普通目录(351文件) + CAN报警源解码/串行化修复/温升优化
    [StepMotorDriver_Keil.ioc, can.c, can.h, can_drv.c, can_drv.h, can_usr.c, can_usr.h, closed_loop.c]
2026-08-13 cl: 确认 U1 停转根因=地线隔离电阻致 TMC5160 复位 (验收通过)
2026-08-14 cl: 根除停止锁轴=热致S2短路比较器假触发 (byte6加S2/失步位+OTPW出故障掩码+TBL54clk+IRUN 4A→3A) (验收通过)
2026-08-15 cl: 暴力测试验收通过 (U2 vel20000持续+U1 ±51200方向切换 50轮+130轮自验，0次锁轴/真丢步；恢复main.c遥测+新增单进程soak测试工具) (验收通过)
2026-08-25 cl: CAN调试遥测迁移到J-Link RTT (SEGGER_RTT库+drv/rtt_dbg封装+1Hz心跳遥测; CAN命令协议保留) (验收通过)
2026-08-26 移植F407相关内容
    [NBNZY_AD_LIB.PcbLib, NBNZY_AD_LIB.SchLib, StepMotor_TMC5160.PrjPcb, StepTMC5160.PcbDoc, StepTMC5160.SchDoc]
2026-09-09 cl: SPI通讯闭环入库(5V硬件修复后验证; 判据修正IHOLD_IRUN只写ch05.p038/tCSH帧间隔ch04§4.3/U%u标签; 6.45Mbps复测+时序表回填实测; CubeMX再生成漂移还原fdcan MsgRAM/spi NSSP/引脚速度/usart printf重定向; drv文件合并can+tmc5160(去_usr); module/test/SEGGER_RT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
    [TMC5160H7_StepMotor.ioc, can.c, can.h, closed_loop.c, closed_loop.h, comm_test.c, comm_test.h]
2026-09-10 cl: SOAK浸泡洗清SPI6.45M与时钟(22.4万帧0翻转,fCLK=15.00MHz软件钉死)+B相判定实验链(r6活性门/r7驱动阶梯12格全报s2gb→收敛B桥不导通类,候选12VOUT轨塌陷/自举/焊桥)+电流参数IHOLD6/IRUN20+生产版SPI_SOAK=0+datasheet补p056位表+memory/log沉淀 (验收: SPI时序核查/S2判定/阶梯扫描/保持电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
