e1aco/ELACO_StepMotorTMC5160/(notices)

Notices in the files:
Firmware/TMC5160_StepMotor/Core/Inc/main.h:
Copyright (c) 2026 STMicroelectronics.
All rights reserved.
This software is licensed under terms that can be found in the LICENSE file
